rusefi/rusefi-hardware/GDI-6ch/readme.md

⚠️ 🚨While firmware folder exists for this GDI6 board, it's unclear if anyone has ever tested it in in any way, shape, or form⚠️ 🚨

https://rusefi.com/forum/viewtopic.php?f=4&t=1337
