rusefi/rusefi-hardware/digital-inputs/readme.md

Report results are posted into USB Serial, also green/red LED once test cycle is complete.

[⏩ Interactive Pinout ⏪](https://rusefi.com/docs/pinouts/stim/)

See https://github.com/rusefi/stim for hardware

Uses STM32 Nucleo-F429ZI https://os.mbed.com/platforms/ST-Nucleo-F429ZI/

Note to apply JP3 into Vin position see https://github.com/rusefi/stim/issues/12



[CD4067BM96 16:1 single-ended, 1-channel analog multiplexer](http://www.ti.com/lit/ds/symlink/cd4097b.pdf)
