rusefi/rusefi-hardware/BMW-N54-146/readme.md

# N54

E9x 2006 to 2010 with "35" engine would be N54

For some years they had both N54 and N55 depending on trim. 335is would be N54, N55 would be newer engine with 204 pin ECU

https://rusefi.com/docs/pinouts/BMW-N54-146/

https://github.com/rusefi/rusefi_documentation/blob/master/OEM-Docs/Bmw/2010%20BMW%20335i%20Coupe%20(E92)%20N54.pdf



# offtopic

https://github.com/rusefi/rusefi_documentation/blob/master/OEM-Docs/Bmw/2009%20BMW%20328i%20Sedan%20(E90)%203.0%20N51.pdf

https://github.com/rusefi/rusefi_documentation/blob/master/OEM-Docs/Bmw/2009%20BMW%20335i%20Sedan%20(E90)%203.0%20N53.pdf
