rusefi/rusefi-hardware/GDI-STM/readme.md

GDI based on stm32g4

🔴 zero firmware exists for this hardware 🔴

https://github.com/rusefi/rusefi-hardware/issues/306

https://github.com/rusefi/rusefi-hardware/issues/307

https://rusefi.com/forum/viewtopic.php?f=4&t=1337
