rusefi/rusefi-hardware/ZF8HP Transmission/README.MD

# ZF 8HP Installation Board

This repository contains KiCad design files, schematics, and Gerbers for a **ZF8HP installation board**, a drop-in replacement that **solders into the transmission in place of the stock TCU (Transmission Control Unit)**.

### ✅ Supported ZF 8HP Models:
- **8HP45**
- **8HP50**
- **8HP51**
- **8HP70**
- **8HP75**
- **8HP90**
- **8HP95**

These models share similar architecture and connector layouts for the internal mechatronics, making the board compatible across multiple 8HP generations.

---

### 🚗 OEM Manufacturers Using ZF 8HP Transmissions
The ZF 8-speed automatic transmission (8HP series) is widely used across the automotive industry. Below is a list of OEMs and vehicles that utilize ZF 8HP variants:

#### **BMW**
- 1 Series, 2 Series, 3 Series, 4 Series, 5 Series, 6 Series, 7 Series
- X1, X3, X4, X5, X6, X7
- M Performance models (e.g., M340i, X5 M50i)

#### **Audi / Volkswagen Group**
- Audi A4, A5, A6, A7, A8, Q5, Q7, Q8, SQ5, S6, S8
- VW Touareg
- Porsche Cayenne, Macan, Panamera (certain trims)

#### **Chrysler / Dodge / Jeep / RAM**
- Chrysler 300
- Dodge Charger, Challenger, Durango
- Jeep Grand Cherokee, Wagoneer
- RAM 1500, 2500 (with HEMI or EcoDiesel)

#### **Alfa Romeo**
- Giulia
- Stelvio

#### **Maserati**
- Ghibli
- Quattroporte
- Levante

#### **Jaguar / Land Rover**
- Jaguar XE, XF, XJ, F-Type, F-Pace
- Range Rover, Range Rover Sport, Discovery, Defender

#### **Rolls-Royce**
- Ghost, Wraith, Cullinan

#### **Aston Martin**
- DB11, Vantage (post-2018 models)

---

### 🧐 Notes
- While all 8HPs share ZF architecture, not all use identical internal TCU layouts or mounting methods. Minor variations may exist in the mechatronic design.
- This board was developed with modularity in mind and can be adapted for different generations as needed.
- Contributions are welcome to expand compatibility and improve hardware design.
