rusefi/rusefi-hardware/mini48-stm32/readme.md

Brain board stm lqfp48 pin

* TC2030
* CANbus

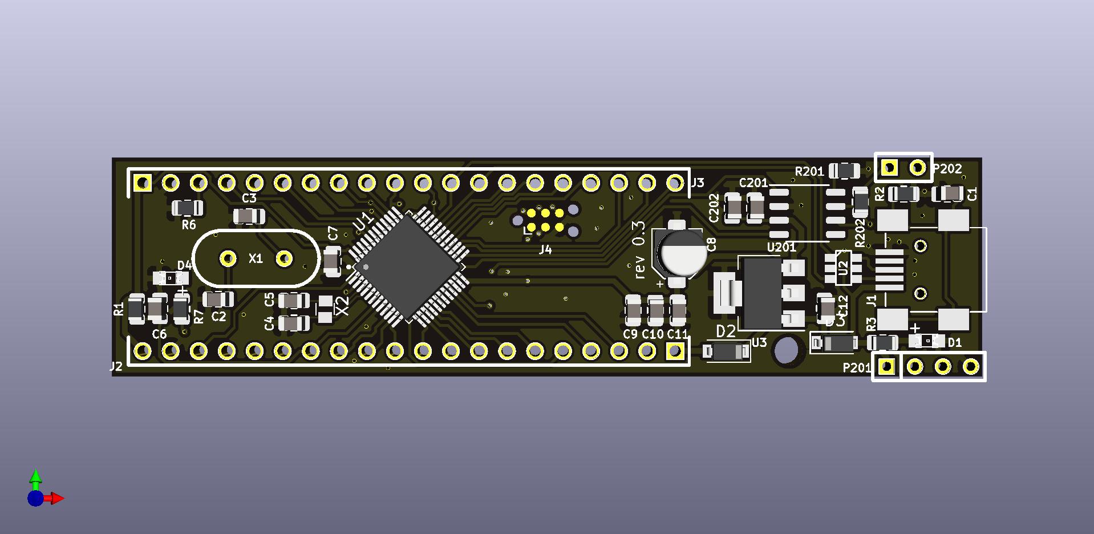
[picture p1: mini48-stm32/images/mini48-stm32-0.3-top.jpg]
Board
