rusefi/rusefi-hardware/MC33810-breakout/readme.md

https://www.nxp.com/products/power-management/smart-switches-and-drivers/low-side-switches/automotive-engine-control-ic:MC33810

https://github.com/andreika-git/hellen-one/issues/173
