rusefi/rusefi-hardware/VR-Hall/readme.md

VR/Hall mixing test board

Problem statement: do do not have x8 or x10 position sensor inputs on stm32, in order to handle any combination of x5 hall and x3/x5 VRs we would need to mix each VR with Hall

We are looking to confirm that VR signal (in this case from MAX9924) could be mixed with Hall signal into same/shared digital signal
