rusefi/rusefi-hardware/superseal-igbt/readme.md

x4 coil driver

For instance ISL9V3040S3S

See also https://github.com/rusefi/rusefi/tree/master/hardware/DDPAK_breakout

https://www.youtube.com/watch?v=TUJzp6ig_bQ
