rusefi/rusefi-hardware/classic-designs/frankenso-PWR-Supply/readme.md

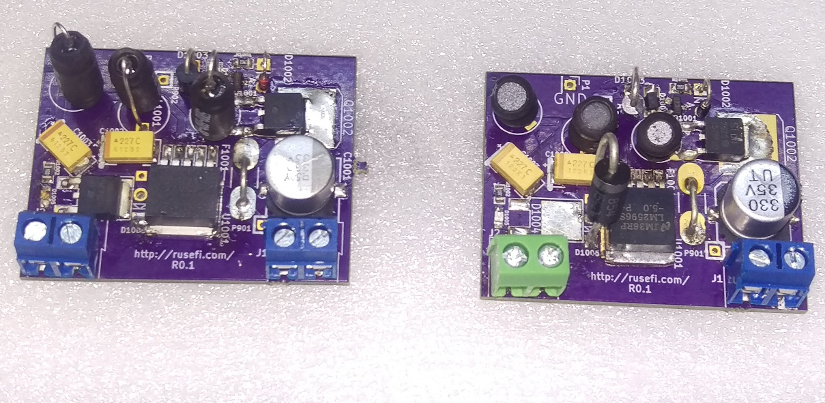
[picture p2: classic-designs/frankenso-PWR-Supply/board.jpg]
Board


https://rusefi.com/forum/viewtopic.php?f=4&t=394
