rusefi/rusefi-hardware/classic-designs/frankenso/readme.md

Our best ECU board

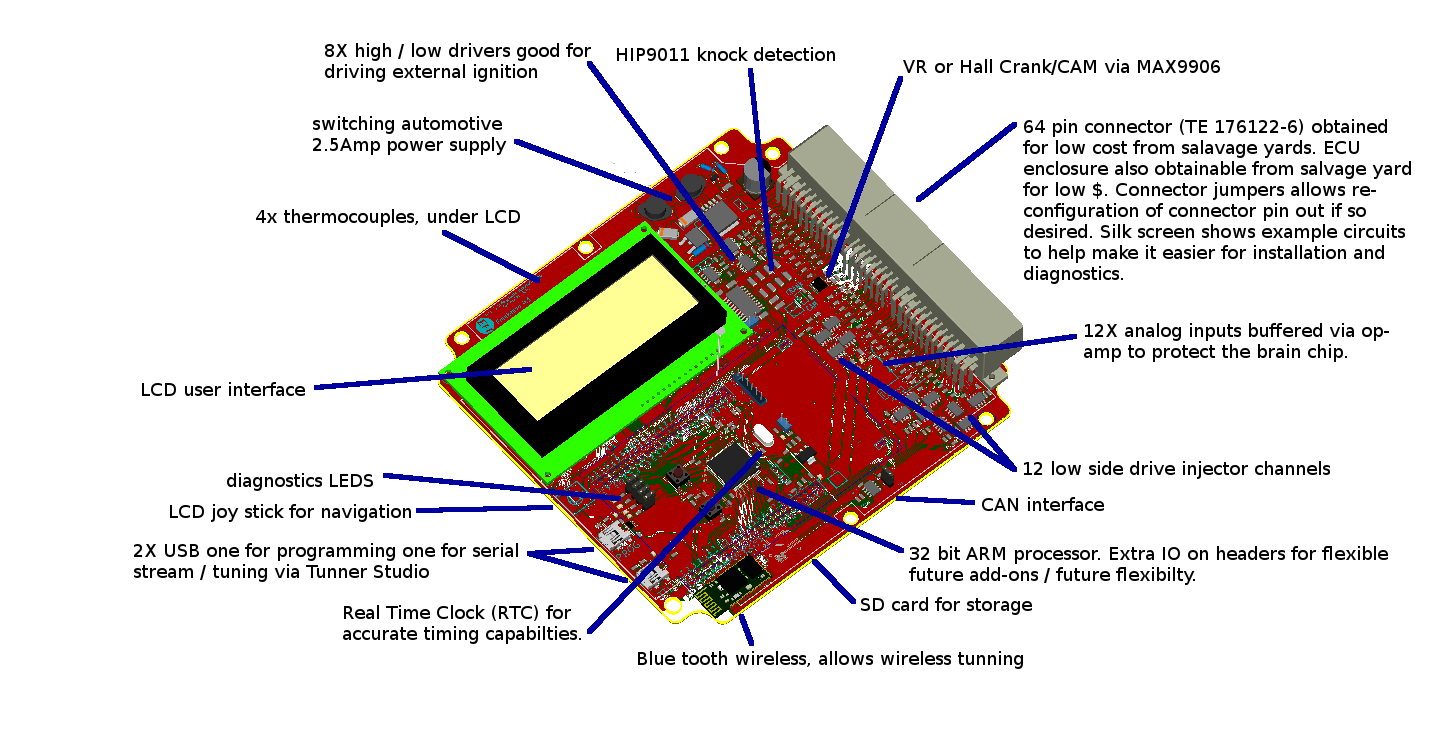
[picture p3: classic-designs/frankenso/frankenso_top-isometric_notes.png]
Isometric Notes


[Wiki manual page](https://rusefi.com/wiki/index.php?title=Manual:Hardware_Frankenso_board)

[Forum thread](https://rusefi.com/forum/viewtopic.php?f=4&t=569)

### For Release Notes see [known_issues.txt](known_issues.txt)

See also comparison [Board Comparison](https://rusefi.com/wiki/index.php?title=Hardware:For_Sale)

iBoms are very cool see https://rusefi.com/docs/ibom/frankenso_latest.html
