rusefi/rusefi-hardware/classic-designs/frankenstein/readme.md

This is the older rusEfi board which is not really being developed any more.

See [Frankenso](../frankenso) for the next generation of official rusEfi hardware

See also comparison [Board Comparison](https://rusefi.com/wiki/index.php?title=Hardware:For_Sale)

iBoms are very cool see https://rusefi.com/docs/ibom/frankenstein_latest.html
