rusefi/rusefi-hardware/classic-designs/power_supply_kb1gtt/readme.md

Older version of the power supply with SMD inductors

For current version with three inductors see [frankenso-PWR-Supply](../frankenso-PWR-Supply)

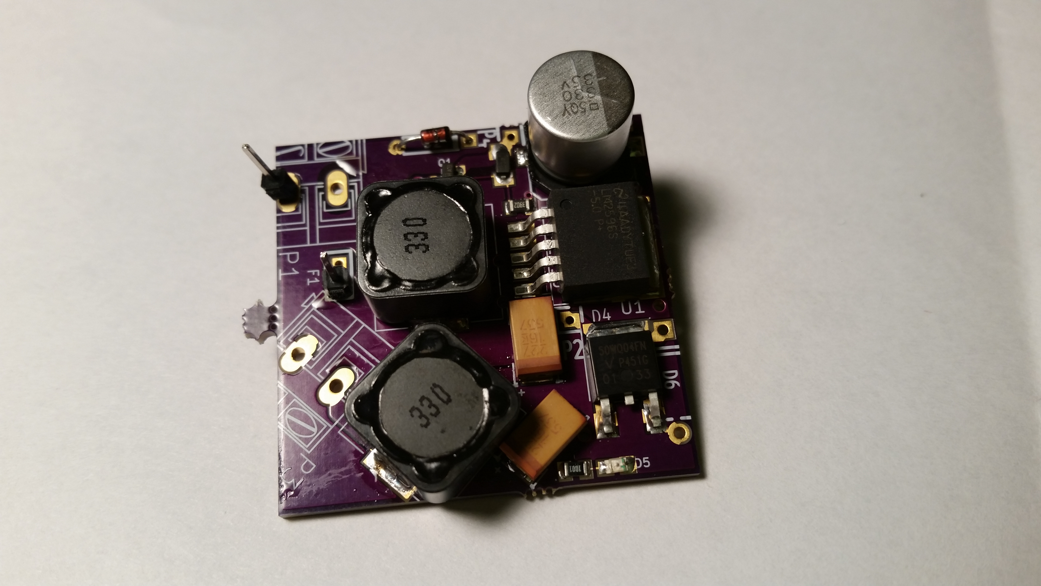
[picture p4: classic-designs/power_supply_kb1gtt/power_supply_0_4_front.jpg]
Front

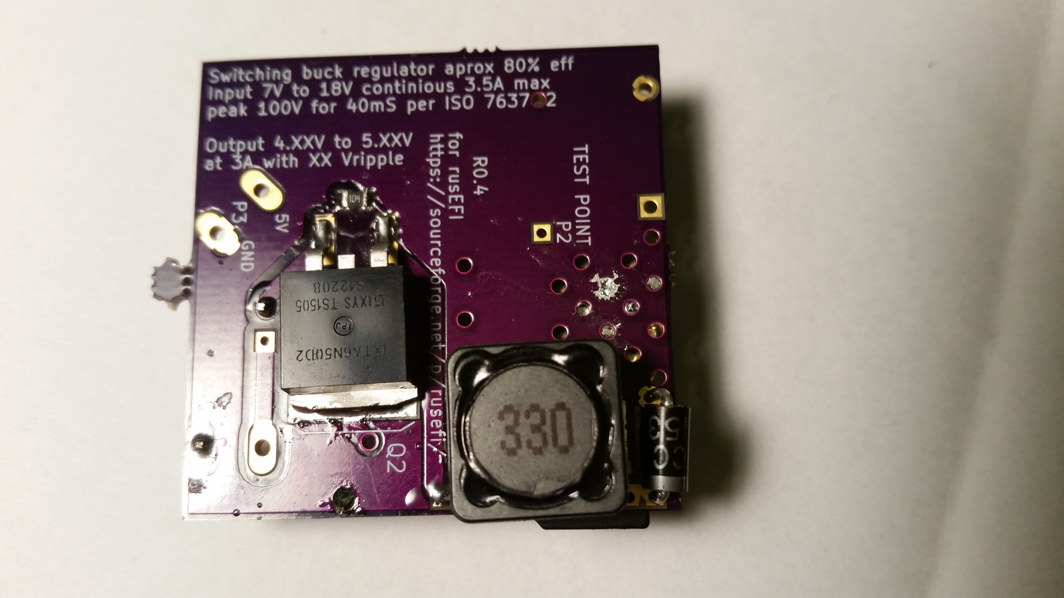
[picture p5: classic-designs/power_supply_kb1gtt/power_supply_0_4_back.jpg]
Back


https://rusefi.com/forum/viewtopic.php?f=4&t=394
