rusefi/rusefi-hardware/GDI-4ch/firmware/readme.md

baud rate 115200

# Changelog

See EFI_BOARD_E92 for alternative LED pinout

2024: GDI air bots are pretty happy!

2022-04-08: we have nothing so far. Nada.
