rusefi/rusefi-hardware/breakout-boards/Breakout_154pin_284617-1-Connector/readme.md

154 pin Audi Volkswagen ECU connector

# [Connector for sale here](https://www.tindie.com/products/russian/154-pin-ecu-connector/)

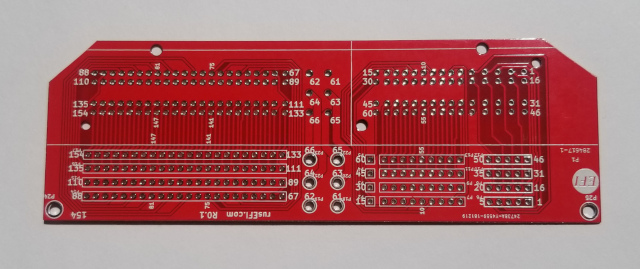
[picture p6: breakout-boards/Breakout_154pin_284617-1-Connector/154p_board.jpg]
x


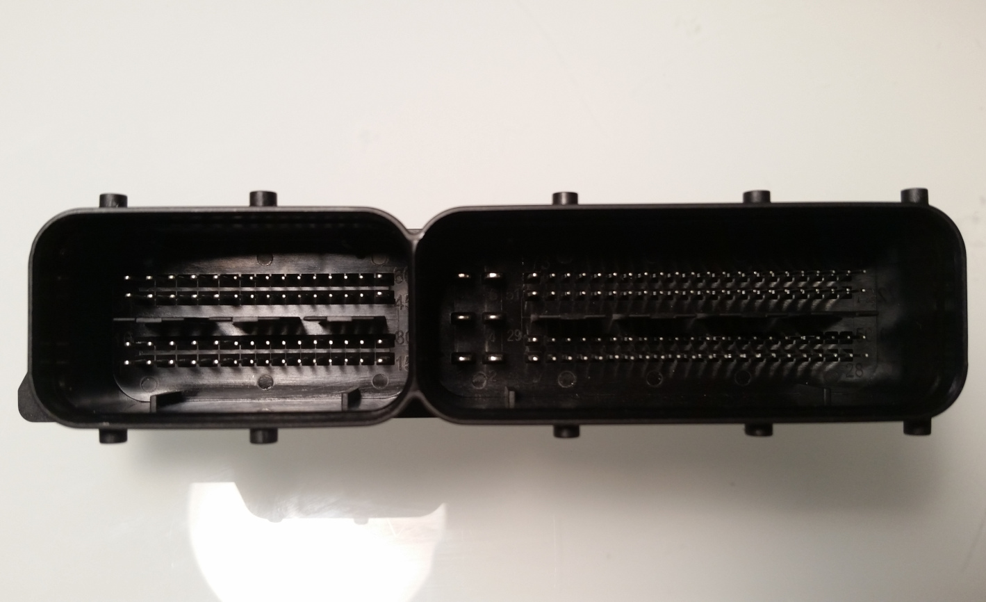
[picture p7: breakout-boards/Breakout_154pin_284617-1-Connector/154p_front.jpg]
Connector


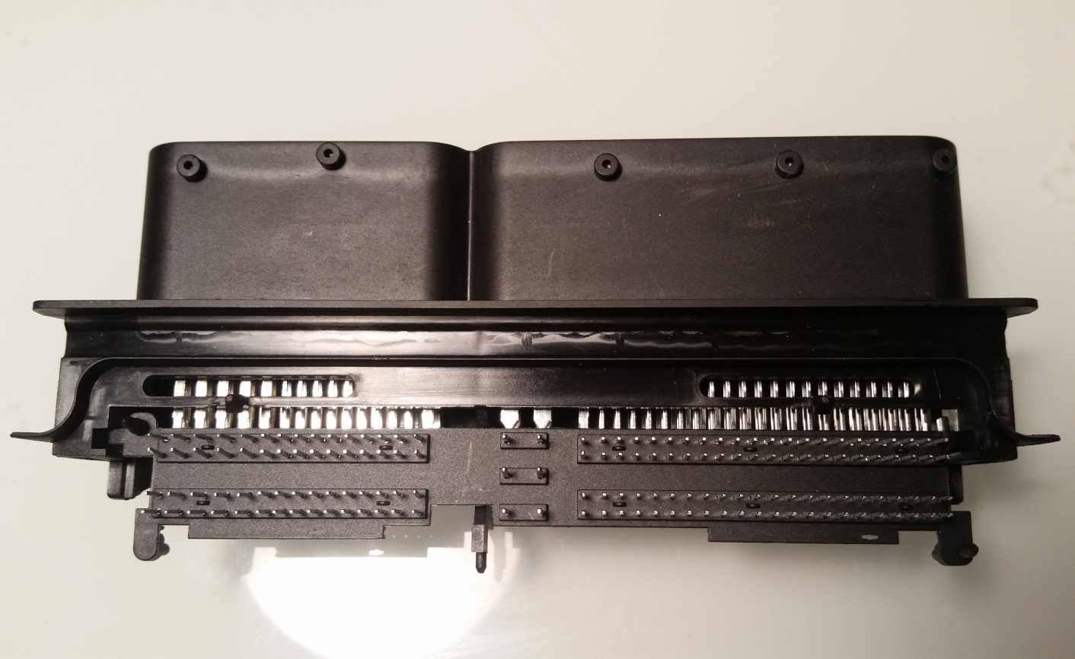
[picture p8: breakout-boards/Breakout_154pin_284617-1-Connector/154p_bottom.jpg]
Connector


https://rusefi.com/forum/viewtopic.php?f=4&t=582
