rusefi/rusefi-hardware/lambda-x2/export/rev1/readme.md

4 layers
82 x 95 mm

x
