rusefi/rusefi-hardware/BMW-N54-146/proteus-N54-notes.md

TPS 2 → analog volt 2

MAC lowside → injector 12

Start button → digital 4

Exhaust vanos → injector 8

Intake vanos → injector 7

TPS 1 → analog volt 3

PPS 1 → analog volt 9

PPS 2 → analog volt 7

MAP → analog volt 1

IAT → analog temp 2

Exhaust cam → digital 3

Intake cam → digital 2

Crank → digital 1

Fuel pressure (pin 15) → analog volt 5

O2 → analog volt 6

Coolant temperature → analog thermistor 3

Starter signal → injector 10

Fan → injector 11 / fan

Alternator → ign 7

Main relay → injector 9

VSS input over CAN (with E46 ABS or E9X ABS MK60E5)

Kawasaki Ninja ZX10R gyro MM5.10 → CAN

Antilag button → analog volt 10

Brake input GND → digital 5

Launch control button → analog volt 11

Oil pressure → analog volt 8 (5 V)

FLEX → currently analog volt 4, needs to go to digital 6

Ambient air temp → analog temp 4

Remove current knock sensor and wire both stock BMW ones to knock 1 and knock 2

Oil temp sensor → analog temp 1
