rusefi/rusefi-hardware/honda-obd1/connectors/honda-obd1-64pin-176122-6-backup.txt

info:
  title: Honda OBD1
  directory: uaefi/honda-obd1
  image:
    file: 64pin-176122-6.jpg
  pins:
    - pin: D21
      x: 3984
      y: 312
    - pin: D22
      x: 3984
      y: 512

    - pin: D19
      x: 3860
      y: 312
    - pin: D20
      x: 3860
      y: 512

    - pin: D17
      x: 3735
      y: 352
    - pin: D18
      x: 3735
      y: 544

    - pin: D15
      x: 3624
      y: 352
    - pin: D16
      x: 3624
      y: 544

    - pin: D13
      x: 3508
      y: 352
    - pin: D14
      x: 3508
      y: 544

    - pin: D11
      x: 3401
      y: 352
    - pin: D12
      x: 3401
      y: 544

    - pin: D9
      x: 3284
      y: 352
    - pin: D10
      x: 3284
      y: 544

    - pin: D7
      x: 3179
      y: 352
    - pin: D8
      x: 3179
      y: 544

    - pin: D5
      x: 3062
      y: 352
    - pin: D6
      x: 3062
      y: 544

    - pin: D3
      x: 2952
      y: 352
    - pin: D4
      x: 2952
      y: 544

    - pin: D1
      x: 2838
      y: 312
    - pin: D2
      x: 2838
      y: 512

    - pin: B15
      x: 2616
      y: 352

    - pin: B16
      x: 2616
      y: 544

    - pin: B13
      x: 2506
      y: 352

    - pin: B14
      x: 2506
      y: 544

    - pin: B11
      x: 2396
      y: 352

    - pin: B12
      x: 2396
      y: 544

    - pin: B9
      x: 2286
      y: 352

    - pin: B10
      x: 2286
      y: 544

    - pin: B7
      x: 2176
      y: 352

    - pin: B8
      x: 2176
      y: 544

    - pin: B5
      x: 2066
      y: 352

    - pin: B6
      x: 2066
      y: 544

    - pin: B3
      x: 1956
      y: 352

    - pin: B4
      x: 1956
      y: 544

    - pin: B1
      x: 1846
      y: 352

    - pin: B2
      x: 1846
      y: 544

    - pin: A25
      x: 1604
      y: 312
    - pin: A26
      x: 1604
      y: 512

    - pin: A23
      x: 1488
      y: 312
    - pin: A24
      x: 1488
      y: 512

    - pin: A21
      x: 1368
      y: 360
    - pin: A22
      x: 1368
      y: 552

    - pin: A19
      x: 1256
      y: 360
    - pin: A20
      x: 1256
      y: 552

    - pin: A17
      x: 1140
      y: 360
    - pin: A18
      x: 1140
      y: 552

    - pin: A15
      x: 1028
      y: 360
    - pin: A16
      x: 1028
      y: 552

    - pin: A13
      x: 915
      y: 360
    - pin: A14
      x: 915
      y: 552

    - pin: A11
      x: 807
      y: 360
    - pin: A12
      x: 807
      y: 552

    - pin: A9
      x: 690
      y: 360
    - pin: A10
      x: 690
      y: 552

    - pin: A7
      x: 580
      y: 360
    - pin: A8
      x: 580
      y: 552

    - pin: A5
      x: 460
      y: 312
    - pin: A6
      x: 460
      y: 512

    - pin: A3
      x: 330
      y: 312
    - pin: A4
      x: 330
      y: 512

    - pin: A1
      x: 200
      y: 312
    - pin: A2
      x: 200
      y: 512
