rusefi/rusefi-hardware/classic-designs/5V-regulator/index.html

forum thread (http://rusefi.com/forum/viewtopic.php?f=4&t=893)
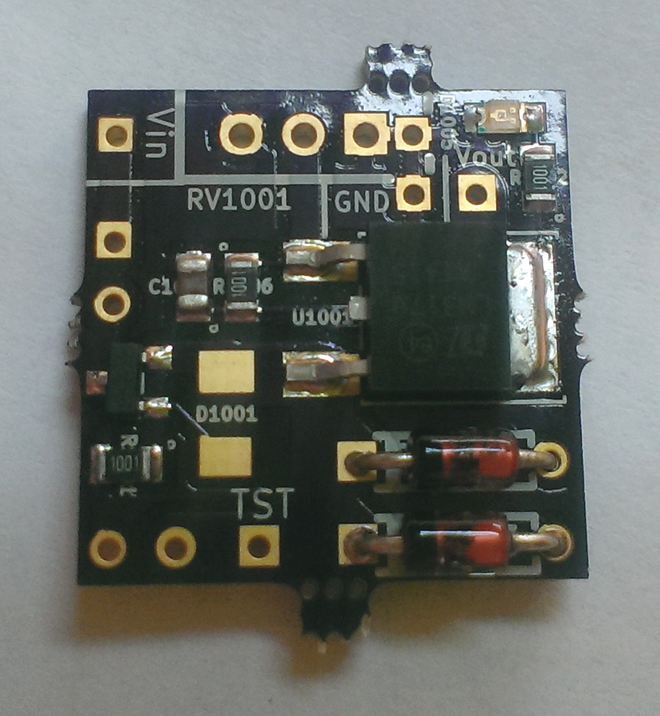
[picture p9: classic-designs/5V-regulator/5v_semi_assembled.jpg]
