rusefi/rusefi-hardware/classic-designs/5V-regulator/PWR_5V_linear_by-value.csv

0.1uF 50V | 1 | C1001 | blah | blah | blah | blah | sky-macau | 6175330450
1uF 16V | 1 | C1002 | blah | blah | blah | blah | sky-macau.com | 5761275017
7.5V | 1 | D1001 | diodesinc | BZT52C7V5-7-F | DIGI | BZT52C7V5-FDICT-ND | sky-macau.com | 5633100308
15V | 1 | D1002 | FAIRCHILD | 1N5245B | DIGI | 1N5245BFS-ND | sky-macau.com | 9197428750
24V | 2 | D1003 D1004 | fairchild | BZX79C20 | DIGI | BZX79C20-ND
LED-grn | 1 | D1005 | lite-on | LTST-C171GKT | DIGI | 160-1423-1-ND | sky-macau | 1562597916
5A | 1 | F1001 | 0R | jumperwire | 0R | jumperwire
CONN_1 | 2 | P901 P902 | dnp | dnp | dnp | dnp
CONN_1 | 2 | P1002 P1004 | DO NOT POPULATE | DNP | DO NOT POPULATE | DNP
200V | 1 | Q1002 | IXYS | IXTA6N50D2 | digikey | IXTA6N50D2-ND
30V | 1 | Q1001 | vishay | SI2323DS-T1-E3 | DIGI | SI2323DS-T1-E3CT-ND | sky-macau.com | 4824167646
240R | 1 | R1006 |  |  |  |  | sky-macau | 5622933558
1k | 2 | R1001 R1002 | Panasonic | ERA-6AEB102V | DIGI | P1.0KDACT-ND | sky-macau | 7768409796
100k | 1 | R1003 | ECG | ERA6AEB104V | DIGI | P100KDACT-ND
1k | 1 | RV1001 |  |  |  |  | sky-macau | 2633110656
LM317M | 1 | U1001 | blah | LM317M | blah | blah | sky-macau | 9372473499
