rusefi/rusefi-hardware/wideband-F103/export/rev2/readme.md

4 layers
62 x 38 mm

STM32F103C6Tx	LQFP-48
