rusefi/rusefi-hardware/A4988_stepper_motor_driver/export/Produce_DanZhi.SMT_Original_Snapshot.Top.2582135A_Y343.SMT02308111352222.png

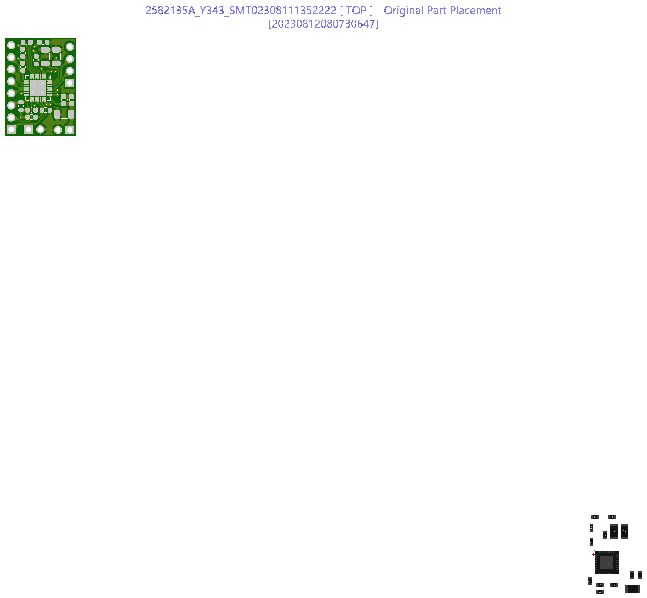
A4988_stepper_motor_driver/export/Produce_DanZhi.SMT_Original_Snapshot.Top.2582135A_Y343.SMT02308111352222.png
