rusefi/rusefi-hardware/BMW-N52-146/connectors/left.png

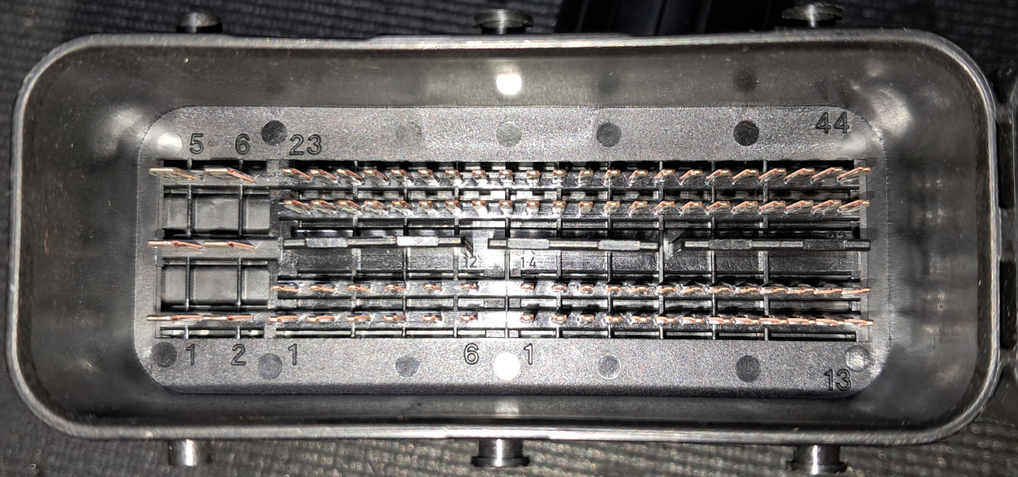
BMW-N52-146/connectors/left.png
