rusefi/rusefi-hardware/BMW-N52-146/connectors/right.png

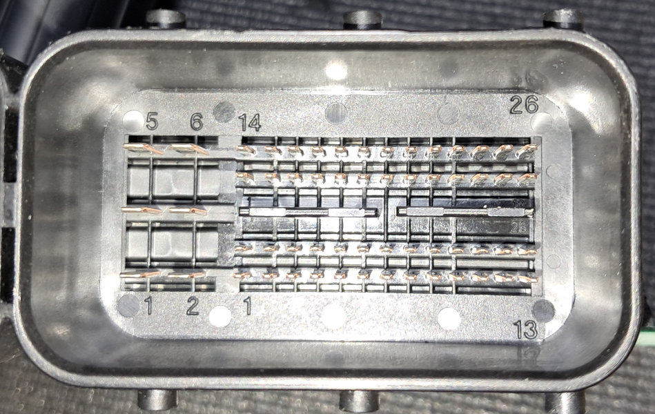
BMW-N52-146/connectors/right.png
