rusefi/rusefi-hardware/breakout-boards/Breakout-198-Mustang.jpg

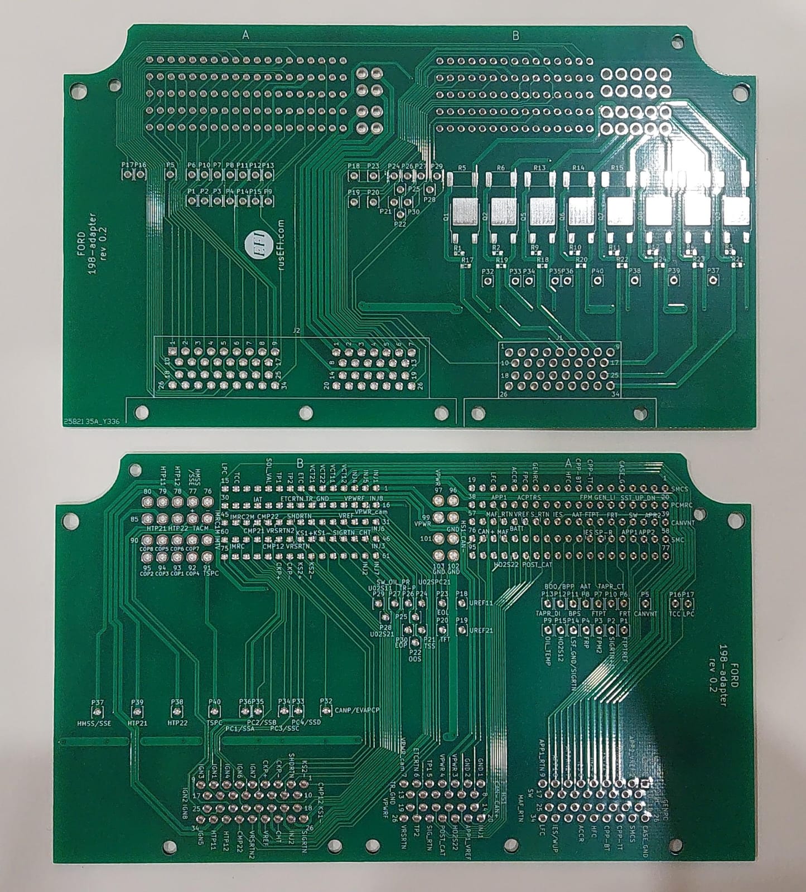
breakout-boards/Breakout-198-Mustang.jpg
