rusefi/rusefi-hardware/breakout-boards/Breakout-mazda-nc-0.1.jpg

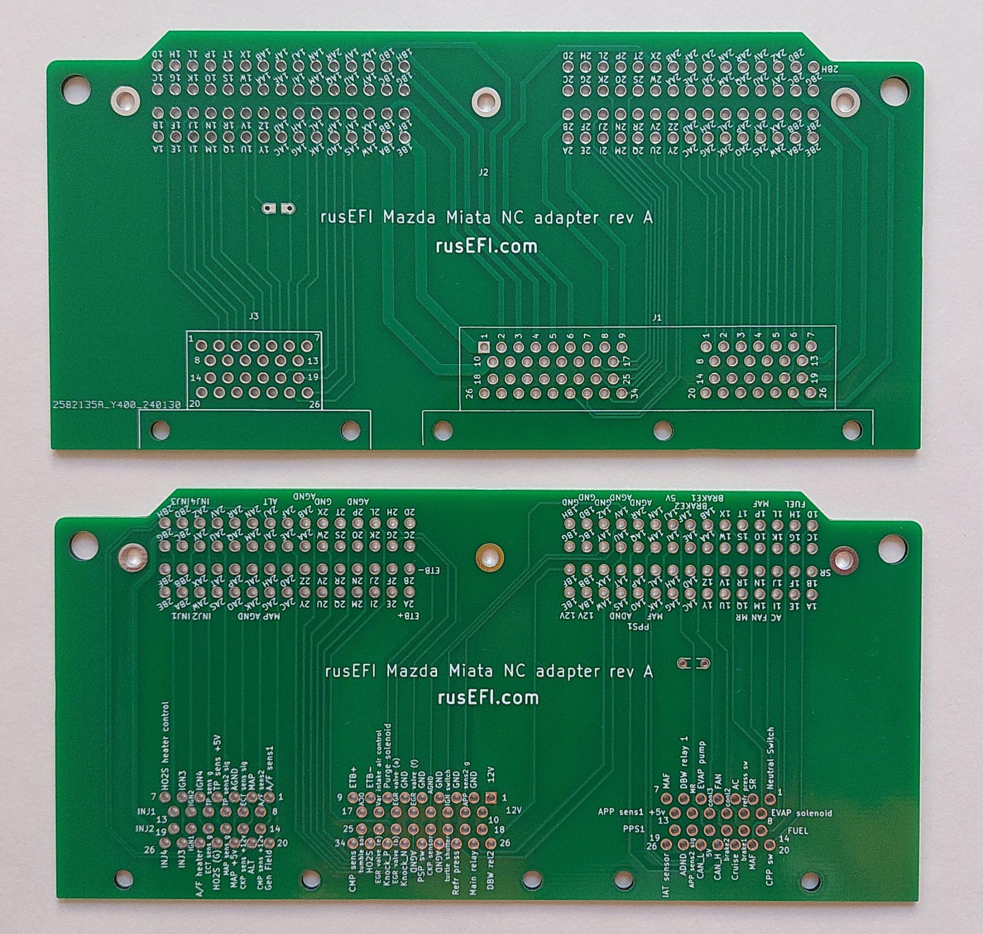
breakout-boards/Breakout-mazda-nc-0.1.jpg
