rusefi/rusefi-hardware/breakout-boards/Breakout_154_kia_pb-enclosure.jpg

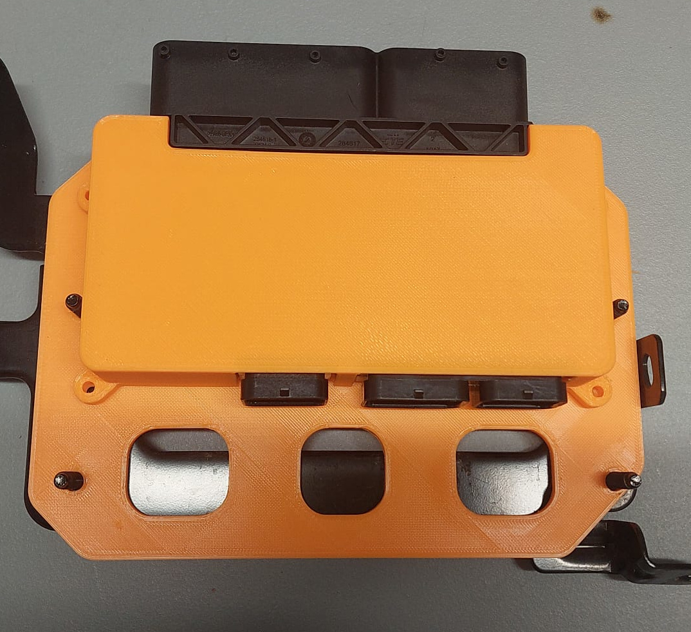
breakout-boards/Breakout_154_kia_pb-enclosure.jpg
