rusefi/rusefi-hardware/breakout-boards/Breakout_154_kia_pb/photos/bottom-2.jpg

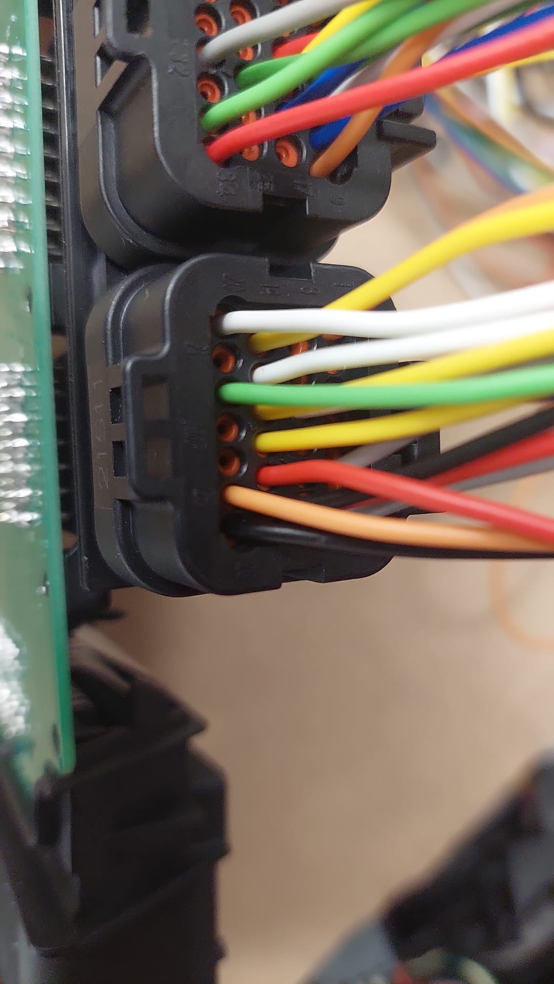
breakout-boards/Breakout_154_kia_pb/photos/bottom-2.jpg
