rusefi/rusefi-hardware/breakout-boards/Breakout_154_kia_pb/photos/bottom.jpg

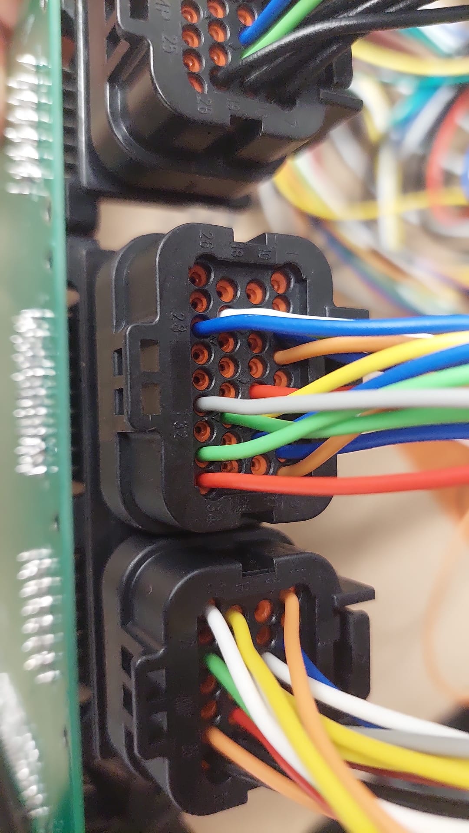
breakout-boards/Breakout_154_kia_pb/photos/bottom.jpg
