rusefi/rusefi-hardware/breakout-boards/Breakout_154_kia_pb/photos/GDI-bottom.jpg

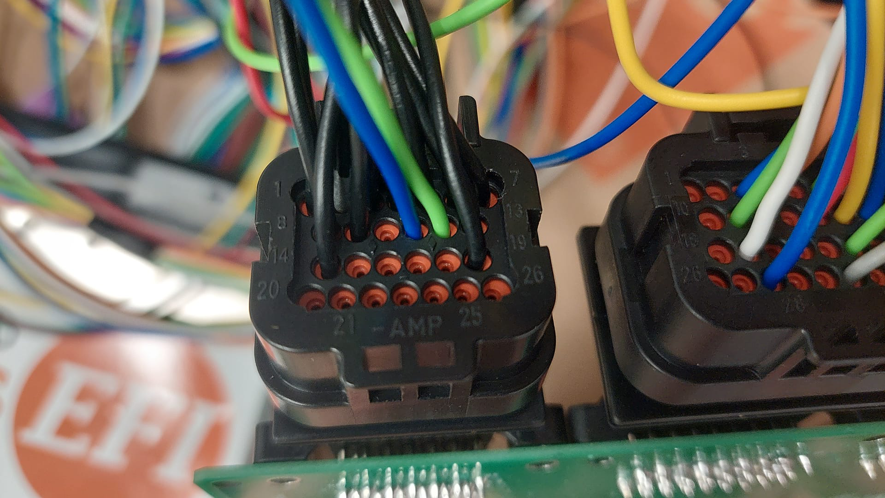
breakout-boards/Breakout_154_kia_pb/photos/GDI-bottom.jpg
