rusefi/rusefi-hardware/breakout-boards/Breakout_154_kia_pb/photos/GDI-top.jpg

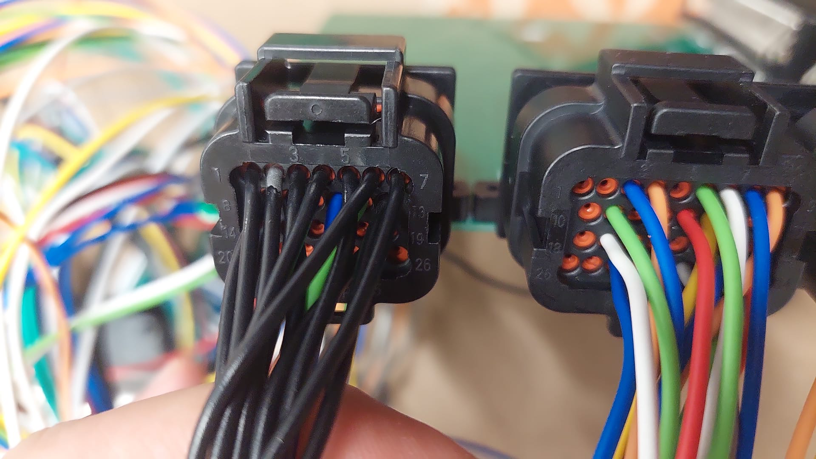
breakout-boards/Breakout_154_kia_pb/photos/GDI-top.jpg
