rusefi/rusefi-hardware/breakout-boards/Breakout_154_kia_pb/photos/top-2.jpg

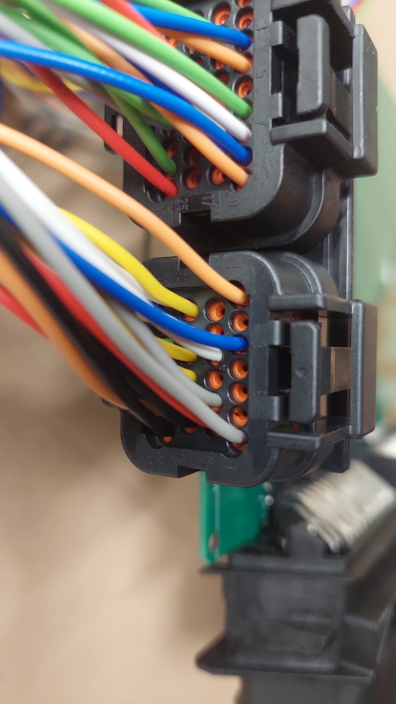
breakout-boards/Breakout_154_kia_pb/photos/top-2.jpg
