rusefi/rusefi-hardware/breakout-boards/Breakout_154_kia_pb/photos/top.jpg

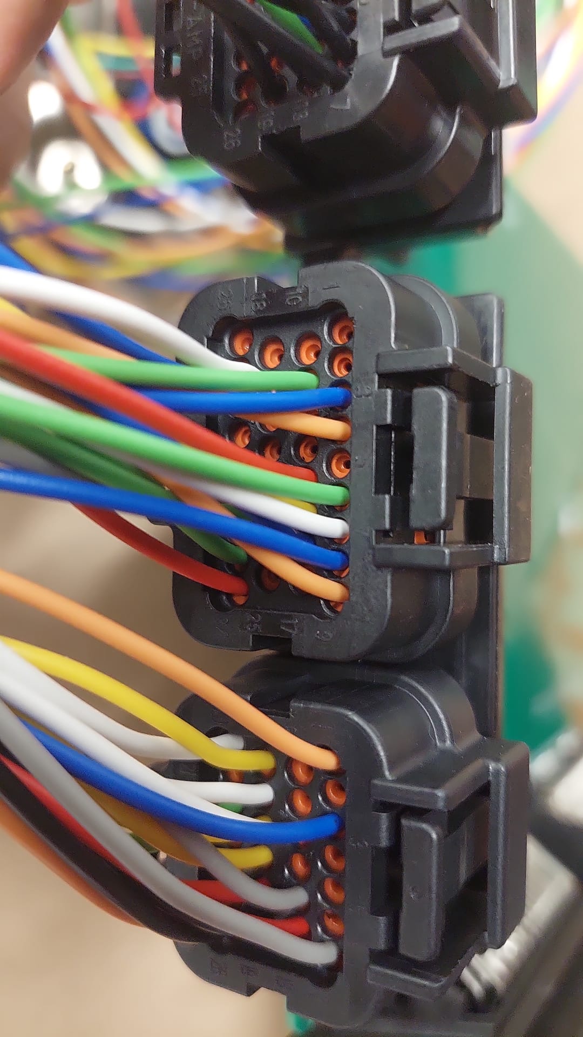
breakout-boards/Breakout_154_kia_pb/photos/top.jpg
