rusefi/rusefi-hardware/breakout-boards/Ferrari-Maserati-121-adapter-rev-a.jpg

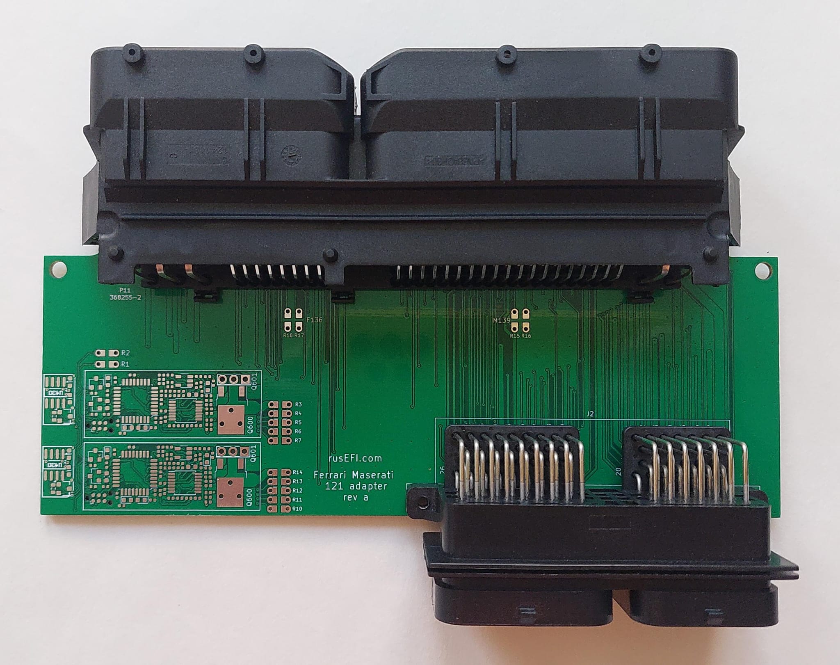
breakout-boards/Ferrari-Maserati-121-adapter-rev-a.jpg
