rusefi/rusefi-hardware/breakout-boards/mitsubishi-lancer-evo-x-rev-a.jpg

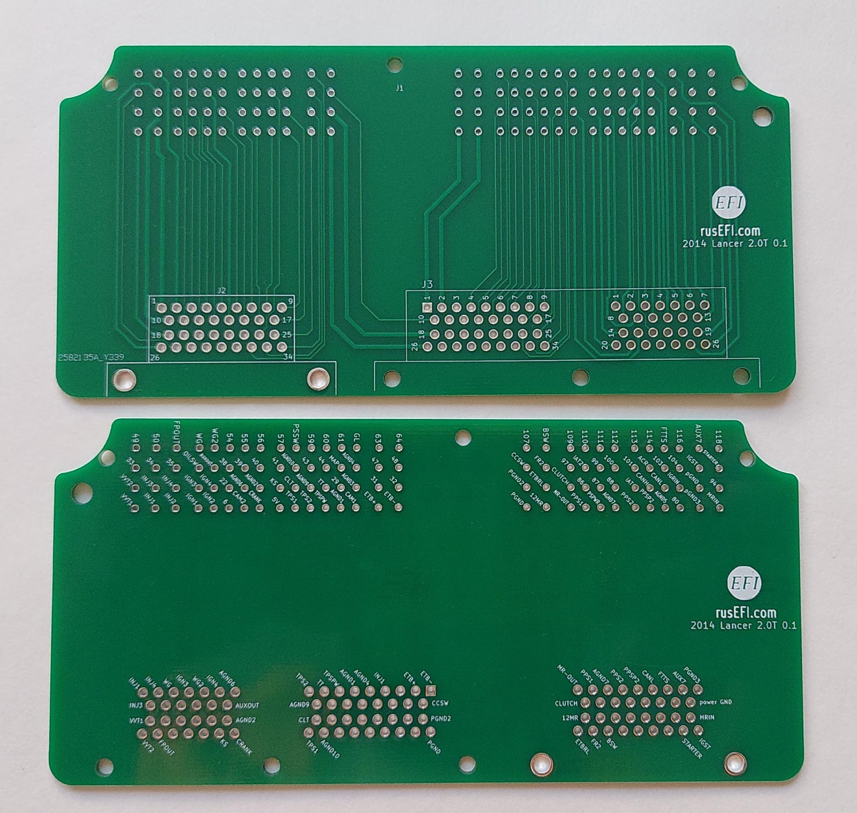
breakout-boards/mitsubishi-lancer-evo-x-rev-a.jpg
