rusefi/rusefi-hardware/breakout-boards/mitsubishi-mirage-adapter-0.3.jpg

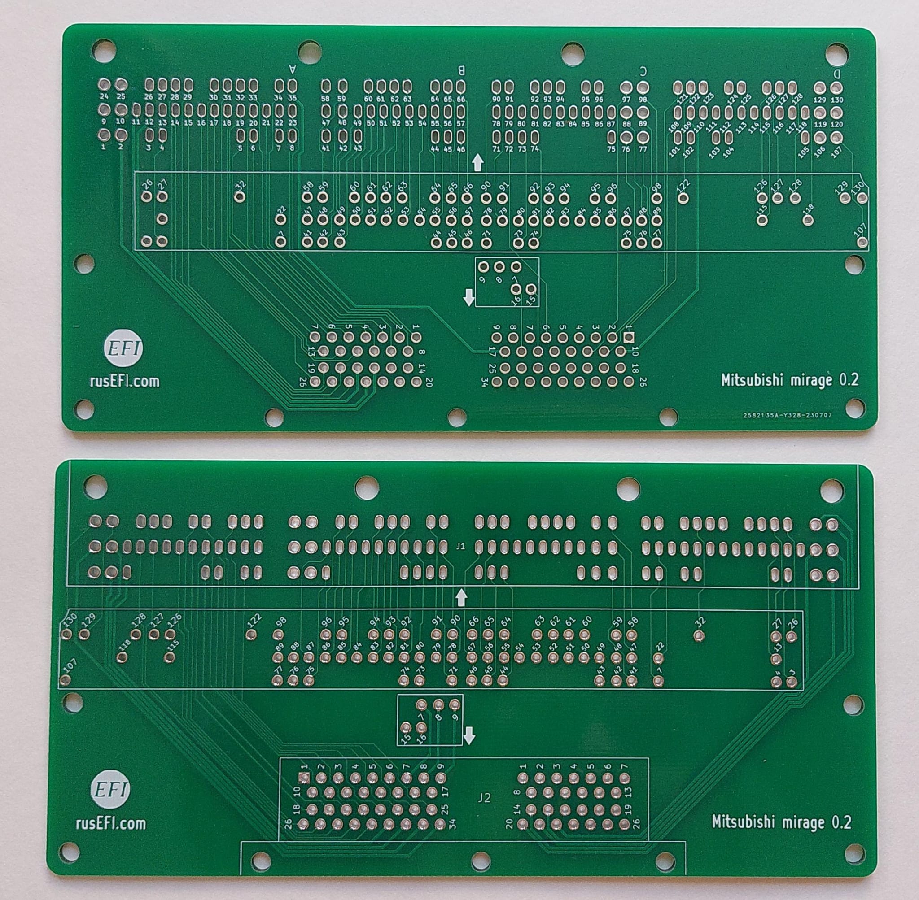
breakout-boards/mitsubishi-mirage-adapter-0.3.jpg
