rusefi/rusefi-hardware/breakout-boards/Passat-2.0-MED9.1-adapter.jpg

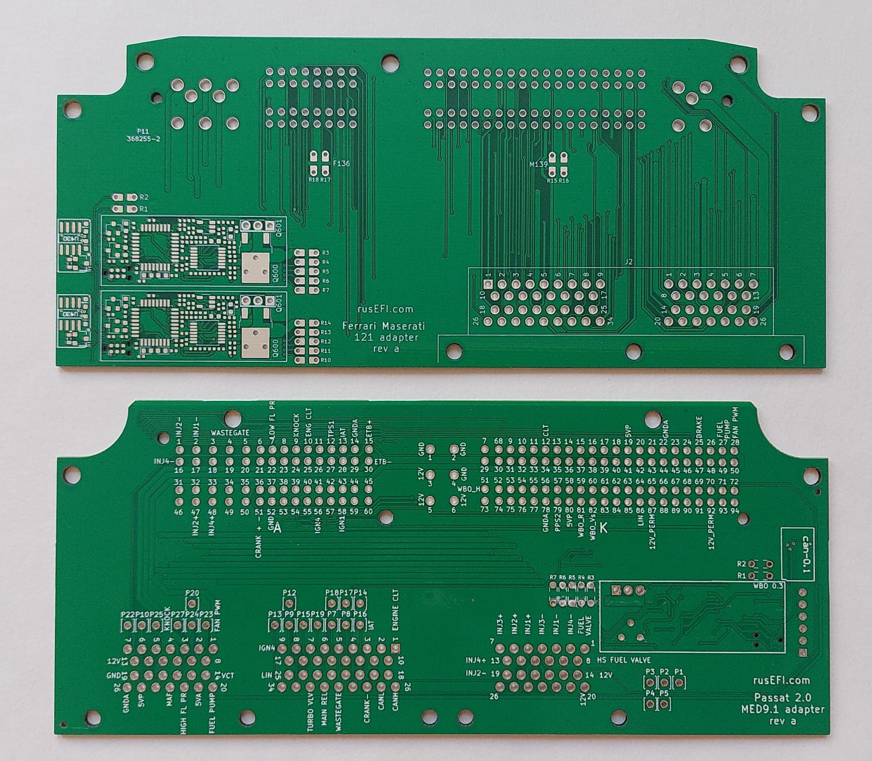
breakout-boards/Passat-2.0-MED9.1-adapter.jpg
