rusefi/rusefi-hardware/GDI-4ch/docs/enclosure-bottom.jpg

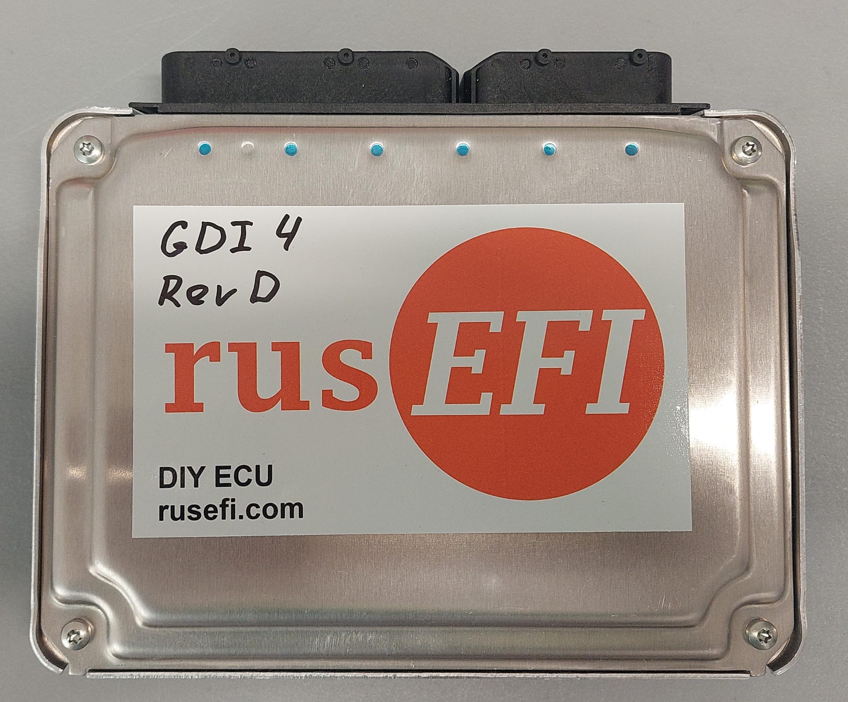
GDI-4ch/docs/enclosure-bottom.jpg
