rusefi/rusefi-hardware/GDI-4ch/docs/enclosure-top.jpg

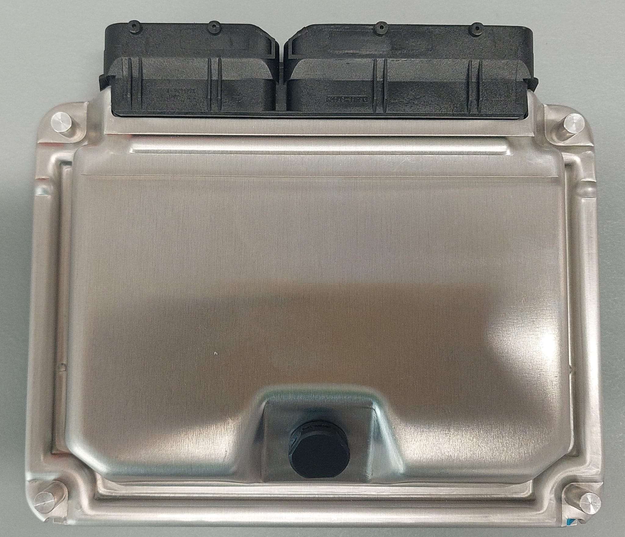
GDI-4ch/docs/enclosure-top.jpg
