rusefi/rusefi-hardware/GDI-4ch/docs/pcb-top.jpg

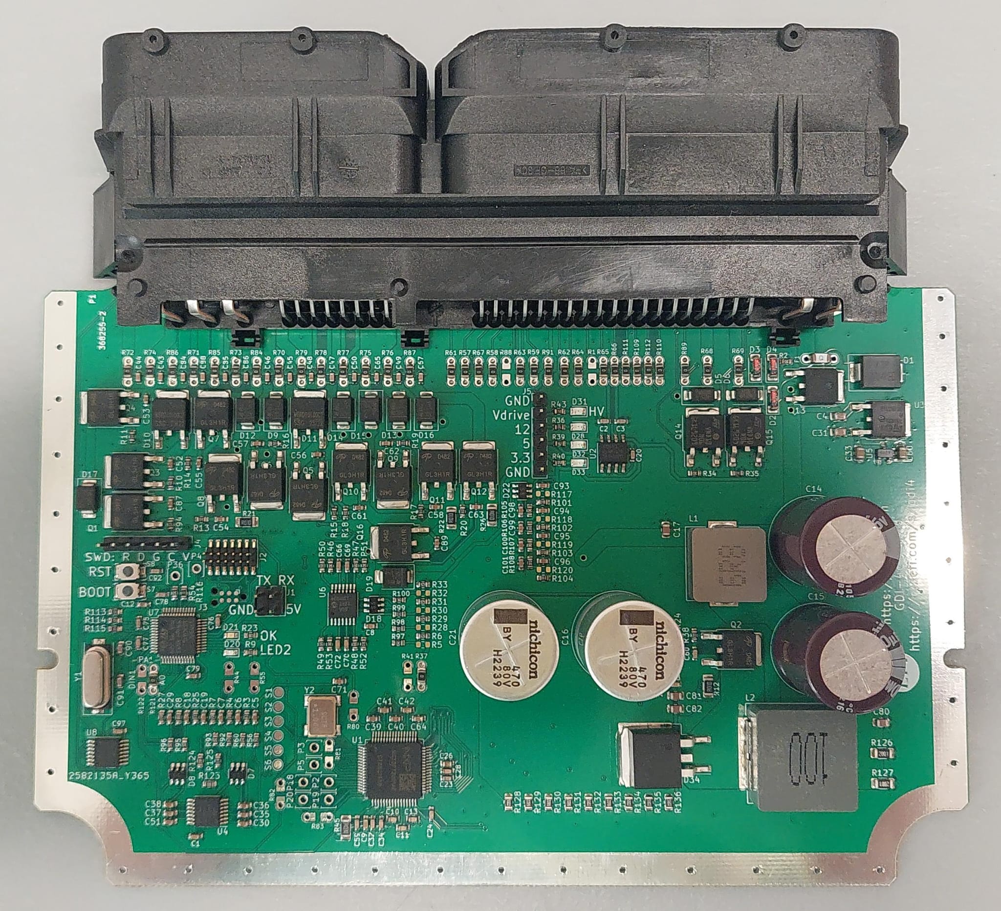
GDI-4ch/docs/pcb-top.jpg
