rusefi/rusefi-hardware/GDI-4ch/gerber/rev. a/Produce_DanZhi.SMT_Original_Snapshot.Top.2582135A_Y194.SMT0220322674845.png

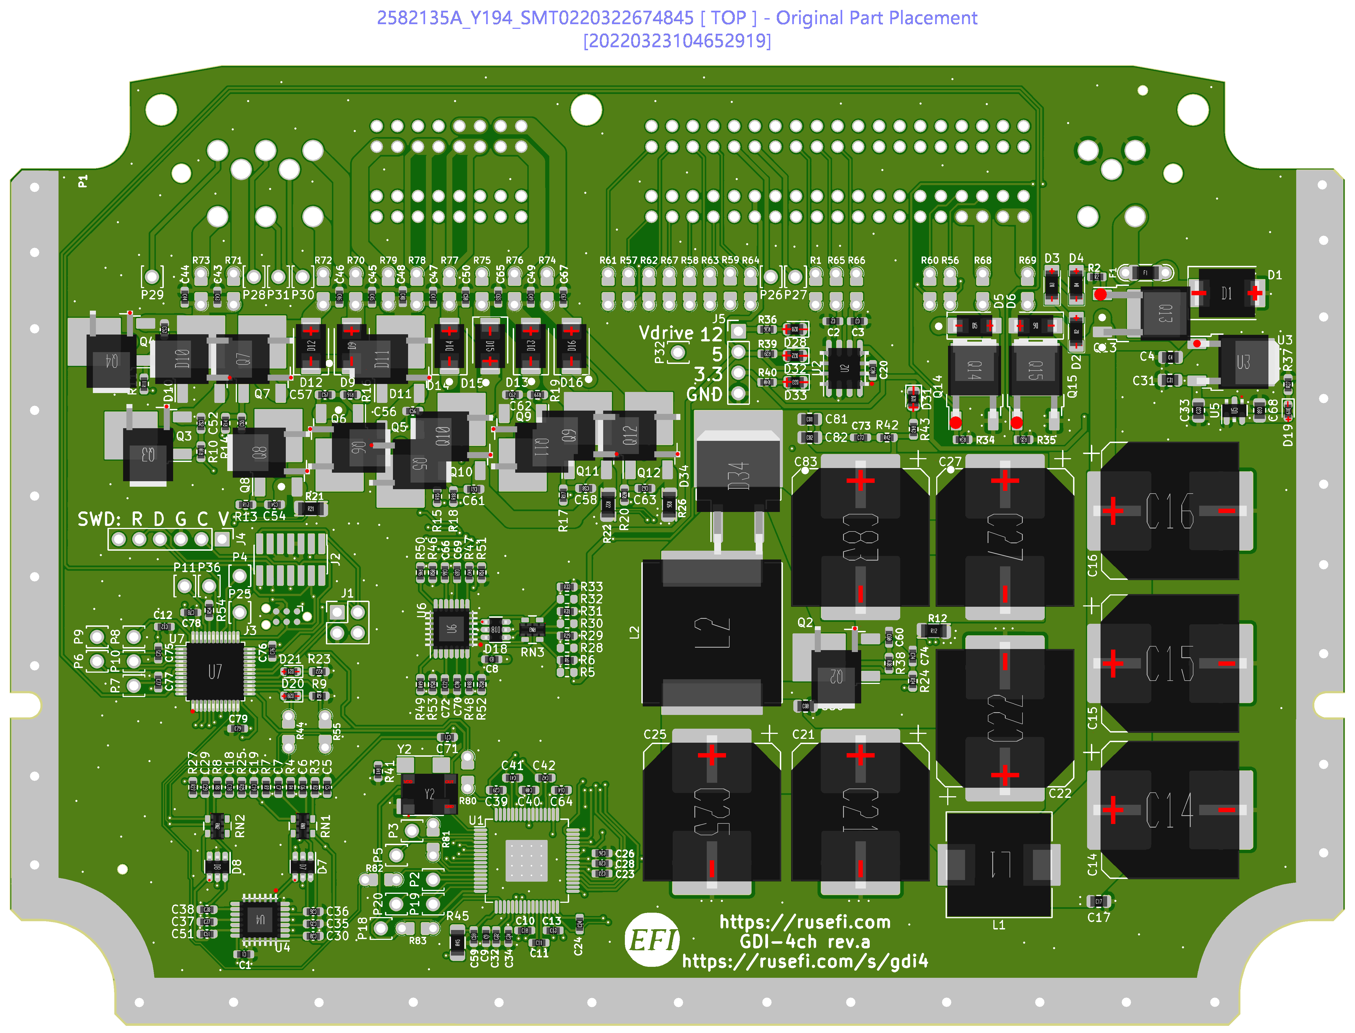
GDI-4ch/gerber/rev. a/Produce_DanZhi.SMT_Original_Snapshot.Top.2582135A_Y194.SMT0220322674845.png
