rusefi/rusefi-hardware/GDI-4ch/gerber/rev. c/Produce_DanZhi.SMT_Original_Snapshot.Top.2582135A_Y257.SMT0220722914896.png

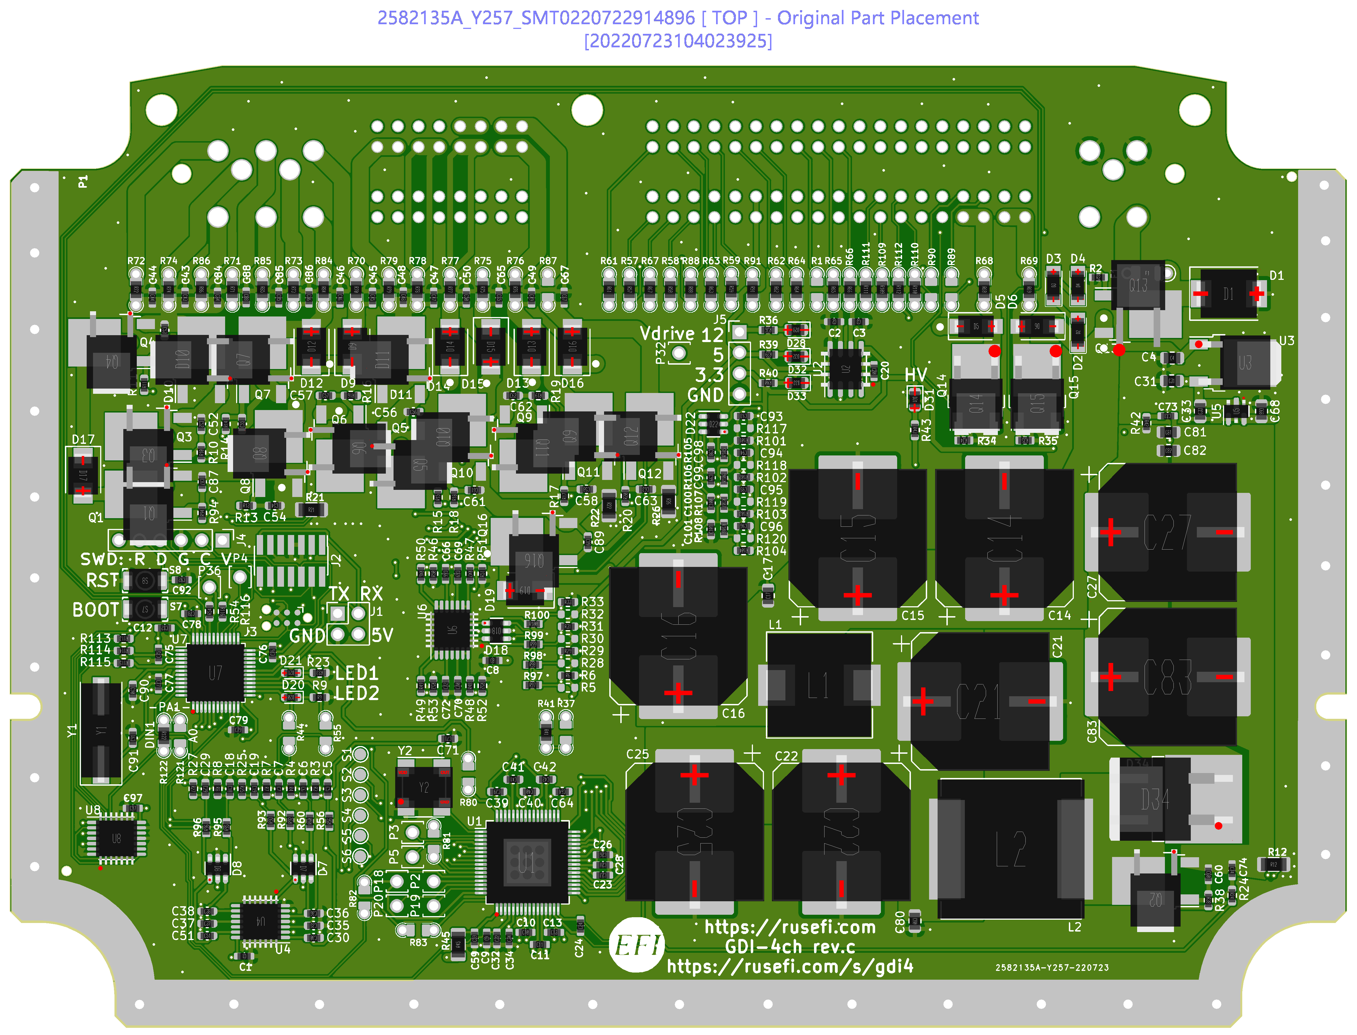
GDI-4ch/gerber/rev. c/Produce_DanZhi.SMT_Original_Snapshot.Top.2582135A_Y257.SMT0220722914896.png
