rusefi/rusefi-hardware/GDI-4ch/gerber/rev. d/Produce_DanZhi.SMT_Snapshot.Top.2582135A_Y313.SMT02305161241917.png

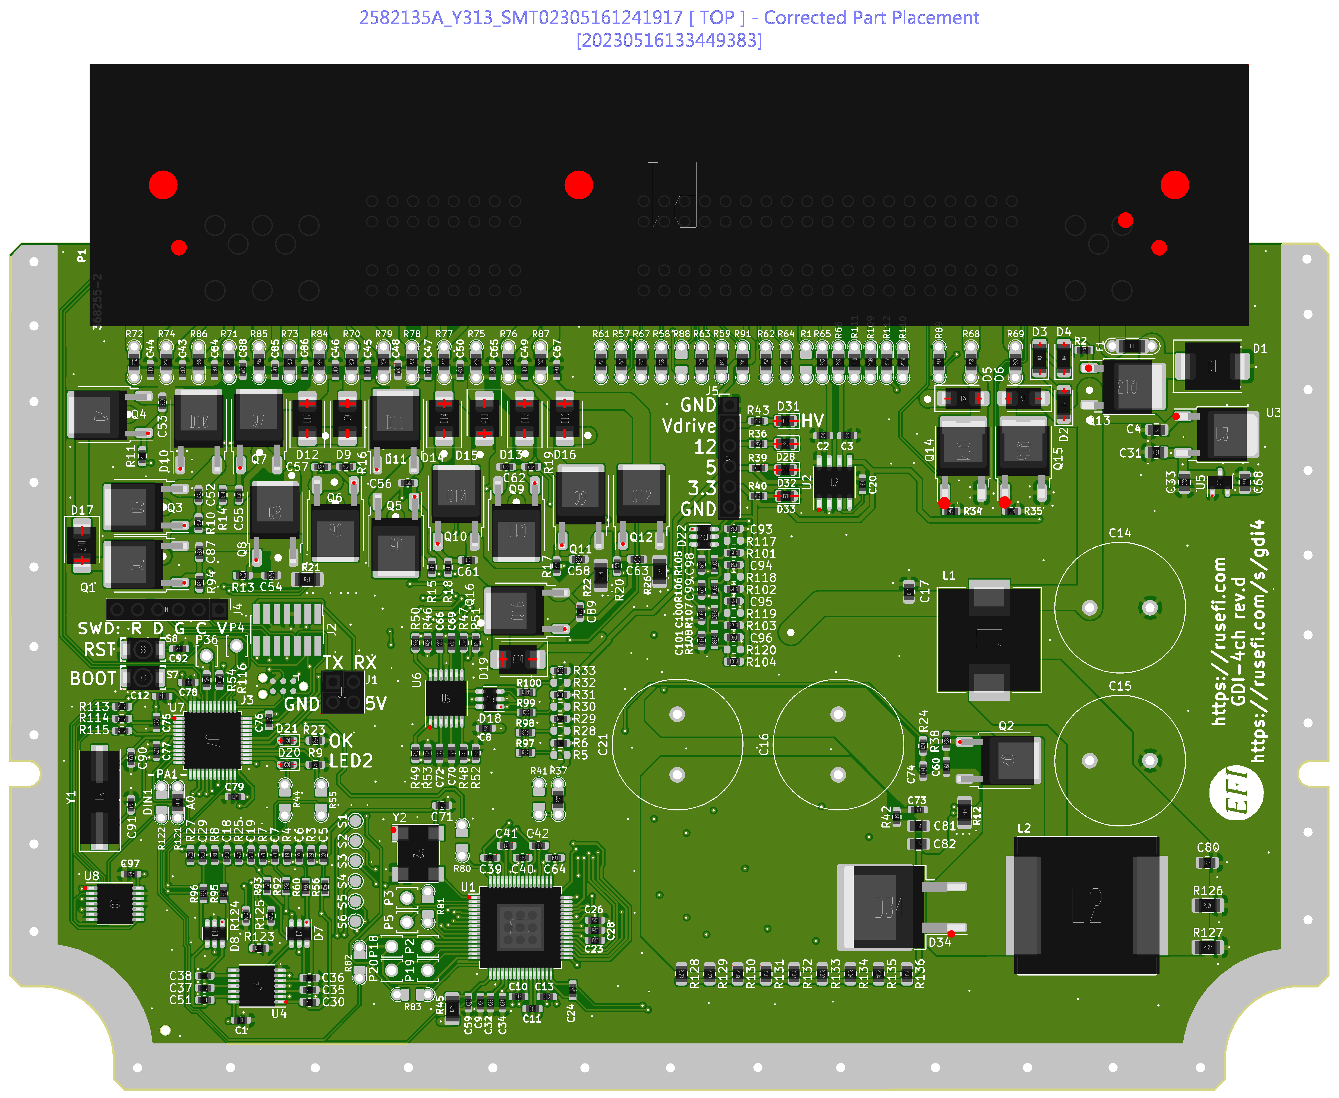
GDI-4ch/gerber/rev. d/Produce_DanZhi.SMT_Snapshot.Top.2582135A_Y313.SMT02305161241917.png
