rusefi/rusefi-hardware/GDI-4ch/gerber/rev. d/Produce_DanZhi.SMT_Snapshot.Top.2582135A_Y338.SMT02307281335026.png

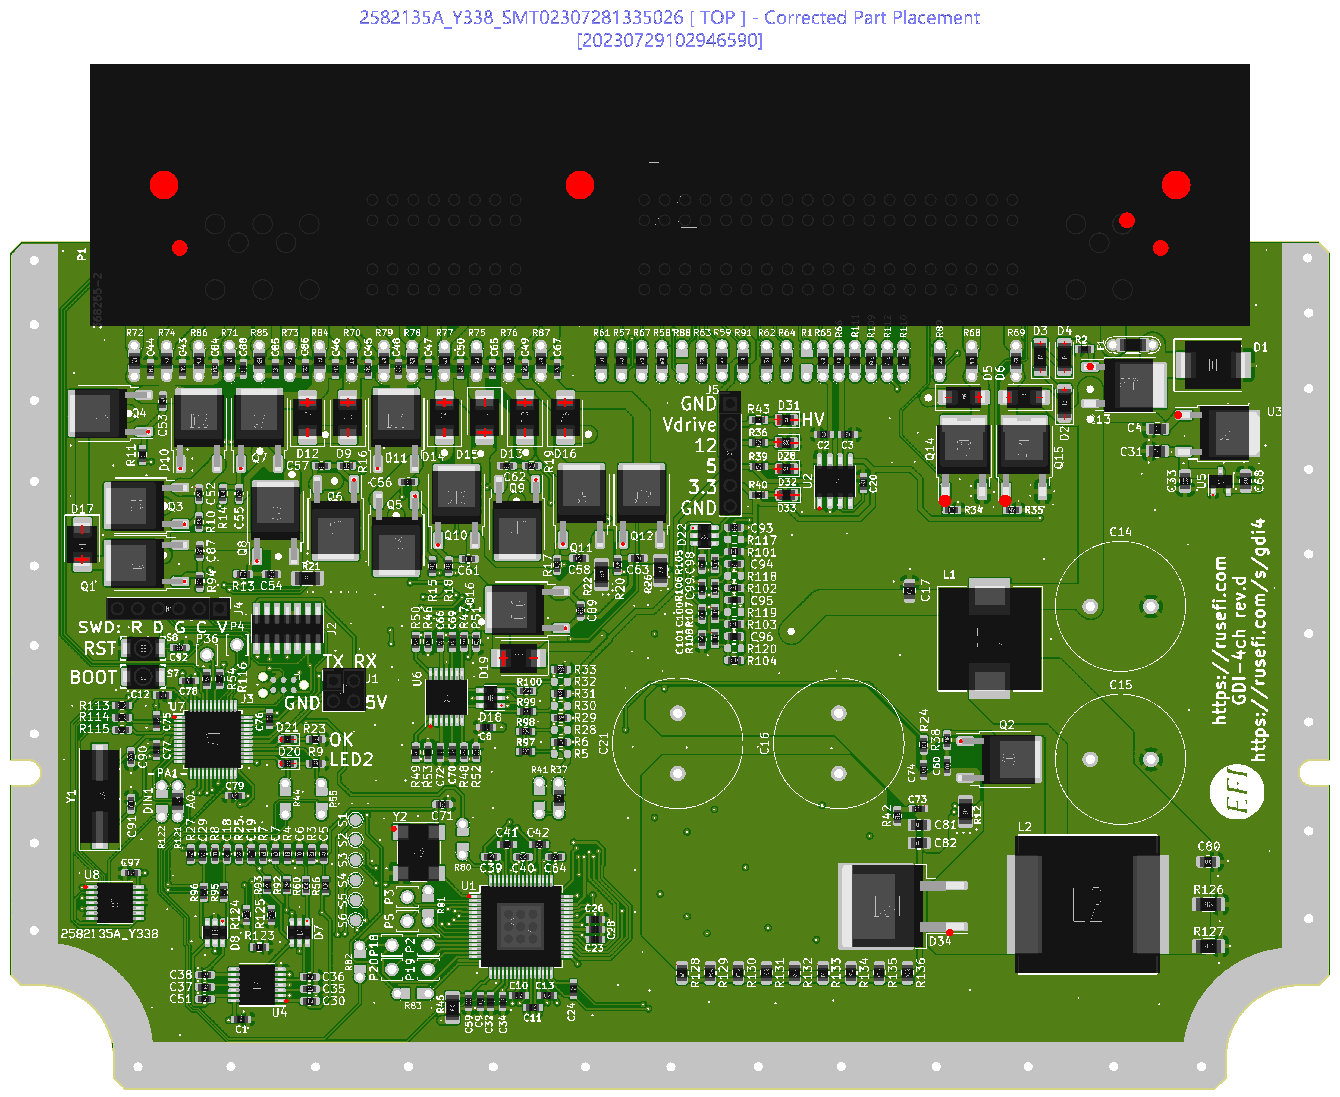
GDI-4ch/gerber/rev. d/Produce_DanZhi.SMT_Snapshot.Top.2582135A_Y338.SMT02307281335026.png
