rusefi/rusefi-hardware/GDI-6ch/production/rev. b/60-Produce_DanZhi.SMT_Original_Snapshot.Bottom.2582135A_Y481.SMT024101060140.png

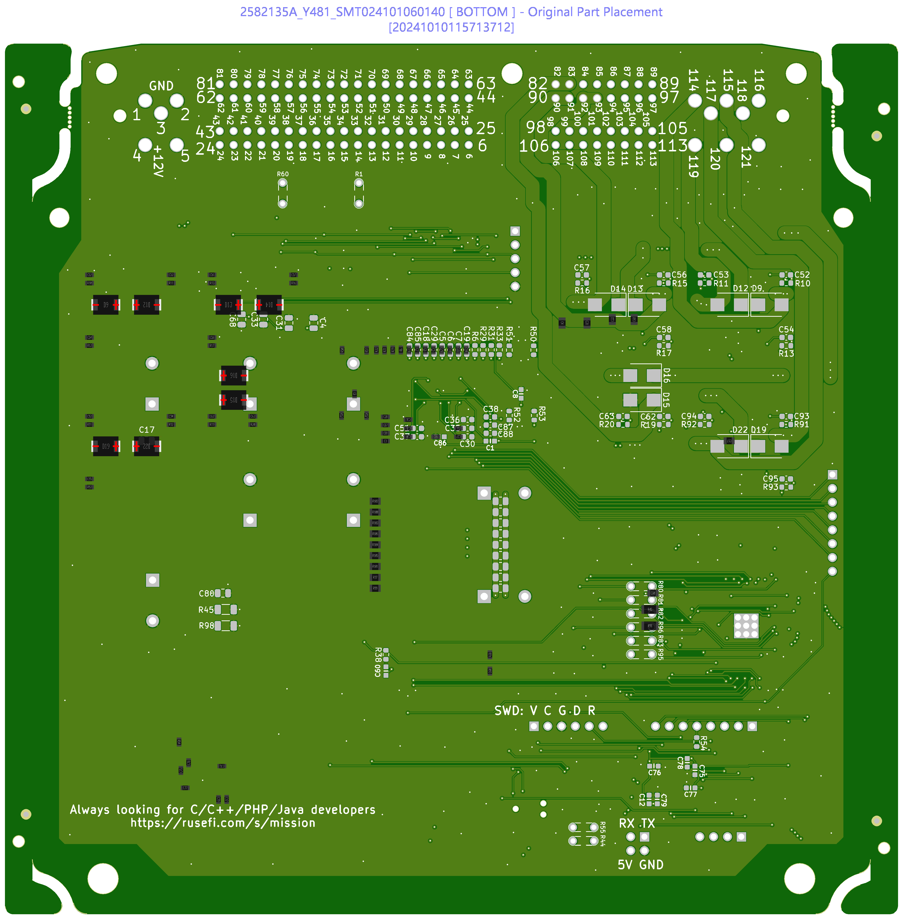
GDI-6ch/production/rev. b/60-Produce_DanZhi.SMT_Original_Snapshot.Bottom.2582135A_Y481.SMT024101060140.png
