rusefi/rusefi-hardware/GDI-6ch/production/rev. b/03165591552-Produce_DanZhi.SMT_Snapshot.Bottom.2582135A_Y481.SMT024101060140.png

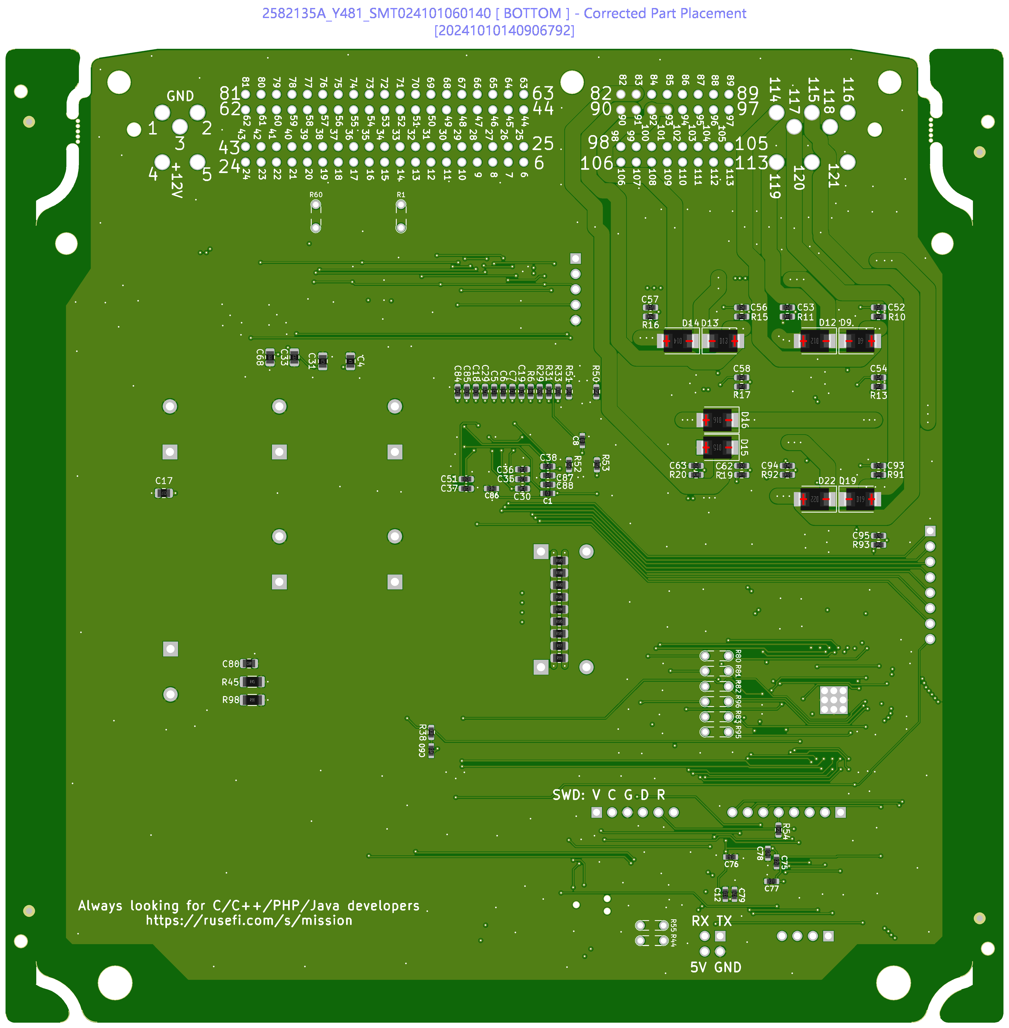
GDI-6ch/production/rev. b/03165591552-Produce_DanZhi.SMT_Snapshot.Bottom.2582135A_Y481.SMT024101060140.png
