rusefi/rusefi-hardware/jatco/connectors/female.jpg

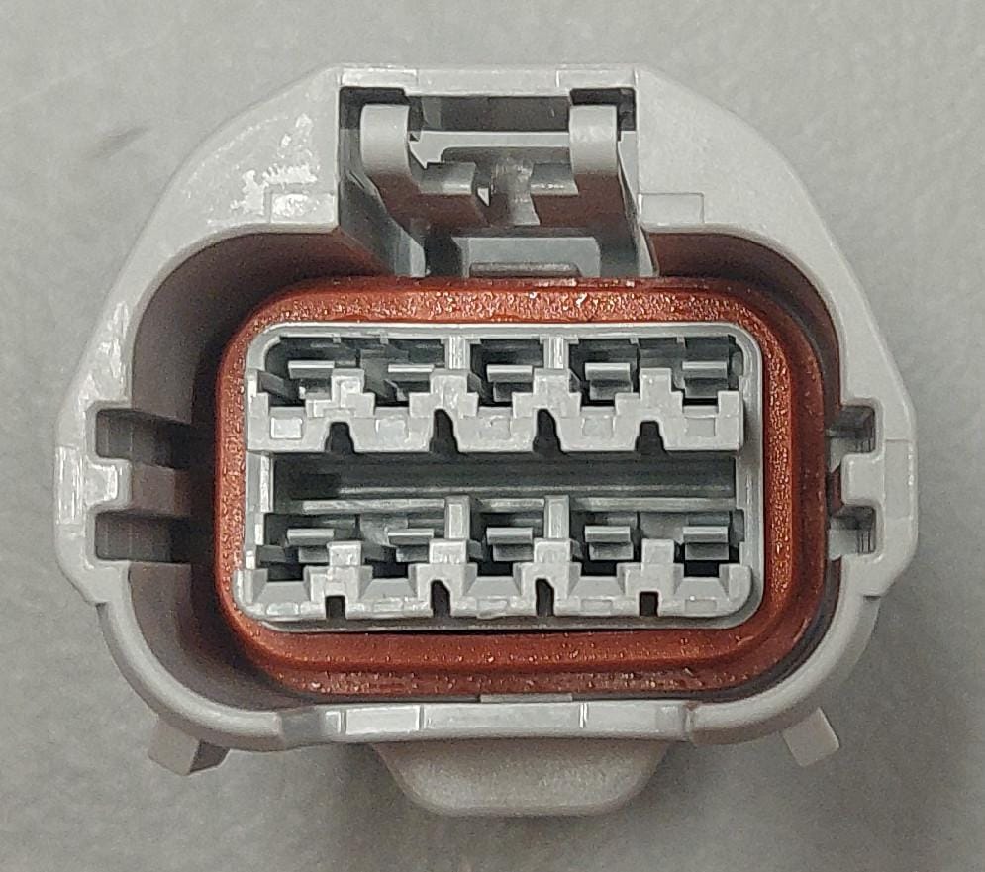
jatco/connectors/female.jpg
