rusefi/rusefi-hardware/jatco/connectors/male.jpg

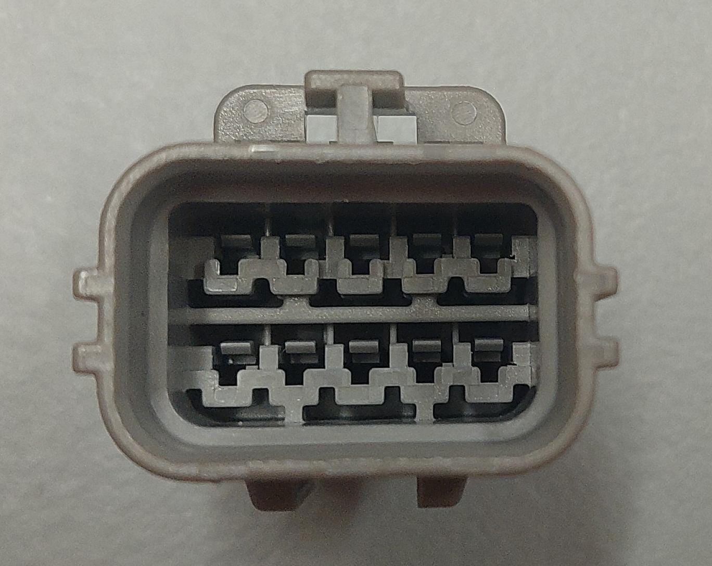
jatco/connectors/male.jpg
