rusefi/rusefi-hardware/lambda-x2/export/rev1/lambda-x2-rev1.png

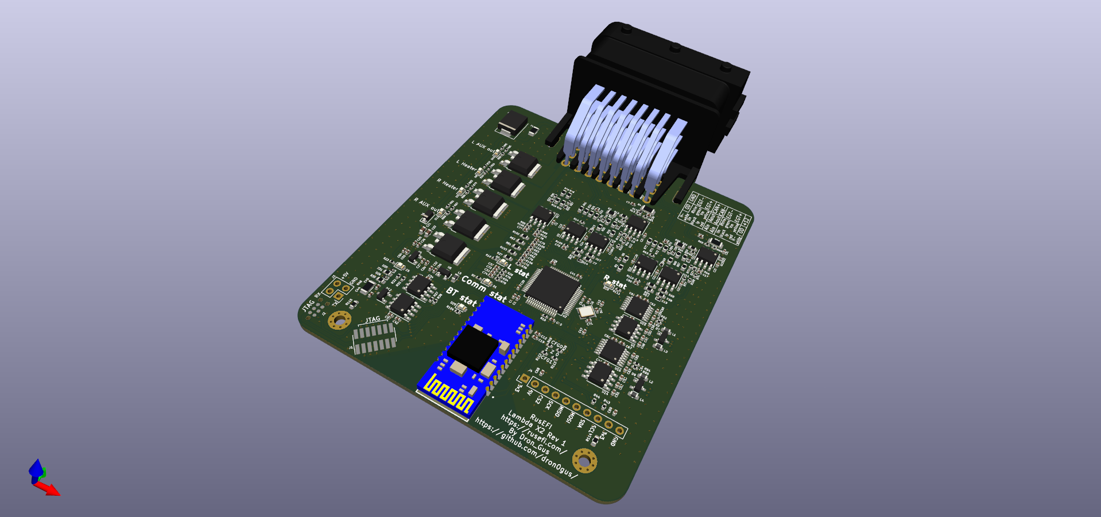
lambda-x2/export/rev1/lambda-x2-rev1.png
