rusefi/rusefi-hardware/lambda-x2/export/rev1/Produce_DanZhi.SMT_Original_Snapshot.Top.2582135A_Y290.SMT02302261146243.png

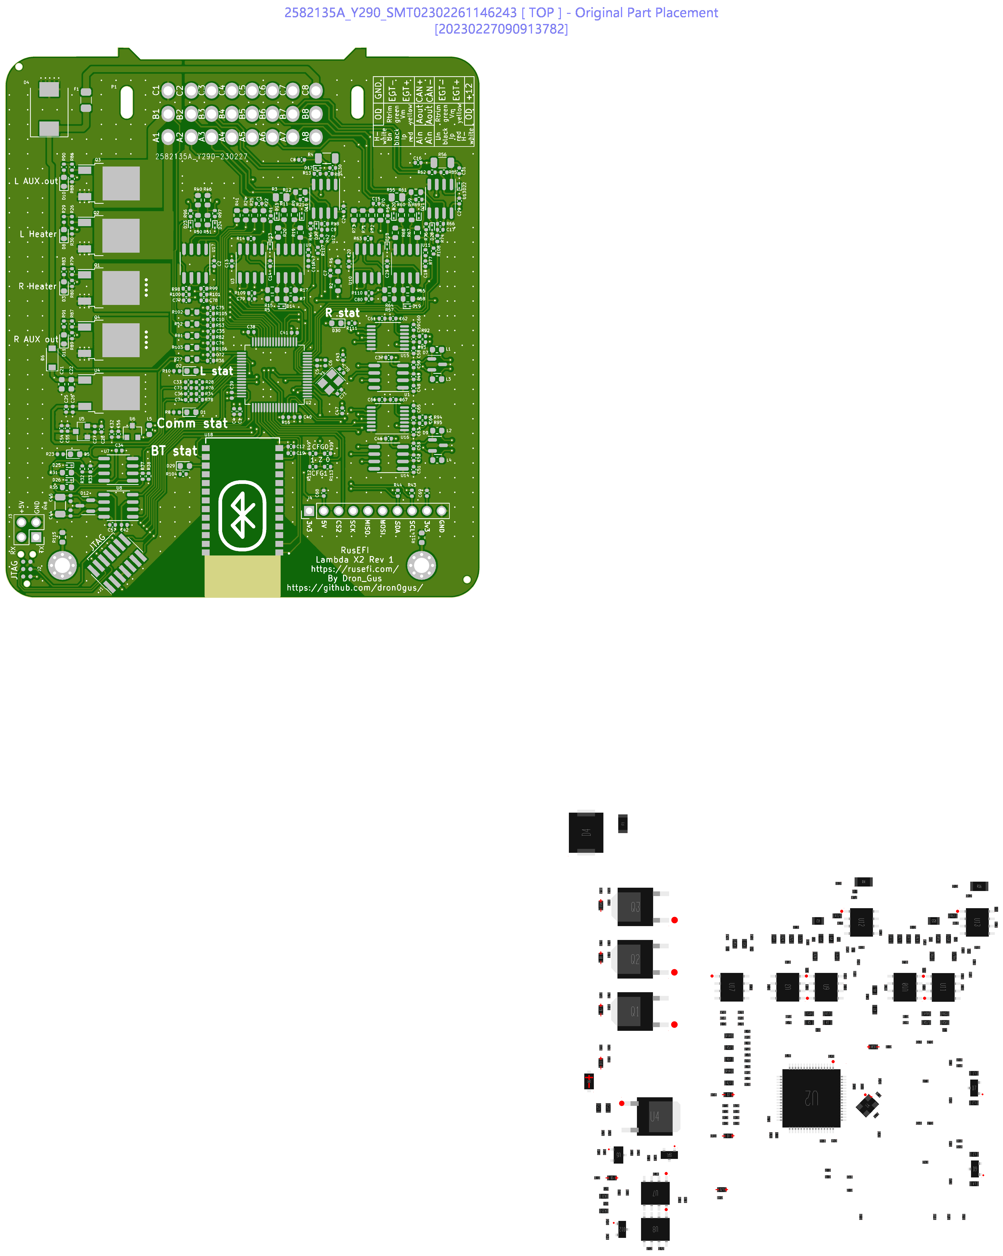
lambda-x2/export/rev1/Produce_DanZhi.SMT_Original_Snapshot.Top.2582135A_Y290.SMT02302261146243.png
