rusefi/rusefi-hardware/mini48-stm32/images/mini48-stm32-0.3-at-angle.jpg

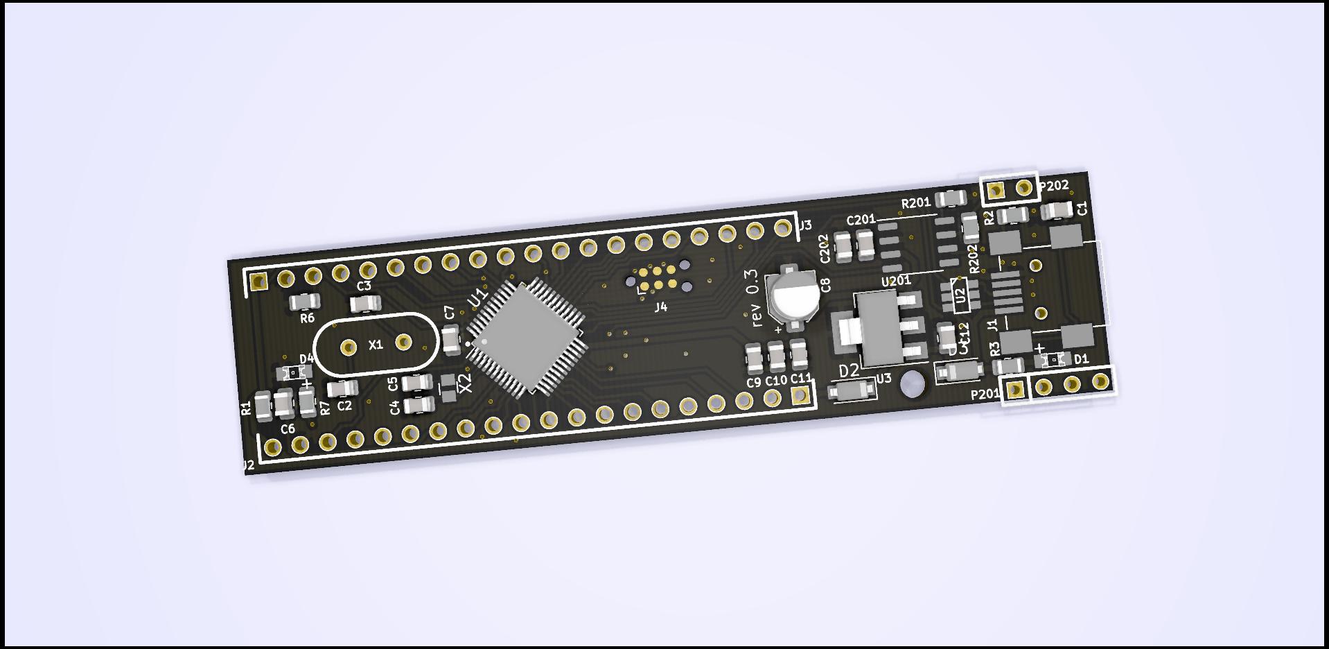
mini48-stm32/images/mini48-stm32-0.3-at-angle.jpg
