rusefi/rusefi-hardware/Toyota-JZA80/connectors/E9.png

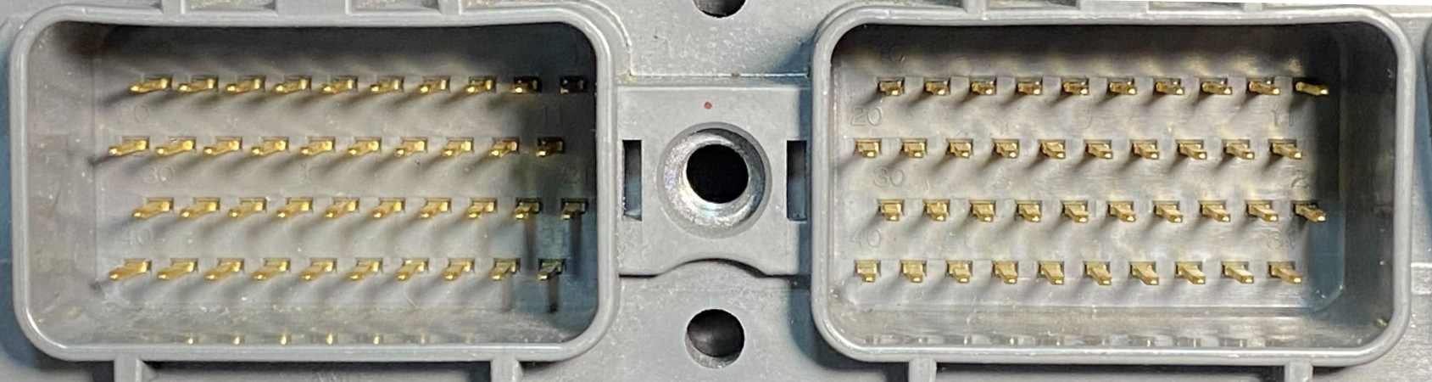
Toyota-JZA80/connectors/E9.png
