rusefi/rusefi-hardware/Toyota-JZA80/connectors/E10.png

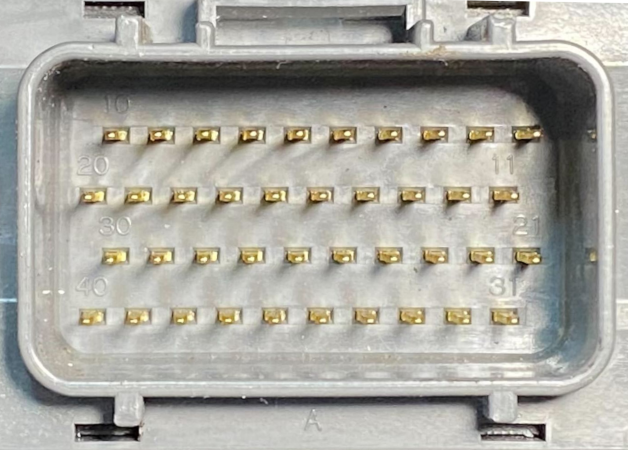
Toyota-JZA80/connectors/E10.png
