rusefi/rusefi-hardware/Toyota-JZA90/connectors/C85-C86.png

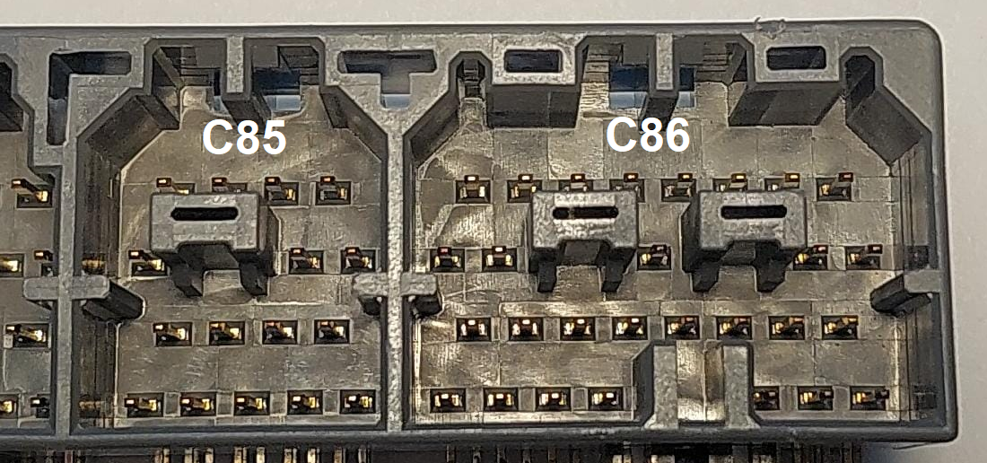
Toyota-JZA90/connectors/C85-C86.png
