rusefi/rusefi-hardware/Toyota-JZA90/connectors/C88-C84.png

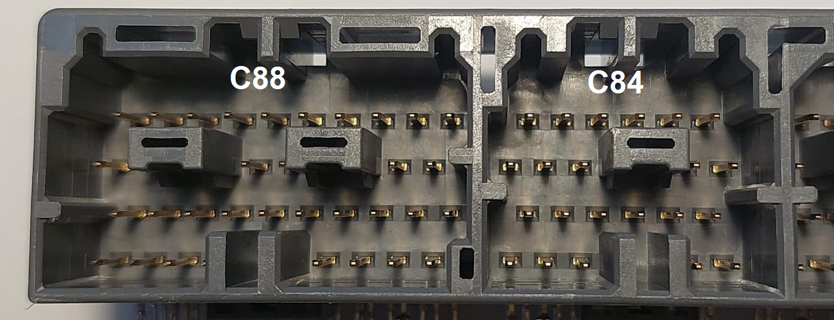
Toyota-JZA90/connectors/C88-C84.png
