rusefi/rusefi-hardware/ncv1124-micro/production/bom.csv

Designator | Footprint | Quantity | Value | LCSC Part #
C1, C2, C3 | 0603 | 3 | 0.022u | C21122
C4 | 0603 | 1 | 0.22u | C21120
D1, D3, D4 | 0603 | 3 | LED | C2290
D5 | SO-8_3.9x4.9mm_P1.27mm | 1 | NCV1124 | C152274
Q1, Q2 | SOT-23 | 2 | 2N7002 | C8545
R1, R12, R13, R14 | 0603 | 4 | 3K | C4211
R10 | 0603 | 1 | 24k | C23352
R11 | 0603 | 1 | 39 | C23154
R2, R3, R4, R5, R6, R7, R8, R9 | 1210 | 8 | 22k | C230119
