rusefi/rusefi-hardware/ZF8HP Transmission/export/BOM-8HPTCUAdapter.csv

Comment | Designator | Footprint | LCSC | Quantity
~ | 8hpTCU1 | 8hpTCU |  | 1
