rusefi/rusefi-hardware/A4988_stepper_motor_driver/export/Motor_driver_A4988_BOM.xlsx

Comment | Designator | Footprint | JLCPCB Part #（optional）
0,1uF | C1 | C0603 | C30926
0,22uF | C2 | C0603 | C21120
0,1uF | C3 | C0603 | C30926
4,7uF | C4 | C1206 | C1872
0,1uF | C5,C6,C7 | C0603 | C30926
A4988 | D1 | QFN-28 | C38437
10k | R1 | R0603 | C25804
60,2k | R2 | R0603 | C23089
20k | R3 | R0603 | C4184
100k | R5,R6 | R0603 | C14675
68m | Rcs1,Rcs2 | R1206 | C2974117
