rusefi/rusefi-hardware/Low-Z_LM1949/export/0.1/BOM.xlsx

Comment | Designator | Footprint | LCSC Part Number
0.1uF | C1,C2,C3 | Capacitor_SMD:C_0805_2012Metric_Pad1.18x1.45mm_HandSolder | C126469
220nF | C4 | Capacitor_Tantalum_SMD:CP_EIA-3216-18_Kemet-A_Pad1.58x1.35mm_HandSolder | C11364
BC817 | Q1 | Package_TO_SOT_SMD:SOT-23 | C475629
TIP122 | Q2 | Package_TO_SOT_THT:TO-220-3_Vertical | C16283
10k | R1 | Resistor_SMD:R_0805_2012Metric_Pad1.20x1.40mm_HandSolder | C416062
1k | R2,R4 | Resistor_SMD:R_0805_2012Metric_Pad1.20x1.40mm_HandSolder | C100046
0.2R | R3,R5 | Resistor_SMD:R_0805_2012Metric_Pad1.20x1.40mm_HandSolder | C176047
39k | R6 | Resistor_SMD:R_0805_2012Metric_Pad1.20x1.40mm_HandSolder | C416101
