rusefi/rusefi-hardware/mini48-stm32/export/rev 0.3/BOM.xlsx

Comment | Designator | Footprint | JLCPCB Part #
4700pF | C1 | Capacitor_SMD:C_0805_2012Metric | C123621
18pF | C2 | Capacitor_SMD:C_0805_2012Metric | C113825
18pF | C3 | Capacitor_SMD:C_0805_2012Metric | C113825
12pF | C4 | Capacitor_SMD:C_0805_2012Metric | C0805
12pF | C5 | Capacitor_SMD:C_0805_2012Metric | C0805
100nF | C6 | Capacitor_SMD:C_0805_2012Metric | C111492
1uF | C7 | Capacitor_SMD:C_0805_2012Metric | C106838
47uF | C8 | Capacitor_SMD:CP_Elec_4x5.3 | C124129
0.1uF | C9 | Capacitor_SMD:C_0805_2012Metric | C111492
1uF | C10 | Capacitor_SMD:C_0805_2012Metric | C106838
1uF | C11 | Capacitor_SMD:C_0805_2012Metric | C106838
10uF | C12 | Capacitor_SMD:C_0805_2012Metric | C117956
0.1uF | C201 | Capacitor_SMD:C_0805_2012Metric | C111492
4.7uF | C202 | Capacitor_SMD:C_0805_2012Metric | C123621
GREEN | D1 | LED-0805_A | C693904
DIODESCH | D2 | Diode_SMD:D_SOD-123 | C82288
DIODESCH | D3 | Diode_SMD:D_SOD-123 | C82288
BLUE | D4 | LED-0805_A | C99870
MINI-USB | J1 | MINI-USB-5P-3400020P1 | C2681563
Conn_01x20 | J2 | mini48-stm32:PIN_ARRAY_20X1 | DNP
Conn_01x20 | J3 | mini48-stm32:PIN_ARRAY_20X1 | DNP
Conn_02x03_Odd_Even | J4 | Connector:Tag-Connect_TC2030-IDC-NL_2x03_P1.27mm_Vertical | DNP
CONN_4 | P201 | SIL-4 | DNP
JUMPER | P202 | JUMPER-2 | DNP
1k | R1 | Resistor_SMD:R_0805_2012Metric | C218388
1M | R2 | Resistor_SMD:R_0805_2012Metric | C230655
1k | R3 | Resistor_SMD:R_0805_2012Metric | C218388
10k | R6 | Resistor_SMD:R_0805_2012Metric | C212284
1k | R7 | Resistor_SMD:R_0805_2012Metric | C218388
10k | R201 | Resistor_SMD:R_0805_2012Metric | C212284
120 | R202 | Resistor_SMD:R_0805_2012Metric | C149652
STM32F103C8 | U1 | Package_QFP:LQFP-48_7x7mm_P0.5mm | C8734
NUF2101MT1G | U2 | Package_TO_SOT_SMD:SOT-23-6 | C2827654
LM2937 | U3 | Package_TO_SOT_SMD:SOT-223 | C140265
SN65HVD230 | U201 | Package_SO:SO-8_3.9x4.9mm_P1.27mm | C12084
8MHz | X1 | Crystal:Crystal_SMD_HC49-SD | C106809
32.768KHz | X2 | mini48-stm32:SMD2012-2P | C515343
