rusefi/rusefi-hardware/classic-designs/5V-regulator/PWR_5V_linear_by-ref.csv

ref | value | Field1 | Field2 | Field3 | Field4 | Field5 | Field6 | Field7 | Field8
C1001 | 0.1uF 50V | blah | blah | blah | blah | sky-macau | 6175330450
C1002 | 1uF 16V | blah | blah | blah | blah | sky-macau.com | 5761275017
D1001 | 7.5V | diodesinc | BZT52C7V5-7-F | DIGI | BZT52C7V5-FDICT-ND | sky-macau.com | 5633100308
D1002 | 15V | FAIRCHILD | 1N5245B | DIGI | 1N5245BFS-ND | sky-macau.com | 9197428750
D1003 | 24V | fairchild | BZX79C20 | DIGI | BZX79C20-ND
D1004 | 24V | fairchild | BZX79C20 | DIGI | BZX79C20-ND
D1005 | LED-grn | lite-on | LTST-C171GKT | DIGI | 160-1423-1-ND | sky-macau | 1562597916
F1001 | 5A | 0R | jumperwire | 0R | jumperwire
P901 | CONN_1 | dnp | dnp | dnp | dnp
P902 | CONN_1 | dnp | dnp | dnp | dnp
P1002 | CONN_1 | DO NOT POPULATE | DNP | DO NOT POPULATE | DNP
P1004 | CONN_1 | DO NOT POPULATE | DNP | DO NOT POPULATE | DNP
Q1001 | 30V | vishay | SI2323DS-T1-E3 | DIGI | SI2323DS-T1-E3CT-ND | sky-macau.com | 4824167646
Q1002 | 200V | IXYS | IXTA6N50D2 | digikey | IXTA6N50D2-ND
R1001 | 1k | Panasonic | ERA-6AEB102V | DIGI | P1.0KDACT-ND | sky-macau | 7768409796
R1002 | 1k | Panasonic | ERA-6AEB102V | DIGI | P1.0KDACT-ND | sky-macau | 7768409796
R1003 | 100k | ECG | ERA6AEB104V | DIGI | P100KDACT-ND
R1006 | 240R |  |  |  |  | sky-macau | 5622933558
RV1001 | 1k |  |  |  |  | sky-macau | 2633110656
U1001 | LM317M | blah | LM317M | blah | blah | sky-macau | 9372473499
