rusefi/rusefi-hardware/breakout-boards/Breakout-24pin/export/24pins_In_3conn.csv

Comment | Designator | Footprint | LCSC Part #
MountingHole | H1 | MountingHole:MountingHole_3.2mm_M3_DIN965_Pad
MountingHole | H2 | MountingHole:MountingHole_3.2mm_M3_DIN965_Pad
MountingHole | H3 | MountingHole:MountingHole_3.2mm_M3_DIN965_Pad
MountingHole | H4 | MountingHole:MountingHole_3.2mm_M3_DIN965_Pad
DB125-2.54-8P-GN-S | J1 | Connectors:DB125-2.54-8P-GN-S
DB125-2.54-8P-GN-S | J2 | Connectors:DB125-2.54-8P-GN-S
DB125-2.54-8P-GN-S | J3 | Connectors:DB125-2.54-8P-GN-S
33311-24AW-2 | P1 | alphax-2ch:33311-24AW-2
