rusefi/rusefi-hardware/classic-designs/rusefi_hardware_history/knock_VR_Art_ELectro_rev00.10/cps_vrs_io_1.csv

ref | value | footprint | Field1 | Field2 | Field3 | Field4 | Field5 | Field6 | Field7 | Field8
C1 | 0.1uF | SM0805 | AVX | 08055C104KAT2A | DIGI | 478-1395-1-ND
C2 | 47uF | SMDSVP10 | Panasonic | EEEFK1K470P | digi | PCE3831CT-ND
C3 | 1uF | Sm0805 | KEMET | C0805C105Z3VACTU | digi | 399-1293-1-ND
C4 | 0.1uF | SM0805 | AVX | 08055C104KAT2A | DIGI | 478-1395-1-ND
C5 | 1000pF | SM0805 | AVX | 08052C102KAT2A | digi | 478-1339-1-ND
C6 | 1000pF | SM0805 | AVX | 08052C102KAT2A | digi | 478-1339-1-ND
C7 | 22uF | SMDHD/VF | PANASONIC | EEEFK1K220P | digi | PCE3828CT-ND
C8 | 22uF | SMDHD/VF | PANASONIC | EEEFK1K220P | digi | PCE3828CT-ND
C9 | 1uF | Sm0805 | KEMET | C0805C105Z3VACTU | digi | 399-1293-1-ND
C10 | 10uF | SM0805 | Taiyo | TMK316BJ106KL-T | digi | 587-1337-1-ND | 25V | 10% | multi layer ceramic | other | more | stuff
C11 | 1uF | Sm0805 | KEMET | C0805C105Z3VACTU | digi | 399-1293-1-ND
C12 | 0.1uF | SM0805 | AVX | 08055C104KAT2A | DIGI | 478-1395-1-ND
C13 | 0.1uF | SM0805 | AVX | 08055C104KAT2A | DIGI | 478-1395-1-ND
C14 | 1uF | Sm0805 | KEMET | C0805C105Z3VACTU | digi | 399-1293-1-ND
C15 | 1uF | Sm0805 | KEMET | C0805C105Z3VACTU | digi | 399-1293-1-ND
C16 | 1uF | Sm0805 | KEMET | C0805C105Z3VACTU | digi | 399-1293-1-ND
C17 | 1uF | Sm0805 | KEMET | C0805C105Z3VACTU | digi | 399-1293-1-ND
C18 | 0.1uF | SM0805 | AVX | 08055C104KAT2A | DIGI | 478-1395-1-ND
C19 | 1uF | Sm0805 | KEMET | C0805C105Z3VACTU | digi | 399-1293-1-ND
C20 | 1uF | Sm0805 | KEMET | C0805C105Z3VACTU | digi | 399-1293-1-ND
C21 | 1uF | Sm0805 | KEMET | C0805C105Z3VACTU | digi | 399-1293-1-ND
C22 | .033uF | SM0805 | yageo | CC0805KRX7R8BB333 | newark | 69C9599 | 25V | 10% | ceramic | other | more | stuff
C23 | .01uf | SM0805 | avx | 08055C103JAT2A | newark | 96M1408 |  |  | 50v | 10% | ceramic | other | more | stuff
C24 | .01uf | SM0805 | avx | 08055C103JAT2A | newark | 96M1408 |  |  | 50v | 10% | ceramic | other | more | stuff
C25 | .01uf | SM0805 | avx | 08055C103JAT2A | newark | 96M1408 |  |  | 50v | 10% | ceramic | other | more | stuff
C26 | 0.1uF | SM0805 | AVX | 08055C104KAT2A | DIGI | 478-1395-1-ND
C27 | 150pf | SM0805 | Kemet | C0805C152K5RACTU | mouser | 80-C0805C152K5R |  |  | 50V | 10% | CERAMIC | other | more | stuff
C28 | 0.1uF | SM0805 | AVX | 08055C104KAT2A | DIGI | 478-1395-1-ND
C29 | 0.1uF | SM0805 | AVX | 08055C104KAT2A | DIGI | 478-1395-1-ND
C30 | 0.1uF | SM0805 | AVX | 08055C104KAT2A | DIGI | 478-1395-1-ND
C31 | 1uF | Sm0805 | KEMET | C0805C105Z3VACTU | digi | 399-1293-1-ND
C32 | 0.1uF | SM0805 | AVX | 08055C104KAT2A | DIGI | 478-1395-1-ND
C33 | 0.1uF | SM0805 | AVX | 08055C104KAT2A | DIGI | 478-1395-1-ND
C34 | 1000pF | SM0805 | avx | 08052C102KAT2A | mouser | 581-08052C102K |  |  | 200v | 10% | x7r | other | more | stuff
C35 | 47uF | SMDSVP10 | Panasonic | EEEFK1K470P | digi | PCE3831CT-ND
C36 | 0.1uF | SM0805 | AVX | 08055C104KAT2A | DIGI | 478-1395-1-ND
C37 | 0.1uF | SM0805 | AVX | 08055C104KAT2A | DIGI | 478-1395-1-ND
C38 | 0.1uF | SM0805 | AVX | 08055C104KAT2A | DIGI | 478-1395-1-ND
C39 | .01uf | SM0805 | avx | 08055C103JAT2A | newark | 96M1408 |  |  | 50v | 10% | ceramic | other | more | stuff
C40 | 0.1uF | SM0805 | AVX | 08055C104KAT2A | DIGI | 478-1395-1-ND
D1 | ZENERSMALL | SMB | ST | SMP100LC-400 | digi | 497-4095-1-ND
D2 | ZENERSMALL | SMB | ST | SMP100LC-400 | digi | 497-4095-1-ND
D3 | ZENERSMALL | SMB | ST | SMP100LC-400 | digi | 497-4095-1-ND
D4 | ZENERSMALL | SMB | ST | SMP100LC-400 | digi | 497-4095-1-ND
D5 | ZENERSMALL | SMB | ST | SMP100LC-400 | digi | 497-4095-1-ND
D6 | ZENERSMALL | SMB | ST | SMP100LC-400 | digi | 497-4095-1-ND
D7 | TVS | SOT23 | vishay | GSOT24C-GS08 | digi | GSOT24C-GS08CT-ND
D8 | TVS | SOT23 | vishay | GSOT24C-GS08 | digi | GSOT24C-GS08CT-ND
D9 | STTH4R02S | SMB | st | STTH4R02U | digi | 497-5260-1-ND | - | - | - | -
D10 | 1N4148 | SOD-123 | Micro Commercial Co | 1N4148W-TP | digikey | 1N4148WTPMSCT-ND | .15a | -% | standard | other | more | stuff
D11 | 1N4148 | SOD-123 | Micro Commercial Co | 1N4148W-TP | digikey | 1N4148WTPMSCT-ND | .15a | -% | standard | other | more | stuff
D12 | 1N4148 | SOD-123 | Micro Commercial Co | 1N4148W-TP | digikey | 1N4148WTPMSCT-ND | .15a | -% | standard | other | more | stuff
D13 | H-AN-D | SOD-123 | ON-SEMI | BAT54T1G | digi | BAT54T1GOSCT-ND
D14 | L-AN-D | SOD-123 | ON-SEMI | BAT54T1G | digi | BAT54T1GOSCT-ND
D15 | H-AN-D | SOD-123 | ON-SEMI | BAT54T1G | digi | BAT54T1GOSCT-ND
D16 | L-AN-D | SOD-123 | ON-SEMI | BAT54T1G | digi | BAT54T1GOSCT-ND
D17 | H-AN-D | SOD-123 | ON-SEMI | BAT54T1G | digi | BAT54T1GOSCT-ND
D18 | L-AN-D | SOD-123 | ON-SEMI | BAT54T1G | digi | BAT54T1GOSCT-ND
D19 | LED | LED-0805
D20 | LED | LED-0805
JP1 | JUMPER3 | SIL-3
JP2 | JUMPER3 | SIL-3
JP3 | JUMPER3 | SIL-3
JP4 | JUMPER3 | SIL-3
JP5 | JUMPER3 | SIL-3
K1 | CONN_3 | SIL-3
L1 | 4.7uH | SM4.7uH | Coilcraft | DO3316P-472ML | coilcraftdirect | - | - | - | - | - | 3 | a | 20 | % | construct | other | more | stuff
L2 | 4.7uH | SM4.7uH | Coilcraft | DO3316P-472ML | coilcraftdirect | - | - | - | - | - | 3 | a | 20 | % | construct | other | more | stuff
P1 | 5634-P3 | pin_array_8x2
P2 | 5634-P4 | pin_array_8x2
P3 | CONN_7 | Phoenix_edge_3.5mm_7pos | Phoenix | 1893737 | MOUSER | 651-1893737
P4 | CONN_7 | Phoenix_edge_3.5mm_7pos | Phoenix | 1893737 | MOUSER | 651-1893737
P5 | CONN_7_IGN | Phoenix_edge_7.5mm_7pos | Phoenix | 1883174 | MOUSER | 651-1883174
P6 | CONN_7 | Phoenix_edge_3.5mm_7pos | Phoenix | 1893737 | MOUSER | 651-1893737
P7 | CONN_1 | sil-1
P8 | CONN_1 | sil-1
P9 | CONN_1 | sil-1
P10 | CONN_1 | sil-1
P11 | CONN_1 | sil-1
P12 | CONN_1 | sil-1
P13 | CONN_1 | sil-1
P14 | CONN_2 | Phoenix_edge_3.5mm_2pos | Phoenix | 1893685 | MOUSER | 651-1893685
P15 | CONN_2 | Phoenix_edge_3.5mm_2pos | Phoenix | 1893685 | MOUSER | 651-1893685
P16 | CONN_3 | Phoenix_edge_3.5mm_3pos | Phoenix | 1893698 | MOUSER | 651-1893698
P17 | CONN_2 | Phoenix_edge_3.5mm_2pos | Phoenix | 1893685 | MOUSER | 651-1893685
P18 | CONN_3 | Phoenix_edge_3.5mm_3pos | Phoenix | 1893698 | MOUSER | 651-1893698
P19 | CONN_2 | Phoenix_edge_3.5mm_2pos | Phoenix | 1893685 | MOUSER | 651-1893685
P20 | CONN_1 | sil-1
P21 | CONN_8X2 | pin_array_8x2
P22 | CONN_1 | sil-1
P23 | CONN_1 | sil-1
P24 | CONN_8X2 | pin_array_8x2
P25 | CONN_1 | sil-1
P26 | CONN_7 | Phoenix_edge_3.5mm_7pos | Phoenix | 1893737 | MOUSER | 651-1893737
P27 | CONN_1 | SIL-1
P28 | CONN_1 | SIL-1
P29 | CONN_1 | SIL-1
P30 | CONN_1 | SIL-1
P31 | CONN_1 | SIL-1
P32 | CONN_1 | SIL-1
P33 | CONN_1 | SIL-1
P34 | CONN_1 | SIL-1
P35 | CONN_1 | SIL-1
P36 | CONN_1 | sil-1
P37 | CONN_1 | SIL-1
Q1 | OVP_DRIVER | SO8E_ST | ST | VNS14NV04 | digi | 497-11123-1-ND
Q2 | OVP_DRIVER | SO8E_ST | ST | VNS14NV04 | digi | 497-11123-1-ND
Q3 | OVP_DRIVER | SO8E_ST | ST | VNS14NV04 | digi | 497-11123-1-ND
Q4 | OVP_DRIVER | SO8E_ST | ST | VNS14NV04 | digi | 497-11123-1-ND
Q5 | OVP_DRIVER | SO8E_ST | ST | VNS14NV04 | digi | 497-11123-1-ND
Q6 | OVP_DRIVER | SO8E_ST | ST | VNS14NV04 | digi | 497-11123-1-ND
Q7 | OVP_DRIVER | SO8E_ST | ST | VNS14NV04 | digi | 497-11123-1-ND
Q8 | OVP_DRIVER | SO8E_ST | ST | VNS14NV04 | digi | 497-11123-1-ND
Q9 | OVP_DRIVER | SO8E_ST | ST | VNS14NV04 | digi | 497-11123-1-ND
Q10 | OVP_DRIVER | SO8E_ST | ST | VNS14NV04 | digi | 497-11123-1-ND
Q11 | OVP_DRIVER | SO8E_ST | ST | VNS14NV04 | digi | 497-11123-1-ND
Q12 | OVP_DRIVER | SO8E_ST | ST | VNS14NV04 | digi | 497-11123-1-ND
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
U21 | LM3480 | SOT23-3 | LINEAR | LM3480IM3-5.0/NOPB | digi | LM3480IM3-5.0CT-ND |  |  | 5V | .05% | LINEAR | other | more | stuff
U22 | LM3480 | SOT23-3 | LINEAR | LM3480IM3-5.0/NOPB | digi | LM3480IM3-5.0CT-ND |  |  | 5V | .05% | LINEAR | other | more | stuff
U23 | 5V-bulk | TO220_VERT | - | - | - | - | 5V | .05% | LINEAR | other | more | stuff
U24 | MAX9939 | uMAX-uSOP_10 | maxim-ic | MAX9939AUB+ | mouser | 700-MAX9939AUB | - | - | - | - | - | - | - | -
U25 | MPX4250A | MPX-4_MAP | freescale | MPX4250AP | digikey | MPX4250AP-ND | x | x | x | x | x | other | more | stuff
U26 | LM358 | SO8E | st | LM358DT | digi | 497-1591-1-ND
U27 | SP723 | SO8E | littlefuse | SP723ABTG | digi | F3164CT-ND
U28 | POLOLU_A4988 | SWDIP8_.6W
U29 | SP723 | SO8E | littlefuse | SP723ABTG | digi | F3164CT-ND
U201 | MPC5634M | MODULE
W1 | JMP | SIL-2
W2 | JMP | sil-2
W3 | JMP | sil-2
W4 | JMP | SIL-2
