rusefi/rusefi-hardware/breakout-boards/Breakout-135-subaru-single/rusefi_1-1376430-0_135pin.step

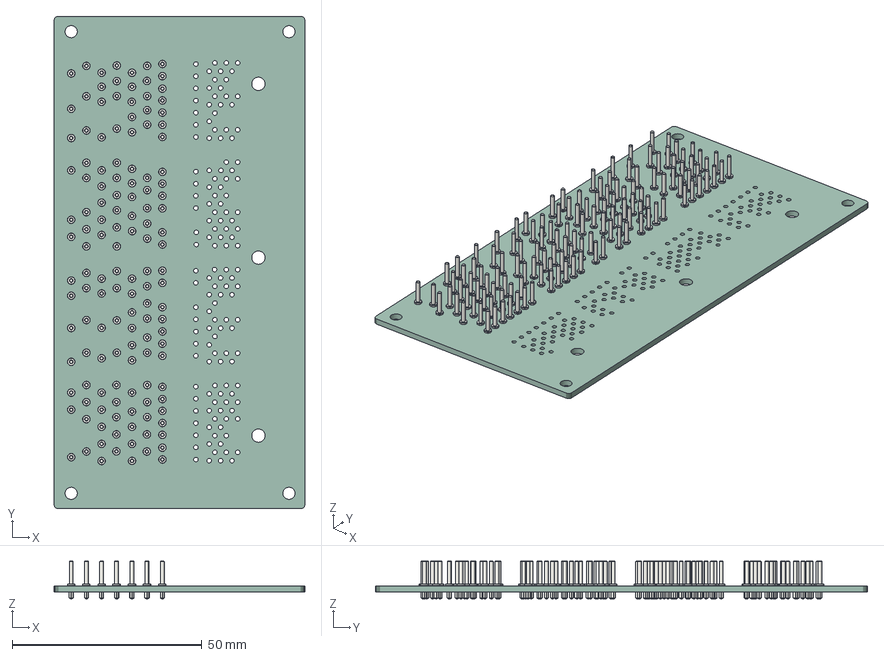
[picture p81: CAD file, 2023-07-13]
breakout-boards/Breakout-135-subaru-single/rusefi_1-1376430-0_135pin.step
66.0 x 129.5 x 10.0 mm
PCB
