rusefi/rusefi-hardware/classic-designs/frankenso/3D_case/frankenso_mazda_64_pin_case_wire_door_v03.stl

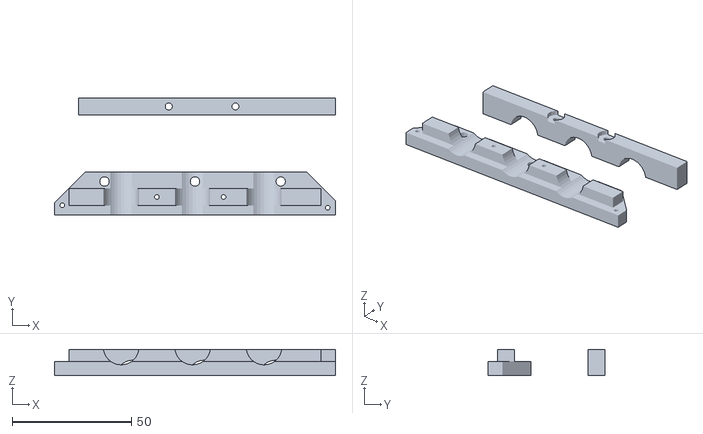
[picture p82: CAD file, 2021-11-01]
classic-designs/frankenso/3D_case/frankenso_mazda_64_pin_case_wire_door_v03.stl
118.0 x 49.0 x 11.0
