rusefi/rusefi-hardware/GDI-4ch/gerber/cover-3d/volkwagen b covers_top.stp

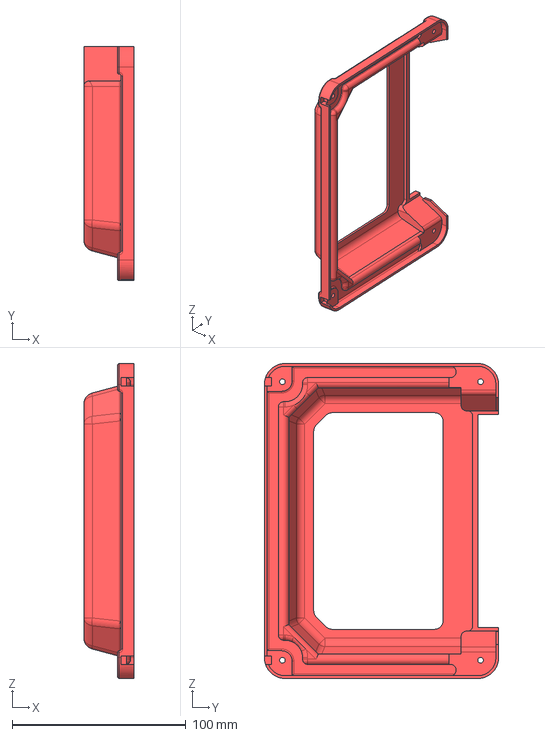
[picture p83: CAD file, 2022-10-25]
GDI-4ch/gerber/cover-3d/volkwagen b covers_top.stp
29.0 x 135.0 x 181.5 mm
