rusefi/rusefi-hardware/GDI-4ch/gerber/cover-3d/volkwagen b covers_bottom.stp

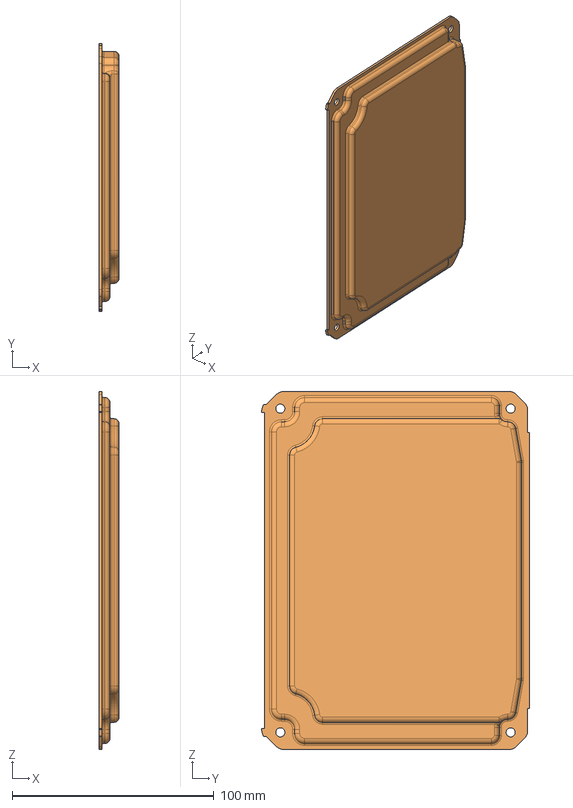
[picture p84: CAD file, 2022-10-25]
GDI-4ch/gerber/cover-3d/volkwagen b covers_bottom.stp
10.0 x 133.0 x 177.5 mm
