rusefi/rusefi-hardware/lambda-x2/JDY-33.STEP

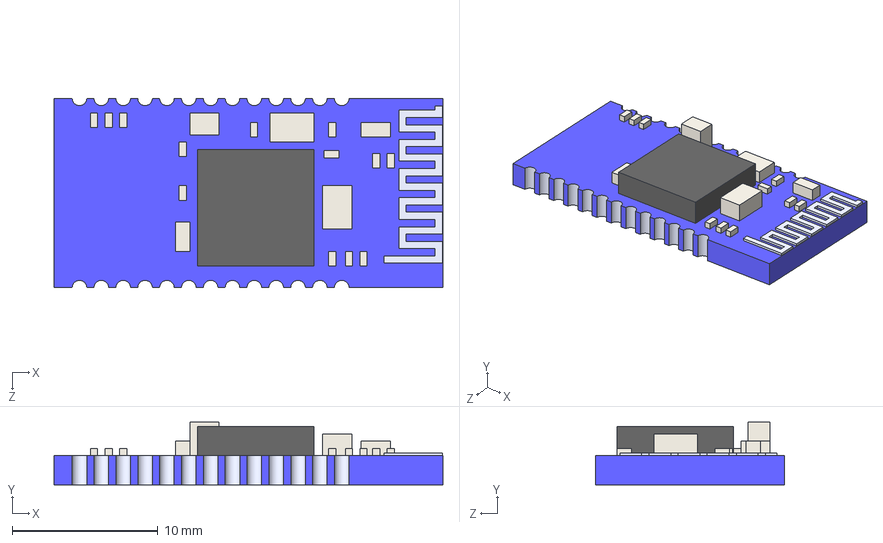
[picture p85: CAD file, 2022-04-24]
lambda-x2/JDY-33.STEP
26.7 x 4.30 x 13.0 mm
