rusefi/rusefi-hardware/lambda-x2/33311-24AW-2.STEP

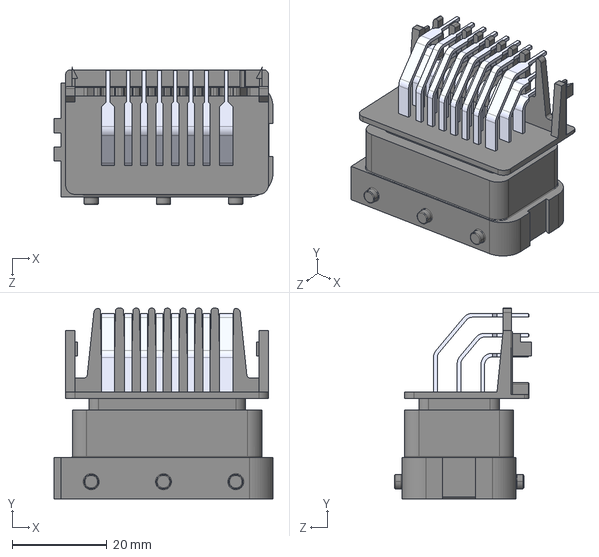
[picture p86: CAD file, 2022-04-24]
lambda-x2/33311-24AW-2.STEP
46.2 x 40.2 x 29.0 mm
