rusefi/rusefi-hardware/(list of files, cad)

Other CAD files:
GDI-4ch/gerber/cover-3d/volkwagen b covers_bottom.SLDPRT
GDI-4ch/gerber/cover-3d/volkwagen b covers_bottom.STL
GDI-4ch/gerber/cover-3d/volkwagen b covers_top.SLDPRT
GDI-4ch/gerber/cover-3d/volkwagen b covers_top.STL
