rusefi/rusefi-hardware/classic-designs/frankenstein/gerber/assembly_instruction_compact.csv

1 | 3300060P1 | Micro SD Card Socket
1 | 3400020P1 | mini USB socket
3 | 1100030P1 | quad op-amp
1 | 1720010P1 | USB TTL chip
