rusefi/rusefi-hardware/breakout-boards/Breakout_154_kia_pb-assembled.jpg

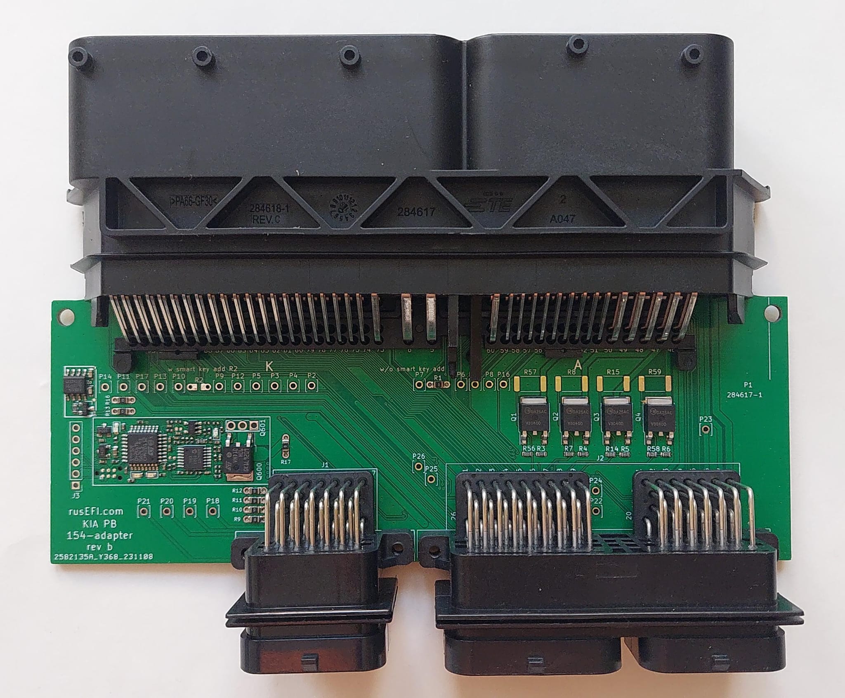
breakout-boards/Breakout_154_kia_pb-assembled.jpg
