rusefi/rusefi-hardware/breakout-boards/Passat-2.0-MED9.1-adapter-assembled.jpg

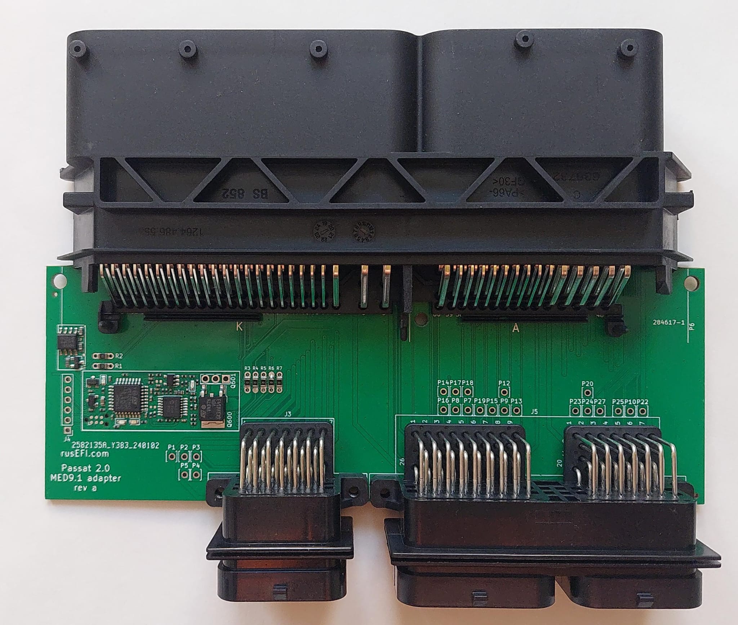
breakout-boards/Passat-2.0-MED9.1-adapter-assembled.jpg
