rusefi/rusefi-hardware/ZF8HP Transmission/images/8HP-Installation-Board.jpg

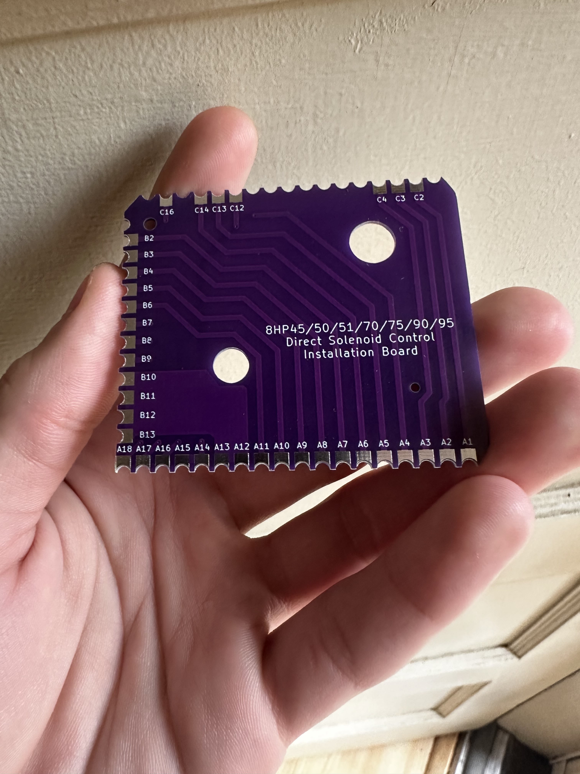
ZF8HP Transmission/images/8HP-Installation-Board.jpg
