rusefi/rusefi-hardware/CDI-test/readme.md

https://www.youtube.com/watch?v=ZHLb0ZEvTBY

WhatsApp Image 2024-09-27 at 22 01 55_d9ae9e5c
