rusefi/rusefi-hardware/VR_ncv1124_test_module/readme.md

Not suitable for crank sensor. Use this for your wheel speed or transmission shaft.

On stm32 consider using together with https://github.com/rusefi/rusefi-hardware/tree/main/frequency-divider

x
