rusefi/rusefi-hardware/classic-designs/rusefi_hardware_history/Stimulator_rev00.20/README.md

Stimulator
==========

Rusefi Stimulator
