rusefi/rusefi-hardware/(threads)

Thread 1 (2021-11-07):

mini48-stm32: add TC2030

rusefillc, 2021-11-07:
We have a working https://github.com/rusefi/rusefi-hardware/tree/main/mini48-stm32 design which needs some improvements:

1) add TC2030 SWD footprint

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

2) prepare JLCPCB full assembly files (gerbers + BOM + placement). any reasonable part substitution like button connector is totally fine

3) Do not remember if this board is 2 layer or 4 layer. If tracing TC2030 with just two layers would be challenging I am totally fine to convert into 4 layers.

https://github.com/rusefi/hw_microRusEfi could be an example of TC2030 usage and https://github.com/rusefi/hw_microRusEfi/tree/master/gerbers would be example of JLCPCB full assembly build files

rusefillc, 2021-11-11:
We have new design!

rusefillc, 2021-11-11:
Some unplanned kicad 4 to kicad 5 drama has been endured along the way

Closed 2021-11-11.

Thread 2 (2021-11-11):

current mini48-stm32 BOM costs a LOT

rusefillc, 2021-11-11:
Current price is WOW huge.

Part of problem is usage of extended parts where basic parts should hopefully do

TODO: what are other reasons of such a high price?

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

rusefillc, 2021-11-11:
https://github.com/rusefi/rusefi-hardware/blob/main/mini48-stm32/export/BOM.xlsx is the BOM in question

Thread 3 (2021-11-17):

review&fab WBO F103

rusefillc, 2021-11-17:
F042 are way less accessible than F103

so we have to convert WBO from F042 to F103

We have a test module design

https://github.com/rusefi/rusefi-hardware/tree/main/wideband-F103

need to review. reference files https://github.com/mck1117/wideband/

rusefillc, 2021-11-18:
turns out @blundar has already fabricated current module and he plans to ship me some samples

rusefillc, 2022-06-14:
fabbed

Closed 2022-06-14.

Thread 4 (2021-11-17):

Analog output for WBO F103

rusefillc, 2021-11-17:
HW part of https://github.com/mck1117/wideband/issues/12

rusefillc, 2021-11-17:
See also https://github.com/mck1117/wideband/blob/master/firmware/pump_dac.cpp

Thread 5 (2021-11-17):

BMS for 4 channel LiFePo device

rusefillc, 2021-11-17:
Martin wants to race with a lightweight battery (half the acid weight)

safest lithium battery type

mmatousek89, 2021-11-17:
https://www.ti.com/product/BQ76PL536A

mmatousek89, 2021-11-17:
device should monitor each cell voltage

trigger alarm/disconect battery when undervoltage or alternator overvoltage

provide cell balancing (discharge) by conecting rezistor to individual cell for proper amount of time

OrchardPerformance, 2021-11-18:
I don't understand why this is a rusEFI task?

LiPO racing batteries already exist that have their BMS inside the casing and just bolt into existing systems.
Designed to work with a normal car charging circuit.

https://jackwebbmotorsport.co.uk/LiFePO4-Lithium-Batteries-c42278020

mmatousek89, 2021-11-18:
@OrchardPerformance yep there is allso plenty of ecus which already exists like Motec, speeduiono, megasquirt or ecumaster, so why rusefi makes their own ECU?

mck1117, 2021-11-18:
We have neither the time nor care to do this. If you want to pay me $1000 to do it, I will instead use that to buy you a few off-the-shelf racing lithium batteries. Just not worth bothering.

For example: https://antigravitybatteries.com/

Closed 2021-11-18.

Thread 6 (2021-11-17):

Battery kill switch

rusefillc, 2021-11-17:
4 MOSFETs for battery switch
this is to reduce weight
also current measurement

mmatousek89, 2021-11-17:
https://racespeconline.com/products/msel-solid-state-battery-isolator?variant=13962734862379

mmatousek89, 2021-11-17:
https://www.ecumaster.com/products/battery-isolator/

mmatousek89, 2021-11-17:
https://www.infineon.com/dgdl/auirf7749l2.pdf?fileId=5546d462533600a4015355b0aec5140a

4of theese are what ecumaster use

mmatousek89, 2021-11-17:
https://www.infineon.com/cms/en/product/evaluation-boards/demo_batt_sw_v3/

rusefillc, 2022-06-14:
Too far D

Closed 2022-06-14.

Thread 7 (2021-11-17):

PDM

rusefillc, 2021-11-17:
fans/starter
to replace relay box, this both weight reduction and monitoring
current per device

mmatousek89, 2021-11-17:
https://www.ecumaster.com/products/pmu/

mmatousek89, 2021-11-17:
http://www.tremondi.cz/motorsport/power-units/

mmatousek89, 2021-11-17:
https://www.infineon.com/cms/en/product/power/smart-low-side-high-side-switches/high-side-switches/

mmatousek89, 2021-11-17:
https://www.infineon.com/cms/en/product/power/smart-low-side-high-side-switches/high-side-switches/profet-plus-2-12v-automotive-smart-high-side-switch/bts70015-1esp/

mmatousek89, 2021-11-17:
https://www.st.com/resource/en/datasheet/cd00002198.pdf

mmatousek89, 2021-11-17:
https://github.com/UVicFormulaMotorsport/PDU

rusefillc, 2021-11-18:
With availability drama do we like https://www.rohm.com/products/power-management/ipds/ ?

rusefillc, 2021-11-18:
Let me ask the guy if this runs stm32 or not

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

rusefillc, 2021-11-18:
Dave B.  6:08 PM
the mosfet vs. protected driver issue is an interesting one
6:08
if you're going to do digital current monitoring, you could probably get away with regular mosfets as long as you have a fast control loop for monitoring current and shutting down on a overcurrent event, and some kind of TVS clamp for inductive loads.  Wouldn't cut it for PWM/frequency control due to thermals but for solenoids that were infrequently toggled it would be fine. (edited)

6:09
PWM outputs get a recirculating flyback diode
6:09
or half bridge / FET as recirc diode
6:10
you could totally do a discretes PDM with a bunch of sense resistors and current sense amps
6:11
hell, you could probably use the RDSon of the FETs as the current sense resistor.  if you added a thermistor for each FET and did temperature compensation, you could probably get close enough (tm) with temperature compensated current sensing

rusefillc, 2021-11-19:
https://vk.com/tdgelectronics used AUIR3313S with stm32f405rgt

Thread 8 (2021-12-27):

GDI chip shortage

rusefillc, 2021-12-27:
At the moment legacy mc33816 is available

https://octopart.com/search?q=mc33816&currency=USD&specs=0
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

newer edition
https://octopart.com/search?q=MC33pt2001&currency=USD&specs=0

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

the bigger brother MC33PT2000 also available
https://octopart.com/search?q=MC33PT2000&currency=USD&specs=0
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

rusefillc, 2022-06-03:
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

no PT2000 :(

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

Thread 9 (2021-12-29):

GDI board in 121 case

rusefillc, 2021-12-29:
let's make a clone of https://rusefi.com/forum/viewtopic.php?f=4&t=1564

We have proven GDI board which requires SPI initialization and takes TTL control signals https://github.com/rusefi/rusefi/tree/master/hardware/Common_Rail_MC33816

We need an integrated unit with CAN some ARM processor (looks like GD32F130) and low side control signal option, pin compatible with BMW HDEV unit

it would be nice to increase percentage of JLC assembly

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

pinout https://github.com/rusefi/rusefi/wiki/BMW-N73#hdev

See also #11
See also #12

rusefillc, 2022-01-04:
See https://github.com/rusefi/rusefi/wiki/Passat-GDI-wiring

note 3v jumper which is only visible on the last image!!!

rusefillc, 2022-01-04:
HDEV pinout
https://raw.githubusercontent.com/wiki/rusefi/rusefi/OEM-Docs/Bmw/2003_7_Series_e65/2003_N73_engine_2.png
https://raw.githubusercontent.com/wiki/rusefi/rusefi/OEM-Docs/Bmw/2003_7_Series_e65/2003_N73_engine_3.png

rusefillc, 2022-01-04:
Let keep in mind expending this board to https://github.com/rusefi/rusefi/tree/master/hardware/Common_Rail_MC33816 later with two additional injector channels

rusefillc, 2022-01-04:
@Qwerty-OFF I forgot to mention - we have https://github.com/rusefi/rusefi-hardware/tree/main/mini48-stm32 and https://github.com/rusefi/rusefi-hardware/tree/main/wideband-F103 here with 48 pin stm32 footprint and even 12v power supply/CAN

rusefillc, 2022-01-04:
once we have the schematics and see what pins are available we will probably throw a few aux analog inputs and maybe even some outputs on the board

rusefillc, 2022-01-08:
pin 51: "ignition" - that's +12v power supply for MCU regulator / MCU power
pin 52 yellow/black is CAN-H
pin 53yellow/brown is CAN_L

on 4 channel board let's NOT use BMW pins for injectors 5 and 6
pins 47 and 47 are just vias
let's use pin 40 for pump control
let's use 82+83 for pump output LOW and 84+85 for pump output HIGH

ECU X60203.51 yellow/brown: CAN_L
ECU X60203.38 yellow/black: CAN_H

rusefillc, 2022-02-22:
pin 51 clarification:

we are trying to be as compatible with https://github.com/rusefi/rusefi/wiki/OEM-Docs/Bmw/2003_7_Series_e65/2003_N73_engine_1.png https://github.com/rusefi/rusefi/wiki/OEM-Docs/Bmw/2003_7_Series_e65/2003_N73_engine_2.png as possible

it looks like OEM pin 51 "pin 15" goes from ECU?
while pin 4 goes from main relay?

Qwerty-OFF, 2022-02-22:
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
IRQB, DRVEN, RESETB, FLAG0-3 - any free pin of stm32?
OA1-2 - ADC input of stm32?
START1-START6 directly from main connector? How to drive pump by only one pin 40?

mck1117, 2022-02-22:
For STARTx inputs:

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

This will allow us to drive STARTx from a normal lowside output on an ECU.

Closed 2022-03-20.

Thread 10 (2022-01-03):

L9779WD-SPI dev board

rusefillc, 2022-01-03:
dev board for https://www.st.com/resource/en/datasheet/l9779wd-spi.pdf with stm32f407 discovery for brain as pin compatible with MRE as reasonably possible

any shape
2 or 4 layers no difference
kicad 6.0 into https://github.com/rusefi/rusefi-hardware/tree/main/L9779WD-breakout/ folder
eval-L9779WD-SPI development could be source for inspiration for reference schematics https://www.st.com/en/evaluation-tools/eval-l9779wd-spi.html#documentation
JLCPCB part numbers where possible
0R jumpers on all L9779WD lines and vias on L9779WD side of the 0R resistor for complete unconditional flexibility just in case

Probably start  https://github.com/rusefi/hw_microRusEfi
keep 48 pin connector, TC442x and analog inputs from https://github.com/rusefi/hw_microRusEfi  remove stm32f407 replace with discovery remove TLE8888 replace with l9779wd-spi

407 discovery 2x25 headers from frankenso https://github.com/rusefi/rusefi-hardware/tree/main/classic-designs/frankenso

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

Closed 2022-07-18.

Thread 11 (2022-01-04):

GDI board in 121 case: SWD

rusefillc, 2022-01-04:
please have
1) TC2030 SWD
2) FTSH-105-01-F-DV-007-K SWD
3) 0.1" header for the most hard code users

FTSH-105-01-F-DV-007-K the way https://github.com/rusefi/rusefi-hardware/tree/main/wideband-F103 has it on the back is pretty cool but would limit casing, your call depending on tracing considerations

rusefillc, 2022-01-08:
third SWD option added just to cover all cases

Qwerty-OFF, 2022-02-22:
Done
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

Closed 2022-02-22.

Thread 14 (2022-01-08):

GDI4: four channels of analog input

rusefillc, 2022-01-08:
let's have for channels of auxiliary analog outputs routed to 121 connector

please use rusEFI typical analog input schematics like on https://github.com/rusefi/hw_microRusEfi with 500K - ish pull-downs and DNP 5v pull-ups

rusefillc, 2022-01-08:
PA0
PA2
PA3
PA4

Qwerty-OFF, 2022-02-22:
Which 121 connector pins to use?

abelom, 2022-02-22:
pins 6 7 8 9

Qwerty-OFF, 2022-02-22:
Done

Closed 2022-02-22.

Thread 15 (2022-01-08):

GDI4: two high-current aux low side drivers

rusefillc, 2022-01-08:
let's have PA1 and PB6 control VND14NV04 low side drivers

Qwerty-OFF, 2022-02-22:
Which 121 connector pins to use?

abelom, 2022-02-22:
dual pins 21+22 and 23+24 please

Qwerty-OFF, 2022-02-22:
Done

Closed 2022-02-22.

Thread 18 (2022-01-10):

208 SDRAM dev board

rusefillc, 2022-01-10:
stm32 208 meets x16 SDRAM

[0900766b815247be.pdf](https://github.com/rusefi/rusefi-hardware/files/7836950/0900766b815247be.pdf)

[STM32F429BIT6-College-shop-Store-Circuit.pdf](https://github.com/rusefi/rusefi-hardware/files/7836951/STM32F429BIT6-College-shop-Store-Circuit.pdf)

rusefillc, 2022-01-10:
@dron0gus I've just realized that same exact SDRAM chip like on 429-discovery is still pretty available https://octopart.com/search?q=IS42S16400J-7TL

rusefillc, 2022-01-11:
See also https://github.com/andreika-git/hellen-one/issues/29

Thread 19 (2022-01-10):

WBO-F103: silkscreen

rusefillc, 2022-01-10:
We need silkscreen for all pins. Looks like back side would be perfect?

while we are on that subject we can use some board name on the back maybe even with some URL maybe even https://github.com/s/wb

rusefillc, 2022-01-13:
@blundar I am not sure if I am doing anything wrong but I do no see silk on back of PCB :(

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

can you plz paste a screenshot of how it looks on your end?

dron0gus, 2022-04-10:
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
How it looks like after https://github.com/rusefi/rusefi-hardware/pull/60 .

Closed 2022-04-10.

Thread 20 (2022-01-10):

WBO-F103: ID selection pins

rusefillc, 2022-01-10:
firmware reads state of two pins in order to figure out CAN index of this specific unit since we support multiple units on the same CAN bus

pull-up, pull-down and floating pins are all supported!

let's have some pads for 0R resistors on PB0 and PB1 for pull-up or pull-down?

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

dron0gus, 2022-04-10:
Implemented on PC13, PC14 pins in https://github.com/rusefi/rusefi-hardware/pull/60

Closed 2022-04-10.

Thread 22 (2022-01-11):

GDI6 board

rusefillc, 2022-01-11:
Same as GDI4 just with PT2000 not PT2001

See https://github.com/rusefi/rusefi-hardware/issues?q=is%3Aissue+label%3AGDI

Closed 2022-06-03.

Thread 23 (2022-01-11):

GDI4 firmware

rusefillc, 2022-01-11:
We need F103 firmware to send PT2001 SPI commands and report success via UART and CAN

Current skeleton at https://github.com/rusefi/rusefi-hardware/tree/main/GDI-4ch/firmware

PT2001 code we would need to copy-paste from rusEFI

rusefillc, 2022-01-11:
The only new code would be "let's UART TX human-readable and CAN TX a confirmation that we have successful communication with PT2001"

rusefillc, 2022-06-14:
could be a duplicate, could be already done for most basic scope

rusefillc, 2022-08-14:
See also https://github.com/rusefi/rusefi/pull/4363

rusefillc, 2023-12-09:
GDI4 is on a dyno!

Closed 2023-12-09.

Thread 26 (2022-01-15):

MRE V2

OrchardPerformance, 2022-01-15:
With the availability of TLE8888 chips becoming bad it looks like the old version of the MRE is showing it's age and has issues that we could address with a V2.

Problems:
Heat of the power stage
Availability and cost of TLE8888
Useless flash chip
Lack of IO for some uses
Issues with main plug pinout resulting in signal noise
Components stuffed between pins on main plug
More 6 cylinders that we expected asking about MRE, also less bikes and sub-3 cylinder engines
Hall and VR needs soldering to change
No Knock sensor circuit
No room for external waterproof USB
No WBO2 option
MRE has potential to short 12v to 5v rail with incorrect JP2 soldering

Solution:
Boshun BS603 case has 64 pin plug and is only 35mm longer than existing case.
64 pin plug means we can resolve the pinout problems
Use extra 16 pins to have dedicated Hall/VR input with new discrete VR circuit.
Use extra pins to add 2x push pull and 2x lowside outputs
Extra PCB space prevents components between main plug pins
Upgrade the MRE to a switching power stage like the Proteus
Replace TLE8888 with discrete components
Replace flash with SD card (thanks to JLD)
Add knock sensor circuit from Proteus.
Introduce a "keep out" zone on the board for extra room to fit waterproof external USB
Add WBO2 circuit
Use extra room to make JP2 a DPST switch

Obvious issues:
Dev time - If we have to solve watchdog or source TLE8888 that is also dev time.
Existing cases - We can use the 48 pin case for the body module that has been discussed, we can still use them
"I want a small engine ECU" - Just use an MRE anyway or the AlphaX really small engine ECU, I can think of only one bike install and nothing less that 3 cylinders anyway.
Cross over with Proteus - Not really an issue, MRE is in my experience the first choice of most people and Protues only when they run out of IO, Proteus going to Atlas changes things anyway and means we could probably retire Proteus.

Obvious benefits:
Makes MRE V2 and Atlas only range viable.
Covers all basic engines with the MRE (up to 6 cylinders, Wasted+Batch V8)
Aligns MRE with the full 2022+ rusEFI software capabilities
64 pin plug means improved IO, better routing and no chance of accidental plug in with an MRE V1
Cost of unit will be roughly the same as existing MRE or less, 64pin case is the same price, TLE8888 cost gone.
Slightly expanded features make the slightly higher prices we have had to set much more reasonable

OrchardPerformance, 2022-01-15:
@mck1117 @rusefillc
Tagging you guys for discussion

rusefillc, 2022-01-15:
I am super tired of hardware design and I have a queue of plug-in boards to design. Somewhere in the next couple of months I will attempt to order a new batch of MRE since that's the path of least resistance. For cool ECU we have proteus. Boards based on Hellen ECU have a bit of extra size let's call it "Hellen tax". Let's see how Hellen Harley goes.

https://github.com/rusefi/alphax-4chan would be a universal smaller ECU but with only 48 pins it would be somewhat limited and not an improvement over MRE.

OrchardPerformance, 2022-01-15:
This would certainly not be near future.
Longer term strategy thing to align features.

rusefillc, 2022-01-15:
History says we are not great at long term planning

rusefillc, 2022-07-25:
this seems to describe https://github.com/rusefi/alphax-4chan/ and/or https://github.com/rusefi/alphax-8chan/ which are work in progress

Closed 2022-07-25.

Thread 32 (2022-02-23):

E65 HDEV power supply

rusefillc, 2022-02-23:
Since we are trying to create a replacement box at #9 would be nice to understand OEM HDEV power supply logic

https://github.com/rusefi/rusefi/wiki/OEM-Docs/Bmw/2003_7_Series_e65/2003_N73_engine_1.png and https://github.com/rusefi/rusefi/wiki/OEM-Docs/Bmw/2003_7_Series_e65/2003_N73_engine_2.png

it looks like OEM pin 51 "pin 15" goes from ECU?
while pin 4 goes from main relay?

what's that? ECU turns HDEV via pin 15 and HDEV draws current from pin 4? or else?

rusefillc, 2022-02-23:
@HeinrichG-V12 how do you understand HDEV power supply sequence?

rusefillc, 2023-05-14:
Zero priority

Closed 2023-05-14.

Thread 33 (2022-02-23):

pump channel control

rusefillc, 2022-02-23:
We are confused about fuel pump solenoid control

Which of start5 and/or start6 is controlling pump?
Does microcode match existing board?

Is pump controlled by both start5 and start6? if it's not, what is the other one controlling?

what pin do we expose on GDI4 connector with what kind of electrical considerations?

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

NOx-z, 2022-02-23:
per line 48 on the source on file,
https://github.com/rusefi/rusefi/blob/master/firmware/hw_layer/mc33816/rusefi/MicrocodeCh2/ch2.psc#L48
We use START6, and we turn on High-Side5 (VBat), and Low-Side6 drivers with it.

At a glance the board appears accurate. There is no populated LowSide5.

We made the decision to only map one (excluding START5), and left the other unmapped + unpopulated because the only way we could use the other was to then switch off whatever START6 was targeting, they both can not be on at the same time. We examined general use cases and found we did not have another solenoid to power intermittently.

I am unaware at the moment where the pins for GDI4 are defined. All of the START signal should be similar, that is, they are enabled at a high level (VccIO) of the MC33816/PT2001. They are not driving anything themselves beyond a signal.

rusefillc, 2022-02-26:
@Qwerty-OFF let's do both "same as injectors" via external pin and a jumpers allowing to switch to internal pump channel control from stm32f103

rusefillc, 2022-03-21:
What jumper controls internal/external pump control?

please add explicit comment right on schematics

Qwerty-OFF, 2022-03-21:
No you can use wire frome any stm32 pad:
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
to connector jumpers:
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
Do we need special jumper for this?

rusefillc, 2022-03-21:
Yes lets add a 0R

Qwerty-OFF, 2022-03-21:
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

Closed 2022-03-21.

Thread 34 (2022-02-26):

digital input board firmware

rusefillc, 2022-02-26:
we have some hardware to test at least analog muxing

need firmware

andreika-git, 2022-02-26:
> with nucleo detached from green board PF3 jumped to 3v directly reports around 3100 while I would expect much closer to 4095
> with nucleo detached from green board PF3 jumped to 3v directly reports around 420 while I would expect much closer to 0?

Looks like an "ADC echo" effect when measuring on un-connected (or anassigned) ADC input somewhere near the correct one...

abelom, 2022-03-24:
@dron0gus has fixed ADC - I have proper working ADC without green board now see https://github.com/rusefi/rusefi-hardware/commit/9add16109be7810699296a0d0019e1342f563564

see potentiometer soldered between TST1 and +12v

@Qwerty-OFF need help with test scenario: please give me some specific ADR and OUT set of values with some specific test TST test condition to read any specific voltage on IN0.

Qwerty-OFF, 2022-03-24:
Set:
A0 = A1 = A2 = A3 = 0
OUT1 = 1
TST17 = open
Rezult:
IN1 = 3.3V

Set:
A0 = A1 = A2 = A3 = 0
OUT1 = 0
TST17 = open
Rezult:
IN1 = 0V

Set:
A0 = A1 = A2 = A3 = 0
OUT1 = any
TST17 = short to GND
Rezult:
IN1 = 0V

Set:
A0 = A1 = A2 = A3 = 0
OUT1 = any
TST17 = short to +12
Rezult:
IN1 = 3.3V

rusefillc, 2022-03-25:
blocked by #50

rusefillc, 2022-06-25:
@Qwerty-OFF

https://youtu.be/UVUBTyf_aaM

не-делённое напряжение соответсвенно тихонько падает с 10ти вольт - это подтверждено мультиметром

rusefillc, 2022-06-27:
@Qwerty-OFF says

Не могу понять полную картину управления, но это пока кажется не главное. ADR0-ADR3 и MUX_OFF инверсные, чего я почему-то не написал раньше, т.е. чтобы поставить желанный второй контакт нужно выставить ADR0 в 0, остальные в 1, и MUX_OFF в 1

rusefillc, 2022-06-27:
progress!!!

```

Hello

output 1: bit=0 0
output 1: bit=1 1
output 1: bit=2 1
output 1: bit=3 1
0: 2.868 mV

Hello

output 1: bit=0 0
output 1: bit=1 1
output 1: bit=2 1
output 1: bit=3 1
1: 0.108 mV

Hello

output 1: bit=0 0
output 1: bit=1 1
output 1: bit=2 1
output 1: bit=3 1
0: 2.870 mV

Hello

output 1: bit=0 0
output 1: bit=1 1
output 1: bit=2 1
output 1: bit=3 1
1: 0.004 mV

Hello

output 1: bit=0 0
output 1: bit=1 1
output 1: bit=2 1
output 1: bit=3 1
0: 2.783 mV

Hello

output 1: bit=0 0
output 1: bit=1 1
output 1: bit=2 1
output 1: bit=3 1
1: 0.004 mV

Hello

output 1: bit=0 0
output 1: bit=1 1
output 1: bit=2 1
output 1: bit=3 1
0: 2.869 mV

```

rusefillc, 2022-06-27:
цикл от 0 до 15

```
Hello

output 1: bit=0 0
output 1: bit=1 1
output 1: bit=2 1
output 1: bit=3 1
0: 2.902 mV

output 1: bit=0 0
output 1: bit=1 1
output 1: bit=2 1
output 1: bit=3 1
1: 0.005 mV

output 1: bit=0 0
output 1: bit=1 1
output 1: bit=2 1
output 1: bit=3 1
2: 2.872 mV

output 1: bit=0 0
output 1: bit=1 1
output 1: bit=2 1
output 1: bit=3 1
3: 0.004 mV

output 1: bit=0 0
output 1: bit=1 1
output 1: bit=2 1
output 1: bit=3 1
4: 2.872 mV

output 1: bit=0 0
output 1: bit=1 1
output 1: bit=2 1
output 1: bit=3 1
5: 0.037 mV

output 1: bit=0 0
output 1: bit=1 1
output 1: bit=2 1
output 1: bit=3 1
6: 2.903 mV

output 1: bit=0 0
output 1: bit=1 1
output 1: bit=2 1
output 1: bit=3 1
7: 0.041 mV

output 1: bit=0 0
output 1: bit=1 1
output 1: bit=2 1
output 1: bit=3 1
8: 2.904 mV

output 1: bit=0 0
output 1: bit=1 1
output 1: bit=2 1
output 1: bit=3 1
9: 0.002 mV

output 1: bit=0 0
output 1: bit=1 1
output 1: bit=2 1
output 1: bit=3 1
10: 2.872 mV

output 1: bit=0 0
output 1: bit=1 1
output 1: bit=2 1
output 1: bit=3 1
11: 0.004 mV

output 1: bit=0 0
output 1: bit=1 1
output 1: bit=2 1
output 1: bit=3 1
12: 2.872 mV

output 1: bit=0 0
output 1: bit=1 1
output 1: bit=2 1
output 1: bit=3 1
13: 0.208 mV

output 1: bit=0 0
output 1: bit=1 1
output 1: bit=2 1
output 1: bit=3 1
14: 2.905 mV

output 1: bit=0 0
output 1: bit=1 1
output 1: bit=2 1
output 1: bit=3 1
15: 0.095 mV

Hello

output 1: bit=0 0
output 1: bit=1 1
output 1: bit=2 1
output 1: bit=3 1
0: 2.902 mV

output 1: bit=0 0
output 1: bit=1 1
output 1: bit=2 1
output 1: bit=3 1
1: 0.002 mV

output 1: bit=0 0
output 1: bit=1 1
output 1: bit=2 1
output 1: bit=3 1
2: 2.871 mV

output 1: bit=0 0
output 1: bit=1 1
output 1: bit=2 1
output 1: bit=3 1
3: 0.004 mV

output 1: bit=0 0
output 1: bit=1 1
output 1: bit=2 1
output 1: bit=3 1
4: 2.871 mV

output 1: bit=0 0
output 1: bit=1 1
output 1: bit=2 1
output 1: bit=3 1
5: 0.037 mV

output 1: bit=0 0
output 1: bit=1 1
output 1: bit=2 1
output 1: bit=3 1
6: 2.904 mV

output 1: bit=0 0
output 1: bit=1 1
output 1: bit=2 1
output 1: bit=3 1
7: 0.038 mV

output 1: bit=0 0
output 1: bit=1 1
output 1: bit=2 1
output 1: bit=3 1
8: 2.902 mV

output 1: bit=0 0
output 1: bit=1 1
output 1: bit=2 1
output 1: bit=3 1
9: 0.004 mV

output 1: bit=0 0
output 1: bit=1 1
output 1: bit=2 1
output 1: bit=3 1
10: 2.871 mV

output 1: bit=0 0
output 1: bit=1 1
output 1: bit=2 1
output 1: bit=3 1
11: 0.004 mV

output 1: bit=0 0
output 1: bit=1 1
output 1: bit=2 1
output 1: bit=3 1
12: 2.843 mV

output 1: bit=0 0
output 1: bit=1 1
output 1: bit=2 1
output 1: bit=3 1
13: 0.038 mV

output 1: bit=0 0
output 1: bit=1 1
output 1: bit=2 1
output 1: bit=3 1
14: 2.904 mV

output 1: bit=0 0
output 1: bit=1 1
output 1: bit=2 1
output 1: bit=3 1
15: 0.037 mV
```

rusefillc, 2022-06-27:
@andreika-git we have test data! Does it match https://github.com/rusefi/stim/issues/6#issuecomment-877653918 expectation?

Thread 35 (2022-03-13):

ADC on naked 429 nucleo

rusefillc, 2022-03-13:
https://github.com/rusefi/rusefi-hardware/tree/main/digital-inputs/firmware firmware has working serial-over-USB which should print ADC reading

problem: it does not print anything close to 0v or close to 4096 if I GND or +3v on corresponding pins

See https://github.com/rusefi/rusefi-hardware/blob/main/digital-inputs/firmware/adc.cpp

rusefillc, 2022-03-13:
actual result: I do have _some_ adc values and those do change if I GND or +3v, just not good enough

dron0gus, 2022-05-13:
@rusefillc is it fixed now?

rusefillc, 2022-07-18:
yes! one of dramas was about inversion of something

Closed 2022-07-18.

Thread 37 (2022-03-18):

WBO F103 HW status

rusefillc, 2022-03-18:
problem 1: op-ams are miss-wired https://rusefi.com/forum/viewtopic.php?p=44220#p44220

problem 2: suggested to use PB6 for heater in order to use HW timer https://github.com/rusefi/wideband/commit/4d736b0d446f9ed16ea0d5c82de8882585170e7b

dron0gus, 2022-04-10:
Fixed in https://github.com/rusefi/rusefi-hardware/pull/60

Closed 2022-04-10.

Thread 38 (2022-03-19):

WBO: Self-contained VBAT

rusefillc, 2022-03-19:
Some maybe many variants of WBO could deal with VBATT on their own

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

mck1117, 2022-03-20:
but why? they get vbatt from the ECU for free

rusefillc, 2022-03-20:
part of evil plan https://github.com/mck1117/wideband/issues/12 and overall detach from ECU

dron0gus, 2022-04-10:
HW fixed in https://github.com/rusefi/rusefi-hardware/pull/60 (but different ADC channel and divider values)

Closed 2022-04-10.

Thread 45 (2022-03-21):

Connect flag1/2, dbg, irq to mcu

rusefillc, 2022-03-21:
@mck1117 @NOx-z when do we need "flag1/2, dbg, irq to mcu" connected to MCU?

NOx-z, 2022-03-21:
Future proofing, for the if/when the microcode may evolve. It is not currently in use, but you may as well have the ability if there are extra pins on the uC available as it is only some extra traces, no additional components needed.

rusefillc, 2022-03-21:
@Qwerty-OFF please add with 0R jumpers

Qwerty-OFF, 2022-03-21:
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

Closed 2022-03-21.

Thread 46 (2022-03-21):

START5/PUMP1

rusefillc, 2022-03-21:
we don't actively use START5/PUMP1 .. what if we make space on the PCB for the required components to be manually populated later? just in case

rusefillc, 2022-03-21:
@nox-z please elaborate a bit? what components? any reference?

NOx-z, 2022-03-21:
replicating as to how the injector banks allow 2 different lowsides. the Q12, C63, R20, D16, C67 would be replicated/duplicated, and this fet output would tie into the sense resistor, R26.
Also, the current label for the single pump circuit out is `L5`, this should be `L6` if the D/G_LS6 are used. Recommendation to change the label of the output on the connector to be N/P (Negative/Positive) like the injectors instead of L/H (Low/High), for consistency.

rusefillc, 2022-03-21:
Low priority, only if not a major pain in terms of space.

Qwerty-OFF, 2022-03-21:
L5\L6 fixed
At now we have place only for HS5 or LS5. I can change HS5 to LS5. Placement of HS5 and LS5 together will require significant changes.

rusefillc, 2022-03-21:
Please stay as compatible with existing board as possible to use same pt2001 microcode

Qwerty-OFF, 2022-03-21:
OK, I keep Common_Rail_MC33816 structure with HS5

Closed 2022-04-07.

Thread 49 (2022-03-21):

Non jlc bom

rusefillc, 2022-03-21:
Need all the non JLC parts in a separate file please

rusefillc, 2022-04-07:
https://github.com/rusefi/rusefi-hardware/blob/main/GDI-4ch/gerber/rev.%20a/GDI-4ch%20non-JLC.csv

Closed 2022-04-07.

Thread 50 (2022-03-25):

digital input board firmware: ADDR gpio bug

rusefillc, 2022-03-25:

rusefillc, 2022-03-25:
PC5 I see a HW conflict

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

rusefillc, 2022-03-25:
@dron0gus need help :(

dron0gus, 2022-03-26:
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
Removing SB177 should put ethernet Phy into reset. This should keep all phy's outputs in hi-z state.

mck1117, 2022-03-26:
You could also hold that pin low with the stm32 if it's connected to a gpio.

rusefillc, 2022-03-26:
Does this explain pc8 drama?

rusefillc, 2022-03-26:
As for ETH i was thinking to simply remove stuff from nucleo

rusefillc, 2022-03-31:
https://www.st.com/resource/en/user_manual/dm00244518-stm32-nucleo-144-boards-stmicroelectronics.pdf says that PC5 has SB181

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

rusefillc, 2022-03-31:
With SB181 removed I am at

ADR0=PC8: 3.3v
ADR1=PC6: 3.3v
ADR2=PC5: 3.3v

dron0gus, 2022-03-31:
https://github.com/rusefi/rusefi-hardware/pull/52

Thread 51 (2022-03-26):

WBO F103 wrong color notes

dron0gus, 2022-03-26:
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

Pin 3 - LSU_Vm - virtual ground should have "Yellow" label.
Pin 9 - LSU_Un - Reference cell/Nernst voltage should have "Black label"

dron0gus, 2022-04-10:
Fixed in https://github.com/rusefi/rusefi-hardware/pull/60

Closed 2022-04-10.

Thread 53 (2022-03-31):

WBO: match F042 unit pinout

rusefillc, 2022-03-31:
Since we use same physical connector can we match pinout please?

dron0gus, 2022-04-10:
Sorry, Rev2 is not compatible.

rusefillc, 2022-04-10:
zero worries those are all just prototypes for now

rusefillc, 2023-02-07:
Do not remember what this is about, closing

Closed 2023-02-07.

Thread 55 (2022-03-31):

9779 review

rusefillc, 2022-03-31:
We have https://github.com/rusefi/rusefi-hardware/tree/main/L9779WD-breakout in kicad5 MRE name

open question: what shall we do with

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

dron0gus, 2022-04-06:
OUT_21..OUT24 to OUTA..OUTD of 9779.
FLCP -> SCK of 9779.
Looks like INJ_IN_* and INJ_* are swapped on 9779. INJ_IN_* are logic level signals from STM32 should go to 9779's IN1..IN4.
IN_9..IN_12 nets to IN5..PWM/IN8 inputs of 9779.
OUT_5, OUT_6, OUT_7 to OUT5, OUT6, OUT7 of 9779.

dron0gus, 2022-04-06:
@rusefillc do we want to replace two discrete ignition drivers (U32, U33 MIC4427) with L9779's integrated ignition pre-drivers?

dron0gus, 2022-04-06:
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
Delete.

dron0gus, 2022-04-06:
Add 0R jumpers (not populate by default) between following nets:
OUT_14 - AV9
OUT_15 - AV8
OUT_16 - AV10
OUT_17 - AV6
Mapping can be adjusted for easy routing.

dron0gus, 2022-04-06:
9779.OUT_VRS -> CRNK_IN

rusefillc, 2022-04-06:
@dron0gus yes let's use 9779 features to the most

dron0gus, 2022-04-06:
@rusefillc ok!
R21, R33, R80, R81 - replace with 100R. Mark populated.
J51, J52, J53, J54 - remove
U32, U33, R122, R123, r124, R125, C78, RN5 - remove.
Ign1_MCU..Ign4_MCU nets - remove.

hasl58, 2022-04-13:
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

?

hasl58, 2022-04-13:
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
?

dron0gus, 2022-04-14:
OUT_19 OUT_20 are not used outside this sheet, so can be remover.
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

dron0gus, 2022-04-14:
As LowSides_1-2 and LowSides_3-4 are now deleted, DFB10 .. DFB 14 and OUT10 .. OUT14 are now no longer used - delete.
OUT8..OUT9 and DFB8..DFB9 are also not used - delete.
WDA_INT to some MCU gpio (if any free left).

Closed 2022-07-18.

Thread 57 (2022-04-07):

R70 and other 0R

rusefillc, 2022-04-07:
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

We probably want those populated from the factory? Some or many of those?

Qwerty-OFF, 2022-06-02:
Seems like KiCad BOM problem :( Fixed

Closed 2022-06-02.

Thread 58 (2022-04-08):

F103 board: JDY-33

rusefillc, 2022-04-08:
https://github.com/rusefi/alphax-2chan would be a know to work example of JDY-33 usage

JDY-33 is about $1.50 can we place it on the back of the board to keep space small?

dron0gus, 2022-05-13:
Done for WBOx2 board.

rusefillc, 2022-07-28:
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

rusefillc, 2022-07-28:
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

Ringenium, 2022-07-31:
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

Placed the JDY-33 on top of the board

Closed 2022-07-31.

Thread 59 (2022-04-09):

D: wheel speed input board

rusefillc, 2022-04-09:
Would one F103 be able to handle four wheel VR inputs handled by ncv1124?

Can we tap into OEM wheel speed sensor wires without disturbing OEM electronics?

kjngineering, 2022-04-09:
**Other considerations:**

4x Hall Type (square edge, 0-5V logic) -- this is VERY common for Motorsport applications.
Or a combination with VR - e.g. my front WSS are hall, my rear are VR.

OEM (with abs) typically use what's referred to a as a "Magneto Resistive" type.
The standard is the Bosch type, which is the DF11s spec; these use a 0-20mA output. Vin can be either 5v or 12v.

Using a 5V source:
With no magnet present they pass around 6mA
With a magnet present they pass around 12mA

When the sensor is failed or disconnected they pass 0mA (obviously) which allows a CEL to trigger.

They can often be confused with VR sensors, because they look similar and only have two wires.

Thread 65 (2022-04-15):

SENT reader

rusefillc, 2022-04-15:
STM32F103Cx target platform
gcc compiler + Makefile
J2716 SENT protocol input from Si7215 sensor
UART text protocol output

rusefillc, 2022-04-15:
Random links:
https://rutronik-tec.com/wp-content/uploads/2015/06/Decoding-SENT1.pdf

rusefillc, 2022-04-16:
KMZ80 datasheet has sample code for CRC see https://www.mouser.kr/datasheet/2/302/KMZ80-1387619.pdf

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

Thread 71 (2022-05-06):

how many ADC pins on stm32f4xxZ

rusefillc, 2022-05-06:
STM32F407ZGT6?
STM32F427ZGT6?

rusefillc, 2022-05-06:
407 144 pin

PA0 ADC123_IN0
PA1 ADC123_IN1
PA2 ADC123_IN2
PA3 ADC123_IN3
PA4 ADC12_IN4

PA5
PA6
PA7 ADC12_IN7
PB0 ADC12_IN8
PB1 ADC12_IN9

PC0 ADC123_IN10
PC1
PC2
PC3 ADC123_IN13
PD11  ADC34_IN8 *427*

PF3 ADC3_IN9
PF4 ADC3_IN14
PF5 ADC3_IN15
PF6 ADC3_IN4
PF7 ADC3_IN5

PF8 ADC3_IN6
PF9 ADC3_IN7
PF10 ADC3_IN8

mck1117, 2022-05-07:
Adc3 is off limits for the way we do things. 16 channels on ADC1/2.

Closed 2022-07-18.

Thread 72 (2022-05-13):

WBO, WBOx2: aux output DAC better that PWM

dron0gus, 2022-05-13:
If analog outputs are supposed to be used to interface to some ECU (not RE) we need some better solution. 10 to 12 bits.
For gauge it is good enough. May be we just need to change RC filter to some active filter (based on the same buffer opamp).

dron0gus, 2022-07-03:
[kjn260](https://rusefi.com/forum/memberlist.php?mode=viewprofile&u=1696) suggests MCP4728.

Ringenium, 2022-07-31:
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

We have activated the microcontroller DAC

Closed 2022-07-31.

Thread 73 (2022-05-13):

WBO, WBOx2: Ip protection during reset, FW update

dron0gus, 2022-05-13:
We should not feed any current to Ip cell until sensor is fully warmed. This is handled by FW.
But we need HW protection while MCU is in reset or FW update mode.
Pull PWM/DAC signal to some safe state with weak pull?

rusefillc, 2023-02-07:
@dron0gus please spell out resistor value. 10k? 100k? 500k?

I would like to make that change to single channel board rev4

dron0gus, 2023-02-25:
10K is added in Rev1 of Dual WBO https://github.com/rusefi/rusefi-hardware/pull/180

Thread 75 (2022-05-16):

WBO, WBOx2: i2c pins on extension connector - add pullups on board

dron0gus, 2022-05-16:
In case we are going to use this interface for some extension - better to have pull-ups on board.

Thread 76 (2022-05-16):

WBO, WBOx2: Vs diff amp - find more comfortable offset

dron0gus, 2022-05-16:
Current Vs diff amp math:
Vout = (Vs - Vvirt_gnd) * 3 + 0V.
When Nernst is cold Vs voltage is almost equal to 0 (Vvirt_gnd). Voltage produced by diff amp is close to 0. When Vs is driven by ESR measurement circuit this cause voltage go below 0 on opamp output and clipped. This affects measurement accuracy and sensor is actually is colder than measured.
Change negative input from Vvirt_gnd to (Vvirt_gnd + 0.45) and output offset to 3.3/2.
This will move middle point of Nernst to center of ADC input range.

dron0gus, 2023-02-25:
Fixed in Rev1 https://github.com/rusefi/rusefi-hardware/pull/180
Now Un_3x_sense = 0.247 + 3.15 * (Un - Vm)

dron0gus, 2023-02-25:
Not fixed in single channel.

Thread 77 (2022-05-18):

WBOx2: adjust PCB dimensions, connector position

dron0gus, 2022-05-18:
Fix board outline so it will fit both "plastic-top" and "grey aluminum" enclosures.

Thread 79 (2022-05-26):

let's develop GDI6

rusefillc, 2022-05-26:
we have GDI4 which seems to work

We have completely untested https://github.com/rusefi/rusefi/tree/master/hardware/Common_Rail_PT2000

Let's develop GDI6 based on PT2000

rusefillc, 2022-05-26:
@Qwerty-OFF feel free to use 121nissan PCB shape if any space constraints on current PCB shape

rusefillc, 2022-06-06:
depends on https://github.com/rusefi/rusefi-hardware/issues/87

Closed 2024-10-04.

Thread 82 (2022-06-05):

standby for F103

rusefillc, 2022-06-05:
F4 we have
```
/*
 * Standby for both F4 & F7 works perfectly, with very little current consumption.
 * Downside is that there is a limited amount of pins that can wakeup F7, and only PA0 for F4XX.
*/
void stm32_standby() {
	// Don't get bothered by interrupts
	__disable_irq();

	SysTick->CTRL = 0;
	SCB->SCR |= SCB_SCR_SLEEPDEEP_Msk;
	PWR->CR |= PWR_CR_PDDS;	// PDDS = use standby mode (not stop mode)
	PWR->CR |= PWR_CR_CSBF;	// Clear standby flag

	// Do anything the board wants to prepare for standby mode - enabling wakeup sources!
	boardPrepareForStandby();

	__WFI();
}

```

need same in SENT firmware in https://github.com/rusefi/rusefi-hardware/blob/main/SENT-box/firmware/F1-standby/standby.cpp

Closed 2022-07-18.

Thread 84 (2022-06-06):

GDI4 humming noise

rusefillc, 2022-06-06:
GDI4 board is _noisy_

I believe that original PT2001 board made no noise at all?

rusefillc, 2022-06-25:
same #101

mck1117, 2022-06-26:
as a fun aside, that means the humming was L2 saturating as the current increased in an uncontrolled manner, which can cause a mechanical thump: https://en.wikipedia.org/wiki/Saturation_(magnetic)

Closed 2022-06-25.

Thread 85 (2022-06-06):

GDI4 only injectors 1 and 2 are clicking

rusefillc, 2022-06-06:
i have proteus and harness

GDI4 "M1 soldered by Matt" board: injectors 1 and 2 are clicking, injectors 3 and 4 are NOT clicking

rusefillc, 2022-06-06:
funny thing:

we are compatible with BOSCH 7506 280 right?

Well, i have two units. Both click on injectors 1 and 3 and both do NOT click on injectors 2 and 4

meaning that injector 1 is the only injector which clicks on both GDI4 and BOSCH. Bosch somehow click No3 while GDI2 clicks No2, HUH? major pinput mess?

YES, pinout mess: Bosch clicks No4 "gdi-pin 92 / gdi-pin 96" if poked into control wire 49

See https://github.com/rusefi/rusefi/wiki/BMW-N73
See https://rusefi.com/docs/pinouts/GDI4/

rusefillc, 2022-06-06:
@NOx-z it's a false alarm it's a soldering issue - i have all four injectors clicking on GDI4

https://github.com/rusefi/rusefi-hardware/issues/86 created for pinout issue

Closed 2022-06-06.

Thread 89 (2022-06-06):

GDI4 4 cylinder firing order/pairing

rusefillc, 2022-06-06:
TBD

mck1117, 2022-06-06:
cylinder N goes to channel N, any relevant 4cyl we could run is 1-3-4-2

rusefillc, 2022-06-06:
1-3-4-2 says that we want injectors 1 and 4 on the same bank right?

So question is if can simplify the schematics notations to have 1 and 4 on same bank across all layers or if we simply add a human readable comment for cross-referencing board channels and injectors?

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

Thread 91 (2022-06-07):

GDI4 did I blow F1?

rusefillc, 2022-06-07:
my F1 no longer beeps continuity
MCU and PT2001 are alive if I power board with 5v

car starts on BMW injector box!
GDI4 was happy with same harness on bench

first attempt to start real - now I have no LEDs on GDI board "assembled by Matt"

F1 fuse https://jlcpcb.com/parts/componentSearch?isSearch=true&searchTxt=C310989 does not beep in DMM continuity test

Q1: what did I do wrong? :)
Q2: need replacement part of F1 ideally from mouser, digikey would also work

mck1117, 2022-06-07:
Under what circumstances did the fuse pop?

rusefillc, 2022-06-07:
I know that stitty 1.5A powe supply cannot even start gdi4 in one go

Takes two attempts to start the board!

That points to maybe inrush filling the capacitors
Car battery has no such problem

rusefillc, 2022-06-08:
big external 10A does not blow but #92

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

mck1117, 2022-06-13:
This may actually be fixed by #101 - without current sense the boost converter could be doing stupid things to the power supply.

rusefillc, 2022-06-15:
Yes

rusefillc, 2022-06-19:
solved by fixing shunt soldering

i run with 5A SMD fuses borrowed from Harley hellen

Closed 2022-06-19.

Thread 92 (2022-06-08):

huh? green blinking turns into blue blinking on cranking

rusefillc, 2022-06-08:
GDI4 board brinks green before cranking
i crank Passat
GDI4 is now blinking blue and vehicle is not starting :(

rusefillc, 2022-06-08:
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

mck1117, 2022-06-08:
It goes back to green if you power cycle?

rusefillc, 2022-06-19:
solved by proper soldering of the shunts

Closed 2022-06-19.

Thread 94 (2022-06-08):

GDI4 reset via CAN

rusefillc, 2022-06-08:
since GDI4 board does not have HW reset button shall I implement CAN-based reset command? that's all about over-engineering #92 drama

Closed 2022-07-18.

Thread 95 (2022-06-10):

GDI4, GDI6 huge holes/vias for PT2001 and PT2000 main pads

rusefillc, 2022-06-10:
can we do similar to microRusEFI maybe with 1mm diameter holes?

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

rusefillc, 2022-06-10:
Why did Q2 fry? What was I doing? well, while the board was powered, I believe I was moving the test injector from one injector output to another.. also my 'bench' isn't exactly stable - I just have wired for the injector->outputs just twisted together, so it can easily happen that it disconnects mid-run.. either during idle, or peak, or hold... is it reasonable to say this will happen inside of a car with many vibrations? or just bad user unplugging one mid-run? And better yet: how do we protect against Q2 blowing, since it also happened to me on R0.3 boards

[1:20](https://rusefi.slack.com/archives/CFP3QAJCW/p1654881630526919)
also, comparing the eval kit schematic to ours, the only real difference I can see is a small RC before the 10uH inductor (that could help with our noise?) .. so I dont particularly see much difference.. but they may not have seen this issue on the bench neither

Qwerty-OFF, 2022-06-11:
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

Closed 2022-06-11.

Thread 96 (2022-06-10):

QDI4 Q2 protection

rusefillc, 2022-06-10:
if you can tack a wire onto C32/C9 to look at, it may tell us something as well
[8:40](https://rusefi.slack.com/archives/CFP3QAJCW/p1654821635398899)
(should be 1.58v)
[8:40](https://rusefi.slack.com/archives/CFP3QAJCW/p1654821640976629)
or there abouts

[Noxz](https://app.slack.com/team/UBFRN2SH0)
  [9:00 PM](https://rusefi.slack.com/archives/CFP3QAJCW/p1654822854760399)
put a 15A fuse with alligator clips.. from the frankenso, in.. and it blew within 1 second.. I also had DRIVEN hard wired to ground
[9:01](https://rusefi.slack.com/archives/CFP3QAJCW/p1654822916191529)
so something is pinned to ground
[9:02](https://rusefi.slack.com/archives/CFP3QAJCW/p1654822943329589)
oh, the 12v line.. from somewhere
[9:06](https://rusefi.slack.com/archives/CFP3QAJCW/p1654823180340399)
iirc the only way to figure out what fried is to start taking stuff out individually.. right?
[9:06](https://rusefi.slack.com/archives/CFP3QAJCW/p1654823189334389)
if nothing visible

[andrey](https://app.slack.com/team/U4PVDN5L7)
  [9:10 PM](https://rusefi.slack.com/archives/CFP3QAJCW/p1654823442222799)
https://github.com/rusefi/rusefi-hardware/issues/95

[#95 GDI4, GDI6 huge holes/vias for PT2001 and PT2000 main pads](https://github.com/rusefi/rusefi-hardware/issues/95)
can we do similar to microRusEFI maybe with 1mm diameter holes?
[image](https://user-images.githubusercontent.com/48498823/172970257-c7032b68-617b-4e20-b3c0-2bd0feecb973.png)
Assignees
[@Qwerty-OFF](https://github.com/Qwerty-OFF)
Labels
GDI
<https://github.com/[rusefi/rusefi-hardware](https://github.com/rusefi/rusefi-hardware)|rusefi/rusefi-hardware>rusefi/rusefi-hardware | Yesterday at 9:09 PM | Added by [GitHub](https://rusefi.slack.com/services/B01UYCG442H)
https://github.com/rusefi/rusefi-hardware/issues/95

[Noxz](https://app.slack.com/team/UBFRN2SH0)
  [10:02 PM](https://rusefi.slack.com/archives/CFP3QAJCW/p1654826533116239)
dinner eaten.. time to remove a component at a time until I find the broken one?
[10:02](https://rusefi.slack.com/archives/CFP3QAJCW/p1654826545917139)
grantid I was just on INJ1/2, that narrows some of it down
[10:02](https://rusefi.slack.com/archives/CFP3QAJCW/p1654826568871629)
but if the boost fet (Q2) is blown, that is much harder to get to
[10:03](https://rusefi.slack.com/archives/CFP3QAJCW/p1654826584447659)
due to placement of capacitors
[10:05](https://rusefi.slack.com/archives/CFP3QAJCW/p1654826724185729)
so it's either channel 1, or the boost section... or the PT chip itself, etc etc.. could be a few things

[andrey](https://app.slack.com/team/U4PVDN5L7)
  [10:11 PM](https://rusefi.slack.com/archives/CFP3QAJCW/p1654827082812049)
my current state: injector clicks only once on bench, and green blinking turns into blue blinking
[10:11](https://rusefi.slack.com/archives/CFP3QAJCW/p1654827093876849)
bench test is supposed to click three times

[Noxz](https://app.slack.com/team/UBFRN2SH0)
  [11:16 PM](https://rusefi.slack.com/archives/CFP3QAJCW/p1654831002469689)
of course it was Q2 that was blown........
[11:16](https://rusefi.slack.com/archives/CFP3QAJCW/p1654831018796259)
this has happened before.. we need to figure out some better protection for it

[Noxz](https://app.slack.com/team/UBFRN2SH0)
  [2:11 AM](https://rusefi.slack.com/archives/CFP3QAJCW/p1654841471981629)
done soldering.. letting the board cool down before a re-attempt.. replaced Q2 with a BUK9230 from R0.3 board
[2:11](https://rusefi.slack.com/archives/CFP3QAJCW/p1654841516028589)
but I didnt just take Q2 off.. Q2 was basically the last thing I removed.. lessons learned should have been applied, but it's such a pain of a location to get the hot air gun into

[Noxz](https://app.slack.com/team/UBFRN2SH0)
  [2:41 AM](https://rusefi.slack.com/archives/CFP3QAJCW/p1654843265194659)
board does not seem to power on (when the fuse points are shorted with alligator leads) - but there is still plenty of resistance/non shorted on the 12v line (Q2 did not blow instantly)
[2:41](https://rusefi.slack.com/archives/CFP3QAJCW/p1654843272387709)
will look at it more tomorrow

[Noxz](https://app.slack.com/team/UBFRN2SH0)
  [2:58 AM](https://rusefi.slack.com/archives/CFP3QAJCW/p1654844280811869)
was testing out voltages on the regulators.. a small spark then the board powered up
[2:58](https://rusefi.slack.com/archives/CFP3QAJCW/p1654844307196049)
so maybe some back-charge from when I was testing continuity
[2:59](https://rusefi.slack.com/archives/CFP3QAJCW/p1654844342477199)
blinky blue..
[2:59](https://rusefi.slack.com/archives/CFP3QAJCW/p1654844374779819)
I did not continuity check the pins this round.. will do that tomorrow I think

[3:00](https://rusefi.slack.com/archives/CFP3QAJCW/p1654844417207479)
but yeah.. q2 fried

Message dev_di

mck1117, 2022-06-13:
Q2 protection wasn't the problem, problem was floating sense lines for the boost converter current sense, see #101

Closed 2022-06-13.

Thread 97 (2022-06-10):

Sense resisters for injectors should be 15mOhm, or settings altered

NOx-z, 2022-06-10:
all of these sense resistors for Rev A are 10mOhm whereas all of our previous versions are 15mohm (except for 10mOhm used on the boost converter sense, sense number 4). This has implications of incorrectly setting the expected peak-hold currents with our current settings.

solutions:
A) change settings for 10mOhm
b) swap resistors to 15mOhm

rusefillc, 2022-06-10:
let's alter microcode

@Qwerty-OFF just FYI - no HW changes needed

Thread 98 (2022-06-11):

GDI4 revisit D10

rusefillc, 2022-06-11:
@NOx-z says "while comparing datasheets from current parts vs legacy, D10 - the old part SBR10200CT is a 200v diode vs the new MBRD10100CT is 100v - which is worth having a head note as we brush up against that 100v rail"

@mck1117 @NOx-z @Qwerty-OFF is this OK or not OK?

Qwerty-OFF, 2022-06-11:
I see MBRD10100CTTR in last BOM version of CommonRail board
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

mck1117, 2022-06-14:
I'm actually okay with the ratings on that part - I see no real issue. That diode only sees ~75v max with our 65v rail, and that's enough headroom for me to be happy.

Closed 2022-07-18.

Thread 99 (2022-06-11):

Let's spell out all differences between GDI boards

rusefillc, 2022-06-11:
PT200x need firmware and hardware to work together for proper results, unfortunatelly boring details seem to matter

@Qwerty-OFF please write a report on BOM and schematics differences between GDI4 rev A and https://github.com/rusefi/rusefi/tree/master/hardware/Common_Rail_MC33816

rusefillc, 2022-06-11:
See https://github.com/rusefi/rusefi-hardware/issues/98
See https://github.com/rusefi/rusefi/issues/4251

Qwerty-OFF, 2022-06-11:
| Description  | GDI4 rev. A part  |  CommonRail part |
|---|---|---|
| All n-channel MOSFETs  | NCE0140KA_C194346  | IRLR3110ZTRPBF_C67277  |
| Boost inductor  |  BCIHP1770-100M_C237980 | IHLP6767GZER100M01 (not sure, non-JLC)   |
| Filter inductor  | MS1350-6R8M_C380073  | 744710610 (not sure, non-JLC)  |
| Output diodes | MBRD10100CTTR_C135494 | STTH802G-TR_C181034 |

Large electrolytic capacitors have been replaced with several small capacitors
Also possibly changed cases of small parts from 0805 to 0603

mck1117, 2022-06-11:
What's the ESR difference on the caps?

Did sense resistor values change?

Qwerty-OFF, 2022-06-11:
Old caps: UHE2A391MHD (390 uF), SLPX102M100A3P3 (1000 uH)
New caps: VKMI1701K391MV_C487421

Sense resistors not changed

rusefillc, 2022-06-11:
@Qwerty-OFF see linked tickst on 10m vs 15m

Qwerty-OFF, 2022-06-11:
I see this in CommonRail BOM:
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
All sense resistors is 10mOhm

mck1117, 2022-06-12:
I remember now - we standardized on 10mOhm on the last rev of the old board. Let's stay with 10m on all.

mck1117, 2022-06-13:
Fixed by #101

Closed 2022-06-13.

Thread 101 (2022-06-13):

split resistor pads are very error-prone

rusefillc, 2022-06-13:
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

note how resistors flow to one side and leave second part of the pad disconnected!

what is this evil pattern of split pad?! why and how?!

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

rusefillc, 2022-06-13:
Affected parts:

R21 R22 R22 R26

Qwerty-OFF, 2022-06-15:
On the CommonRail board, the shunts were connected incorrectly. A separate conductor must go from the GND pad of the shunt to the chip. As you can see, I made a separate pin for this, but the resistor moved to a larger pad when soldering.

Now the measuring contact is in the middle and the resistor should not move.

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

mck1117, 2022-06-15:
That still has potential for mfg errors. Why not just route a trace to the inside of the resistor?

rusefillc, 2022-06-15:
For mfg we want two pads of copper, not three not 6.

@Qwerty-OFF point is that kicad would be very confused in terms of DRC if coppers are connected, effectively being connected to GND

I wonder if we need to learn how to kicad this

mck1117, 2022-06-15:
DRC actually doesn't care. You can have two touching pads no problem. It comes out as a single piece of copper.

Qwerty-OFF, 2022-06-15:
Figured out how to get KiCAD to connect two pads with different nets in the same footprint without DRC issues. We can applaud the developers of KiCAD for having a special keyword for this.
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

Now definitely no soldering problems

Closed 2022-06-15.

Thread 102 (2022-06-14):

PT2000 board to have a HW mode to drive 8 injectors

rusefillc, 2022-06-14:
technically PT2000 can drive x8 of injectors instead of driving fuel pump

let's have flexibility via HW jumpers if jumpers are needed

rusefillc, 2022-06-14:
open question of x8 injectors should be the default HW config

Qwerty-OFF, 2022-06-15:
Can not. There are only two drivers in the pump bank: High Side and Low Side. The bank of injectors contains four: two High Side and two Low Side.
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

rusefillc, 2022-06-15:
@NOx-z ?

mck1117, 2022-06-15:
IMO the 6ch is a mistake in the first place.

But. That again seems like unnecessary complexity - why do we want to make our lives more difficult doing that? Why not run two 4ch boards on a v8?

rusefillc, 2022-06-15:
Pt2001 board is PnP into 760 test mule harness

mck1117, 2022-06-15:
> Pt2000 board is PnP into 760 test mule harness

sure - seems like we should do 100/200/500 miles on VW 4cyl before spinning another very similar board that will have the same problems we detect (if any) on the 4ch.

NOx-z, 2022-06-15:
Any High-Side driver can be used as Low-Side. This is true for the PT2001/MC33816 as well.
The PT2000 mentions this in the datasheet at (page 41 in pdf):
`6.3.3 High-side pre-drivers in low-side configuration`
and all drivers are accessible by any channel/core, but there are some special situations where only the dc-dc boost is applicable.

a configuration of 2 banks would include using 2 high side drivers per, as high side drivers (typical vboost and vbat) , and then a total of 4 more drivers (mix of high side + low side).

the PT2001 can use the 'fuel pump' drivers in order to drive 6 total cylinders, and no 'pump'/fuel limiting valve'

rusefillc, 2022-06-15:
See also #106

rusefillc, 2022-06-15:
@mck1117 i can agree to one mile. I am a believer in separation of responsibilities, once it did a mile i would need others to step in

mck1117, 2022-06-15:
seeing as nobody else owns a GDI vehicle they're willing to ecu swap - that separation of responsibilities (as you call it) would require you buying me a car

rusefillc, 2022-06-15:
I like that plan!

rusefillc, 2024-10-04:
> sure - seems like we should do 100/200/500 miles on VW 4cyl before spinning another very similar board that will have the same problems we detect (if any) on the 4ch.

@ElDominio I know you've made a dyno video about GDI Hyundai but do you know if any of those have put any miles?

Thread 103 (2022-06-14):

open and shorted injector state via CAN

rusefillc, 2022-06-14:
too short or too long boost phase means open or shorted injector? please report such error conditions via CAN

rusefillc, 2022-08-14:
NXP now knows about injector issues with https://github.com/rusefi/rusefi/pull/4363

@NOx-z @mck1117 can you please relay status info from NXP into stm32F1?

Thread 105 (2022-06-15):

JLC assembly error of U4

NOx-z, 2022-06-15:
U4 is supposed to be hc14, a hex inverter, but on at least one board it is instead a TP6004, which is also [correctly] located at U6

NOx-z, 2022-06-15:
image

NOx-z, 2022-06-15:
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

Thread 106 (2022-06-15):

PT2001 board to run 6 injectors

rusefillc, 2022-06-15:
Can a pt2001 board run six equal injectors without pump control?

mck1117, 2022-06-15:
but why?

rusefillc, 2022-06-15:
E66 760

NOx-z, 2022-06-30:
my first suggestion, before really looking over it, is to rename it as `GDI-6ch`

rusefillc, 2022-06-30:
yep, naming convention is a mess. but for now we need to look at it :)

NOx-z, 2022-06-30:
Original file no longer exists.. I do see a 6ch folder now existing, but no gerbers generated yet

rusefillc, 2022-06-30:
@NOx-z just edited link

NOx-z, 2022-06-30:
I was expecting HS1/2 to drive LS1/2/3 and HS3/4 to drive LS4/5/6 (or a similar mapping -- edit, it appears HS1/2 is driving LS1/2/5, and HS3/4 is driving LS3/4/6 - and this is okay, but it reads a bit more scatter-brain/using the old mappings and adding onto)

are we making this more variable? like have it selectable as either 4+Pump _OR_ 6 via jumpers/0R, so we have a single board capable of both?

HS5 needs not be in the circuit if no pumping is desired. (I can double check the datasheet, if it wants the pins floating or tied to ground or whatever)
VSENSE3(P/N) needs not be connected/populated, if that microcore is never used for regulation since VSENSE1/2 should take care of the rest. I do not know if microcores can share highside drivers, in which case we want to only drive HS1/2 from the one specific microcore (and thus sense only on one).. but this changes if we want some configurability in there, and I was not aware of that being a goal.. if it is I need to review it as such.

rusefillc, 2022-06-30:
> like have it selectable as either 4+Pump OR 6 via jumpers/0R, so we have a single board capable of both?

yes that's the desire

NOx-z, 2022-06-30:
Okay, let me look it over more with that in mind.. as I did not immediately see where this was done.. immediately I think a big issue will be what is allowed configuration wise and the number 3 sense resistor, and how best to accommodate it.

mck1117, 2022-06-30:
do we think 2 banks is enough to run a 6cyl given the overlapping restrictions?

mck1117, 2022-06-30:
> To me it would make more sense to have INJ5/6 [low sides] tie back to VSENSE1/2 in some jumper manner

Yes - I would much rather see additional transistors with jumpers for both the gate and sense resistor that tie the extra channels in to the same sense resistors as the other injectors as their bank. The current implementation would require much more change to the microcode, as you said.

mck1117, 2022-06-30:
Ok, after some discussion with nozx on slack, here's my proposal.  The current implementation has a problem that firing injector 5 or 6 actually blocks 3 other injectors - since those injectors straddle multiple banks of current sense. Injector 5 blocks injector 6 since it shares a current sense, but it ALSO blocks injectors 1/2 since it shares high side circuitry with them. Likewise, 6 blocks 3/4/5.

These changes also greatly simplify the needed microcode changes.

Proposed changes:
- Source of Q1 connects to R21 instead of R26. This covers injector 5. Injectors 1/2/5 use LS1/2/5 respectively, and all use VSENSE1 for current feedback.
- Add an additional transistor Qx, for injector 6 low side. Selectable jumper between D_LS6 and the drains of Q12 and Qx. In case of pump, install jumper to Q12. In case of injector, install jumper to Qx. Drain goes to R22, shared with channels 3/4. Injectors 3/4/5 use LS3/4/6 respectively, and all use VSENSE2 for current feedback.

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

mck1117, 2022-06-30:
With this proposal you can actually run a 5 cylinder with pump (1/2/5 + 3/4), and it only requires moving the single jumper to connect D_LS6 properly.

Qwerty-OFF, 2022-07-03:
@mck1117 can I use single Q12 (without Qx) for PUMP_LOW/INJ6_LOW with this jumpers config?
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

mck1117, 2022-07-04:
For the cost of an extra transistor and diode (<$2?), I'd much rather optimize for the minimum possible number of jumpers that you have to flip.  My crappy drawing above only has one jumper to move, while that proposal has 3. Any incorrect combination of jumpers would have unexpected behavior, and could possibly injure the PT2001 and/or transistors.

Qwerty-OFF, 2022-07-04:
I wanted to save some space and make routing easier. And also reduce gate capacitance, if this is critical here. Okay, I'll place an additional transistor if it improves the user experience.

Thread 109 (2022-06-25):

GDI4 thermal

rusefillc, 2022-06-25:
15A peak 5A hold they say, do we need another round of thermal considerations on the PCBs or are we good?

rusefillc, 2022-07-01:
10 minutes of idle
ambient 24C
board max 36C

```
	// Convert mA to DAC values
	mcUpdateDram(MC33816Mem::Iboost, dacEquation(13000));
	mcUpdateDram(MC33816Mem::Ipeak, dacEquation(9400));
	mcUpdateDram(MC33816Mem::Ihold, dacEquation(3700));
```

I assume 13A boost, 9.4A peak 3.7A hold?

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

mck1117, 2022-07-01:
> I assume 13A boost, 9.4A peak 3.7A hold?

if you're running latest firmware, yes

mck1117, 2022-07-01:
The fact that the PCB is cold over here probably means we need better thermals on the MOSFETs themselves

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

Thread 111 (2022-06-28):

F103 single channel rev3 epic

rusefillc, 2022-06-28:
https://github.com/rusefi/rusefi-hardware/tree/main/wideband-F103

* 26 пиновый корпус #112
* external osc #113
* BT https://github.com/rusefi/rusefi-hardware/issues/58
* analog output progress #72
* схема питания как в x2 - питание на подогреватель не заходит в блок? см. https://github.com/rusefi/rusefi-hardware/tree/main/lambda-x2
* replace huge fuse with SMD fuse 1A
* буфер - триггер Шмидта с диодами в обе стороны и вывести на разъём четыре свободных пина в качестве цифровых входов (stm32 сгорит, если будет больше 5ти вольт. хочется чтоб можно было подавать +12 вольт на цифровые входы по ошибке или даже специально, а stm32 чтоб получал 5)

rusefillc, 2022-07-31:
У нас есть место для более JLC версии триггеров шмитда? защищённый с обеих сторон 74HC2G17GW в JLC отсутствует

см. https://github.com/rusefi/alphax-4chan/issues/49

и если надо у нас всё-таки есть выемка на задней стороне частичная

rusefillc, 2022-08-07:
SN74LVC1G06DBVR should be C840103

Closed 2022-10-02.

Thread 112 (2022-06-28):

move F103 wideband into 26 pin case

rusefillc, 2022-06-28:
https://github.com/rusefi/rusefi-hardware/tree/main/wideband-F103 to Boschun 26 pin case and connector

Closed 2022-07-28.

Thread 114 (2022-06-30):

We have GDI4-rev-C fab files

rusefillc, 2022-06-30:
We have GDI4 rev C fab files ready for review https://github.com/rusefi/rusefi-hardware/tree/main/GDI-4ch

See https://github.com/rusefi/rusefi/wiki/GDI4#changelog for why "rev C"

rusefillc, 2022-07-08:
@mck1117 @NOx-z we have fresh fab files at https://github.com/rusefi/rusefi-hardware/tree/main/GDI-4ch/gerber/rev.%20c including https://github.com/rusefi/rusefi-hardware/blob/main/GDI-4ch/gerber/rev.%20c/GDI-4ch.pdf

NOx-z, 2022-07-08:
The 5Inj+Pump/6Inj schematic seems to read correctly..

a few points that have been discussed but likely lost within chat.

A) I would like to see test points on all (6) the START lines between the asic and the inverter, these can be surface mount (through-hole not needed).

B) Resistor Networks have accumulated solder between leads before, and there was some mild discussion on converting all of these over to standard/non-network resistors.

C) Can we tie the Vcc2P5, pin 20, (actually, the MC33816 is 2.5v, but the PT2001 is 1.5v) to an analog input of the IC? This would be the preferred way to check that the chip has self-powered/regulated instead of a blind wait period that we currently implement in code.

for layout purposes:
D) do not put Q2 in between large capacitors, this is the most common fet to blow and replacement can be difficult

E) please align/group similar test points in straight lines/groups, for instance the SPI test through holes were not aligned in rev A

There are likely more, but these are the ones that come to mind as of right now.

Qwerty-OFF, 2022-07-10:
> Can we tie the Vcc2P5, pin 20, (actually, the MC33816 is 2.5v, but the PT2001 is 1.5v) to an analog input of the IC? This would be the preferred way to check that the chip has self-powered/regulated instead of a blind wait period that we currently implement in code.

Low-side 1 output moved to PB8 to free analog input.

Qwerty-OFF, 2022-07-18:
A) done
B) done
C) done
D) done
E) Done as well as possible without major rework
Ready for fab

rusefillc, 2022-08-05:
fabbed

Closed 2022-08-05.

Thread 115 (2022-07-08):

remove GDI-4ch/hellen-one

rusefillc, 2022-07-08:
we have two references to https://github.com/andreika-git/hellen-one

let's keep only the global shared one ``path = hellen-one`` and remove ``path = GDI-4ch/hellen-one``

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

rusefillc, 2022-07-08:
общая копия переехала в папку ext

Qwerty-OFF, 2022-07-08:
Fixed

Closed 2022-07-08.

Thread 116 (2022-07-08):

openblt for SENT

rusefillc, 2022-07-08:
к голубой плате Blue Pill припаян GD32 & CAN tranciever https://stm32-base.org/boards/STM32F103C8T6-Blue-Pill.html

у тебя есть [CANable z pro](https://rusefi.com/forum/viewtopic.php?f=13&t=2209) в котором прошивка заменена на PCAN

шаг 1: поставить драйвер https://github.com/rusefi/rusefi_external_utils/blob/master/CAN/PEAK-System_Driver-Setup.zip
шаг 2: поставить утилиту https://www.peak-system.com/PCAN-View.242.0.html?&L=1 просто чтоб было

этот репозиторий уже ссылается на openblt - https://github.com/rusefi/rusefi-hardware/blob/main/.gitmodules

официально про него читать https://github.com/feaser/openblt - там есть ссылка на release включая Windows утилиты

шаг 3: закончить папку конфигурации openblt в проект https://github.com/rusefi/rusefi-hardware/tree/main/SENT-box/firmware в стиле https://github.com/dron0gus/wideband/tree/master/firmware/boards/f1_rev2/openblt
шаг 4: сделать скрипт компиляции openblt версий бинарника https://github.com/rusefi/rusefi-hardware/blob/main/SENT-box/firmware/compile_with_openblt.sh в стиле https://github.com/dron0gus/wideband/blob/master/firmware/boards/common_make.sh

шаг 5: успешно прошить по UART в качестве теста?
шаг 6: успешно, надёжно и стабильно прошить по CAN с Windows используя openblt утилиты из релиза openblt

Closed 2022-07-18.

Thread 118 (2022-07-10):

shall we use external osc

rusefillc, 2022-07-10:
Does GDI4 board need an external oscillator on F103 for instance for happier CAN connectivity?

mck1117, 2022-07-11:
GD32 says

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

STM32F042 says

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

STM32F103 says

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

mck1117, 2022-07-11:
seems like conventional wisdom on the internet is +-0.25% accuracy for CAN

Qwerty-OFF, 2022-07-18:
Added in gdi-4ch

Closed 2022-07-18.

Thread 120 (2022-07-18):

GD32 ADC start-up timing

rusefillc, 2022-07-18:
GD32 ADC start-up has a specific timing requirment which ChibiOS does not fulfil

At the moment our work around is to set opimization level to none

we shall hack ChibOS maybe even by adding "isGd32 judging by newer ARM kernel version" runtime check

rusefillc, 2022-07-31:
See https://rusefi.com/forum/viewtopic.php?p=44933#p44933 [compatibility sumup between GD32 and STM32_V2.0.pdf](https://rusefi.com/forum/download/file.php?id=9403)

7. ADC collection

ADC Sampling settings
describe ADC start-up
resolvent There are three aspects

When ADON=0 Write on 1 after , Need to wait for a while t_WAIT, If you use ST Ku's words
It's just ADC_CMD Back plus 20us Left and right delay .

If interrupt is used to obtain sampling data , Need software to clear interrupts .

rusefillc, 2022-07-31:
Kind of relevant https://github.com/rusefi/rusefi-hardware/issues/127

rusefillc, 2022-07-31:
See https://github.com/rusefi/ChibiOS/commit/0ce1cbd649f4bb2d9db941e729d3308b247b8696 for real stm32 check

Thread 121 (2022-07-18):

WBO, WBOx1: reduce i2c pull-up

rusefillc, 2022-07-18:
подтяжики на i2c надо бы уменьшить, если мы хотим fast mode "less than 1 kΩ for High
Speed mode (3.4 MHz).". И надо точно проверить, выдержит ли stm32/gd32 5В на этих пинах. вроде должен. но это не точно.

Thread 122 (2022-07-18):

WBO, WBOx1: DAC output buffer op-amp gain

rusefillc, 2022-07-18:
we shall power DAC with 5v

we need gain of 1 now that we use a 5v DAC

Ringenium, 2022-07-31:
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

Since the DAC of the microcontroller was used, the buffer gain remains the same x1.524

Closed 2022-07-31.

Thread 123 (2022-07-18):

WBO, WBOx1: REF3033 shortcut option

rusefillc, 2022-07-18:
добавить (неустанавливаемую) 0R перемычку между VDDA и +3.3V, чтобы мы могли сэкономить на REF3033. А лучще дроссель. какой - можно посмотреть в rusefi-hardware/lambda-x2

Ringenium, 2022-07-31:
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

Inductance coil L1 is installed

Closed 2022-07-31.

Thread 125 (2022-07-18):

GDI board: dual digital input

rusefillc, 2022-07-18:
We still have three available pins

Can we please have two channels of protected digital inputs? Probably old friend 74HC2G17GW https://github.com/rusefi/proteus/issues/1

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

Qwerty-OFF, 2022-07-21:
Added 4 external channels. Also made jumpers to use the MCU I/O for other purposes.

rusefillc, 2022-07-22:
looking to have at least one DIN as a HW timer, meaning

PA6 MISO totally cannot touch this one
PA8 kind of can touch but let's not touch to keed firmware compatible between revisions
PB6 LS2 let's flip between LS2 and any of the DIN
PA1 currently VCC2P5

please do at least one of the following changes maybe both if small effort

1) PB6 LS2 let's flip between LS2 and any of the DIN
2) VCC2P5 move to any other A* pin and make PA1 a hardware jumper option between A* and DIN, that way we can leave one of current DIN pins as just a via for future use

speaking of which can we please have a via or test pad on some of DIN* and A* to have an option to repurpose those if needed. Just a couple, via would be better, please use your judgement based on level of effort

Qwerty-OFF, 2022-07-22:
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

Closed 2022-07-22.

Thread 126 (2022-07-28):

F103 single: silk

rusefillc, 2022-07-28:
please add at least on one side of the PCB
"https://rusefi.com/s/wb"
"F103 single rev3"

rusefillc, 2022-08-05:
@Ringenium please close if/when silkscreen text

"https://rusefi.com/s/wb"
"F103 single rev3"

is added on any side of the PCB

Ringenium, 2022-08-08:
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

Added silkscreening

Closed 2022-08-08.

Thread 127 (2022-07-31):

32F103 F103 availability at JLC

rusefillc, 2022-07-31:
https://jlcpcb.com/parts/componentSearch?isSearch=true&searchTxt=32F103

rusefillc, 2022-07-31:
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

rusefillc, 2022-08-07:
I have https://github.com/rusefi/libfirmware/blob/master/stm32-util/mcu-util.h

I have a board assembled by JLC with [C8304 ](https://jlcpcb.com/partdetail/Stmicroelectronics-STM32F103CBT6/C8304)

that JLC board with C8304 returns 0x2003

so far the other F103 in my collection returns 0x1000. So far I have not seen 0x1001.

kind of related to https://github.com/rusefi/ChibiOS/commit/0ce1cbd649f4bb2d9db941e729d3308b247b8696

need to find a GD32 so fab do not see any maybe will mod one more blue pill into GD32 right now

@dron0gus FYI

rusefillc, 2022-08-07:
@dron0gus i have  https://github.com/rusefi/libfirmware/commit/a5f25778d3c48dd04ea4dde6b2163c5ec160aba3
```
#define REAL_GD_F1_REV_CODE 0x1303
```

Thread 128 (2022-08-04):

Gdi4: lower caps are hitting case

rusefillc, 2022-08-04:
Stamped case has this area in the middle which interferes with the lower two caps

Minir hammer mod helps so we need to move just a bit or reduce caps height?

rusefillc, 2022-08-04:
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

Qwerty-OFF, 2022-08-05:
Sad result due to edits https://github.com/rusefi/rusefi-hardware/issues/114
So we need to move capacitors

rusefillc, 2022-08-05:
Would @Qwerty-OFF non-JLC lower caps exist to try in same location? i am fine hand-soldering those two caps

Qwerty-OFF, 2023-05-13:
2x UBY1K471MHL (JLC C5110766 out of stock) - 470uF 80V
2x UPW1V122MHD6TN (JLC C5111952 out of stock) - 1200uF 35V
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
@rusefillc please check placement

rusefillc, 2023-05-14:
UPW1V122MHD6TN is pretty available https://www.findchips.com/search/UPW1V122MHD6TN

rusefillc, 2023-05-14:
@Qwerty-OFF placement looks great!

Thread 129 (2022-08-05):

Gdi4revB: reset button does not reset

rusefillc, 2022-08-05:
looks like reset button does not reset MCU for me at least on one unit

Qwerty-OFF, 2022-08-05:
Check with a multimeter that there 0V when you press RST button
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

rusefillc, 2022-08-08:
it was a soldering defect on the first board I've touched - one of button sides was not soldered

Closed 2022-08-08.

Thread 130 (2022-08-06):

gdi4-revB: 5v confusion

rusefillc, 2022-08-06:
Q1: what is pin11? schematics says nothing, PCB maybe says 5v?

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

Q2: those 5v pins let's clarify on schematics that those are +5v _outputs_ (assuming those are outputs? while playing we can use as inputs but that's not the primary indented use?)

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

Qwerty-OFF, 2022-08-07:
Q1:
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
Q2: how? Like this?
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

rusefillc, 2022-08-07:
супер!

let's do "output". то же самое для пина 11?

Qwerty-OFF, 2023-05-13:
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

Closed 2023-05-13.

Thread 131 (2022-08-06):

DIN1 resistors clarification

rusefillc, 2022-08-06:
with both R113 and R122 populated do we have DIN1 traced to two different stm32 pins by default?

also R113 state "0" while R122 is yellow without a value not, that's a bit confusing

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

Qwerty-OFF, 2022-08-07:
In this configuration, DIN1 is connected to two different stm32 pins. To connect A0, just remove R122 and put R121, DIN1 will remain connected to PC13 (which does not have a timer).
R122 is a jumper with soldering holes, so it's yellow. In the future we can use yellow resistors like in hellen boards

rusefillc, 2023-05-14:
Can we add DNP on R122 to make schematics more readable?

Let's add "Use R122 option without R113 for SENT"

Qwerty-OFF, 2023-05-14:
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

Qwerty-OFF, 2023-05-14:
R122 now populated
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

Closed 2023-05-14.

Thread 133 (2022-08-07):

F103 WBO BOM

rusefillc, 2022-08-07:
need PN for BAT54S

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

rusefillc, 2022-08-07:
мы добавили диоды, потому что защищённый триггер не купить

нужно заменить PN триггера на SN74LVC1G06DBVR C840103

Ringenium, 2022-08-08:
Исправил

Closed 2022-08-08.

Thread 135 (2022-08-07):

Dual WBO dev comfort - SWD TC2030 and 0.1" header

rusefillc, 2022-08-07:
TC2030 is amazing. Dual should have TC2030

the tiny 2x7 connector is hard to purchase and solder, dual WBO should also have plain SWDIO and SWDCLK as boring 0.1" header

dron0gus, 2023-02-25:
TC2030 is added in Rev1 https://github.com/rusefi/rusefi-hardware/pull/180

Closed 2023-02-25.

Thread 137 (2022-08-08):

SENT: without power we see 10% success rate

rusefillc, 2022-08-08:
ETB connected with two wires: GND and signal wire

ETB +5v is NOT connected ANYWHERE

note a lot of 04 and 12 nibbles what is special about those?

```
[0] 04 04 04 04 04 04 ETB 1220 1092 pos=076 err 028320 001896 s_e=021281 c_err=001174 sync=024508 rate=0087
[0] 12 12 12 04 04 12 ETB 1220 1092 pos=076 err 028507 001904 s_e=021407 c_err=001183 sync=024652 rate=0087
[0] 12 04 04 12 04 04 ETB 1220 1092 pos=076 err 028672 001911 s_e=021518 c_err=001191 sync=024786 rate=0087
[0] 04 04 12 04 04 04 ETB 3148 1220 pos=017 err 028832 001917 s_e=021649 c_err=001200 sync=024911 rate=0087
[0] 04 12 04 04 12 04 ETB 3148 1220 pos=017 err 028988 001928 s_e=021730 c_err=001209 sync=025034 rate=0087
[0] 12 04 04 12 04 12 ETB 3148 1220 pos=017 err 029136 001938 s_e=021863 c_err=001213 sync=025170 rate=0087
[0] 04 12 04 12 04 04 ETB 3148 1220 pos=017 err 029251 001952 s_e=021973 c_err=001220 sync=025306 rate=0087
[0] 12 12 12 12 04 12 ETB 3148 1220 pos=017 err 029358 001964 s_e=022092 c_err=001225 sync=025423 rate=0087
[0] 12 12 04 12 12 04 ETB 3268 1228 pos=013 err 029461 001976 s_e=022174 c_err=001234 sync=025542 rate=0087
[0] 12 12 12 12 04 04 ETB 3268 1228 pos=013 err 029592 001986 s_e=022273 c_err=001243 sync=025652 rate=0087
[0] 04 12 04 04 04 04 ETB 3268 1228 pos=013 err 029700 001997 s_e=022375 c_err=001251 sync=025769 rate=0087
[0] 12 12 04 12 12 04 ETB 3268 1228 pos=013 err 029796 002008 s_e=022458 c_err=001259 sync=025891 rate=0087
[0] 12 12 04 04 12 12 ETB 3268 1228 pos=013 err 029904 002024 s_e=022581 c_err=001263 sync=026009 rate=0087
[0] 12 12 04 12 12 04 ETB 3268 1228 pos=013 err 029998 002039 s_e=022664 c_err=001270 sync=026119 rate=0087
[0] 04 04 04 04 04 04 ETB 3268 1228 pos=013 err 030091 002051 s_e=022755 c_err=001279 sync=026220 rate=0086
[0] 12 12 04 04 04 04 ETB 3268 1228 pos=013 err 030190 002065 s_e=022829 c_err=001285 sync=026326 rate=0086
[0] 12 12 04 12 12 04 ETB 3268 1228 pos=013 err 030292 002081 s_e=022915 c_err=001294 sync=026431 rate=0086

```

rusefillc, 2022-08-08:
@
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

rusefillc, 2022-08-08:
apply constant 1.4V from power supply to PA6

actual result: enjoy all nibbles of 04
expected result: no PAL events thus no data

```

[0] 04 01 04 12 04 04 ETB 1220 1092 pos=076 err 2831646 089553 s_e=688374 c_err=040238 sync=819172 rate=0084
[0] 04 01 04 12 04 04 ETB 1220 1092 pos=076 err 2834588 089553 s_e=688405 c_err=040238 sync=819196 rate=0084
[0] 04 01 04 12 04 04 ETB 1220 1092 pos=076 err 2837580 089553 s_e=688439 c_err=040238 sync=819236 rate=0084
[0] 04 01 04 12 04 04 ETB 1220 1092 pos=076 err 2840606 089553 s_e=688470 c_err=040238 sync=819274 rate=0084
[0] 04 01 04 12 04 04 ETB 1220 1092 pos=076 err 2843628 089553 s_e=688512 c_err=040238 sync=819320 rate=0084
[0] 04 01 04 12 04 04 ETB 1220 1092 pos=076 err 2846585 089553 s_e=688555 c_err=040238 sync=819349 rate=0084
[0] 04 01 04 12 04 04 ETB 1220 1092 pos=076 err 2849670 089553 s_e=688585 c_err=040238 sync=819376 rate=0084
[0] 04 01 04 12 04 04 ETB 1220 1092 pos=076 err 2852690 089553 s_e=688618 c_err=040238 sync=819415 rate=0084
[0] 04 01 04 12 04 04 ETB 1220 1092 pos=076 err 2855746 089553 s_e=688653 c_err=040238 sync=819457 rate=0084
[0] 04 01 04 12 04 04 ETB 1220 1092 pos=076 err 2858771 089553 s_e=688694 c_err=040238 sync=819502 rate=0084
[0] 04 01 04 12 04 04 ETB 1220 1092 pos=076 err 2861729 089553 s_e=688736 c_err=040238 sync=819531 rate=0084
[0] 04 01 04 12 04 04 ETB 1220 1092 pos=076 err 2864718 089553 s_e=688765 c_err=040238 sync=819558 rate=0084
[0] 04 01 04 12 04 04 ETB 1220 1092 pos=076 err 2867710 089553 s_e=688802 c_err=040238 sync=819600 rate=0084
[0] 04 01 04 12 04 04 ETB 1220 1092 pos=076 err 2870782 089553 s_e=688835 c_err=040238 sync=819636 rate=0084
[0] 04 01 04 12 04 04 ETB 1220 1092 pos=076 err 2873810 089553 s_e=688875 c_err=040238 sync=819684 rate=0084
[0] 04 01 04 12 04 04 ETB 1220 1092 pos=076 err 2876860 089553 s_e=688919 c_err=040238 sync=819716 rate=0084
[0] 04 01 04 12 04 04 ETB 1220 1092 pos=076 err 2879847 089553 s_e=688952 c_err=040238 sync=819743 rate=0084
[0] 04 01 04 12 04 04 ETB 1220 1092 pos=076 err 2882812 089553 s_e=688986 c_err=040238 sync=819785 rate=0084
[0] 04 01 04 12 04 04 ETB 1220 1092 pos=076 err 2885880 089553 s_e=689021 c_err=040238 sync=819822 rate=0084
[0] 04 01 04 12 04 04 ETB 1220 1092 pos=076 err 2888945 089553 s_e=689064 c_err=040238 sync=819872 rate=0084
[0] 04 01 04 12 04 04 ETB 1220 1092 pos=076 err 2891952 089553 s_e=689104 c_err=040238 sync=819900 rate=0084
[0] 04 01 04 12 04 04 ETB 1220 1092 pos=076 err 2894984 089553 s_e=689136 c_err=040238 sync=819928 rate=0084
[0] 04 01 04 12 04 04 ETB 1220 1092 pos=076 err 2897996 089553 s_e=689169 c_err=040238 sync=819967 rate=0084
[0] 04 01 04 12 04 04 ETB 1220 1092 pos=076 err 2901080 089553 s_e=689201 c_err=040238 sync=820002 rate=0084
[0] 04 01 04 12 04 04 ETB 1220 1092 pos=076 err 2904130 089553 s_e=689241 c_err=040238 sync=820049 rate=0084
[0] 04 01 04 12 04 04 ETB 1220 1092 pos=076 err 2907063 089553 s_e=689284 c_err=040238 sync=820081 rate=0084
[0] 04 01 04 12 04 04 ETB 1220 1092 pos=076 err 2910043 089553 s_e=689316 c_err=040238 sync=820108 rate=0084
[0] 04 01 04 12 04 04 ETB 1220 1092 pos=076 err 2913013 089553 s_e=689346 c_err=040238 sync=820144 rate=0084
[0] 04 01 04 12 04 04 ETB 1220 1092 pos=076 err 2916088 089553 s_e=689378 c_err=040238 sync=820183 rate=0084
[0] 04 01 04 12 04 04 ETB 1220 1092 pos=076 err 2919168 089553 s_e=689422 c_err=040238 sync=820234 rate=0084
[0] 04 01 04 12 04 04 ETB 1220 1092 pos=076 err 2922152 089553 s_e=689467 c_err=040238 sync=820262 rate=0084
[0] 04 01 04 12 04 04 ETB 1220 1092 pos=076 err 2925126 089553 s_e=689500 c_err=040238 sync=820295 rate=0084
```

rusefillc, 2022-08-08:
https://electronics.stackexchange.com/questions/394846/stm32-logic-level-high-and-low-thresholds

```
The logic levels are described in section 6.3.14. When your supply voltage is 3.3V then:

V_IL = 0.39 * Vcc - 0.06 = 1.23 V (table row "I/O input low level voltage except BOOT0". The maximum voltage that will be read as logical zero is 1.23V (+ read all footnotes).

V_IH = 0.49 * Vcc + 0.26 = 1.88 V (table row "I/O input high level voltage except BOOT0"). You need to supply at lest 1.88 V to make the pin read as logical one.

Your 1.8 V signal is below V_IH and above V_IL, which means that the result is unpredictable.
```

so on the one had 1.4 is unpredictable

problem: I get unhappy results with 0.5v as well

rusefillc, 2022-08-08:
@dron0gus very tempting to ask for a bit of help :(

https://github.com/rusefi/rusefi-hardware/tree/main/SENT-box/firmware
master
blue pil

SENT input pin first channel PA6 as defined at https://github.com/rusefi/rusefi-hardware/blob/main/SENT-box/firmware/io/io_pins.h

UART connectivity on the bottom of same https://github.com/rusefi/rusefi-hardware/blob/main/SENT-box/firmware/io/io_pins.h

default FW uses PAL input

majority of code at https://github.com/rusefi/rusefi-hardware/blob/main/SENT-box/firmware/sent.cpp with UART logging at https://github.com/rusefi/rusefi-hardware/blob/main/SENT-box/firmware/uart.cpp

dron0gus, 2022-08-10:
FIY: PA6 and PA7 are not 5V tolerant pins. Pulling it to 5V may damage device.
PB4 and PB5 have same TIM3 functions. but 5V tolerant.

Thread 138 (2022-08-08):

F103 is everything OK with drills?

rusefillc, 2022-08-08:
usually I see some holes on the preview

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

please double-check that we have drill file

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

rusefillc, 2022-08-08:
https://github.com/rusefi/rusefi-hardware/commit/cacfa945b7b2779efa24ad6a096efd5eadc0400f

Closed 2022-08-08.

Thread 140 (2022-08-11):

GDI4: bleeder resistor for capacitors

mck1117, 2022-08-11:
Needs one resistor on each HV rail and 12v rail so that capacitors discharge under 10v in 10 seconds.

mck1117, 2022-08-11:
Currently, with just the LED and capacitor leakage, it takes 93 seconds for 65v to bleed down below 10v.

mck1117, 2022-08-11:
For 12v rail (`+Batt_filtered`), recommend 1k ohm to ground, rated for at least 0.5 watt.

For `Vdrive` rail to `Vdrive_shunt`, recommend 6.8k resistor rated for at least 1 watt.

Qwerty-OFF, 2023-05-13:
Done. Thanks for the calculations

Closed 2023-05-13.

Thread 141 (2022-08-11):

GDI4: pulldown resistors on critical signals

mck1117, 2022-08-11:
RESETB, DRVEN, and flag0 need 1k pulldown resistors to assert predictable state during reset/programming/boot etc.

Qwerty-OFF, 2023-05-13:
Done

Closed 2023-05-13.

Thread 142 (2022-08-11):

GDI: replace R38 with 220 ohms

mck1117, 2022-08-11:
Current 5.1 doesn't do anything useful to damp oscillation on boost converter turn-off, but 220 works very well.

mck1117, 2022-12-20:
It's just a reduction of EMI. Fully functional with the old value, but new value is quieter.

Qwerty-OFF, 2023-05-13:
Done
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

Closed 2023-05-13.

Thread 143 (2022-08-14):

GDI4 rev C fabrication quality issues

rusefillc, 2022-08-14:
At least two boards got damaged on first injector bench test

@NOx-z reports one board not driving injectors 3 and 4 probably due to poor soldering of D11

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

i just had a board make a pop sound while testing injector 4 :( on that board injectors 1, 2 and 3 were working fine. I was using rusEFI Proteus to produce "proper" short test signals and https://github.com/rusefi/rusefi-hardware/releases/tag/20220604_release firmware

rusefillc, 2022-08-14:
@Qwerty-OFF any ideas what can we make to increase our fabrication chances? would wider pads cause more solder paste? do we have control over solder paste amount?

rusefillc, 2022-08-14:
Just found a second board with RESET button not working. Looks like JLC has messed up this batch :(

rusefillc, 2022-08-14:
@mck1117 do "reset" and "boot" buttons work on your board? two of mine needed extra solder for RESET to start working

@NOx-z  do "reset" and "boot" buttons work on your board? two of mine needed extra solder for RESET to start working

NOx-z, 2022-08-14:
I just poked at it, and my BOOT button completely fell off, then I poked the reset, and it lifted off one leg..

rusefillc, 2022-08-14:
wow :(

something about solder paste went very wrong on this order. just filed a quality complaint.

rusefillc, 2022-08-15:
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

rusefillc, 2022-08-16:
[Noxz](https://app.slack.com/team/UBFRN2SH0)
  [2:52 PM](https://rusefi.slack.com/archives/CFP3QAJCW/p1660589556211969)
I dont really have experience with production settings to answer this next bit.. it seems more an issue with quality control than board layout or components (unless, for instance, the plating/metal of the buttons did not want to adhere to the solder well)

[Matthew Kennedy](https://app.slack.com/team/U80K9BYVD)
  [2:56 PM](https://rusefi.slack.com/archives/CFP3QAJCW/p1660589771313479)
I think it's a fools errand to try and fully self-test power electronics

[Noxz](https://app.slack.com/team/UBFRN2SH0)
  [3:03 PM](https://rusefi.slack.com/archives/CFP3QAJCW/p1660590191173269)
beyond making a jig with pogo pins all over to check continuity autoamtically..

[Matthew Kennedy](https://app.slack.com/team/U80K9BYVD)
  [3:03 PM](https://rusefi.slack.com/archives/CFP3QAJCW/p1660590226097949)
Ever look at a real ECU? Yeah, that's what they do. Test pads all over the place.
[3:03](https://rusefi.slack.com/archives/CFP3QAJCW/p1660590238188559)
but that's what I mean by self test
[3:04](https://rusefi.slack.com/archives/CFP3QAJCW/p1660590249185179)
some things you can self test by adding some analog switches to feed your output back in to the input
[3:04](https://rusefi.slack.com/archives/CFP3QAJCW/p1660590260797269)
but that only works when the penalty for "bad board" is not working, instead of releasing vast magic smoke

mck1117, 2022-08-17:
Backwards diode on Andrey's rev C

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

mck1117, 2022-08-17:
Correct board from the same batch, for reference

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

rusefillc, 2022-08-17:
Wow, that's a third kind of issue on same batch :(

mck1117, 2022-08-17:
can you forward the images from this thread on to JLC to try and get our coin back on this batch?

Closed 2023-05-14.

Thread 146 (2022-08-15):

GM fuel pressure decoding

rusefillc, 2022-08-15:
ambient room

```
nibbles: ST=8 D=0:C:1:3:C:0 CRC=B Errs Short: 000983 Long: 000043 Sync: 000043 CRC: 000039 (000 %). Frames: 013706
 GM: St C, Sig0 0193, Sig1 0960. Tick = 2541 nS.
  msg 22: 0x030F (783), T = 24.46875C ?
  msg 16: 0x030D (781), T = 24.40625C ?
nibbles: ST=0 D=0:C:1:2:C:0 CRC=C Errs Short: 000990 Long: 000043 Sync: 000043 CRC: 000039 (000 %). Frames: 013903
 GM: St 8, Sig0 0193, Sig1 0704. Tick = 2541 nS.
  msg 22: 0x0310 (784), T = 24.50000C ?
  msg 16: 0x030D (781), T = 24.40625C ?
nibbles: ST=4 D=0:C:1:3:C:0 CRC=B Errs Short: 001002 Long: 000044 Sync: 000044 CRC: 000040 (000 %). Frames: 014092
 GM: St 4, Sig0 0193, Sig1 0960. Tick = 2541 nS.
  msg 22: 0x0310 (784), T = 24.50000C ?
  msg 16: 0x030D (781), T = 24.40625C ?
nibbles: ST=0 D=0:C:1:2:C:0 CRC=C Errs Short: 001014 Long: 000044 Sync: 000044 CRC: 000040 (000 %). Frames: 014286
 GM: St 8, Sig0 0193, Sig1 0704. Tick = 2541 nS.
  msg 22: 0x0310 (784), T = 24.50000C ?
  msg 16: 0x030D (781), T = 24.40625C ?
nibbles: ST=8 D=0:C:1:2:C:0 CRC=C Errs Short: 001030 Long: 000046 Sync: 000046 CRC: 000041 (000 %). Frames: 014473
 GM: St 8, Sig0 0193, Sig1 0704. Tick = 2541 nS.
  msg 22: 0x0310 (784), T = 24.50000C ?
  msg 16: 0x030D (781), T = 24.40625C ?
nibbles: ST=8 D=0:C:1:2:C:0 CRC=C Errs Short: 001042 Long: 000047 Sync: 000047 CRC: 000042 (000 %). Frames: 014663
 GM: St 4, Sig0 0193, Sig1 0704. Tick = 2541 nS.
  msg 22: 0x0310 (784), T = 24.50000C ?
  msg 16: 0x030D (781), T = 24.40625C ?
nibbles: ST=8 D=0:C:1:2:C:0 CRC=C Errs Short: 001054 Long: 000048 Sync: 000048 CRC: 000043 (000 %). Frames: 014855
 GM: St C, Sig0 0193, Sig1 0704. Tick = 2541 nS.
  msg 22: 0x0310 (784), T = 24.50000C ?
  msg 16: 0x030D (781), T = 24.40625C ?
nibbles: ST=0 D=0:C:1:2:C:0 CRC=C Errs Short: 001083 Long: 000049 Sync: 000049 CRC: 000044 (000 %). Frames: 015036
 GM: St 8, Sig0 0193, Sig1 0704. Tick = 2541 nS.
  msg 22: 0x0310 (784), T = 24.50000C ?
  msg 16: 0x030D (781), T = 24.40625C ?
```

10 bar = 1000 KPa

```
nibbles: ST=0 D=1:1:A:B:1:1 CRC=8 Errs Short: 000029 Long: 000003 Sync: 000001 CRC: 000001 (000 %). Frames: 122949
 GM: St 4, Sig0 0282, Sig1 2833. Tick = 2541 nS.
  msg 16: 0x02EA (746), T = 23.31250C ?
  msg 22: 0x02ED (749), T = 23.40625C ?
nibbles: ST=4 D=1:1:9:B:1:1 CRC=4 Errs Short: 000029 Long: 000003 Sync: 000001 CRC: 000001 (000 %). Frames: 123158
 GM: St 0, Sig0 0281, Sig1 2833. Tick = 2541 nS.
  msg 16: 0x02EB (747), T = 23.34375C ?
  msg 22: 0x02ED (749), T = 23.40625C ?
nibbles: ST=C D=1:1:A:C:1:1 CRC=0 Errs Short: 000029 Long: 000003 Sync: 000001 CRC: 000001 (000 %). Frames: 123367
 GM: St 8, Sig0 0282, Sig1 3089. Tick = 2541 nS.
  msg 16: 0x02EA (746), T = 23.31250C ?
  msg 22: 0x02ED (749), T = 23.40625C ?
nibbles: ST=C D=1:1:A:C:1:1 CRC=0 Errs Short: 000029 Long: 000003 Sync: 000001 CRC: 000001 (000 %). Frames: 123579
 GM: St C, Sig0 0282, Sig1 3089. Tick = 2541 nS.
  msg 16: 0x02EB (747), T = 23.34375C ?
  msg 22: 0x02ED (749), T = 23.40625C ?
nibbles: ST=C D=1:1:A:C:1:1 CRC=0 Errs Short: 000029 Long: 000003 Sync: 000001 CRC: 000001 (000 %). Frames: 123791
 GM: St 4, Sig0 0282, Sig1 3089. Tick = 2541 nS.
  msg 16: 0x02EA (746), T = 23.31250C ?
  msg 22: 0x02ED (749), T = 23.40625C ?
nibbles: ST=C D=1:1:A:B:1:1 CRC=8 Errs Short: 000029 Long: 000003 Sync: 000001 CRC: 000001 (000 %). Frames: 124002
 GM: St C, Sig0 0282, Sig1 2833. Tick = 2541 nS.
  msg 16: 0x02EB (747), T = 23.34375C ?
  msg 22: 0x02ED (749), T = 23.40625C ?
nibbles: ST=0 D=1:1:A:C:1:1 CRC=8 Errs Short: 000029 Long: 000003 Sync: 000001 CRC: 000001 (000 %). Frames: 124211
 GM: St 4, Sig0 0282, Sig1 2833. Tick = 2541 nS.
  msg 16: 0x02EA (746), T = 23.31250C ?
  msg 22: 0x02ED (749), T = 23.40625C ?
nibbles: ST=4 D=1:1:9:B:1:1 CRC=4 Errs Short: 000029 Long: 000003 Sync: 000001 CRC: 000001 (000 %). Frames: 124421
 GM: St 4, Sig0 0281, Sig1 2833. Tick = 2541 nS.
  msg 16: 0x02EA (746), T = 23.31250C ?
  msg 22: 0x02ED (749), T = 23.40625C ?
nibbles: ST=C D=1:1:9:B:1:1 CRC=4 Errs Short: 000029 Long: 000003 Sync: 000001 CRC: 000001 (000 %). Frames: 124630
 GM: St 8, Sig0 0281, Sig1 2833. Tick = 2541 nS.
  msg 16: 0x02EA (746), T = 23.31250C ?
  msg 22: 0x02ED (749), T = 23.40625C ?
nibbles: ST=C D=1:1:A:B:1:1 CRC=8 Errs Short: 000029 Long: 000003 Sync: 000001 CRC: 000001 (000 %). Frames: 124839
 GM: St C, Sig0 0282, Sig1 2833. Tick = 2541 nS.
  msg 16: 0x02EA (746), T = 23.31250C ?
  msg 22: 0x02ED (749), T = 23.40625C ?
nibbles: ST=4 D=1:1:B:C:1:1 CRC=0 Errs Short: 000029 Long: 000003 Sync: 000001 CRC: 000001 (000 %). Frames: 125050
 GM: St 0, Sig0 0282, Sig1 3089. Tick = 2541 nS.
  msg 16: 0x02EA (746), T = 23.31250C ?
  msg 22: 0x02ED (749), T = 23.40625C ?
nibbles: ST=C D=1:1:A:D:1:1 CRC=7 Errs Short: 000029 Long: 000003 Sync: 000001 CRC: 000001 (000 %). Frames: 125260
 GM: St C, Sig0 0282, Sig1 3345. Tick = 2541 nS.
  msg 16: 0x02EA (746), T = 23.31250C ?
  msg 22: 0x02ED (749), T = 23.40625C ?
nibbles: ST=4 D=1:1:A:C:1:1 CRC=0 Errs Short: 000029 Long: 000003 Sync: 000001 CRC: 000001 (000 %). Frames: 125471
 GM: St 4, Sig0 0282, Sig1 3089. Tick = 2541 nS.
  msg 16: 0x02EA (746), T = 23.31250C ?
  msg 22: 0x02ED (749), T = 23.40625C ?
nibbles: ST=0 D=1:1:B:C:1:1 CRC=0 Errs Short: 000029 Long: 000003 Sync: 000001 CRC: 000001 (000 %). Frames: 125679
```

rusefillc, 2022-08-15:
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

rusefillc, 2022-08-15:
10 bar looks great
```
nibbles: ST=8 D=1:1:E:F:1:1 CRC=4 Errs Short: 000008 Long: 000004 Sync: 000000 CRC: 000000 (000 %). Frames: 158447
 GM: St 8, Sig0 0286, Sig1 0287, 9.650 Atm Tick = 2541 nS.
  msg 16: 0x02F3 (755), T = 23.59375C ?
  msg 22: 0x02F6 (758), T = 23.68750C ?
nibbles: ST=C D=1:1:E:F:1:1 CRC=4 Errs Short: 000008 Long: 000004 Sync: 000000 CRC: 000000 (000 %). Frames: 158653
 GM: St 4, Sig0 0286, Sig1 0287, 9.650 Atm Tick = 2541 nS.
  msg 16: 0x02F3 (755), T = 23.59375C ?
  msg 22: 0x02F6 (758), T = 23.68750C ?
nibbles: ST=8 D=1:1:E:0:2:1 CRC=8 Errs Short: 000008 Long: 000004 Sync: 000000 CRC: 000000 (000 %). Frames: 158863
 GM: St 8, Sig0 0286, Sig1 0288, 9.700 Atm Tick = 2541 nS.
  msg 16: 0x02F3 (755), T = 23.59375C ?
  msg 22: 0x02F6 (758), T = 23.68750C ?
nibbles: ST=0 D=1:1:F:0:2:1 CRC=C Errs Short: 000008 Long: 000004 Sync: 000000 CRC: 000000 (000 %). Frames: 159071
 GM: St 0, Sig0 0287, Sig1 0288, 9.750 Atm Tick = 2541 nS.
  msg 16: 0x02F3 (755), T = 23.59375C ?
  msg 22: 0x02F6 (758), T = 23.68750C ?
nibbles: ST=0 D=1:1:E:0:2:1 CRC=4 Errs Short: 000008 Long: 000004 Sync: 000000 CRC: 000000 (000 %). Frames: 159281
 GM: St 4, Sig0 0286, Sig1 0287, 9.650 Atm Tick = 2541 nS.
  msg 16: 0x02F3 (755), T = 23.59375C ?
  msg 22: 0x02F6 (758), T = 23.68750C ?
nibbles: ST=C D=1:1:E:0:2:1 CRC=8 Errs Short: 000008 Long: 000004 Sync: 000000 CRC: 000000 (000 %). Frames: 159491
 GM: St 8, Sig0 0286, Sig1 0288, 9.700 Atm Tick = 2541 nS.
  msg 16: 0x02F3 (755), T = 23.59375C ?
  msg 22: 0x02F6 (758), T = 23.68750C ?
nibbles: ST=C D=1:1:E:0:2:1 CRC=8 Errs Short: 000008 Long: 000004 Sync: 000000 CRC: 000000 (000 %). Frames: 159702
 GM: St C, Sig0 0286, Sig1 0288, 9.700 Atm Tick = 2541 nS.
  msg 16: 0x02F3 (755), T = 23.59375C ?
  msg 22: 0x02F6 (758), T = 23.68750C ?
nibbles: ST=0 D=1:1:E:0:2:1 CRC=8 Errs Short: 000008 Long: 000005 Sync: 000000 CRC: 000000 (000 %). Frames: 159909
 GM: St 4, Sig0 0286, Sig1 0288, 9.700 Atm Tick = 2541 nS.
  msg 16: 0x02F3 (755), T = 23.59375C ?
  msg 22: 0x02F6 (758), T = 23.68750C ?
nibbles: ST=8 D=1:1:E:0:2:1 CRC=8 Errs Short: 000008 Long: 000005 Sync: 000000 CRC: 000000 (000 %). Frames: 160119
 GM: St 8, Sig0 0286, Sig1 0288, 9.700 Atm Tick = 2541 nS.
  msg 16: 0x02F3 (755), T = 23.59375C ?
  msg 22: 0x02F6 (758), T = 23.68750C ?
nibbles: ST=0 D=1:1:F:0:2:1 CRC=C Errs Short: 000008 Long: 000005 Sync: 000000 CRC: 000000 (000 %). Frames: 160329
 GM: St 0, Sig0 0287, Sig1 0288, 9.750 Atm Tick = 2541 nS.
  msg 16: 0x02F3 (755), T = 23.59375C ?
  msg 22: 0x02F6 (758), T = 23.68750C ?
nibbles: ST=0 D=1:1:E:0:2:1 CRC=8 Errs Short: 000008 Long: 000005 Sync: 000000 CRC: 000000 (000 %). Frames: 160537
 GM: St 0, Sig0 0286, Sig1 0288, 9.700 Atm Tick = 2541 nS.
  msg 16: 0x02F3 (755), T = 23.59375C ?
  msg 22: 0x02F6 (758), T = 23.68750C ?
```

no pressure - probably should it be close to 1 @dron0gus ? what does it show on your end?
```
nibbles: ST=0 D=0:C:0:2:C:0 CRC=8 Errs Short: 000008 Long: 000002 Sync: 000000 CRC: 000000 (000 %). Frames: 062893
 GM: St 0, Sig0 0192, Sig1 0194, 0.300 Atm Tick = 2541 nS.
  msg 16: 0x02F2 (754), T = 23.56250C ?
  msg 22: 0x02F4 (756), T = 23.62500C ?
nibbles: ST=0 D=0:C:1:2:C:0 CRC=C Errs Short: 000008 Long: 000002 Sync: 000000 CRC: 000000 (000 %). Frames: 063093
 GM: St 4, Sig0 0193, Sig1 0194, 0.350 Atm Tick = 2541 nS.
  msg 16: 0x02F2 (754), T = 23.56250C ?
  msg 22: 0x02F4 (756), T = 23.62500C ?
nibbles: ST=C D=0:C:1:2:C:0 CRC=C Errs Short: 000008 Long: 000002 Sync: 000000 CRC: 000000 (000 %). Frames: 063294
 GM: St C, Sig0 0193, Sig1 0194, 0.350 Atm Tick = 2541 nS.
  msg 16: 0x02F1 (753), T = 23.53125C ?
  msg 22: 0x02F4 (756), T = 23.62500C ?
nibbles: ST=0 D=0:C:1:2:C:0 CRC=C Errs Short: 000008 Long: 000002 Sync: 000000 CRC: 000000 (000 %). Frames: 063495
 GM: St 0, Sig0 0193, Sig1 0194, 0.350 Atm Tick = 2541 nS.
  msg 16: 0x02F2 (754), T = 23.56250C ?
  msg 22: 0x02F4 (756), T = 23.62500C ?
nibbles: ST=0 D=0:C:1:2:C:0 CRC=B Errs Short: 000008 Long: 000002 Sync: 000000 CRC: 000000 (000 %). Frames: 063695
 GM: St 0, Sig0 0193, Sig1 0195, 0.400 Atm Tick = 2541 nS.
  msg 16: 0x02F2 (754), T = 23.56250C ?
  msg 22: 0x02F4 (756), T = 23.62500C ?
nibbles: ST=8 D=0:C:0:3:C:0 CRC=F Errs Short: 000008 Long: 000002 Sync: 000000 CRC: 000000 (000 %). Frames: 063896
 GM: St C, Sig0 0192, Sig1 0195, 0.350 Atm Tick = 2541 nS.
  msg 16: 0x02F2 (754), T = 23.56250C ?
  msg 22: 0x02F4 (756), T = 23.62500C ?
nibbles: ST=8 D=0:C:1:2:C:0 CRC=8 Errs Short: 000008 Long: 000002 Sync: 000000 CRC: 000000 (000 %). Frames: 064096
 GM: St C, Sig0 0192, Sig1 0194, 0.300 Atm Tick = 2541 nS.
  msg 16: 0x02F2 (754), T = 23.56250C ?
  msg 22: 0x02F4 (756), T = 23.62500C ?
nibbles: ST=0 D=0:C:0:2:C:0 CRC=8 Errs Short: 000008 Long: 000002 Sync: 000000 CRC: 000000 (000 %). Frames: 064297
 GM: St 0, Sig0 0192, Sig1 0194, 0.300 Atm Tick = 2541 nS.
  msg 16: 0x02F2 (754), T = 23.56250C ?
  msg 22: 0x02F4 (756), T = 23.62500C ?
nibbles: ST=0 D=0:C:1:2:C:0 CRC=C Errs Short: 000008 Long: 000002 Sync: 000000 CRC: 000000 (000 %). Frames: 064497
 GM: St 4, Sig0 0193, Sig1 0194, 0.350 Atm Tick = 2541 nS.
  msg 16: 0x02F2 (754), T = 23.56250C ?
  msg 22: 0x02F4 (756), T = 23.62500C ?
nibbles: ST=C D=0:C:1:3:C:0 CRC=B Errs Short: 000008 Long: 000002 Sync: 000000 CRC: 000000 (000 %). Frames: 064698
 GM: St C, Sig0 0193, Sig1 0195, 0.400 Atm Tick = 2541 nS.
  msg 16: 0x02F2 (754), T = 23.56250C ?
  msg 22: 0x02F4 (756), T = 23.62500C ?
nibbles: ST=0 D=0:C:0:2:C:0 CRC=8 Errs Short: 000008 Long: 000002 Sync: 000000 CRC: 000000 (000 %). Frames: 064898
 GM: St 4, Sig0 0192, Sig1 0194, 0.300 Atm Tick = 2541 nS.
  msg 16: 0x02F2 (754), T = 23.56250C ?
  msg 22: 0x02F4 (756), T = 23.62500C ?
nibbles: ST=0 D=0:C:1:2:C:0 CRC=C Errs Short: 000008 Long: 000002 Sync: 000000 CRC: 000000 (000 %). Frames: 065099
 GM: St 0, Sig0 0193, Sig1 0194, 0.350 Atm Tick = 2541 nS.
  msg 16: 0x02F2 (754), T = 23.56250C ?
  msg 22: 0x02F4 (756), T = 23.62500C ?

```

dron0gus, 2022-08-16:
No pressure. Saint-P. Almost sea level.
Bouncing around 1 Atm.
Seems sensor is not very precise at low pressure?
```
nibbles: ST=0 D=0:C:5:B:C:0 CRC=8 Errs Short: 000026 Long: 000000 Sync: 000000 CRC: 000000 (000 %). Frames: 564959
 GM: St 4, Sig0 0198, Sig1 0203, 1.050 Atm Tick = 2597 nS.
  msg 16: 0x0303 (771), T = 24.09375C ?
  msg 22: 0x0302 (770), T = 24.06250C ?
nibbles: ST=4 D=0:C:5:B:C:0 CRC=4 Errs Short: 000026 Long: 000000 Sync: 000000 CRC: 000000 (000 %). Frames: 565150
 GM: St 4, Sig0 0197, Sig1 0203, 1.000 Atm Tick = 2597 nS.
  msg 16: 0x0303 (771), T = 24.09375C ?
  msg 22: 0x0302 (770), T = 24.06250C ?
nibbles: ST=C D=0:C:5:A:C:0 CRC=3 Errs Short: 000026 Long: 000000 Sync: 000000 CRC: 000000 (000 %). Frames: 565340
 GM: St C, Sig0 0197, Sig1 0202, 0.950 Atm Tick = 2597 nS.
  msg 16: 0x0303 (771), T = 24.09375C ?
  msg 22: 0x0302 (770), T = 24.06250C ?
nibbles: ST=0 D=0:C:5:B:C:0 CRC=4 Errs Short: 000026 Long: 000000 Sync: 000000 CRC: 000000 (000 %). Frames: 565530
 GM: St 8, Sig0 0197, Sig1 0203, 1.000 Atm Tick = 2597 nS.
  msg 16: 0x0303 (771), T = 24.09375C ?
  msg 22: 0x0302 (770), T = 24.06250C ?
nibbles: ST=C D=0:C:6:B:C:0 CRC=8 Errs Short: 000026 Long: 000000 Sync: 000000 CRC: 000000 (000 %). Frames: 565721
 GM: St C, Sig0 0198, Sig1 0203, 1.050 Atm Tick = 2597 nS.
  msg 16: 0x0303 (771), T = 24.09375C ?
  msg 22: 0x0302 (770), T = 24.06250C ?
```

mck1117, 2022-08-16:
>  Seems sensor is not very precise at low pressure?

How high does this sensor go? If it's a GDI sensor, I'd expect at least 200 bar, so 0.05 bar resolution isn't terrible. 200/0.05 is 12 bits.

dron0gus, 2022-08-16:
Actual resolution seems 1/10 Atm
See https://github.com/rusefi/rusefi-hardware/blob/fc7550c533f5a8c9343e8c53ae82b3afd78bb808/SENT-box/firmware/sent.cpp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
But we can get 0.05 by averaging two signals.

floods57, 2024-05-07:
Hi,
Can you share the code you use in the Blue Pill to test ? i looking to make a similar test on a Audi and a Renault intake pressure/temp sensor that use SENT protocol too with 12 bits data (12 bits for pressure and 12 bits for temp).
Thanks

rusefillc, 2024-05-07:
@floods57 all the code is at https://github.com/rusefi/rusefi-hardware/tree/main/SENT-box/firmware

dron0gus, 2024-05-08:
@floods57 can you share partnumber(s) of these sensors?

floods57, 2024-05-08:
Thanks a lot ;)
About the partnumbers yes, the Renault sensor is a Sensata 82MPP12-01, the Audi, i have 2, the 1st is a Sensata 04E906051J (82MPP07-03) and the second is a Valeo 04E906051H, the 2 sensor are on the 1.5 TSI, one is the MAP, and the second is before throttle body (boost sensor), i don't know why they use 2 different brand, but many chance there give the exact same data.

dron0gus, 2024-05-08:
@floods57 thanks for partnumbers.
Second one from Audi is 10 times cheaper then first. At least for used one. Bought two for price of 3 cups of coffee.
If you know other sensors with SENT - please let me know.
Also please note that most recent driver is in main RusEFI codebase: https://github.com/rusefi/rusefi/tree/master/firmware/hw_layer/drivers/sent

floods57, 2024-05-08:
Ok, but i am not sure about the code i must use, i looking for the same as in this video : [https://www.youtube.com/watch?v=S2xH2oOEYL8](https://www.youtube.com/watch?v=S2xH2oOEYL8) i looking to do a similar testing with a Blue Pill to 1st find the value of the sensor.
Ok about other sensor, i think i can find more, i know there is a other reference for the Renault 1.3 liter, must check, will let you know, at this time i have this 3 in stock for testing ;)
Thanks

dron0gus, 2024-05-13:
@floods57 for bluepill use https://github.com/rusefi/rusefi-hardware/tree/main/SENT-box/firmware code. But check main RusEFI FW for possible updates, changes.
BTW, do you have pinout for these map/iat sensor? Just received one for testing.

dron0gus, 2024-05-13:
04E906051H
Room temperature (a bit hot), sea level atm preasure.
Seems Sig0 is pressure, Sig1 is temperature.
Slow channels does not change (partnumber? serial number?) Can we use it for sensor identification?
```
2024-05-14_00_50_24_401: EngineState: ---- SENT ch 0 ---- on 23 - AN temp 2
2024-05-14_00_50_24_402: EngineState: Unit time 486 CPU ticks 2.892857088 uS
2024-05-14_00_50_24_402: EngineState: Total pulses 2982654
2024-05-14_00_50_24_403: EngineState: Last valid fast msg Status 0x4 Sig0 0x41A Sig1 0x312
2024-05-14_00_50_24_404: EngineState: Slow channels:
2024-05-14_00_50_24_404: EngineState:  ID 35: 0
2024-05-14_00_50_24_405: EngineState:  ID 41: 2093
2024-05-14_00_50_24_406: EngineState:  ID 148: 2577
2024-05-14_00_50_24_409: EngineState:  ID 151: 1262
2024-05-14_00_50_24_410: EngineState:  ID 4: 1
2024-05-14_00_50_24_410: EngineState:  ID 7: 83
2024-05-14_00_50_24_413: EngineState:  ID 8: 324
2024-05-14_00_50_24_413: EngineState:  ID 129: 0
2024-05-14_00_50_24_414: EngineState:  ID 10: 3896
2024-05-14_00_50_24_414: EngineState:  ID 1: 0
2024-05-14_00_50_24_417: EngineState:  ID 147: 1360
2024-05-14_00_50_24_417: EngineState:  ID 150: 3281
2024-05-14_00_50_24_417: EngineState:  ID 9: 193
2024-05-14_00_50_24_420: EngineState:  ID 144: 1296
2024-05-14_00_50_24_420: EngineState:  ID 146: 1424
2024-05-14_00_50_24_421: EngineState:  ID 3: 7
2024-05-14_00_50_24_423: EngineState: Restarts 0
2024-05-14_00_50_24_423: EngineState: Interval errors 136828 short, 5133 long
2024-05-14_00_50_24_425: EngineState: Total frames 277008 with CRC error 6100 (2.202102416%)
2024-05-14_00_50_24_426: EngineState: Total slow channel messages 3787 with crc6 errors 26 (0.686559232%)
2024-05-14_00_50_24_426: EngineState: Sync errors 7215
2024-05-14_00_50_24_428: EngineState: --------------------
```

dron0gus, 2024-05-13:
Pinout:
1 - SENT
2 - ground
3 - power (5V)

floods57, 2024-05-15:
Ok, Thanks i will try it ;)
For the pinout, i have it for the Sensata 82MPP12-01 (pin 1 is signal output, 2 is GND and 3 is +5V)

floods57, 2024-05-15:
> Pinout: 1 - SENT 2 - ground 3 - power (5V)

Ok, so many chance that the 04E906051J use the same pinout, will try it, look really difficult to get any information for this sensor.
As i know from the 82MPP12-01, the slow channel is not used, and 1st data (3 nibbles after the status) is the pressure and next the temp, and i just don't understand how the status work on this.

floods57, 2024-05-16:
@dron0gus By the way, did you use a RC filter ? Thanks

dron0gus, 2024-05-16:
@floods57 do you mean input RC filter? No, I'm debuging on MRE board and using analog input with filter C removed. So signal path is OpAmp with K = 1 -> 1/2 divider -> STM32 pin.
Actually maybe because of this I see about 2% of error frames.

rusefillc, 2024-10-23:
Just started to extract code towards https://github.com/rusefi/rusefi/issues/6997

Closed 2024-10-23.

Thread 147 (2022-08-15):

GDI4revC WA1 board damange

rusefillc, 2022-08-15:
@NOx-z what components were damangers on your board due to above? I wonder if we can make schematics or code smarter to survivei?

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

rusefillc, 2022-08-15:
@mck1117 @Qwerty-OFF FYI

rusefillc, 2022-08-15:
related to #143

NOx-z, 2022-08-15:
the PT2001 fried twice before I found the issue, but the first time also blew out Q2 (HV fet) and it's sense resistor R12 - this occurred after a long on-time (with DrvEn pulled low/disabled) with a busted asic. The second time only blew out the asic before I removed the power, swapped it out, and everything else was okay.

rusefillc, 2022-08-15:
TL,DR: too much drama with that board, no clear data?

NOx-z, 2022-08-15:
We've been able to click all the injectors. We have at least 2 fully working boards (well, once I slap the buttons back on). The new firmware thus far is also operating as expected. We resolved many issues from Rev B, but even that had fab issues

rusefillc, 2022-08-15:
@NOx-z my main question here: can we think of mods to make boards more resilient against fab issues?

Thread 150 (2022-08-20):

WBO rev 3 test log

rusefillc, 2022-08-20:
have status green LED
seen ERROR blue LED on first run without sensor

see heater red LED

[rev-3-with-sensor-and-lighter.txt](https://github.com/rusefi/rusefi-hardware/files/9387968/rev-3-with-sensor-and-lighter.txt)

Thread 151 (2022-08-23):

single WBO rev 3 PCB is a little too large

rusefillc, 2022-08-23:
rev 3 is
57.8 wide
66.4 mm long

width has to be belo
54.2 mm

please cut 1.8mm on both sides of the PCB thus shrink PCB width by 3.6mm

looks like length is OK but let's trim 0.5 just to be a bit more sure

rusefillc, 2022-08-30:
@Nadezhda-n also at least four capacitors were added under #153 and some stm32 pins were moved around, looking for update PCB to match current schematics :)

Nadezhda-n, 2022-08-31:
done :)

rusefillc, 2022-08-31:
@dron0gus please review in term of capacitors

@Nadezhda-n please confirm that you had a chance to try your gerbers. Please generate gerbers/bom/CPL and push into "rev 4" folder"

Nadezhda-n, 2022-08-31:
added folder export/rev4

rusefillc, 2022-08-31:
@Nadezhda-n please change

U11,U12 part number to C840103

Thread 152 (2022-08-29):

WBO F103 add SENT RC filter

rusefillc, 2022-08-29:
@dron0gus please adjust only schematics of one or two digital input channels to make those happier for SENT

PCB change would be separate ticket later

rusefillc, 2022-08-30:
@dron0gus has changed from
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

to
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

@dron0gus are we happy with current R and C values for SENT?

Closed 2022-08-31.

Thread 154 (2022-09-12):

F103 WBO rev4: UART on connector

rusefillc, 2022-09-12:
can we please expose uart on main connector in order to use this box as UART 2 CAN adapter or for wired TS connectivy?

dron0gus, 2022-09-17:
https://github.com/rusefi/rusefi-hardware/pull/155

rusefillc, 2023-02-07:
Seems to be done

Closed 2023-02-07.

Thread 156 (2022-09-26):

PCB updates 155

rusefillc, 2022-09-26:
Дрон обновил схему в https://github.com/rusefi/rusefi-hardware/pull/155 - там есть описание

хотелось бы обновить плату

Nadezhda-n, 2022-10-24:
Закроем?

rusefillc, 2022-10-24:
@dron0gus хочешь проверить?

rusefillc, 2022-10-24:
ой, это пока не rev5 - это всё ещё rev4

rev4 пока не изготавливался

Thread 157 (2022-09-30):

digital inputs board: CAN TX

rusefillc, 2022-09-30:
https://github.com/rusefi/rusefi-hardware/tree/main/digital-inputs/firmware firmware should be sending (and later transmitting) CAN stuff at 500Kb in order to control hardware under test

rusefillc, 2022-09-30:
@dron0gus I've pushed something but logic analyzer does not show happy CAN outbound traffic. Is it CAN registers, pin init or something else?

https://github.com/rusefi/rusefi-hardware/commit/160935062495c95033a3ee4b34da6a16801284e3

rusefillc, 2022-09-30:
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

rusefillc, 2022-09-30:
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

dron0gus, 2022-10-02:
CAN needs xmitter to be attached - it listens to what is transmits. I see no xmitter on photo.
CAN needs at least two nodes - other end should ack valid messages. Without ack HW will go to error state or infinity transmit loop.
CAN needs load resistor.

Thread 158 (2022-10-06):

frequency-divider: oscilloscope is happy, proteus digital input is not

rusefillc, 2022-10-06:
Proteus digital input accepts as-is undivided digital signal

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

oscilloscope shows x16 divided signal as expected with same voltage level

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

but proteus digital input 6 does not register EXTI events off that divided signal

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

rusefillc, 2022-10-06:
Works with 100R R10

rusefillc, 2022-12-13:
Action item: BOM fix?

Thread 159 (2022-11-29):

quad DDPAK igbt

rusefillc, 2022-11-29:
Same as https://github.com/rusefi/rusefi/tree/master/hardware/DDPAK_breakout just four channels and with JLC assembly option

0805 pull-down signal and inline resistors

four input pads/holes diameter = 1.2mm

four output pads/holes diameter = 1.2mm

one GND pad/hole diameter = 2mm

"quad IGBT v 0.1" silkscreen

rusefillc, 2022-11-29:
See also https://github.com/rusefi/hellen154hyundai/

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

rusefillc, 2022-11-29:
@Nadezhda-n please PR into https://github.com/rusefi/rusefi-hardware/tree/main/quad-igbt folder :)

Nadezhda-n, 2022-12-02:
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

rusefillc, 2022-12-02:
@Nadezhda-n у GND будет дырочка P9?

rusefillc, 2022-12-02:
@Nadezhda-n R2 в оригинале между R1 и IGBT

а стало 100K снаружи 1K

кажется удобнее и более гибко будет R2 между R1 и IGBT

Nadezhda-n, 2022-12-02:
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

Nadezhda-n, 2022-12-02:
> @Nadezhda-n please PR into https://github.com/rusefi/rusefi-hardware/tree/main/quad-igbt folder :)

Посмотри, верно ли тебя поняла :)

rusefillc, 2022-12-02:
@Nadezhda-n it looks great!

Please add "rusefi.com" silkscreen on the back and push JLC fab files

@Qwerty-OFF please review

rusefillc, 2022-12-05:
@mck1117 @dron0gus does this need capacitors like https://github.com/andreika-git/hellen-one/issues/207#issuecomment-1336519453 ?

dron0gus, 2022-12-05:
@rusefillc this capacitor is in feedback circuit, not base

rusefillc, 2023-11-16:
we have the boards

Closed 2023-11-16.

Thread 160 (2022-12-04):

Улучшить 154 плату

rusefillc, 2022-12-04:
https://github.com/rusefi/rusefi-hardware/tree/main/breakout-boards/Breakout_154pin_284617-1-Connector

1) нужно увеличить диаметр маленьких отверстий со нижней половины платы (там, где провода) с 1мм до 1.2мм - не уменьшая ширину дорожек. Для этого видимо ряды 51-60 и 133-154 придётся поставить в шахматном порядке?

2) на шёлкографии нужно подписать сильно больше пинов - в идеале найти способ подписать все пины проводов с обеих сторон и все пины разъёма сзади

3) версию платы на шёлкографии поменять с 0.3 на 0.4

Nadezhda-n, 2022-12-08:
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
не очень поняла откуда такие номера в п.1
Если опечатка в числах, то да, надо ставить в шахматном

Nadezhda-n, 2022-12-08:
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

rusefillc, 2022-12-13:
ordered

Closed 2022-12-13.

Thread 161 (2022-12-04):

WBO rev 3: heater PWM is oscillating in closed loop

dron0gus, 2022-12-04:
Measured Rint and sensor temperature are too noisy for default PID settings.
This cause heater PWM to oscillate from 30% to 90% with 0.5..1 Hz period.
This cause waving consumed current.
TODO: debug HW.
SW fix:
```
diff --git a/firmware/heater_control.cpp b/firmware/heater_control.cpp
index b97d923..628f066 100644
--- a/firmware/heater_control.cpp
+++ b/firmware/heater_control.cpp
@@ -48,8 +48,8 @@ static struct heater_state state[AFR_CHANNELS] =
 {
     {
         .heaterPid = Pid(
-            0.3f,      // kP
-            0.3f,      // kI
+            0.03f,      // kP
+            0.03f,      // kI
             0.01f,     // kD
             3.0f,      // Integrator clamp (volts)
             HEATER_CONTROL_PERIOD

```

rusefillc, 2022-12-04:
@mck1117 fyi

mck1117, 2022-12-04:
Can you show a log of this happening, either from rusEFI or wb controller directly?

mck1117, 2022-12-07:
@rusefillc wideband controller's own TS config now logs various controller parameters, give it a shot?

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

rusefillc, 2022-12-07:
My soldered piece is in the suit case as a talking piece at PRI, I might solder another one tomorrow. @dron0gus any chance for logs?

rusefillc, 2022-12-07:
@mck1117 realistically I need to waste time on different stuff, I do need help with this WBO :( Can I order larger stm32 chips for you or did you have a chance?

mck1117, 2022-12-07:
FWIW my dual board works fine, I don't remember if anything is substantially different on rev3

I can also attempt to flash my gd32 rev3 and see what happens

rusefillc, 2022-12-07:
@dron0gus wonder is tracing noise is the cause

mck1117, 2022-12-07:
> @dron0gus wonders is tracing noise is the cause

This seems sort of unlikely, none of the nodes are particularly low impedance.

dron0gus, 2022-12-07:
@mck1117 thanks for fixing logging.
I'll try to take logs this evening.
Happens only on f1_rev3.
Dual works fine with default PID settings.

BTW should we export PIDs settings to TS so user will be able to adjust.

mck1117, 2022-12-07:
I'd love a log with data rate maxed out to confirm whether it's really too noisy or not

dron0gus, 2022-12-07:
@mck1117
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

[2022-12-08_00.12.44.zip](https://github.com/rusefi/rusefi-hardware/files/10180082/2022-12-08_00.12.44.zip)

mck1117, 2022-12-07:
The noise is on your battery voltage measurement, not on the ESR measurement

mck1117, 2022-12-07:
@dron0gus for a test, can you replace [this line](https://github.com/mck1117/wideband/blob/1e3a227f5038e8c418843d0ed7d4c9392de0284e/firmware/heater_control.cpp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) with `float batteryVoltage = 12;`? That will disable battery voltage compensation to rule out battery measurement issues.

dron0gus, 2022-12-13:
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
This noise may be related.

mck1117, 2022-12-14:
>  This noise may be related.

what node is that?

dron0gus, 2022-12-14:
> what node is that?
Un_3x_sense
Look like 350KHz bandwidth of GS8331/2 is not good for STM32 ADC:
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
Also
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

Thread 162 (2022-12-12):

WBO rev3: U11, U12 wrong component mounted

dron0gus, 2022-12-12:
I see something with 5 pins only on my board.

dron0gus, 2022-12-12:
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

rusefillc, 2022-12-13:
```

74HC2G17GW | U11 | Package_TO_SOT_SMD:SOT-23-6 | C840103

74HC2G17GW | U12 | Package_TO_SOT_SMD:SOT-23-6 | C840103

```

replacement part SN74LVC1G06DBVR is in fact SOT-23-5 while 74HC2G17GW is TSSOP6

dron0gus, 2022-12-13:
Replacement is "Single Inverter Buffer/Driver With Open-Drain" while original part is "Dual non-inverting Schmitt trigger".
So dual vs single.
Non-inverting vs inverting - ok, SW can take care.
Push-pull output vs open-drain.

dron0gus, 2022-12-13:
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
Pinout is not compatible.

Thread 163 (2022-12-13):

Small CAN integration box

rusefillc, 2022-12-13:
Looking to have a Small CAN integration box based on stm32f4

stm32f4 to leverage rusEFI codebase up to Lua
* x3 GND just to facilitate wiring
* x1+12v power input
* x4 two CAN buses
* x3 3A-ish low side outputs
* x3 2A-ish high side outputs
* x3 analog inputs 0-5v
* x1 5v sensor feed output
* x2 slow digital inputs with software-configurable pull-up like in 4chan
* x1 fast digital CAM hall input with software-configurable pull-up like in 4chan

x21 pins total

for case we have two options
same case and connector as https://github.com/rusefi/rusefi-hardware/tree/main/wideband-F103

or slightly larger sibling if we cannot fit into

open question if F407 in lqft-100 package like https://github.com/rusefi/rusefi/tree/master/hardware/brain_board or original 144lqfp Hellen-one or megamodule? depends on physical size mostly

Thread 168 (2022-12-20):

GDI4: GD32 CAN :(

rusefillc, 2022-12-20:
Did we get CAN to work on GD32?

rev A boards have GD32, rev C and later boards would be STM32

but today it would be great to have rev A board working.

this repo uses 20.rusefi ChibiOS branch https://github.com/rusefi/rusefi-hardware/blob/3e679096ae0831d29b029171dea7ff7ca3f71be4/.gitmodules#L7 not master.wideband

I did cherry pick GD32 CAN commit https://github.com/rusefi/ChibiOS/commits/stable_20.3.x.rusefi are there any other pieces of GD32 CAN drama?

dron0gus, 2022-12-21:
Should work after this fix. Actually will work without this fix too, but with some tx message lost.

rusefillc, 2023-07-22:
we are good thank you @dron0gus !

Closed 2023-07-22.

Thread 169 (2022-12-25):

lambda-x2 easier to operate BOOT

rusefillc, 2022-12-25:
As is we have... @dron0gus what is it called what we have for BOOT on the back of the PCB?

button? 0.1" header for jumper maybe?

rusefillc, 2022-12-25:
@dron0gus did you try soldering a small button on the back of board by the way?

dron0gus, 2022-12-27:
PCB jumper. You can try to short/press it with graphite pencil.
Nope, I did not try to solder button, but is should fit.

Thread 170 (2023-01-23):

WBO x2 BT documentation

rusefillc, 2023-01-23:
@dron0gus how does one initialize BT on WBOx2?

Looking to add into into https://github.com/rusefi/rusefi-hardware/tree/main/lambda-x2 readme.md around https://github.com/rusefi/rusefi-hardware/tree/main/lambda-x2#bluetooth

Also what is default baud rate?

dron0gus, 2023-01-23:
https://github.com/dron0gus/wideband/blob/master/firmware/boards/f1_dual/wideband_board_config.h#L71 and https://github.com/dron0gus/wideband/blob/2318bd1e01328d1e752bdb59344bb1f8bbec9a0b/firmware/console/binary/tunerstudio_io_serial.cpp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 FW will attempt to setup BT module on each power up.

mck1117, 2023-01-23:
> FW will attempt to setup BT module on each power up.

@dron0gus PR?

dron0gus, 2023-01-23:
@mck1117 already in your repo https://github.com/mck1117/wideband/blob/master/firmware/console/binary/tunerstudio_io_serial.cpp .

rusefillc, 2023-01-23:
@dron0gus just improved https://github.com/rusefi/rusefi-hardware/tree/main/lambda-x2#bluetooth a bit

Closed 2023-01-23.

Thread 171 (2023-02-04):

Dual WBO: main connector silk screen

rusefillc, 2023-02-04:
https://github.com/rusefi/wideband/issues/19 tells us that it would be great to have some useful silk on the back side of the PCB especially at the main connector

dron0gus, 2023-02-25:
We have interactive pinout, we have all pins labeled with its number on PCB. Should be enough.

rusefillc, 2023-02-25:
Sometimes offline silk is so cool

Closed 2023-02-26.

Thread 172 (2023-02-04):

wbo dual: C10 & C35

rusefillc, 2023-02-04:
"C35, C10 - recalculate"

rusefillc, 2023-02-07:
@dron0gus is single channel board affected?

rusefillc, 2023-02-10:
10nf C15195 has helped somewhat

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

rusefillc, 2023-02-10:
Alex says

Туда лучше всего где-то 1-2.2нФ поставить в следующей версии. Постоянная времени цепи т=rc 100000Ом * 0.0000000022Ф = 0,00022с. Или 0.22мс. при периоде 2.5мс.

dron0gus, 2023-02-25:
Replaced with 1nF on Rev1 https://github.com/rusefi/rusefi-hardware/pull/180

Closed 2023-02-25.

Thread 173 (2023-02-07):

revive or recreate LM1949 driver

rusefillc, 2023-02-07:
* let's assume external 5v no need in 5v power supply
* logic level 5v control signal or optional low-side control signal
* JLC single side assembly
* legacy kicad never tested https://github.com/rusefi/hw_legacy/tree/master/Low-Z_LM1949
* reference schematics https://www.ti.com/lit/ds/symlink/lm1949.pdf
* too much optional stuff https://secu-3.org/wordpress/wp-content/uploads/pdf/secu3_pnh+pwm_iac.pdf

rusefillc, 2023-02-07:
empty folder https://github.com/rusefi/rusefi-hardware/tree/main/Low-Z_LM1949

rusefillc, 2023-02-27:
@Qwerty-OFF can you please review https://github.com/rusefi/rusefi-hardware/tree/main/Low-Z_LM1949?

Lib files pushed into https://github.com/rusefi/kicad-libraries/

rusefillc, 2023-02-27:
One of the questions is if we have any SMD alternatives for Tip122

Thread 175 (2023-02-10):

bean counting: no-ref option?

rusefillc, 2023-02-10:
REF BOM is 10% of overall cost

Is it worth experimenting without it? Would we need alternative schematics if assemble without REF?

Thread 178 (2023-02-11):

wbo signle: magic capacitor value?

rusefillc, 2023-02-11:
is single channel affected by capacitor value like https://github.com/rusefi/rusefi-hardware/issues/172?

Thread 179 (2023-02-15):

20A DC motor control

rusefillc, 2023-02-15:
Tommy says "fancy aftermarket wastegates need 20A H-bridges"

@blundar says "20A? That you can actually buy? Nope. Predriver and discrete mosfets"

rusefillc, 2023-04-02:
https://830533.app.netsuite.com/core/media/media.nl?id=15177070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

[Data Sheet GenV PowerGate60 eWG.pdf](https://github.com/rusefi/rusefi-hardware/files/11133639/Data.Sheet.GenV.PowerGate60.eWG.pdf)

rusefillc, 2023-04-03:
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

rusefillc, 2023-04-06:
@Qwerty-OFF suggest we go (dual) IR2302

https://www.infineon.com/dgdl/Infineon-IR2302-DataSheet-v01_00-EN.pdf?fileId=5546d462533600a4015355c988b216de

rusefillc, 2023-04-10:
@Qwerty-OFF I have Infineon Technologies IR2302STRPBF JLCPCB Part #: C148147 coming

Qwerty-OFF, 2023-04-28:
ETB:
- ШИМ на SD1
- MOT1 управляется IN1, "0" - 0В; "1" - 12В
- MOT2 аналогично с IN2.
Чтобы крутить мотором IN1 и IN2 должны иметь противоположные значения.

HS/LS:
- IN определяет HS или LS будет ("0" - LS; "1" - HS)
- "1" на SD собственно активирует ключ
- Выход это OUT

Питание подается на GND и +12, не забудь подключить провод GND от Nucleo или что там будет в качестве тестовой платы.

Thread 186 (2023-03-26):

TLE9104SH breakout board

rusefillc, 2023-03-26:
Need a test PCB for https://www.infineon.com/dgdl/Infineon-TLE9104SH-DataSheet-v01_31-EN.pdf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

Same idea as https://github.com/rusefi/hw_modular/tree/master/TLE8110ED_breakout_board - just one component in the middle, nice silk and all the needed holes for 2.54"

PS: actually
A capacitor between pins VDD to GND and VIO to GND is recommended - please use 0805

Also 0805 0R for "EN pin has to be kept high to VIO"

mck1117, 2023-03-26:
https://github.com/mck1117/tle9104-breakout

mck1117, 2023-03-26:
I fabbed one and it works. RusEFI driver is implemented.

Closed 2023-03-26.

Thread 187 (2023-03-26):

Revive A4988

rusefillc, 2023-03-26:

rusefillc, 2023-03-26:
https://www.pololu.com/product/1182

https://www.pololu.com/picture/view/0J3359

I assume we do not need potentiometer?!

rusefillc, 2023-08-06:
@Ringenium хочется уточнить, что и как у нас с символом чипа? из стандарной библиотеки или его нужно куда-то аккуратно записать?

Thread 189 (2023-04-19):

spell out flash/RAM requirment

rusefillc, 2023-04-19:
STM32F103RCT6 shortage

what about

MFR.Part #
STM32F103R8T6
JLCPCB Part #
C46034
Package
LQFP-64(10x10)
Description
64KB ARM Cortex-M3 20KB 72MHz FLASH 51 LQFP-64(10x10) Microcontroller Units (MCUs/MPUs/SOCs) ROHS

Thread 195 (2023-05-13):

Gdi4: schematics blue comment VCC input range

rusefillc, 2023-05-13:
How high can +12v input go on gdi4 boards long term? Do we support 19v long term? 24v?

No need to raise li.it just need to document

Qwerty-OFF, 2023-05-13:
22V
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

Closed 2023-05-13.

Thread 196 (2023-05-13):

JLC to solder 2x2 UART and 1x6 headers

rusefillc, 2023-05-13:
let's add J1 into BOM:
4 2.54mm
https://jlcpcb.com/partdetail/boomele_boom_Precision_elec-C66690/C66690
C66690

and similar J4 1x6

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

Qwerty-OFF, 2023-05-13:
Done

rusefillc, 2023-05-15:
припаял ещё пять пинов - за три цента пусть лучше JLC

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

Qwerty-OFF, 2023-05-15:
Сделал его шестиконтактным чтобы не платить за еще один extended.
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

Closed 2023-05-15.

Thread 197 (2023-05-14):

GDI4: schematics notes on pump5,6 vs injector5,6

rusefillc, 2023-05-14:
we need to reduce confusion around special pump considerations on GDI4 board

* we need a TL,DR on why do we need hardware configuration resistors. what is fundamentally different between pump scenario and inj5,6 scenario?
* how many pumps? one or two? is it gasoline one pump and diesel potentially two pumps?
* which H5pump and L6pump I am confused. where is H7 and L5? which input touches what outputs?
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

* inputs/control lines: open question if we even need separate control signals
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

* R37 and R41 looks like we need a note that only one should be populated?

Closed 2023-05-14.

Thread 198 (2023-05-14):

remove IN_PUMP2, rename IN_PUMP1

rusefillc, 2023-05-14:
Follow-up for https://github.com/rusefi/rusefi-hardware/issues/197

* IN_PUMP2 makes no sense please remove it
* please rename IN_PUMP1 to just "IN_PUMP"
* we need a blue comment on the board: "This board could either drive 4 injectors and one SCV/PUMP, or 6 injectors. In 6 injectors mode we are limited at 120 degrees injection angle"

Relevant jumpers
* R87
* R37 and R41
* R88/R89

R37, R87 is DNP for 6ch mode

mck1117, 2023-05-14:
That text comment should also say which jumpers to move to be used in 6ch vs 4+1 mode

Qwerty-OFF, 2023-05-14:
Done
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

Closed 2023-05-14.

Thread 199 (2023-05-14):

Flip BOM from 6+0 to 4+1

rusefillc, 2023-05-14:
GDI4 is great as 4+1 mode and less great as 6+0 unit

Let's please flip default BOM see https://github.com/rusefi/rusefi-hardware/issues/198

Qwerty-OFF, 2023-05-14:
Done https://github.com/rusefi/rusefi-hardware/issues/198#issuecomment-1546845993

Closed 2023-05-14.

Thread 200 (2023-05-14):

GDI4: board ID

rusefillc, 2023-05-14:
looking to have two (maybe three, definitely not four) GDI4 on the same CAN bus network.

* is there any same stm32 pin between rev A and rev C I can use to distinguish between one unit of rev A (with mods if needed) and one unit of rev C (with mods if needed)
* shall we make ^^^ more convenient on rev D?

Qwerty-OFF, 2023-05-14:
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

Closed 2023-05-14.

Thread 201 (2023-05-15):

CAN and control line colors

rusefillc, 2023-05-15:
let's mention at least CAN and control line wiring colors right on the schematics

  - pin: 44a
    function: Injector Control 1
    color: green

  - pin: 45a
    function: Injector Control 5
    color: grey

  - pin: 46a
    function: Injector Control 3
    color: blue

  - pin: 47a
    function: Injector Control 6
    color: yellow

  - pin: 48a
    function: Injector Control 2
    color: white

  - pin: 49a
    function: Injector Control 4
    color: orange/brown

  - pin: 52a
    function: CAN High
    color: green

  - pin: 53a
    function: CAN Low
    color: blue

Qwerty-OFF, 2023-05-15:
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

Closed 2023-05-15.

Thread 204 (2023-05-16):

GDI4: battery voltage

rusefillc, 2023-05-16:
GDI4 firmware needs battery voltage - at the moment it just assumes 12 which is not fair

Technically we have a choice either to consume vbatt via CAN similar to original F042 WBO design or measure it on board

rusefillc, 2023-05-16:
@Qwerty-OFF before changing rev D schematics do I have an option to modify rev A or at least rev C hardware to measure on board?

rusefillc, 2023-05-16:
TODO: maybe do not bother with getVbatt() at all? only used for conditional restart, this does not seem to justify any effort

Closed 2023-05-16.

Thread 206 (2023-05-21):

тестовая плата VR или Hall

rusefillc, 2023-05-21:
Пока мы мучаемся https://github.com/andreika-git/hellen-one/issues/285 нужно сделать вариант попроще, понадёжнее и побыстрее

вместо одного универсального входного пина я согласен на три пина - 2*vr+1hall, с единым выходом на процессор

можем ли мы выход VR и выход hall просто XOR микросхемой 74 серии? в реальности будут либо VR подсоединены, либо hall - никогда не оба

* главный разъём 24 пина как на https://github.com/rusefi/alphax-2chan
* max9926 - два простых канала в стиле https://github.com/rusefi/rusefi-hardware/tree/main/classic-designs/frankenso
* два hall входа

* 1.5мм via для пайки 5v GND outputs проводов

Qwerty-OFF, 2023-05-24:
Распиновка 24 пина любая?
Светодиоды для индикации состояний линий поставить?

rusefillc, 2023-05-24:
Любая

Ставить

rusefillc, 2023-06-01:
всё-таки MAX9924

Thread 208 (2023-06-10):

GD4-D does not click pump since microcode expects START6 input not START5

rusefillc, 2023-06-10:
i have three boards assembled
all three boards click inj1 when I ground inj1 control line

all boards do not click same injector connected 82/83 and 84/85 when I ground pump control pin 41

rusefillc, 2023-06-10:
@Qwerty-OFF @NOx-z @mck1117 if I hook signal generator to pin 41 (proteus with self-stimulation) what easily accessible points can I probe on the board with what expected behavior?

Qwerty-OFF, 2023-06-10:
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

rusefillc, 2023-06-10:
signal reaches point 3
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

rusefillc, 2023-06-10:
q11 and r19 silence high level

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

rusefillc, 2023-06-10:
q12 r20 silence low level
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

rusefillc, 2023-06-10:
@NOx-z says it's a software issue it wants start6... not start5
I've tested rev A and got pump to click via R60 (start6 input)

rusefillc, 2023-06-10:
workaround: rev D clicks pump via injector 6 control line
proper fix later: microcode change

no HW changes planned for now

rusefillc, 2024-10-20:
Change of plan: let's forever stay as is with pump being controlled by START6.

Closed 2024-10-20.

Thread 209 (2023-06-12):

on real car, GDI4 fails to start if HPFP is connected

rusefillc, 2023-06-12:
real car. GDI rev 4 has two LEDs to blink
expected behavior: green OK led is blinking - it's really mostly

actual behavior: I power on or reset with HPFP it fails to init. Once HPFP disconnected it I have chip.init() working just fine

```
	isOverallHappyStatus = chip.init();

    while (true) {
        if (isOverallHappyStatus) {
            // happy board - green D21 blinking
            palTogglePad(LED_GREEN_PORT, LED_GREEN_PIN);
        } else {
            palTogglePad(LED_BLUE_PORT, LED_BLUE_PIN);
        }

```

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

rusefillc, 2023-06-12:
error codes https://github.com/rusefi/libfirmware/commit/11612c66a5609fe93aa760342d214bf415c92c1c

current error is UnderVoltage7 = 7

rusefillc, 2023-06-12:
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

rusefillc, 2023-06-12:
https://github.com/rusefi/libfirmware/commit/45ccd8e83eee4ff5dac05260f8546dc02a635c7d

status2=0x4000

Noxz
  [2:31 PM](https://rusefi.slack.com/archives/CFP3QAJCW/p1686594712283319)
basically it says that the VccP voltage was "stable" for a lesser amount of time than required before further booting

rusefillc, 2023-06-12:
@mck1117 says "what was happening is that with the added load(s) you were getting a transient during the reset that was tripping undervolt, and we never reset it"

Thread 210 (2023-06-12):

on real vehicle pump does not always click with manual control wire grounding

rusefillc, 2023-06-12:
see photo for test setup:
real car
two output harnesses: the one currently on the GDI goes to real car (injectors and HPFP 0.5ohm)
the unhooked one is a test harness with aux injector (1.5ohm) playing role of HPFP

I have aux injector always clicking when I ground yellow wire (injector 6)
real HPFP sometimes clicks sometimes it does not. I am unable to figure out any correlations with sequence of power on / timing / etc

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

Thread 211 (2023-06-27):

GDI4: pump output wire colors

rusefillc, 2023-06-27:
Similar to how pin 44 is marked green can we please

```
pin 82 white
pin 83 white
pin 84 green
pin 85 green
```

Thread 212 (2023-06-27):

GDI4: configuration persistence is flaky

rusefillc, 2023-06-27:
See https://github.com/rusefi/rusefi-hardware/commit/97b1435eabf42e53c21821e15a46776312de8b3c

I have configuration update counter logged into UART console

at the moment rusEFI requests calibration modifications via CAN bus and I see counter going up

problem: on "reset" too often I see values roll back to previous configuration in 80% of the cases

``
8000 10 HAPPY
``
here ``10`` is configuration version.

rusefillc, 2023-06-27:
shit I have GD32F103CBT6 C77979 chip

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

tried with
``
#define STM32_FLASH_WAIT_TIME_MS            300
``

but that did not help

rusefillc, 2023-06-27:
GD32 and STM32 Compatibility
https://easyelectronics.ru/img/ARM_kurs/STvsGD/Migration/compatibility%20sumup%20between%20GD32%20and%20STM32_V2.0.pdf

rusefillc, 2023-06-27:
test project works same good on both stm32 and GD32

https://github.com/rusefi/rusefi/commit/47d9642e8c83c27f26bff75702036486ef3294af
https://github.com/rusefi/rusefi/commit/19e032f6a82ff8243b5b811d612ced87ffa1a64b

rusefillc, 2023-06-27:
@dron0gus actually NO, looks like different behavior between stm32 and GD32. Do you have GDf103 and stm32f103 handy?

rusefillc, 2023-06-27:
@dron0gus actually I got even stm32 to not behave as I expect - just much much less often

expected behavior: UART shows incrementing counter, counter is persisted with reset/power cycle

actual behavior: stm32 would rarely reset counter to zero, gd32 would often reset to zero. neither chip gives me reliable persistent counter

rusefillc, 2023-06-28:
stm32
```

0.000   writes=1077     reboots=317

0.000   writes=1078     reboots=317

0.000   writes=1079     reboots=317

0.000   writes=1080     reboots=317

0.000   writes=1081     reboots=317

0.000   writes=1082     reboots=317

0.000   writes=1083     reboots=317
```

rusefillc, 2023-06-28:
gd32
```

0.000   writes=2        reboots=0

0.000   writes=3        reboots=0

▒0.001  writes=0        reboots=0

▒0.001  writes=0        reboots=0

0.000   writes=1        reboots=0

▒0.001  writes=0        reboots=0

▒0.001  writes=0        reboots=0

▒0.001  writes=0        reboots=0

0.000   writes=1        reboots=0

0.000   writes=2        reboots=0

0.000   writes=3        reboots=0

0.000   writes=4        reboots=0
```

Closed 2023-06-29.

Thread 213 (2023-06-28):

GDI4: switch to stm32 part number

rusefillc, 2023-06-28:
https://github.com/rusefi/rusefi-hardware/issues/212 is asking for an stm32 part number in BOM

Thread 214 (2023-07-07):

VR Hall works with both hall and VR

ElDominio, 2023-07-07:
Tested on Coyote intake cam and crank respectively

ElDominio, 2024-02-23:
i don't really understand what I tried to say. Intake is hall and crank is VR. This sounds like old 8chan tests which are no longer really relevant, okay to close?

Closed 2024-02-23.

Thread 218 (2023-07-14):

удвоить диаметры двух отверстий на Breakout_154pin_284617-1-Connector

rusefillc, 2023-07-14:
мне доступна только 284617-1 вариация разъёма с немного другипи пластиковыми пинами

* удвоить диаметр двух отверстий на футпринте и подвинуть центы как на картинке (с перекрытием старых отверстий)
* скорректировать плату Breakout_154pin_284617-1-Connector
* поменять шёлкографию версии на 0.5

Nadezhda-n, 2023-07-17:
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

> * скорректировать плату Breakout_154pin_284617-1-Connector

чего?

rusefillc, 2023-07-17:
> скорректировать плату Breakout_154pin_284617-1-Connector

ну в смысле трассы подвинуть? как могут я русская языка.

Nadezhda-n, 2023-07-24:
готово

Closed 2023-07-24.

Thread 219 (2023-07-15):

failing to export gerbers, failing to fail after failing to export gerbers

rusefillc, 2023-07-15:
I've created https://github.com/rusefi/rusefi-hardware/blob/main/.github/workflows/create-board.yaml just to export https://github.com/rusefi/rusefi-hardware/tree/main/breakout-boards/Breakout_154pin_284617-1-Connector for now

* it fails to export see error messages at https://github.com/rusefi/rusefi-hardware/actions/runs/5559778665/jobs/10156227662
* job is green even while it has failed

rusefillc, 2023-07-15:
@chuckwagoncomputing https://github.com/andreika-git/hellen-one/commit/447c4a6fb540b37780b0acbe156d1dfdeb3d21fb and https://github.com/andreika-git/hellen-one/commit/dac43765ba542b6783931610ce00454730465f52 but I am getting closer to the limit of my abilities here :)

rusefillc, 2023-07-15:
@chuckwagoncomputing I think I've fixed the "fails but does not fail job" part. What am I doing wrong with actual export here?...

rusefillc, 2023-07-15:
@chuckwagoncomputing I've made some progress looks like VRML export is failing?

chuckwagoncomputing, 2023-07-15:
It's showing an error, but the ExportVRML_File function is reporting success, and it's outputting a VRML file. Is the file not correct?

chuckwagoncomputing, 2023-07-15:
When I view the vrml file with https://imagetostl.com/view-vrml-online I get:
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
We've got some pins hovering over the board:
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
But it was even worse before: (https://github.com/rusefi/hellen88bmw/blob/1b9764f3ea59727ad798e16315f23c75de213dfd/boards/hellen88bmw-c/board/misc/hellen88bmw-c-3D.wrl.gz)
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

chuckwagoncomputing, 2023-07-15:
I think the problem here is that you're calling ext/hellen-one/bin/gha-commit.sh which doesn't make sense here, and you're calling it from the repo root rather than the directory of the board you're trying to generate gerbers for.
The result is that the files in the gerber/ directory aren't added to the commit.

rusefillc, 2023-07-15:
@chuckwagoncomputing great point about working dir for gha-commit.sh https://github.com/rusefi/rusefi-hardware/commit/972b37d1d3b69887e014d990000338ca0ea70216

rusefillc, 2023-07-15:
@chuckwagoncomputing my focus was the assert message I was assuming that it's something bad?

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

rusefillc, 2023-07-15:
looks like we do not care about assert message?

Closed 2023-07-15.

Thread 221 (2023-07-19):

GDI4 runs out of juice

rusefillc, 2023-07-19:
user report:
boost voltage setting 40v
user has one proteus with two GDI4 boxes (8 injectors sequential) for a GDI flow bench

at 3000RPM 2.5ms injector pulses 39v volts are observed at peak voltage as EXPECTED
at 4000rpm voltage drops to 30v, that's an ISSUE

Qwerty-OFF, 2023-07-19:
Это измерение напряжения на форсунке или на тестовой точке высокого напряжения на плате? Хочу узнать что в этой точке:
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

rusefillc, 2023-07-19:
@Qwerty-OFF GDI4 case is closed that's on injector wires

rusefillc, 2023-08-18:
rev D

no activity
vboost=64.7v

low RPM bench
vboost=64.7v

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

1200 RPM
vboost=64.7v

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

rusefillc, 2023-08-18:
there is a very sharp drop of vboost around 5200 rpm

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

4900 everything pretty fine
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

5100
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

5300 rpm
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

rusefillc, 2023-08-18:
just attempted bumping max boost time from 400 to 600 us, did not help. tried bumping max current targer from 13A to 15A I think it made matters worse

reducing boostCurrent to 10A has helped - there is no more voltage drop

mck1117, 2023-08-18:
> reducing boostCurrent to 10A has helped - there is no more voltage drop

this suggests that the inductor was saturating at 13A

rusefillc, 2023-08-18:
> this suggests that the inductor was saturating at 13A

what is the right way to improve things? do I change inductor or just change default boostCurrent and live happily ever after?

mck1117, 2023-08-18:
Wait - I read that wrong, I thought you were adjusting the SMPS parameters, not the injector parameters. Changing the boost current will change the injector's opening time and potentially other things.

> max boost time from 400 to 600 us

This just _allows_ the injector to take that amount of time for the boost threshold to be reached, it doesn't change behavior at all so long as the injector hits the current limit faster than that time.

rusefillc, 2023-08-18:
@mck1117 I was changing the below I assume I was _not_ changing injector parameters?

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

mck1117, 2023-08-18:
Those are absolutely injector parameters. They control the behavior during the boost phase of the injection (high current "slam it open" part).

rusefillc, 2023-08-18:
Are "boost current target" and "peak phase current target" both injector parameters? I was assuming that only the latter is directly related to individual injector control while "boost current target" is something to do with DCDC core same as boost voltage is a DCDC setting?

rusefillc, 2023-08-18:
current plan is to try https://www.mouser.com/ProductDetail/EPCOS-TDK/B82559A5103A033?qs=amGC7iS6iy9mEhDlIgUEKA%3D%3D  Power Inductors - SMD 10uH 12% 1.2mOhm ERU33 AEC-Q200

@kb1gtt @NOx-z do you guys have opinions on what could be going on here?

NOx-z, 2023-08-18:
I would like to see the vboost (pin) on an oscilloscope as multimeters are slow and don't give the full story..

we may be able to setup `vboost_mon_en` which can set an IRQ (a certain pin, maybe) for when undervoltage of VBoost occurs, so we can detect/flag/log on this issue.

We have two additional settings, at least in the microcode, (I do not know if they are accessed elsewhere ) for the current sensing of the dc-dc converter:
#define Isense4_high 2;
#define Isense4_low 3;

We may be able to tweak those to allow more current, but we should do more research into this before just setting new values.

I am reviewing some of the microcode now.

rusefillc, 2023-08-18:
@NOx-z current L2 is https://jlcpcb.com/partdetail/bc_bao_Cheng_elec-BCIHP1770100M/C237980 see https://github.com/rusefi/rusefi-hardware/blob/main/GDI-4ch/gerber/rev.%20d/bom.csv

rusefillc, 2023-08-19:
happy 3000 rpm

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

rusefillc, 2023-08-19:
unhappy 5300

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

rusefillc, 2023-08-19:
sad 5300 video - note how thing are slowly falling down

https://youtu.be/iUY8sWQcSHo

rusefillc, 2023-08-19:
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

rusefillc, 2023-08-19:
with magic byte adjustment

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

rusefillc, 2023-08-19:
See https://github.com/rusefi/libfirmware/pull/8 for solution

NOx-z, 2023-08-19:
This magic byte was the Isense4_high in the microcode dram, which is not exposed to the GDI configuration as it is specific to the DI board and not someone's car. The value was changed from ~3.6Amps to ~6.5Amps.. we should spend a little time in the future really tweaking this setting, but this quick change resolved the issue

rusefillc, 2023-08-20:
https://github.com/rusefi/libfirmware/pull/9

Closed 2023-08-20.

Thread 222 (2023-07-23):

Toggle digital outputs

rusefillc, 2023-07-23:
Need to expand https://github.com/rusefi/rusefi-hardware/tree/main/digital-inputs with the following logic

We need an eight second digital output cycle
* for first 1000ms toggle digital output pin 1 every 100ms the rest of the pins stay inactive
* for second 1000ms toggle digital output pin 2 every 100ms the rest of the pins stay inactive
* etc

First step is actually selecting eight pins on 144 pin STM32 Nucleo-F429ZI which we can toggle without any interference from other hardware on STM32 Nucleo-F429ZI and not yet used by existing https://github.com/rusefi/rusefi-hardware/tree/main/digital-inputs

andreika-git, 2023-08-26:
https://github.com/rusefi/rusefi-hardware/commit/9102e4aaa8623208acc5154430aec9aa0e09fa7d

rusefillc, 2023-08-30:
See #243

rusefillc, 2023-08-30:
самое полезное сейчас - провалидировать счётчики событий, полученный по CAN

```
  ADC says LOW 13@1 0.001v
               sending line=13 value=1
               sending line=13 value=0
GOOD channel 13
               Setting ADDR 13
               sending line=14 value=1
  ADC says HIGH 14@0 2.833v
               sending line=14 value=0
  ADC says LOW 14@1 0.001v
               sending line=14 value=1
               sending line=14 value=0
GOOD channel 14
               Setting ADDR 14
               sending line=15 value=1
  ADC says HIGH 15@0 2.831v
               sending line=15 value=0
  ADC says LOW 15@1 0.001v
               sending line=15 value=1
               sending line=15 value=0
GOOD channel 15
               Setting ADDR 15
               sending line=16 value=1
  ADC says HIGH 16@0 2.833v
               sending line=16 value=0
  ADC says LOW 16@1 0.001v
               sending line=16 value=1
               sending line=16 value=0
GOOD channel 16
               Setting ADDR 0
               sending line=17 value=1
  ADC says LOW 17@0 1.088v
ERROR! Cycle 17@0 FAILED! (set 1, received 0 1.088v)
               sending line=17 value=0
               sending line=17 value=1
ERROR! Cycle 17@2 FAILED! (set 1, received 0 1.087v)
               sending line=17 value=0
!!!!!!!! BAD channel 17 !!!!!!!!!!!!!!!
               Setting ADDR 1
               sending line=18 value=1
  ADC says LOW 18@0 1.087v
ERROR! Cycle 18@0 FAILED! (set 1, received 0 1.087v)
               sending line=18 value=0
               sending line=18 value=1
ERROR! Cycle 18@2 FAILED! (set 1, received 0 1.086v)
               sending line=18 value=0
!!!!!!!! BAD channel 18 !!!!!!!!!!!!!!!
 ************* SOMETHING BAD SEE ABOVE ************************
 ++++++++++++++++ numOutputs 18
               Setting ADDR 0
               sending line=1 value=1
  ADC says HIGH 1@0 2.829v
               sending line=1 value=0
  ADC says LOW 1@1 0.002v
               sending line=1 value=1
  ADC says HIGH 2@0 2.841v
               sending line=2 value=0
  ADC says LOW 2@1 0.004v
               sending line=2 value=1
               sending line=2 value=0
GOOD channel 2
               Setting ADDR 2
               sending line=3 value=1
  ADC says HIGH 3@0 2.843v
               sending line=3 value=0
  ADC says LOW 3@1 0.003v
               sending line=3 value=1
               sending line=3 value=0
GOOD channel 3
               Setting ADDR 3
               sending line=4 value=1
  ADC says HIGH 4@0 2.841v
               sending line=4 value=0
  ADC says LOW 4@1 0.003v
               sending line=4 value=1
               sending line=4 value=0
GOOD channel 4
               Setting ADDR 4
               sending line=5 value=1
  ADC says HIGH 5@0 2.843v
               sending line=5 value=0
  ADC says LOW 5@1 0.003v
               sending line=5 value=1
               sending line=5 value=0
GOOD channel 5
               Setting ADDR 5
               sending line=6 value=1
  ADC says HIGH 6@0 2.843v
               sending line=6 value=0
  ADC says LOW 6@1 0.002v
               sending line=6 value=1
               sending line=6 value=0
GOOD channel 6
               Setting ADDR 6
               sending line=7 value=1
  ADC says HIGH 7@0 2.844v
               sending line=7 value=0
  ADC says LOW 7@1 0.004v
               sending line=7 value=1
               sending line=7 value=0
GOOD channel 7
               Setting ADDR 7
               sending line=8 value=1
  ADC says HIGH 8@0 2.844v
               sending line=8 value=0
  ADC says LOW 8@1 0.003v
               sending line=8 value=1
               sending line=8 value=0
GOOD channel 8
               Setting ADDR 8
               sending line=9 value=1
  ADC says HIGH 9@0 2.841v
               sending line=9 value=0
  ADC says LOW 9@1 0.003v
               sending line=9 value=1
               sending line=9 value=0
GOOD channel 9
               Setting ADDR 9
               sending line=10 value=1
  ADC says HIGH 10@0 2.839v
               sending line=10 value=0
  ADC says LOW 10@1 0.003v
               sending line=10 value=1
               sending line=10 value=0
GOOD channel 10
               Setting ADDR 10
               sending line=11 value=1
  ADC says HIGH 11@0 2.839v
               sending line=11 value=0
  ADC says LOW 11@1 0.003v
               sending line=11 value=1
               sending line=11 value=0
GOOD channel 11
               Setting ADDR 11
               sending line=12 value=1
  ADC says HIGH 12@0 2.839v
               sending line=12 value=0
  ADC says LOW 12@1 0.003v
               sending line=12 value=1
               sending line=12 value=0
GOOD channel 12
               Setting ADDR 12
               sending line=13 value=1
  ADC says HIGH 13@0 2.843v
               sending line=13 value=0
  ADC says LOW 13@1 0.002v
               sending line=13 value=1
               sending line=13 value=0
GOOD channel 13
               Setting ADDR 13
               sending line=14 value=1
  ADC says HIGH 14@0 2.843v
               sending line=14 value=0
  ADC says LOW 14@1 0.002v
               sending line=14 value=1
               sending line=14 value=0
GOOD channel 14
               Setting ADDR 14
               sending line=15 value=1
  ADC says HIGH 15@0 2.844v
               sending line=15 value=0
  ADC says LOW 15@1 0.001v
               sending line=15 value=1
               sending line=15 value=0
GOOD channel 15
               Setting ADDR 15
               sending line=16 value=1
  ADC says HIGH 16@0 2.846v
               sending line=16 value=0
  ADC says LOW 16@1 0.001v
               sending line=16 value=1
               sending line=16 value=0
GOOD channel 16
               Setting ADDR 0
               sending line=17 value=1
  ADC says HIGH 17@0 1.087v
               sending line=17 value=0
  ADC says LOW 17@1 0.003v
               sending line=17 value=1
               sending line=17 value=0
GOOD channel 17
               Setting ADDR 1
               sending line=18 value=1
  ADC says HIGH 18@0 1.087v
               sending line=18 value=0
  ADC says LOW 18@1 0.003v
               sending line=18 value=1
               sending line=18 value=0
GOOD channel 18
 ************* ALL GOOD ************************
 ++++++++++++++++ numOutputs 18
               Setting ADDR 0
               sending line=1 value=1
  ADC says HIGH 1@0 2.840v
               sending line=1 value=0
  ADC says LOW 1@1 0.002v
               sending line=1 value=1
               sending line=1 value=0
GOOD channel 1
               Setting ADDR 1
               sending line=2 value=1
  ADC says HIGH 2@0 2.839v
               sending line=2 value=0
  ADC says LOW 2@1 0.002v
               sending line=2 value=1
               sending line=2 value=0
GOOD channel 2
               Setting ADDR 2
               sending line=3 value=1
  ADC says HIGH 3@0 2.839v
               sending line=3 value=0
GOOD channel 7
               Setting ADDR 7
               sending line=8 value=1
  ADC says HIGH 8@0 2.821v
               sending line=8 value=0
  ADC says LOW 8@1 0.004v
               sending line=8 value=1
               sending line=8 value=0
GOOD channel 8
               Setting ADDR 8
               sending line=9 value=1 * BAD channel 0 (TPS1_1): voltage 0.000000000 (raw 0) not in range (0.462500000..0.537500032)
 * BAD channel 4 (MAP): voltage 0.000000000 (raw 0) not in range (0.555000000..0.645000064)
 * BAD channel 5 (CLT): voltage 0.000000000 (raw 0) not in range (1.968085184..2.287234080)
 * BAD channel 6 (IAT): voltage 0.000000000 (raw 0) not in range (1.250000000..1.452702752)
 * BAD channel 7 (BATT): voltage 0.000000000 (raw 0) not in range (9.000000000..15.000000000)
  ADC says HIGH 9@0 2.841v
               sending line=9 value=0
  ADC says LOW 9@1 0.003v
               sending line=9 value=1
               sending line=9 value=0
GOOD channel 9
               Setting ADDR 9
               sending line=10 value=1
  ADC says HIGH 10@0 2.843v
               sending line=10 value=0
  ADC says LOW 10@1 0.002v
               sending line=10 value=1
               sending line=10 value=0
GOOD channel 10
               Setting ADDR 10
               sending line=11 value=1
  ADC says HIGH 11@0 2.843v
               sending line=11 value=0
  ADC says LOW 11@1 0.002v
               sending line=11 value=1
               sending line=11 value=0
GOOD channel 11
               Setting ADDR 11
               sending line=12 value=1
  ADC says HIGH 12@0 2.843v
               sending line=12 value=0
  ADC says LOW 12@1 0.003v
               sending line=12 value=1
               sending line=12 value=0
GOOD channel 12
               Setting ADDR 12
               sending line=13 value=1
  ADC says HIGH 13@0 2.845v
               sending line=13 value=0
  ADC says LOW 13@1 0.002v
               sending line=13 value=1
               sending line=13 value=0
GOOD channel 13
               Setting ADDR 13
               sending line=14 value=1
  ADC says HIGH 14@0 2.848v
               sending line=14 value=0
  ADC says LOW 14@1 0.001v
               sending line=14 value=1
               sending line=14 value=0
GOOD channel 14
               Setting ADDR 14
               sending line=15 value=1
  ADC says HIGH 15@0 2.844v
               sending line=15 value=0
  ADC says LOW 15@1 0.002v
               sending line=15 value=1
               sending line=15 value=0
GOOD channel 15
               Setting ADDR 15
               sending line=16 value=1
  ADC says HIGH 16@0 2.844v
               sending line=16 value=0
  ADC says LOW 16@1 0.002v
               sending line=16 value=1
               sending line=16 value=0
GOOD channel 16
               Setting ADDR 0
               sending line=17 value=1
  ADC says HIGH 17@0 1.123v
               sending line=17 value=0
  ADC says LOW 17@1 0.045v
               sending line=17 value=1
               sending line=17 value=0
GOOD channel 17
               Setting ADDR 1
               sending line=18 value=1
  ADC says HIGH 18@0 1.123v
               sending line=18 value=0
  ADC says LOW 18@1 0.045v
               sending line=18 value=1
               sending line=18 value=0
GOOD channel 18
 ************* SOMETHING BAD SEE ABOVE ************************
 ++++++++++++++++ numOutputs 32
               Setting ADDR 0
               sending line=1 value=1
  ADC says HIGH 1@0 2.839v
               sending line=1 value=0
  ADC says LOW 1@1 0.003v
               sending line=1 value=1
               sending line=1 value=0
GOOD channel 1
               Setting ADDR 1
               sending line=2 value=1
  ADC says HIGH 2@0 2.842v
               sending line=2 value=0
  ADC says LOW 2@1 0.003v
               sending line=2 value=1
               sending line=2 value=0
GOOD channel 2
               Setting ADDR 2
               sending line=3 value=1
  ADC says HIGH 3@0 2.842v
               sending line=3 value=0
  ADC says LOW 3@1 0.003v
               sending line=3 value=1
               sending line=3 value=0
GOOD channel 3
               Setting ADDR 3
               sending line=4 value=1
  ADC says HIGH 4@0 2.841v
               sending line=4 value=0
  ADC says LOW 4@1 0.003v
               sending line=4 value=1
               sending line=4 value=0
GOOD channel 4
               Setting ADDR 4
               sending line=5 value=1
  ADC says HIGH 5@0 2.843v
               sending line=5 value=0
  ADC says LOW 5@1 0.003v
               sending line=5 value=1
               sending line=5 value=0
GOOD channel 5
               Setting ADDR 5
               sending line=6 value=1
  ADC says HIGH 6@0 2.845v
               sending line=6 value=0
  ADC says LOW 6@1 0.002v
               sending line=6 value=1
               sending line=6 value=0
GOOD channel 6
               Setting ADDR 6
               sending line=7 value=1
  ADC says HIGH 7@0 2.844v
               sending line=7 value=0
  ADC says LOW 7@1 0.004v
               sending line=7 value=1
               sending line=7 value=0
GOOD channel 7
               Setting ADDR 7
               sending line=8 value=1
  ADC says HIGH 8@0 2.843v
               sending line=8 value=0
  ADC says LOW 8@1 0.003v
               sending line=8 value=1
               sending line=8 value=0
GOOD channel 8
               Setting ADDR 8
               sending line=9 value=1
  ADC says HIGH 9@0 2.841v
               sending line=9 value=0
  ADC says LOW 9@1 0.003v
               sending line=9 value=1
               sending line=9 value=0
GOOD channel 9
               Setting ADDR 9
               sending line=10 value=1
  ADC says HIGH 10@0 2.841v
               sending line=10 value=0
  ADC says LOW 10@1 0.003v
               sending line=10 value=1
               sending line=10 value=0
GOOD channel 10
               Setting ADDR 10
               sending line=11 value=1
  ADC says HIGH 11@0 2.840v
               sending line=11 value=0
  ADC says LOW 11@1 0.003v
               sending line=11 value=1
               sending line=11 value=0
GOOD channel 11
               Setting ADDR 11
               sending line=12 value=1
  ADC says HIGH 12@0 2.840v
               sending line=12 value=0
  ADC says LOW 12@1 0.003v
               sending line=12 value=1
               sending line=12 value=0
GOOD channel 12
               Setting ADDR 12
               sending line=13 value=1
  ADC says HIGH 13@0 2.844v
               sending line=13 value=0
  ADC says LOW 13@1 0.002v
               sending line=13 value=1
               sending line=13 value=0
GOOD channel 13
               Setting ADDR 13
               sending line=14 value=1
  ADC says HIGH 14@0 2.843v
               sending line=14 value=0
  ADC says LOW 14@1 0.002v
               sending line=14 value=1
               sending line=14 value=0
GOOD channel 14
               Setting ADDR 14
               sending line=15 value=1
  ADC says HIGH 15@0 2.843v
               sending line=15 value=0
  ADC says LOW 15@1 0.002v
               sending line=15 value=1
               sending line=15 value=0
GOOD channel 15
               Setting ADDR 15
               sending line=16 value=1
  ADC says HIGH 16@0 2.844v
               sending line=16 value=0
  ADC says LOW 16@1 0.002v
               sending line=16 value=1
               sending line=16 value=0
GOOD channel 16
               Setting ADDR 0
               sending line=17 value=1
  ADC says HIGH 17@0 1.085v
               sending line=17 value=0
  ADC says LOW 17@1 0.002v
               sending line=17 value=1
               sending line=17 value=0
GOOD channel 17
               Setting ADDR 1
               sending line=18 value=1
  ADC says HIGH 18@0 1.084v
               sending line=18 value=0
  ADC says LOW 18@1 0.002v
               sending line=18 value=1
               sending line=18 value=0
GOOD channel 18
               Setting ADDR 2
               sending line=19 value=1
  ADC says HIGH 19@0 1.082v
               sending line=19 value=0
  ADC says LOW 19@1 0.003v
               sending line=19 value=1
               sending line=19 value=0
GOOD channel 19
               Setting ADDR 3
               sending line=20 value=1
  ADC says HIGH 20@0 1.085v
               sending line=20 value=0
  ADC says LOW 20@1 0.002v
               sending line=20 value=1
               sending line=20 value=0
GOOD channel 20
               Setting ADDR 4
               sending line=21 value=1
  ADC says HIGH 21@0 1.079v
               sending line=21 value=0
  ADC says LOW 21@1 0.003v
               sending line=21 value=1
               sending line=21 value=0
GOOD channel 21
               Setting ADDR 5
               sending line=22 value=1
  ADC says HIGH 22@0 1.081v
               sending line=22 value=0
  ADC says LOW 22@1 0.003v
               sending line=22 value=1
               sending line=22 value=0
GOOD channel 22
               Setting ADDR 6
               sending line=23 value=1
  ADC says HIGH 23@0 1.084v
               sending line=23 value=0
  ADC says LOW 23@1 0.002v
               sending line=23 value=1
               sending line=23 value=0
GOOD channel 23
               Setting ADDR 7
               sending line=24 value=1
  ADC says HIGH 24@0 1.086v
               sending line=24 value=0
  ADC says LOW 24@1 0.003v
               sending line=24 value=1
               sending line=24 value=0
GOOD channel 24
               Setting ADDR 8
               sending line=25 value=1
  ADC says HIGH 25@0 1.084v
               sending line=25 value=0
  ADC says LOW 25@1 0.003v
               sending line=25 value=1
               sending line=25 value=0
GOOD channel 25
               Setting ADDR 9
               sending line=26 value=1
  ADC says HIGH 26@0 1.087v
               sending line=26 value=0
  ADC says LOW 26@1 0.002v
               sending line=26 value=1
               sending line=26 value=0
GOOD channel 26
               Setting ADDR 10
               sending line=27 value=1
  ADC says HIGH 27@0 1.086v
               sending line=27 value=0
  ADC says LOW 27@1 0.002v
               sending line=27 value=1
               sending line=27 value=0
GOOD channel 27
               Setting ADDR 11
               sending line=28 value=1
  ADC says HIGH 28@0 1.087v
               sending line=28 value=0
  ADC says LOW 28@1 0.002v
               sending line=28 value=1
               sending line=28 value=0
GOOD channel 28
               Setting ADDR 12
               sending line=29 value=1
  ADC says HIGH 29@0 2.818v
               sending line=29 value=0
  ADC says LOW 29@1 0.002v
               sending line=29 value=1
               sending line=29 value=0
GOOD channel 29
               Setting ADDR 13
               sending line=30 value=1
  ADC says HIGH 30@0 2.818v
               sending line=30 value=0
  ADC says LOW 30@1 0.002v
               sending line=30 value=1
               sending line=30 value=0
GOOD channel 30
               Setting ADDR 14
               sending line=31 value=1
  ADC says HIGH 31@0 2.818v
               sending line=31 value=0
  ADC says LOW 31@1 0.003v
               sending line=31 value=1
               sending line=31 value=0
GOOD channel 31
               Setting ADDR 15
               sending line=32 value=1
  ADC says HIGH 32@0 2.819v
               sending line=32 value=0
  ADC says LOW 32@1 0.002v
               sending line=32 value=1
               sending line=32 value=0
GOOD channel 32
 ************* ALL GOOD ************************
 ++++++++++++++++ numOutputs 32
               Setting ADDR 0
               sending line=1 value=1
  ADC says HIGH 1@0 2.841v
               sending line=1 value=0
  ADC says LOW 1@1 0.003v
               sending line=1 value=1
               sending line=1 value=0
GOOD channel 1
               Setting ADDR 1
               sending line=2 value=1
  ADC says HIGH 2@0 2.842v
               sending line=2 value=0
  ADC says LOW 2@1 0.002v
               sending line=2 value=1
               sending line=2 value=0
GOOD channel 2
               Setting ADDR 2
               sending line=3 value=1
Processing BENCH_TEST_EVENT_COUNTERS ID=770000/l=8 14 14 14 14 0 0 A 0
Processing BENCH_TEST_RAW_ANALOG ID=770001/l=8 1B 0 0 0 20 72 44 42
  ADC says LOW 13@1 0.001v
               sending line=13 value=1
Processing BENCH_TEST_IO_META_INFO ID=770005/l=8 66 0 20 10 0 0 0 0
       CAN RX outputCount total=32 low=16
Processing BENCH_TEST_BOARD_STATUS ID=770003/l=8 F0 22 0 3 A7 0 49 0
       CAN RX BoardStatus: BoardID=61474 numSecs=935
Processing BENCH_TEST_BUTTON_COUNTERS ID=770004/l=8 15 0 0 0 0 0 0 0
Processing BENCH_TEST_EVENT_COUNTERS ID=770000/l=8 14 14 14 14 0 0 A 0
Processing BENCH_TEST_RAW_ANALOG ID=770001/l=8 1B 0 0 0 20 72 44 42
Processing BENCH_TEST_EVENT_COUNTERS ID=770000/l=8 14 14 14 14 0 0 A 0
Processing BENCH_TEST_RAW_ANALOG ID=770001/l=8 1B 0 0 0 20 72 44 42
GOOD channel 13
               Setting ADDR 13
               sending line=14 value=1
Processing BENCH_TEST_IO_META_INFO ID=770005/l=8 66 0 20 10 0 0 0 0
       CAN RX outputCount total=32 low=16
Processing BENCH_TEST_BOARD_STATUS ID=770003/l=8 F0 22 0 3 AB 0 49 0
       CAN RX BoardStatus: BoardID=61474 numSecs=939
Processing BENCH_TEST_BUTTON_COUNTERS ID=770004/l=8 15 0 0 0 0 0 0 0
Processing BENCH_TEST_EVENT_COUNTERS ID=770000/l=8 14 14 14 14 0 0 A 0
Processing BENCH_TEST_RAW_ANALOG ID=770001/l=8 1B 0 0 0 20 72 44 42
  ADC says HIGH 14@0 2.843v
               sending line=14 value=0
Processing BENCH_TEST_EVENT_COUNTERS ID=770000/l=8 14 14 14 14 0 0 A 0
Processing BENCH_TEST_RAW_ANALOG ID=770001/l=8 1B 0 0 0 20 72 44 42
  ADC says LOW 14@1 0.002v
               sending line=14 value=1
Processing BENCH_TEST_EVENT_COUNTERS ID=770000/l=8 14 14 14 14 0 0 A 0
Processing BENCH_TEST_RAW_ANALOG ID=770001/l=8 1B 0 0 0 20 72 44 42
Processing BENCH_TEST_IO_META_INFO ID=770005/l=8 66 0 20 10 0 0 0 0
       CAN RX outputCount total=32 low=16
               sending line=14 value=0
Processing BENCH_TEST_BOARD_STATUS ID=770003/l=8 F0 22 0 3 AB 0 49 0
       CAN RX BoardStatus: BoardID=61474 numSecs=939
Processing BENCH_TEST_BUTTON_COUNTERS ID=770004/l=8 15 0 0 0 0 0 0 0
Processing BENCH_TEST_EVENT_COUNTERS ID=770000/l=8 14 14 14 14 0 0 A 0
Processing BENCH_TEST_RAW_ANALOG ID=770001/l=8 1B 0 0 0 20 72 44 42
GOOD channel 14
               Setting ADDR 14
               sending line=15 value=1
Processing BENCH_TEST_EVENT_COUNTERS ID=770000/l=8 14 14 14 14 0 0 A 0
Processing BENCH_TEST_RAW_ANALOG ID=770001/l=8 1B 0 0 0 20 72 44 42
  ADC says HIGH 15@0 2.841v
               sending line=15 value=0
Processing BENCH_TEST_IO_META_INFO ID=770005/l=8 66 0 20 10 0 0 0 0
       CAN RX outputCount total=32 low=16
Processing BENCH_TEST_BOARD_STATUS ID=770003/l=8 F0 22 0 3 AB 0 49 0
       CAN RX BoardStatus: BoardID=61474 numSecs=939
Processing BENCH_TEST_BUTTON_COUNTERS ID=770004/l=8 15 0 0 0 0 0 0 0
Processing BENCH_TEST_EVENT_COUNTERS ID=770000/l=8 14 14 14 14 0 0 A 0
Processing BENCH_TEST_RAW_ANALOG ID=770001/l=8 1B 0 0 0 20 72 44 42
  ADC says LOW 15@1 0.001v
               sending line=15 value=1
Processing BENCH_TEST_EVENT_COUNTERS ID=770000/l=8 14 14 14 14 0 0 A 0
Processing BENCH_TEST_RAW_ANALOG ID=770001/l=8 1B 0 0 0 20 72 44 42
               sending line=15 value=0
Processing BENCH_TEST_EVENT_COUNTERS ID=770000/l=8 14 14 14 14 0 0 A 0
Processing BENCH_TEST_RAW_ANALOG ID=770001/l=8 1B 0 0 0 20 72 44 42
Processing BENCH_TEST_IO_META_INFO ID=770005/l=8 66 0 20 10 0 0 0 0
       CAN RX outputCount total=32 low=16
GOOD channel 15
               Setting ADDR 15
               Processing BENCH_TEST_BOARD_STATUS ID=770003/l=8 F0 22 0 3 AB 0 49 0
       CAN RX BoardStatus: BoardID=61474 numSecs=939
sending line=16 value=1
Processing BENCH_TEST_BUTTON_COUNTERS ID=770004/l=8 15 0 0 0 0 0 0 0
Processing BENCH_TEST_EVENT_COUNTERS ID=770000/l=8 14 14 14 14 0 0 A 0
Processing BENCH_TEST_RAW_ANALOG ID=770001/l=8 1B 0 0 0 20 72 44 42
  ADC says HIGH 16@0 2.842v
               sending line=16 value=0
Processing BENCH_TEST_EVENT_COUNTERS ID=770000/l=8 14 14 14 14 0 0 A 0
Processing BENCH_TEST_RAW_ANALOG ID=770001/l=8 1B 0 0 0 20 72 44 42
  ADC says LOW 16@1 0.002v
               sending line=16 value=1
Processing BENCH_TEST_IO_META_INFO ID=770005/l=8 66 0 20 10 0 0 0 0
       CAN RX outputCount total=32 low=16
Processing BENCH_TEST_BOARD_STATUS ID=770003/l=8 F0 22 0 3 AC 0 49 0
       CAN RX BoardStatus: BoardID=61474 numSecs=940
Processing BENCH_TEST_BUTTON_COUNTERS ID=770004/l=8 15 0 0 0 0 0 0 0
Processing BENCH_TEST_EVENT_COUNTERS ID=770000/l=8 14 14 14 14 0 0 A 0
Processing BENCH_TEST_RAW_ANALOG ID=770001/l=8 1B 0 0 0 20 72 44 42
               sending line=16 value=0
Processing BENCH_TEST_EVENT_COUNTERS ID=770000/l=8 14 14 14 14 0 0 A 0
Processing BENCH_TEST_RAW_ANALOG ID=770001/l=8 1B 0 0 0 20 72 44 42
GOOD channel 16
               Setting ADDR 0
               sending line=17 value=1
Processing BENCH_TEST_EVENT_COUNTERS ID=770000/l=8 14 14 14 14 0 0 A 0
Processing BENCH_TEST_RAW_ANALOG ID=770001/l=8 1B 0 0 0 20 72 44 42
Processing BENCH_TEST_IO_META_INFO ID=770005/l=8 66 0 20 10 0 0 0 0
       CAN RX outputCount total=32 low=16
Processing BENCH_TEST_BOARD_STATUS ID=770003/l=8 F0 22 0 3 AC 0 49 0
       CAN RX BoardStatus: BoardID=61474 numSecs=940
  ADC says HIGH 17@0 1.086v
               sending line=17 value=0
Processing BENCH_TEST_BUTTON_COUNTERS ID=770004/l=8 15 0 0 0 0 0 0 0
Processing BENCH_TEST_EVENT_COUNTERS ID=770000/l=8 14 14 14 14 0 0 A 0
Processing BENCH_TEST_RAW_ANALOG ID=770001/l=8 1B 0 0 0 20 72 44 42
  ADC says LOW 17@1 0.002v
               sending line=17 value=1
Processing BENCH_TEST_EVENT_COUNTERS ID=770000/l=8 14 14 14 14 0 0 A 0
Processing BENCH_TEST_RAW_ANALOG ID=770001/l=8 1B 0 0 0 20 72 44 42
               sending line=17 value=0
Processing BENCH_TEST_IO_META_INFO ID=770005/l=8 66 0 20 10 0 0 0 0
       CAN RX outputCount total=32 low=16
Processing BENCH_TEST_BOARD_STATUS ID=770003/l=8 F0 22 0 3 AC 0 49 0
       CAN RX BoardStatus: BoardID=61474 numSecs=940
Processing BENCH_TEST_BUTTON_COUNTERS ID=770004/l=8 15 0 0 0 0 0 0 0
Processing BENCH_TEST_EVENT_COUNTERS ID=770000/l=8 14 14 14 14 0 0 A 0
Processing BENCH_TEST_RAW_ANALOG ID=770001/l=8 1B 0 0 0 20 72 44 42
GOOD channel 17
               Setting ADDR 1
               sending line=18 value=1
Processing BENCH_TEST_EVENT_COUNTERS ID=770000/l=8 14 14 14 14 0 0 A 0
Processing BENCH_TEST_RAW_ANALOG ID=770001/l=8 1B 0 0 0 20 72 44 42
  ADC says HIGH 18@0 1.085v
               sending line=18 value=0
Processing BENCH_TEST_EVENT_COUNTERS ID=770000/l=8 14 14 14 14 0 0 A 0
Processing BENCH_TEST_RAW_ANALOG ID=770001/l=8 1B 0 0 0 20 72 44 42
Processing BENCH_TEST_IO_META_INFO ID=770005/l=8 66 0 20 10 0 0 0 0
       CAN RX outputCount total=32 low=16
Processing BENCH_TEST_BOARD_STATUS ID=770003/l=8 F0 22 0 3 AC 0 49 0
       CAN RX BoardStatus: BoardID=61474 numSecs=940
  ADC says LOW 18@1 0.003v
               sending line=18 value=1
Processing BENCH_TEST_BUTTON_COUNTERS ID=770004/l=8 15 0 0 0 0 0 0 0
Processing BENCH_TEST_EVENT_COUNTERS ID=770000/l=8 14 14 14 14 0 0 A 0
Processing BENCH_TEST_RAW_ANALOG ID=770001/l=8 1B 0 0 0 20 72 44 42
               sending line=18 value=0
Processing BENCH_TEST_EVENT_COUNTERS ID=770000/l=8 14 14 14 14 0 0 A 0
Processing BENCH_TEST_RAW_ANALOG ID=770001/l=8 1B 0 0 0 20 72 44 42
GOOD channel 18
               Setting ADDR 2
               sending line=19 value=1
Processing BENCH_TEST_IO_META_INFO ID=770005/l=8 66 0 20 10 0 0 0 0
       CAN RX outputCount total=32 low=16
Processing BENCH_TEST_BOARD_STATUS ID=770003/l=8 F0 22 0 3 AD 0 49 0
       CAN RX BoardStatus: BoardID=61474 numSecs=941
Processing BENCH_TEST_BUTTON_COUNTERS ID=770004/l=8 15 0 0 0 0 0 0 0
Processing BENCH_TEST_EVENT_COUNTERS ID=770000/l=8 14 14 14 14 0 0 A 0
Processing BENCH_TEST_RAW_ANALOG ID=770001/l=8 1B 0 0 0 20 72 44 42
  ADC says HIGH 19@0 1.093v
               sending line=19 value=0
Processing BENCH_TEST_EVENT_COUNTERS ID=770000/l=8 14 14 14 14 0 0 A 0
Processing BENCH_TEST_RAW_ANALOG ID=770001/l=8 1B 0 0 0 20 72 44 42
  ADC says LOW 19@1 0.003v
               sending line=19 value=1
Processing BENCH_TEST_EVENT_COUNTERS ID=770000/l=8 14 14 14 14 0 0 A 0
Processing BENCH_TEST_RAW_ANALOG ID=770001/l=8 1B 0 0 0 20 72 44 42
Processing BENCH_TEST_IO_META_INFO ID=770005/l=8 66 0 20 10 0 0 0 0
       CAN RX outputCount total=32 low=16
Processing BENCH_TEST_BOARD_STATUS ID=770003/l=8 F0 22 0 3 AD 0 49 0
       CAN RX BoardStatus: BoardID=61474 numSecs=941
               sending line=19 value=0
Processing BENCH_TEST_BUTTON_COUNTERS ID=770004/l=8 15 0 0 0 0 0 0 0
Processing BENCH_TEST_EVENT_COUNTERS ID=770000/l=8 14 14 14 14 0 0 A 0
Processing BENCH_TEST_RAW_ANALOG ID=770001/l=8 1B 0 0 0 20 72 44 42
GOOD channel 19
               Setting ADDR 3
               sending line=20 value=1
Processing BENCH_TEST_EVENT_COUNTERS ID=770000/l=8 14 14 14 14 0 0 A 0
Processing BENCH_TEST_RAW_ANALOG ID=770001/l=8 1B 0 0 0 20 72 44 42
  ADC says HIGH 20@0 1.086v
               sending line=20 value=0
Processing BENCH_TEST_IO_META_INFO ID=770005/l=8 66 0 20 10 0 0 0 0
       CAN RX outputCount total=32 low=16
Processing BENCH_TEST_BOARD_STATUS ID=770003/l=8 F0 22 0 3 AD 0 49 0
       CAN RX BoardStatus: BoardID=61474 numSecs=941
Processing BENCH_TEST_BUTTON_COUNTERS
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

Thread 223 (2023-07-23):

Do not commit gerbers/drills if only date has changed

rusefillc, 2023-07-23:
See history of https://github.com/rusefi/rusefi-hardware/tree/main/breakout-boards/Breakout_154pin_284617-1-Connector/gerber files - sometimes it's just the date that is changed

can we detect the number of changed lines and rollback if it's only the date line?

rusefillc, 2023-07-23:
@chuckwagoncomputing any chance you could help?

chuckwagoncomputing, 2023-07-23:
Should this be a feature of the reusable workflow, or just in this repo's workflow?

rusefillc, 2023-07-23:
Reusable for all usages

rusefillc, 2023-07-29:
@chuckwagoncomputing I think this does not work as intended - see https://github.com/rusefi/rusefi-hardware/commits/main including pointing to latest hellen-one repo

Thread 225 (2023-07-28):

GDI4 re-fab rev D

rusefillc, 2023-07-28:
S7,S8 | Button_SPST | SMD-2_2.9x3.9x1.7 | SKRKAEE020 C115357

J4,J5 | Conn_01x06 | PinHeader_1x06_P2.54mm_Vertical | 2.54-1*6 C5156615

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

Qwerty-OFF, 2023-07-28:
C455280
C37208

Closed 2023-07-28.

Thread 226 (2023-08-02):

DRV8834 Stepper Motor Driver Carrier

rusefillc, 2023-08-02:
альтернатива https://github.com/rusefi/rusefi-hardware/issues/187

вариант, если документация https://www.ti.com/lit/ds/symlink/drv8834.pdf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 сильно проще

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

rusefillc, 2023-08-02:
@Ringenium они там не совместимы случайно по распиновке?

https://jlcpcb.com/partdetail/TexasInstruments-DRV8834RGER/C400392

Closed 2023-08-06.

Thread 227 (2023-08-14):

увеличить верхние отверстия на Breakout_154pin_284617-1-Connector

rusefillc, 2023-08-14:
мы недавно успешно удвоили нижние отверстия на Breakout_154pin_284617-1-Connector https://github.com/rusefi/rusefi-hardware/issues/218

оказалось, что на https://github.com/rusefi/hellen154hyundai немного увеличины верхние тоже.

Нужно скопировать размер и расположение верхних с https://github.com/rusefi/hellen154hyundai на Breakout_154pin_284617-1-Connector и сделать ревизию 0.6

Nadezhda-n, 2023-08-15:
Сделала. После автоматической генерации герберов внутренние слои (лишние, которых нет на плате) удалила вручную

rusefillc, 2023-08-24:
Алилуя! только версию забыли на плате поменять :)

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

Closed 2023-08-24.

Thread 228 (2023-08-19):

hellen-honda-k stim profile/pinout

rusefillc, 2023-08-19:
How do I connect https://rusefi.com/docs/pinouts/hellen/hellen-honda-k to https://rusefi.com/docs/pinouts/stim?

IAT goes to https://rusefi.com/docs/pinouts/stim/?connector=main&pin=5B
CLT goes to https://rusefi.com/docs/pinouts/stim/?connector=main&pin=6B

Where should TPS go? Where should MAP go?

andreika-git, 2023-08-20:
TPS could go to https://rusefi.com/docs/pinouts/stim/?connector=main&pin=7B
MAP could go to https://rusefi.com/docs/pinouts/stim/?connector=main&pin=8B

rusefillc, 2023-08-21:
```
2023-08-21_01_12_38_547: EngineState: BENCH_TEST Sending CAN bus0 message: ID=770000/l=8 31 0 56 50 0 0 0 0
2023-08-21_01_12_38_547: EngineState: BENCH_TEST Sending CAN bus0 message: ID=770001/l=8 1B 0 0 0 20 4F 2B 62
```

rusefillc, 2023-08-22:
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

rusefillc, 2023-08-22:
где-то перепутаны IAT и CLT, но где?

на фото видно, что CLT синий на хонде и синий https://rusefi.com/docs/pinouts/stim/?connector=main&pin=6B

```
Processing ID=770001/l=8 1B 0 0 0 20 2B 4F 66
 * BAD channel 5 (CLT): voltage 0.843137280 (raw 43) not in range (1.380596992..1.604477632)
 * BAD channel 6 (IAT): voltage 1.549019712 (raw 79) not in range (0.811403520..0.942982464)
Processing ID=770001/l=8 1B 0 0 0 20 2B 4F 66
 * BAD channel 5 (CLT): voltage 0.843137280 (raw 43) not in range (1.380596992..1.604477632)
 * BAD channel 6 (IAT): voltage 1.549019712 (raw 79) not in range (0.811403520..0.942982464)
```

andreika-git, 2023-08-22:
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

rusefillc, 2023-08-26:
@andreika-git please add "getBoardMetaOutputsCount()" and other parts of the output pattern into honda

Closed 2023-09-17.

Thread 229 (2023-08-20):

stim: CAN affects USB

rusefillc, 2023-08-20:
we have a defect: having CAN wires connected inhibits USB

microUSB from stim+nucleo to desktop
+12v power supply feeds stim+nucleo
four wires between stim+nucleo and hellen125honda: VCC GND CANH CANL
nothing else hooked to hellen125honda

power things up: no serial in device manager
windows beeps and serial appears in device manager once I unplug hellen125honda plug C with CAN lines

insertion of CAN wires once things are running does NOT kill serial it keeps running!

rusefillc, 2023-08-20:
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

rusefillc, 2023-08-20:
https://github.com/rusefi/stim/issues/30

rusefillc, 2023-08-21:
rusEFI has received stim packet

```
2023-08-20_21_04_09_285: EngineState: CAN0 RX: ID 1234567 DLC 8: AA 55 AA 55 FF 00 FF 00
```

Closed 2023-08-21.

Thread 232 (2023-08-22):

stim board to detect weak +12v power supply

rusefillc, 2023-08-22:
With weak +12v power stim board acts funny - serial works but CAN traffic is not received

do we have hardware to detect weak VCC?

andreika-git, 2023-08-23:
For example, we can use TST49 circuitry (which is currently not available on connectors):

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

We can set OUT3 to "1" and measure the scaled "12V" voltage on analog IN3.

Thread 234 (2023-08-22):

proteus f7 stim profile/pinout

rusefillc, 2023-08-22:
```
 * BoardStatus: BoardID=61474 numSecs=20
Processing ID=770001/l=8 0 0 0 0 0 FE FE 42
Processing ID=770001/l=8 0 0 0 0 0 FE FE 42
Processing ID=770003/l=8 F0 22 0 0 14 0 3F 0
 * BoardStatus: BoardID=61474 numSecs=20
Processing ID=770001/l=8 0 0 0 0 0 FE FE 42
Processing ID=770001/l=8 0 0 0 0 0 FE FE 42
Processing ID=770001/l=8 0 0 0 0 0 FE FE 42
Processing ID=770003/l=8 F0 22 0 0 15 0 3F 0
 * BoardStatus: BoardID=61474 numSecs=21
Processing ID=770001/l=8 0 0 0 0 0 FE FE 42
Processing ID=770001/l=8 0 0 0 0 0 FE FE 42
Processing ID=770003/l=8 F0 22 0 0 15 0 3F 0
 * BoardStatus: BoardID=61474 numSecs=21
Processing ID=770001/l=8 0 0 0 0 0 FE FE 42
Processing ID=770001/l=8 0 0 0 0 0 FE FE 42
```

rusefillc, 2023-08-29:
status update: just fixed https://github.com/rusefi/rusefi/issues/5545

MAP & TPS analog works but IAT/CLT are not happy would need to be investigated

I've also wired 16 low-side and 2 high side channels hoping to compare low side vs high side processing. Unfortunately do not have 16 low sides working - have channel 9 for instance not working. open question if/what could be improved to facilitate troubleshooting - at the moment it takes too much labor to read console output. could be wiring issue could be stim issue could be anything.

```
  ADC says LOW 18@0 0.003v
ERROR! Cycle 18@0 FAILED! (set 1, received 0 0.003v)
  sending line=18 value=0
Processing BENCH_TEST_EVENT_COUNTERS ID=770000/l=8 0 0 0 0 0 0 0 0
Processing BENCH_TEST_RAW_ANALOG ID=770001/l=8 1B 0 0 0 20 9 44 42
 * BAD channel 5 (CLT): voltage 0.176470592 (raw 9) not in range (1.380596992..1                                                                                                                                                             .604477632)
 * BAD channel 6 (IAT): voltage 1.333333376 (raw 68) not in range (0.811403520..                                                                                                                                                             0.942982464)
Processing BENCH_TEST_EVENT_COUNTERS ID=770000/l=8 0 0 0 0 0 0 0 0
Processing BENCH_TEST_RAW_ANALOG ID=770001/l=8 1B 0 0 0 20 9 44 42
 * BAD channel 5 (CLT): voltage 0.176470592 (raw 9) not in range (1.380596992..1                                                                                                                                                             .604477632)
 * BAD channel 6 (IAT): voltage 1.333333376 (raw 68) not in range (0.811403520..                                                                                                                                                             0.942982464)
Processing BENCH_TEST_BUTTON_COUNTERS ID=770004/l=8 1 0 0 0 0 0 0 0
Processing BENCH_TEST_EVENT_COUNTERS ID=770000/l=8 0 0 0 0 0 0 0 0
Processing BENCH_TEST_RAW_ANALOG ID=770001/l=8 1B 0 0 0 20 9 44 42
 * BAD channel 5 (CLT): voltage 0.176470592 (raw 9) not in range (1.380596992..1                                                                                                                                                             .604477632)
 * BAD channel 6 (IAT): voltage 1.333333376 (raw 68) not in range (0.811403520..                                                                                                                                                             0.942982464)
ERROR! Cycle 18@2 FAILED! (set 1, received 0 0.003v)
  sending line=18 value=0
Processing BENCH_TEST_EVENT_COUNTERS ID=770000/l=8 0 0 0 0 0 0 0 0
Processing BENCH_TEST_RAW_ANALOG ID=770001/l=8 1B 0 0 0 20 9 44 42
 * BAD channel 5 (CLT): voltage 0.176470592 (raw 9) not in range (1.380596992..1                                                                                                                                                             .604477632)
 * BAD channel 6 (IAT): voltage 1.333333376 (raw 68) not in range (0.811403520..                                                                                                                                                             0.942982464)
!!!!!!!! BAD channel 18 !!!!!!!!!!!!!!!
 ************* SOMETHING BAD SEE ABOVE ************************
Processing BENCH_TEST_IO_META_INFO ID=770005/l=8 66 0 12 0 0 0 0 0
 ***** got outputCount 18
Processing BENCH_TEST_BOARD_STATUS ID=770003/l=8 F0 22 0 0 8D 0 49 0
 * BoardStatus: BoardID=61474 numSecs=141
Processing BENCH_TEST_BUTTON_COUNTERS ID=770004/l=8 1 0 0 0 0 0 0 0
 ++++++++++++++++ numOutputs 18
Setting ADDR 0
  sending line=1 value=1
Processing BENCH_TEST_EVENT_COUNTERS ID=770000/l=8 0 0 0 0 0 0 0 0
Processing BENCH_TEST_RAW_ANALOG ID=770001/l=8 1B 0 0 0 20 9 44 42
 * BAD channel 5 (CLT): voltage 0.176470592 (raw 9) not in range (1.380596992..1                                                                                                                                                             .604477632)
 * BAD channel 6 (IAT): voltage 1.333333376 (raw 68) not in range (0.811403520..                                                                                                                                                             0.942982464)
  ADC says HIGH 1@0 2.834v
  sending line=1 value=0
Processing BENCH_TEST_EVENT_COUNTERS ID=770000/l=8 0 0 0 0 0 0 0 0
Processing BENCH_TEST_RAW_ANALOG ID=770001/l=8 1B 0 0 0 20 9 44 42
 * BAD channel 5 (CLT): voltage 0.176470592 (raw 9) not in range (1.380596992..1                                                                                                                                                             .604477632)
 * BAD channel 6 (IAT): voltage 1.333333376 (raw 68) not in range (0.811403520..                                                                                                                                                             0.942982464)
  ADC says LOW 1@1 0.003v
  sending line=1 value=1
Processing BENCH_TEST_EVENT_COUNTERS ID=770000/l=8 0 0 0 0 0 0 0 0
Processing BENCH_TEST_RAW_ANALOG ID=770001/l=8 1B 0 0 0 20 9 44 42
 * BAD channel 5 (CLT): voltage 0.176470592 (raw 9) not in range (1.380596992..1                                                                                                                                                             .604477632)
 * BAD channel 6 (IAT): voltage 1.333333376 (raw 68) not in range (0.811403520..                                                                                                                                                             0.942982464)
Processing BENCH_TEST_IO_META_INFO ID=770005/l=8 66 0 12 0 0 0 0 0
 ***** got outputCount 18
Processing BENCH_TEST_BOARD_STATUS ID=770003/l=8 F0 22 0 0 8D 0 49 0
 * BoardStatus: BoardID=61474 numSecs=141
Processing BENCH_TEST_BUTTON_COUNTERS ID=770004/l=8 1 0 0 0 0 0 0 0
  sending line=1 value=0
Processing BENCH_TEST_EVENT_COUNTERS ID=770000/l=8 0 0 0 0 0 0 0 0
Processing BENCH_TEST_RAW_ANALOG ID=770001/l=8 1B 0 0 0 20 9 44 42
 * BAD channel 5 (CLT): voltage 0.176470592 (raw 9) not in range (1.380596992..1                                                                                                                                                             .604477632)
 * BAD channel 6 (IAT): voltage 1.333333376 (raw 68) not in range (0.811403520..                                                                                                                                                             0.942982464)
GOOD channel 1
Setting ADDR 1
  sending line=2 value=1
Processing BENCH_TEST_EVENT_COUNTERS ID=770000/l=8 0 0 0 0 0 0 0 0
Processing BENCH_TEST_RAW_ANALOG ID=770001/l=8 1B 0 0 0 20 9 44 42
 * BAD channel 5 (CLT): voltage 0.176470592 (raw 9) not in range (1.380596992..1                                                                                                                                                             .604477632)
 * BAD channel 6 (IAT): voltage 1.333333376 (raw 68) not in range (0.811403520..                                                                                                                                                             0.942982464)
Processing BENCH_TEST_IO_META_INFO ID=770005/l=8 66 0 12 0 0 0 0 0
 ***** got outputCount 18
Processing BENCH_TEST_BOARD_STATUS ID=770003/l=8 F0 22 0 0 8D 0 49 0
 * BoardStatus: BoardID=61474 numSecs=141
Processing BENCH_TEST_BUTTON_COUNTERS ID=770004/l=8 1 0 0 0 0 0 0 0
  ADC says HIGH 2@0 2.832v
  sending line=2 value=0
Processing BENCH_TEST_EVENT_COUNTERS ID=770000/l=8 0 0 0 0 0 0 0 0
Processing BENCH_TEST_RAW_ANALOG ID=770001/l=8 1B 0 0 0 20 9 44 42
 * BAD channel 5 (CLT): voltage 0.176470592 (raw 9) not in range (1.380596992..1                                                                                                                                                             .604477632)
 * BAD channel 6 (IAT): voltage 1.333333376 (raw 68) not in range (0.811403520..                                                                                                                                                             0.942982464)
  ADC says LOW 2@1 0.003v
  sending line=2 value=1
Processing BENCH_TEST_EVENT_COUNTERS ID=770000/l=8 0 0 0 0 0 0 0 0
Processing BENCH_TEST_RAW_ANALOG ID=770001/l=8 1B 0 0 0 20 9 44 42
 * BAD channel 5 (CLT): voltage 0.176470592 (raw 9) not in range (1.380596992..1                                                                                                                                                             .604477632)
 * BAD channel 6 (IAT): voltage 1.333333376 (raw 68) not in range (0.811403520..                                                                                                                                                             0.942982464)
  sending line=2 value=0
Processing BENCH_TEST_EVENT_COUNTERS ID=770000/l=8 0 0 0 0 0 0 0 0
Processing BENCH_TEST_RAW_ANALOG ID=770001/l=8 1B 0 0 0 20 9 44 42
 * BAD channel 5 (CLT): voltage 0.176470592 (raw 9) not in range (1.380596992..1                                                                                                                                                             .604477632)
 * BAD channel 6 (IAT): voltage 1.333333376 (raw 68) not in range (0.811403520..                                                                                                                                                             0.942982464)
Processing BENCH_TEST_IO_META_INFO ID=770005/l=8 66 0 12 0 0 0 0 0
 ***** got outputCount 18
Processing BENCH_TEST_BOARD_STATUS ID=770003/l=8 F0 22 0 0 8E 0 49 0
 * BoardStatus: BoardID=61474 numSecs=142
Processing BENCH_TEST_BUTTON_COUNTERS ID=770004/l=8 1 0 0 0 0 0 0 0
GOOD channel 2
Setting ADDR 2
  sending line=3 value=1
Processing BENCH_TEST_EVENT_COUNTERS ID=770000/l=8 0 0 0 0 0 0 0 0
Processing BENCH_TEST_RAW_ANALOG ID=770001/l=8 1B 0 0 0 20 9 44 42
 * BAD channel 5 (CLT): voltage 0.176470592 (raw 9) not in range (1.380596992..1                                                                                                                                                             .604477632)
 * BAD channel 6 (IAT): voltage 1.333333376 (raw 68) not in range (0.811403520..                                                                                                                                                             0.942982464)
  ADC says HIGH 3@0 2.831v
  sending line=3 value=0
Processing BENCH_TEST_EVENT_COUNTERS ID=770000/l=8 0 0 0 0 0 0 0 0
Processing BENCH_TEST_RAW_ANALOG ID=770001/l=8 1B 0 0 0 20 9 44 42
 * BAD channel 5 (CLT): voltage 0.176470592 (raw 9) not in range (1.380596992..1                                                                                                                                                             .604477632)
 * BAD channel 6 (IAT): voltage 1.333333376 (raw 68) not in range (0.811403520..                                                                                                                                                             0.942982464)
Processing BENCH_TEST_IO_META_INFO ID=770005/l=8 66 0 12 0 0 0 0 0
 ***** got outputCount 18
Processing BENCH_TEST_BOARD_STATUS ID=770003/l=8 F0 22 0 0 8E 0 49 0
 * BoardStatus: BoardID=61474 numSecs=142
Processing BENCH_TEST_BUTTON_COUNTERS ID=770004/l=8 1 0 0 0 0 0 0 0
  ADC says LOW 3@1 0.004v
  sending line=3 value=1
Processing BENCH_TEST_EVENT_COUNTERS ID=770000/l=8 0 0 0 0 0 0 0 0
Processing BENCH_TEST_RAW_ANALOG ID=770001/l=8 1B 0 0 0 20 9 44 42
 * BAD channel 5 (CLT): voltage 0.176470592 (raw 9) not in range (1.380596992..1                                                                                                                                                             .604477632)
 * BAD channel 6 (IAT): voltage 1.333333376 (raw 68) not in range (0.811403520..                                                                                                                                                             0.942982464)
  sending line=3 value=0
Processing BENCH_TEST_EVENT_COUNTERS ID=770000/l=8 0 0 0 0 0 0 0 0
Processing BENCH_TEST_RAW_ANALOG ID=770001/l=8 1B 0 0 0 20 9 44 42
 * BAD channel 5 (CLT): voltage 0.176470592 (raw 9) not in range (1.380596992..1                                                                                                                                                             .604477632)
 * BAD channel 6 (IAT): voltage 1.333333376 (raw 68) not in range (0.811403520..                                                                                                                                                             0.942982464)
GOOD channel 3
Setting ADDR 3
  sending line=4 value=1
Processing BENCH_TEST_EVENT_COUNTERS ID=770000/l=8 0 0 0 0 0 0 0 0
Processing BENCH_TEST_RAW_ANALOG ID=770001/l=8 1B 0 0 0 20 9 44 42
 * BAD channel 5 (CLT): voltage 0.176470592 (raw 9) not in range (1.380596992..1.604477632)
 * BAD channel 6 (IAT): voltage 1.333333376 (raw 68) not in range (0.811403520..0.942982464)
Processing BENCH_TEST_IO_META_INFO ID=770005/l=8 66 0 12 0 0 0 0 0
 ***** got outputCount 18
Processing BENCH_TEST_BOARD_STATUS ID=770003/l=8 F0 22 0 0 8E 0 49 0
 * BoardStatus: BoardID=61474 numSecs=142
Processing BENCH_TEST_BUTTON_COUNTERS ID=770004/l=8 1 0 0 0 0 0 0 0
  ADC says HIGH 4@0 2.836v
  sending line=4 value=0
Processing BENCH_TEST_EVENT_COUNTERS ID=770000/l=8 0 0 0 0 0 0 0 0
Processing BENCH_TEST_RAW_ANALOG ID=770001/l=8 1B 0 0 0 20 9 44 42
 * BAD channel 5 (CLT): voltage 0.176470592 (raw 9) not in range (1.380596992..1.604477632)
 * BAD channel 6 (IAT): voltage 1.333333376 (raw 68) not in range (0.811403520..0.942982464)
  ADC says LOW 4@1 0.002v
  sending line=4 value=1
Processing BENCH_TEST_EVENT_COUNTERS ID=770000/l=8 0 0 0 0 0 0 0 0
Processing BENCH_TEST_RAW_ANALOG ID=770001/l=8 1B 0 0 0 20 9 44 42
 * BAD channel 5 (CLT): voltage 0.176470592 (raw 9) not in range (1.380596992..1.604477632)
 * BAD channel 6 (IAT): voltage 1.333333376 (raw 68) not in range (0.811403520..0.942982464)
Processing BENCH_TEST_IO_META_INFO ID=770005/l=8 66 0 12 0 0 0 0 0
 ***** got outputCount 18
Processing BENCH_TEST_BOARD_STATUS ID=770003/l=8 F0 22 0 0 8E 0 49 0
 * BoardStatus: BoardID=61474 numSecs=142
Processing BENCH_TEST_BUTTON_COUNTERS ID=770004/l=8 1 0 0 0 0 0 0 0
  sending line=4 value=0
Processing BENCH_TEST_EVENT_COUNTERS ID=770000/l=8 0 0 0 0 0 0 0 0
Processing BENCH_TEST_RAW_ANALOG ID=770001/l=8 1B 0 0 0 20 9 44 42
 * BAD channel 5 (CLT): voltage 0.176470592 (raw 9) not in range (1.380596992..1.604477632)
 * BAD channel 6 (IAT): voltage 1.333333376 (raw 68) not in range (0.811403520..0.942982464)
GOOD channel 4
Setting ADDR 4
  sending line=5 value=1
Processing BENCH_TEST_EVENT_COUNTERS ID=770000/l=8 0 0 0 0 0 0 0 0
Processing BENCH_TEST_RAW_ANALOG ID=770001/l=8 1B 0 0 0 20 9 44 42
 * BAD channel 5 (CLT): voltage 0.176470592 (raw 9) not in range (1.380596992..1.604477632)
 * BAD channel 6 (IAT): voltage 1.333333376 (raw 68) not in range (0.811403520..0.942982464)
  ADC says HIGH 5@0 2.836v
  sending line=5 value=0
Processing BENCH_TEST_EVENT_COUNTERS ID=770000/l=8 0 0 0 0 0 0 0 0
Processing BENCH_TEST_RAW_ANALOG ID=770001/l=8 1B 0 0 0 20 9 44 42
 * BAD channel 5 (CLT): voltage 0.176470592 (raw 9) not in range (1.380596992..1.604477632)
 * BAD channel 6 (IAT): voltage 1.333333376 (raw 68) not in range (0.811403520..0.942982464)
Processing BENCH_TEST_IO_META_INFO ID=770005/l=8 66 0 12 0 0 0 0 0
 ***** got outputCount 18
Processing BENCH_TEST_BOARD_STATUS ID=770003/l=8 F0 22 0 0 8F 0 49 0
 * BoardStatus: BoardID=61474 numSecs=143
Processing BENCH_TEST_BUTTON_COUNTERS ID=770004/l=8 1 0 0 0 0 0 0 0
  ADC says LOW 5@1 0.003v
  sending line=5 value=1
Processing BENCH_TEST_EVENT_COUNTERS ID=770000/l=8 0 0 0 0 0 0 0 0
Processing BENCH_TEST_RAW_ANALOG ID=770001/l=8 1B 0 0 0 20 9 44 42
 * BAD channel 5 (CLT): voltage 0.176470592 (raw 9) not in range (1.380596992..1.604477632)
 * BAD channel 6 (IAT): voltage 1.333333376 (raw 68) not in range (0.811403520..0.942982464)
  sending line=5 value=0
Processing BENCH_TEST_EVENT_COUNTERS ID=770000/l=8 0 0 0 0 0 0 0 0
Processing BENCH_TEST_RAW_ANALOG ID=770001/l=8 1B 0 0 0 20 9 44 42
 * BAD channel 5 (CLT): voltage 0.176470592 (raw 9) not in range (1.380596992..1.604477632)
 * BAD channel 6 (IAT): voltage 1.333333376 (raw 68) not in range (0.811403520..0.942982464)
Processing BENCH_TEST_IO_META_INFO ID=770005/l=8 66 0 12 0 0 0 0 0
 ***** got outputCount 18
Processing BENCH_TEST_BOARD_STATUS ID=770003/l=8 F0 22 0 0 8F 0 49 0
 * BoardStatus: BoardID=61474 numSecs=143
Processing BENCH_TEST_BUTTON_COUNTERS ID=770004/l=8 1 0 0 0 0 0 0 0
GOOD channel 5
Setting ADDR 5
  sending line=6 value=1
Processing BENCH_TEST_EVENT_COUNTERS ID=770000/l=8 0 0 0 0 0 0 0 0
Processing BENCH_TEST_RAW_ANALOG ID=770001/l=8 1B 0 0 0 20 9 44 42
 * BAD channel 5 (CLT): voltage 0.176470592 (raw 9) not in range (1.380596992..1.604477632)
 * BAD channel 6 (IAT): voltage 1.333333376 (raw 68) not in range (0.811403520..0.942982464)
  ADC says HIGH 6@0 2.834v
  sending line=6 value=0
Processing BENCH_TEST_EVENT_COUNTERS ID=770000/l=8 0 0 0 0 0 0 0 0
Processing BENCH_TEST_RAW_ANALOG ID=770001/l=8 1B 0 0 0 20 9 44 42
 * BAD channel 5 (CLT): voltage 0.176470592 (raw 9) not in range (1.380596992..1.604477632)
 * BAD channel 6 (IAT): voltage 1.333333376 (raw 68) not in range (0.811403520..0.942982464)
  ADC says LOW 6@1 0.003v
  sending line=6 value=1
Processing BENCH_TEST_EVENT_COUNTERS ID=770000/l=8 0 0 0 0 0 0 0 0
Processing BENCH_TEST_RAW_ANALOG ID=770001/l=8 1B 0 0 0 20 9 44 42
 * BAD channel 5 (CLT): voltage 0.176470592 (raw 9) not in range (1.380596992..1.604477632)
 * BAD channel 6 (IAT): voltage 1.333333376 (raw 68) not in range (0.811403520..0.942982464)
Processing BENCH_TEST_IO_META_INFO ID=770005/l=8 66 0 12 0 0 0 0 0
 ***** got outputCount 18
Processing BENCH_TEST_BOARD_STATUS ID=770003/l=8 F0 22 0 0 8F 0 49 0
 * BoardStatus: BoardID=61474 numSecs=143
Processing BENCH_TEST_BUTTON_COUNTERS ID=770004/l=8 1 0 0 0 0 0 0 0
  sending line=6 value=0
Processing BENCH_TEST_EVENT_COUNTERS ID=770000/l=8 0 0 0 0 0 0 0 0
Processing BENCH_TEST_RAW_ANALOG ID=770001/l=8 1B 0 0 0 20 9 44 42
 * BAD channel 5 (CLT): voltage 0.176470592 (raw 9) not in range (1.380596992..1.604477632)
 * BAD channel 6 (IAT): voltage 1.333333376 (raw 68) not in range (0.811403520..0.942982464)
GOOD channel 6
Setting ADDR 6
  sending line=7 value=1
Processing BENCH_TEST_EVENT_COUNTERS ID=770000/l=8 0 0 0 0 0 0 0 0
Processing BENCH_TEST_RAW_ANALOG ID=770001/l=8 1B 0 0 0 20 9 44 42
 * BAD channel 5 (CLT): voltage 0.176470592 (raw 9) not in range (1.380596992..1.604477632)
 * BAD channel 6 (IAT): voltage 1.333333376 (raw 68) not in range (0.811403520..0.942982464)
Processing BENCH_TEST_IO_META_INFO ID=770005/l=8 66 0 12 0 0 0 0 0
 ***** got outputCount 18
Processing BENCH_TEST_BOARD_STATUS ID=770003/l=8 F0 22 0 0 8F 0 49 0
 * BoardStatus: BoardID=61474 numSecs=143
Processing BENCH_TEST_BUTTON_COUNTERS ID=770004/l=8 1 0 0 0 0 0 0 0
  ADC says HIGH 7@0 2.839v
  sending line=7 value=0
Processing BENCH_TEST_EVENT_COUNTERS ID=770000/l=8 0 0 0 0 0 0 0 0
Processing BENCH_TEST_RAW_ANALOG ID=770001/l=8 1B 0 0 0 20 9 44 42
 * BAD channel 5 (CLT): voltage 0.176470592 (raw 9) not in range (1.380596992..1.604477632)
 * BAD channel 6 (IAT): voltage 1.333333376 (raw 68) not in range (0.811403520..0.942982464)
  ADC says LOW 7@1 0.004v
  sending line=7 value=1
Processing BENCH_TEST_EVENT_COUNTERS ID=770000/l=8 0 0 0 0 0 0 0 0
Processing BENCH_TEST_RAW_ANALOG ID=770001/l=8 1B 0 0 0 20 9 44 42
 * BAD channel 5 (CLT): voltage 0.176470592 (raw 9) not in range (1.380596992..1.604477632)
 * BAD channel 6 (IAT): voltage 1.333333376 (raw 68) not in range (0.811403520..0.942982464)
  sending line=7 value=0
Processing BENCH_TEST_EVENT_COUNTERS ID=770000/l=8 0 0 0 0 0 0 0 0
Processing BENCH_TEST_RAW_ANALOG ID=770001/l=8 1B 0 0 0 20 9 44 42
 * BAD channel 5 (CLT): voltage 0.176470592 (raw 9) not in range (1.380596992..1.604477632)
 * BAD channel 6 (IAT): voltage 1.333333376 (raw 68) not in range (0.811403520..0.942982464)
Processing BENCH_TEST_IO_META_INFO ID=770005/l=8 66 0 12 0 0 0 0 0
 ***** got outputCount 18
Processing BENCH_TEST_BOARD_STATUS ID=770003/l=8 F0 22 0 0 90 0 49 0
 * BoardStatus: BoardID=61474 numSecs=144
Processing BENCH_TEST_BUTTON_COUNTERS ID=770004/l=8 1 0 0 0 0 0 0 0
GOOD channel 7
Setting ADDR 7
  sending line=8 value=1
Processing BENCH_TEST_EVENT_COUNTERS ID=770000/l=8 0 0 0 0 0 0 0 0
Processing BENCH_TEST_RAW_ANALOG ID=770001/l=8 1B 0 0 0 20 9 44 42
 * BAD channel 5 (CLT): voltage 0.176470592 (raw 9) not in range (1.380596992..1.604477632)
 * BAD channel 6 (IAT): voltage 1.333333376 (raw 68) not in range (0.811403520..0.942982464)
  ADC says HIGH 8@0 2.839v
  sending line=8 value=0
Processing BENCH_TEST_EVENT_COUNTERS ID=770000/l=8 0 0 0 0 0 0 0 0
Processing BENCH_TEST_RAW_ANALOG ID=770001/l=8 1B 0 0 0 20 9 44 42
 * BAD channel 5 (CLT): voltage 0.176470592 (raw 9) not in range (1.380596992..1.604477632)
 * BAD channel 6 (IAT): voltage 1.333333376 (raw 68) not in range (0.811403520..0.942982464)
Processing BENCH_TEST_IO_META_INFO ID=770005/l=8 66 0 12 0 0 0 0 0
 ***** got outputCount 18
Processing BENCH_TEST_BOARD_STATUS ID=770003/l=8 F0 22 0 0 90 0 49 0
 * BoardStatus: BoardID=61474 numSecs=144
Processing BENCH_TEST_BUTTON_COUNTERS ID=770004/l=8 1 0 0 0 0 0 0 0
  ADC says LOW 8@1 0.004v
  sending line=8 value=1
Processing BENCH_TEST_EVENT_COUNTERS ID=770000/l=8 0 0 0 0 0 0 0 0
Processing BENCH_TEST_RAW_ANALOG ID=770001/l=8 1B 0 0 0 20 9 44 42
 * BAD channel 5 (CLT): voltage 0.176470592 (raw 9) not in range (1.380596992..1.604477632)
 * BAD channel 6 (IAT): voltage 1.333333376 (raw 68) not in range (0.811403520..0.942982464)
  sending line=8 value=0
Processing BENCH_TEST_EVENT_COUNTERS ID=770000/l=8 0 0 0 0 0 0 0 0
Processing BENCH_TEST_RAW_ANALOG ID=770001/l=8 1B 0 0 0 20 9 44 42
 * BAD channel 5 (CLT): voltage 0.176470592 (raw 9) not in range (1.380596992..1.604477632)
 * BAD channel 6 (IAT): voltage 1.333333376 (raw 68) not in range (0.811403520..0.942982464)
GOOD channel 8
Setting ADDR 8
  sending line=9 value=1
Processing BENCH_TEST_EVENT_COUNTERS ID=770000/l=8 0 0 0 0 0 0 0 0
Processing BENCH_TEST_RAW_ANALOG ID=770001/l=8 1B 0 0 0 20 9 44 42
 * BAD channel 5 (CLT): voltage 0.176470592 (raw 9) not in range (1.380596992..1.604477632)
 * BAD channel 6 (IAT): voltage 1.333333376 (raw 68) not in range (0.811403520..0.942982464)
Processing BENCH_TEST_IO_META_INFO ID=770005/l=8 66 0 12 0 0 0 0 0
 ***** got outputCount 18
Processing BENCH_TEST_BOARD_STATUS ID=770003/l=8 F0 22 0 0 90 0 49 0
 * BoardStatus: BoardID=61474 numSecs=144
Processing BENCH_TEST_BUTTON_COUNTERS ID=770004/l=8 1 0 0 0 0 0 0 0
  ADC says HIGH 9@0 2.833v
  sending line=9 value=0
Processing BENCH_TEST_EVENT_COUNTERS ID=770000/l=8 0 0 0 0 0 0 0 0
Processing BENCH_TEST_RAW_ANALOG ID=770001/l=8 1B 0 0 0 20 9 44 42
 * BAD channel 5 (CLT): voltage 0.176470592 (raw 9) not in range (1.380596992..1.604477632)
 * BAD channel 6 (IAT): voltage 1.333333376 (raw 68) not in range (0.811403520..0.942982464)
ERROR! Cycle 9@1 FAILED! (set 0, received 1 2.838v)
  sending line=9 value=1
Processing BENCH_TEST_EVENT_COUNTERS ID=770000/l=8 0 0 0 0 0 0 0 0
Processing BENCH_TEST_RAW_ANALOG ID=770001/l=8 1B 0 0 0 20 9 44 42
 * BAD channel 5 (CLT): voltage 0.176470592 (raw 9) not in range (1.380596992..1.604477632)
 * BAD channel 6 (IAT): voltage 1.333333376 (raw 68) not in range (0.811403520..0.942982464)
Processing BENCH_TEST_IO_META_INFO ID=770005/l=8 66 0 12 0 0 0 0 0
 ***** got outputCount 18
Processing BENCH_TEST_BOARD_STATUS ID=770003/l=8 F0 22 0 0 90 0 49 0
 * BoardStatus: BoardID=61474 numSecs=144
Processing BENCH_TEST_BUTTON_COUNTERS ID=770004/l=8 1 0 0 0 0 0 0 0
  sending line=9 value=0
Processing BENCH_TEST_EVENT_COUNTERS ID=770000/l=8 0 0 0 0 0 0 0 0
Processing BENCH_TEST_RAW_ANALOG ID=770001/l=8 1B 0 0 0 20 9 44 42
 * BAD channel 5 (CLT): voltage 0.176470592 (raw 9) not in range (1.380596992..1.604477632)
 * BAD channel 6 (IAT): voltage 1.333333376 (raw 68) not in range (0.811403520..0.942982464)
ERROR! Cycle 9@3 FAILED! (set 0, received 1 2.836v)
!!!!!!!! BAD channel 9 !!!!!!!!!!!!!!!
Setting ADDR 9
  sending line=10 value=1
Processing BENCH_TEST_EVENT_COUNTERS ID=770000/l=8 0 0 0 0 0 0 0 0
Processing BENCH_TEST_RAW_ANALOG ID=770001/l=8 1B 0 0 0 20 9 44 42
 * BAD channel 5 (CLT): voltage 0.176470592 (raw 9) not in range (1.380596992..1.604477632)
 * BAD channel 6 (IAT): voltage 1.333333376 (raw 68) not in range (0.811403520..0.942982464)
  ADC says HIGH 10@0 2.832v
  sending line=10 value=0
Processing BENCH_TEST_EVENT_COUNTERS ID=770000/l=8 0 0 0 0 0 0 0 0
Processing BENCH_TEST_RAW_ANALOG ID=770001/l=8 1B 0 0 0 20 9 44 42
 * BAD channel 5 (CLT): voltage 0.176470592 (raw 9) not in range (1.380596992..1.604477632)
 * BAD channel 6 (IAT): voltage 1.333333376 (raw 68) not in range (0.811403520..0.942982464)
Processing BENCH_TEST_IO_META_INFO ID=770005/l=8 66 0 12 0 0 0 0 0
 ***** got outputCount 18
Processing BENCH_TEST_BOARD_STATUS ID=770003/l=8 F0 22 0 0 91 0 49 0
 * BoardStatus: BoardID=61474 numSecs=145
Processing BENCH_TEST_BUTTON_COUNTERS ID=770004/l=8 1 0 0 0 0 0 0 0
  ADC says LOW 10@1 0.004v
  sending line=10 value=1
Processing BENCH_TEST_EVENT_COUNTERS ID=770000/l=8 0 0 0 0 0 0 0 0
Processing BENCH_TEST_RAW_ANALOG ID=770001/l=8 1B 0 0 0 20 9 44 42
 * BAD channel 5 (CLT): voltage 0.176470592 (raw 9) not in range (1.380596992..1.604477632)
 * BAD channel 6 (IAT): voltage 1.333333376 (raw 68) not in range (0.811403520..0.942982464)
  sending line=10 value=0
Processing BENCH_TEST_EVENT_COUNTERS ID=770000/l=8 0 0 0 0 0 0 0 0
Processing BENCH_TEST_RAW_ANALOG ID=770001/l=8 1B 0 0 0 20 9 44 42
 * BAD channel 5 (CLT): voltage 0.176470592 (raw 9) not in range (1.380596992..1.604477632)
 * BAD channel 6 (IAT): voltage 1.333333376 (raw 68) not in range (0.811403520..0.942982464)
Processing BENCH_TEST_IO_META_INFO ID=770005/l=8 66 0 12 0 0 0 0 0
 ***** got outputCount 18
Processing BENCH_TEST_BOARD_STATUS ID=770003/l=8 F0 22 0 0 91 0 49 0
 * BoardStatus: BoardID=61474 numSecs=145
Processing BENCH_TEST_BUTTON_COUNTERS ID=770004/l=8 1 0 0 0 0 0 0 0
GOOD channel 10
Setting ADDR 10
  sending line=11 value=1
Processing BENCH_TEST_EVENT_COUNTERS ID=770000/l=8 0 0 0 0 0 0 0 0
Processing BENCH_TEST_RAW_ANALOG ID=770001/l=8 1B 0 0 0 20 9 44 42
 * BAD channel 5 (CLT): voltage 0.176470592 (raw 9) not in range (1.380596992..1.604477632)
 * BAD channel 6 (IAT): voltage 1.333333376 (raw 68) not in range (0.811403520..0.942982464)
  ADC says HIGH 11@0 2.835v
  sending line=11 value=0
Processing BENCH_TEST_EVENT_COUNTERS ID=770000/l=8 0 0 0 0 0 0 0 0
Processing BENCH_TEST_RAW_ANALOG ID=770001/l=8 1B 0 0 0 20 9 44 42
 * BAD channel 5 (CLT): voltage 0.176470592 (raw 9) not in range (1.380596992..1.604477632)
 * BAD channel 6 (IAT): voltage 1.333333376 (raw 68) not in range (0.811403520..0.942982464)
  ADC says LOW 11@1 0.003v
  sending line=11 value=1
Processing BENCH_TEST_EVENT_COUNTERS ID=770000/l=8 0 0 0 0 0 0 0 0
Processing BENCH_TEST_RAW_ANALOG ID=770001/l=8 1B 0 0 0 20 9 44 42
 * BAD channel 5 (CLT): voltage 0.176470592 (raw 9) not in range (1.380596992..1.604477632)
 * BAD channel 6 (IAT): voltage 1.333333376 (raw 68) not in range (0.811403520..0.942982464)
Processing BENCH_TEST_IO_META_INFO ID=770005/l=8 66 0 12 0 0 0 0 0
 ***** got outputCount 18
Processing BENCH_TEST_BOARD_STATUS ID=770003/l=8 F0 22 0 0 91 0 49 0
 * BoardStatus: BoardID=61474 numSecs=145
Processing BENCH_TEST_BUTTON_COUNTERS ID=770004/l=8 1 0 0 0 0 0 0 0
  sending line=11 value=0
Processing BENCH_TEST_EVENT_COUNTERS ID=770000/l=8 0 0 0 0 0 0 0 0
Processing BENCH_TEST_RAW_ANALOG ID=770001/l=8 1B 0 0 0 20 9 44 42
 * BAD channel 5 (CLT): voltage 0.176470592 (raw 9) not in range (1.380596992..1.604477632)
 * BAD channel 6 (IAT): voltage 1.333333376 (raw 68) not in range (0.811403520..0.942982464)
GOOD channel 11
Setting ADDR 11
  sending line=12 value=1
Processing BENCH_TEST_EVENT_COUNTERS ID=770000/l=8 0 0 0 0 0 0 0 0
Processing BENCH_TEST_RAW_ANALOG ID=770001/l=8 1B 0 0 0 20 9 44 42
 * BAD channel 5 (CLT): voltage 0.176470592 (raw 9) not in range (1.380596992..1.604477632)
 * BAD channel 6 (IAT): voltage 1.333333376 (raw 68) not in range (0.811403520..0.942982464)
Processing BENCH_TEST_IO_META_INFO ID=770005/l=8 66 0 12 0 0 0 0 0
 ***** got outputCount 18
Processing BENCH_TEST_BOARD_STATUS ID=770003/l=8 F0
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

Thread 237 (2023-08-26):

Test ECU outputs using CAN

andreika-git, 2023-08-26:
https://github.com/rusefi/rusefi-hardware/commit/9102e4aaa8623208acc5154430aec9aa0e09fa7d

andreika-git, 2023-08-26:
We need to test this.

rusefillc, 2023-08-27:
@andreika-git META data was not requested by stim

I've made it broadcast https://github.com/rusefi/rusefi/commit/a872d8067dcd5f453d34addaca55241465415f6b

```
Processing BENCH_TEST_BOARD_STATUS ID=770003/l=8 0 70 0 0 15 0 63 0
 * BoardStatus: BoardID=112 numSecs=21
Processing BENCH_TEST_BUTTON_COUNTERS ID=770004/l=8 0 0 0 0 0 0 0 0
Processing BENCH_TEST_EVENT_COUNTERS ID=770000/l=8 0 0 0 0 0 0 0 0
Processing BENCH_TEST_RAW_ANALOG ID=770001/l=8 19 0 0 0 1E 6B 40 67
 * BAD channel 5 (CLT): voltage 2.098039392 (raw 107) not in range (1.380596992..1.604477632)
 * BAD channel 6 (IAT): voltage 1.254902000 (raw 64) not in range (0.811403520..0.942982464)
Processing BENCH_TEST_EVENT_COUNTERS ID=770000/l=8 0 0 0 0 0 0 0 0
Processing BENCH_TEST_RAW_ANALOG ID=770001/l=8 19 0 0 0 1E 6B 40 68
 * BAD channel 5 (CLT): voltage 2.098039392 (raw 107) not in range (1.380596992..1.604477632)
 * BAD channel 6 (IAT): voltage 1.254902000 (raw 64) not in range (0.811403520..0.942982464)
Processing BENCH_TEST_EVENT_COUNTERS ID=770000/l=8 0 0 0 0 0 0 0 0
Processing BENCH_TEST_RAW_ANALOG ID=770001/l=8 19 0 0 0 1E 6B 40 68
 * BAD channel 5 (CLT): voltage 2.098039392 (raw 107) not in range (1.380596992..1.604477632)
 * BAD channel 6 (IAT): voltage 1.254902000 (raw 64) not in range (0.811403520..0.942982464)
Processing BENCH_TEST_IO_META_INFO ID=770005/l=8 66 0 2 0 0 0 0 0

```

rusefillc, 2023-08-27:
```
 ++++++++++++++++ numOutputs 2
Setting ADDR 0
Processing BENCH_TEST_EVENT_COUNTERS ID=770000/l=8 0 0 0 0 0 0 0 0
Processing BENCH_TEST_RAW_ANALOG ID=770001/l=8 1A 0 0 0 1E 6B 40 67
 * BAD channel 5 (CLT): voltage 2.098039392 (raw 107) not in range (1.380596992..1.604477632)
 * BAD channel 6 (IAT): voltage 1.254902000 (raw 64) not in range (0.811403520..0.942982464)
  HIGH 1@0 2.843v
Processing BENCH_TEST_IO_META_INFO ID=770005/l=8 66 0 2 0 0 0 0 0
 ***** got outputCount 2
Processing BENCH_TEST_BOARD_STATUS ID=770003/l=8 0 70 0 1 66 0 63 0
 * BoardStatus: BoardID=112 numSecs=358
Processing BENCH_TEST_BUTTON_COUNTERS ID=770004/l=8 0 0 0 0 0 0 0 0
Processing BENCH_TEST_EVENT_COUNTERS ID=770000/l=8 0 0 0 0 0 0 0 0
Processing BENCH_TEST_RAW_ANALOG ID=770001/l=8 19 0 0 0 1E 6B 40 67
 * BAD channel 5 (CLT): voltage 2.098039392 (raw 107) not in range (1.380596992..1.604477632)
 * BAD channel 6 (IAT): voltage 1.254902000 (raw 64) not in range (0.811403520..0.942982464)
ERROR! Cycle 1@1 FAILED! (set 0, received 1 2.843v)
!!!!!!!! BAD channel 1 !!!!!!!!!!!!!!!
Setting ADDR 1
Processing BENCH_TEST_EVENT_COUNTERS ID=770000/l=8 0 0 0 0 0 0 0 0
Processing BENCH_TEST_RAW_ANALOG ID=770001/l=8 19 0 0 0 1E 6B 40 67
 * BAD channel 5 (CLT): voltage 2.098039392 (raw 107) not in range (1.380596992..1.604477632)
 * BAD channel 6 (IAT): voltage 1.254902000 (raw 64) not in range (0.811403520..0.942982464)
  HIGH 2@0 2.843v
Processing BENCH_TEST_EVENT_COUNTERS ID=770000/l=8 0 0 0 0 0 0 0 0
Processing BENCH_TEST_RAW_ANALOG ID=770001/l=8 19 0 0 0 1E 6B 40 67
 * BAD channel 5 (CLT): voltage 2.098039392 (raw 107) not in range (1.380596992..1.604477632)
 * BAD channel 6 (IAT): voltage 1.254902000 (raw 64) not in range (0.811403520..0.942982464)
Processing BENCH_TEST_IO_META_INFO ID=770005/l=8 66 0 2 0 0 0 0 0
 ***** got outputCount 2
Processing BENCH_TEST_BOARD_STATUS ID=770003/l=8 0 70 0 1 66 0 63 0
 * BoardStatus: BoardID=112 numSecs=358
Processing BENCH_TEST_BUTTON_COUNTERS ID=770004/l=8 0 0 0 0 0 0 0 0
ERROR! Cycle 2@1 FAILED! (set 0, received 1 2.843v)
!!!!!!!! BAD channel 2 !!!!!!!!!!!!!!!
 ************* SOMETHING BAD SEE ABOVE ************************

```

rusefillc, 2023-08-27:
```
Setting ADDR 0
  sending line=1 value=1
Processing BENCH_TEST_EVENT_COUNTERS ID=770000/l=8 0 0 0 0 0 0 0 0
Processing BENCH_TEST_RAW_ANALOG ID=770001/l=8 19 0 0 0 1E 6B 40 67
  ADC says LOW 1@0 0.001v
ERROR! Cycle 1@0 FAILED! (set 1, received 0 0.001v)
!!!!!!!! BAD channel 1 !!!!!!!!!!!!!!!
Setting ADDR 1
  sending line=2 value=1
Processing BENCH_TEST_EVENT_COUNTERS ID=770000/l=8 0 0 0 0 0 0 0 0
Processing BENCH_TEST_RAW_ANALOG ID=770001/l=8 19 0 0 0 1E 6B 40 67
  ADC says LOW 2@0 0.001v
ERROR! Cycle 2@0 FAILED! (set 1, received 0 0.001v)
!!!!!!!! BAD channel 2 !!!!!!!!!!!!!!!
 ************* SOMETHING BAD SEE ABOVE ************************
Processing BENCH_TEST_IO_META_INFO ID=770005/l=8 66 0 2 0 0 0 0 0
 ***** got outputCount 2
Processing BENCH_TEST_BOARD_STATUS ID=770003/l=8 0 B 0 0 55 0 63 0
 * BoardStatus: BoardID=11 numSecs=85
Processing BENCH_TEST_BUTTON_COUNTERS ID=770004/l=8 0 0 0 0 0 0 0 0
 ++++++++++++++++ numOutputs 2
Setting ADDR 0
  sending line=1 value=1
Processing BENCH_TEST_EVENT_COUNTERS ID=770000/l=8 0 0 0 0 0 0 0 0
Processing BENCH_TEST_RAW_ANALOG ID=770001/l=8 19 0 0 0 1E 6B 40 67
  ADC says LOW 1@0 0.002v
ERROR! Cycle 1@0 FAILED! (set 1, received 0 0.002v)
!!!!!!!! BAD channel 1 !!!!!!!!!!!!!!!
Setting ADDR 1
  sending line=2 value=1
Processing BENCH_TEST_EVENT_COUNTERS ID=770000/l=8 0 0 0 0 0 0 0 0
Processing BENCH_TEST_RAW_ANALOG ID=770001/l=8 19 0 0 0 1E 6B 40 67
  ADC says LOW 2@0 0.001v
ERROR! Cycle 2@0 FAILED! (set 1, received 0 0.001v)
!!!!!!!! BAD channel 2 !!!!!!!!!!!!!!!
 ************* SOMETHING BAD SEE ABOVE ************************
Processing BENCH_TEST_EVENT_COUNTERS ID=770000/l=8 0 0 0 0 0 0 0 0
Processing BENCH_TEST_RAW_ANALOG ID=770001/l=8 19 0 0 0 1E 6B 40 67
Processing BENCH_TEST_IO_META_INFO ID=770005/l=8 66 0 2 0 0 0 0 0
 ***** got outputCount 2
Processing BENCH_TEST_BOARD_STATUS ID=770003/l=8 0 B 0 0 55 0 63 0
 * BoardStatus: BoardID=11 numSecs=85
Processing BENCH_TEST_BUTTON_COUNTERS ID=770004/l=8 0 0 0 0 0 0 0 0
 ++++++++++++++++ numOutputs 2
Setting ADDR 0
  sending line=1 value=1
Processing BENCH_TEST_EVENT_COUNTERS ID=770000/l=8 0 0 0 0 0 0 0 0
Processing BENCH_TEST_RAW_ANALOG ID=770001/l=8 19 0 0 0 1E 6B 40 67
  ADC says LOW 1@0 0.001v
ERROR! Cycle 1@0 FAILED! (set 1, received 0 0.001v)
!!!!!!!! BAD channel 1 !!!!!!!!!!!!!!!
Setting ADDR 1
  sending line=2 value=1
Processing BENCH_TEST_EVENT_COUNTERS ID=770000/l=8 0 0 0 0 0 0 0 0
Processing BENCH_TEST_RAW_ANALOG ID=770001/l=8 19 0 0 0 1E 6B 40 67
  ADC says LOW 2@0 0.001v
ERROR! Cycle 2@0 FAILED! (set 1, received 0 0.001v)
!!!!!!!! BAD channel 2 !!!!!!!!!!!!!!!
 ************* SOMETHING BAD SEE ABOVE ************************
Processing BENCH_TEST_IO_META_INFO ID=770005/l=8 66 0 2 0 0 0 0 0
 ***** got outputCount 2
Processing BENCH_TEST_BOARD_STATUS ID=770003/l=8 0 B 0 0 56 0 63 0
 * BoardStatus: BoardID=11 numSecs=86
Processing BENCH_TEST_BUTTON_COUNTERS ID=770004/l=8 0 0 0 0 0 0 0 0
 ++++++++++++++++ numOutputs 2
Setting ADDR 0
  sending line=1 value=1
Processing BENCH_TEST_EVENT_COUNTERS ID=770000/l=8 0 0 0 0 0 0 0 0
Processing BENCH_TEST_RAW_ANALOG ID=770001/l=8 1A 0 0 0 1E 6B 40 67
  ADC says LOW 1@0 0.001v
ERROR! Cycle 1@0 FAILED! (set 1, received 0 0.001v)
!!!!!!!! BAD channel 1 !!!!!!!!!!!!!!!
Setting ADDR 1
  sending line=2 value=1
Processing BENCH_TEST_EVENT_COUNTERS ID=770000/l=8 0 0 0 0 0 0 0 0
Processing BENCH_TEST_RAW_ANALOG ID=770001/l=8 19 0 0 0 1E 6B 40 67
  ADC says LOW 2@0 0.001v
ERROR! Cycle 2@0 FAILED! (set 1, received 0 0.001v)
!!!!!!!! BAD channel 2 !!!!!!!!!!!!!!!
 ************* SOMETHING BAD SEE ABOVE ************************
Processing BENCH_TEST_EVENT_COUNTERS ID=770000/l=8 0 0 0 0 0 0 0 0

```

rusefillc, 2023-08-27:
```
ERROR! Cycle 1@2 FAILED! (set 1, received 0 0.001v)
  sending line=1 value=0
Processing BENCH_TEST_EVENT_COUNTERS ID=770000/l=8 0 0 0 0 0 0 0 0
Processing BENCH_TEST_RAW_ANALOG ID=770001/l=8 19 0 0 0 1E 6B 40 67
ERROR! Cycle 1@3 FAILED! (set 0, received 1 2.851v)
!!!!!!!! BAD channel 1 !!!!!!!!!!!!!!!
Setting ADDR 1
  sending line=2 value=1
Processing BENCH_TEST_EVENT_COUNTERS ID=770000/l=8 0 0 0 0 0 0 0 0
Processing BENCH_TEST_RAW_ANALOG ID=770001/l=8 19 0 0 0 1E 6B 40 68
Processing BENCH_TEST_IO_META_INFO ID=770005/l=8 66 0 2 0 0 0 0 0
 ***** got outputCount 2
Processing BENCH_TEST_BOARD_STATUS ID=770003/l=8 0 B 0 1 16 0 63 0
 * BoardStatus: BoardID=11 numSecs=278
Processing BENCH_TEST_BUTTON_COUNTERS ID=770004/l=8 0 0 0 0 0 0 0 0
  ADC says LOW 2@0 0.001v
ERROR! Cycle 2@0 FAILED! (set 1, received 0 0.001v)
  sending line=2 value=0
Processing BENCH_TEST_EVENT_COUNTERS ID=770000/l=8 0 0 0 0 0 0 0 0
Processing BENCH_TEST_RAW_ANALOG ID=770001/l=8 19 0 0 0 1E 6B 40 67
  ADC says HIGH 2@1 2.852v
ERROR! Cycle 2@1 FAILED! (set 0, received 1 2.852v)
  sending line=2 value=1
Processing BENCH_TEST_EVENT_COUNTERS ID=770000/l=8 0 0 0 0 0 0 0 0
Processing BENCH_TEST_RAW_ANALOG ID=770001/l=8 19 0 0 0 1E 6B 40 68
ERROR! Cycle 2@2 FAILED! (set 1, received 0 0.002v)
  sending line=2 value=0
Processing BENCH_TEST_EVENT_COUNTERS ID=770000/l=8 0 0 0 0 0 0 0 0
Processing BENCH_TEST_RAW_ANALOG ID=770001/l=8 19 0 0 0 1E 6B 40 67
Processing BENCH_TEST_IO_META_INFO ID=770005/l=8 66 0 2 0 0 0 0 0
 ***** got outputCount 2
Processing BENCH_TEST_BOARD_STATUS ID=770003/l=8 0 B 0 1 16 0 63 0
 * BoardStatus: BoardID=11 numSecs=278
Processing BENCH_TEST_BUTTON_COUNTERS ID=770004/l=8 0 0 0 0 0 0 0 0
ERROR! Cycle 2@3 FAILED! (set 0, received 1 2.850v)
!!!!!!!! BAD channel 2 !!!!!!!!!!!!!!!
 ************* SOMETHING BAD SEE ABOVE ************************
Processing BENCH_TEST_EVENT_COUNTERS ID=770000/l=8 0 0 0 0 0 0 0 0
Processing BENCH_TEST_RAW_ANALOG ID=770001/l=8 19 0 0 0 1E 6B 40 67
 ++++++++++++++++ numOutputs 2
Setting ADDR 0
  sending line=1 value=1
Processing BENCH_TEST_EVENT_COUNTERS ID=770000/l=8 0 0 0 0 0 0 0 0
Processing BENCH_TEST_RAW_ANALOG ID=770001/l=8 1A 0 0 0 1E 6B 40 68
  ADC says LOW 1@0 0.002v
ERROR! Cycle 1@0 FAILED! (set 1, received 0 0.002v)
  sending line=1 value=0
Processing BENCH_TEST_IO_META_INFO ID=770005/l=8 66 0 2 0 0 0 0 0
 ***** got outputCount 2
Processing BENCH_TEST_BOARD_STATUS ID=770003/l=8 0 B 0 1 16 0 63 0
 * BoardStatus: BoardID=11 numSecs=278
Processing BENCH_TEST_BUTTON_COUNTERS ID=770004/l=8 0 0 0 0 0 0 0 0
Processing BENCH_TEST_EVENT_COUNTERS ID=770000/l=8 0 0 0 0 0 0 0 0
Processing BENCH_TEST_RAW_ANALOG ID=770001/l=8 19 0 0 0 1E 6B 40 68
  ADC says HIGH 1@1 2.854v
ERROR! Cycle 1@1 FAILED! (set 0, received 1 2.854v)
  sending line=1 value=1
Processing BENCH_TEST_EVENT_COUNTERS ID=770000/l=8 0 0 0 0 0 0 0 0
Processing BENCH_TEST_RAW_ANALOG ID=770001/l=8 19 0 0 0 1E 6B 40 67
ERROR! Cycle 1@2 FAILED! (set 1, received 0 0.002v)
  sending line=1 value=0
Processing BENCH_TEST_EVENT_COUNTERS ID=770000/l=8 0 0 0 0 0 0 0 0
Processing BENCH_TEST_RAW_ANALOG ID=770001/l=8 19 0 0 0 1E 6B 40 68
Processing BENCH_TEST_IO_META_INFO ID=770005/l=8 66 0 2 0 0 0 0 0
 ***** got outputCount 2
Processing BENCH_TEST_BOARD_STATUS ID=770003/l=8 0 B 0 1 17 0 63 0
 * BoardStatus: BoardID=11 numSecs=279
Processing BENCH_TEST_BUTTON_COUNTERS ID=770004/l=8 0 0 0 0 0 0 0 0
ERROR! Cycle 1@3 FAILED! (set 0, received 1 2.851v)
!!!!!!!! BAD channel 1 !!!!!!!!!!!!!!!
Setting ADDR 1
  sending line=2 value=1
Processing BENCH_TEST_EVENT_COUNTERS ID=770000/l=8 0 0 0 0 0 0 0 0
Processing BENCH_TEST_RAW_ANALOG ID=770001/l=8 19 0 0 0 1E 6B 40 68
  ADC says LOW 2@0 0.002v
ERROR! Cycle 2@0 FAILED! (set 1, received 0 0.002v)
  sending line=2 value=0
Processing BENCH_TEST_EVENT_COUNTERS ID=770000/l=8 0 0 0 0 0 0 0 0
Processing BENCH_TEST_RAW_ANALOG ID=770001/l=8 19 0 0 0 1E 6B 40 68
  ADC says HIGH 2@1 2.851v
ERROR! Cycle 2@1 FAILED! (set 0, received 1 2.851v)
  sending line=2 value=1
Processing BENCH_TEST_IO_META_INFO ID=770005/l=8 66 0 2 0 0 0 0 0
 ***** got outputCount 2
Processing BENCH_TEST_BOARD_STATUS ID=770003/l=8 0 B 0 1 17 0 63 0
 * BoardStatus: BoardID=11 numSecs=279
Processing BENCH_TEST_BUTTON_COUNTERS ID=770004/l=8 0 0 0 0 0 0 0 0
Processing BENCH_TEST_EVENT_COUNTERS ID=770000/l=8 0 0 0 0 0 0 0 0
Processing BENCH_TEST_RAW_ANALOG ID=770001/l=8 19 0 0 0 1E 6B 40 67
ERROR! Cycle 2@2 FAILED! (set 1, received 0 0.002v)
  sending line=2 value=0
Processing BENCH_TEST_EVENT_COUNTERS ID=770000/l=8 0 0 0 0 0 0 0 0
Processing BENCH_TEST_RAW_ANALOG ID=770001/l=8 19 0 0 0 1E 6B 40 68
ERROR! Cycle 2@3 FAILED! (set 0, received 1 2.852v)
!!!!!!!! BAD channel 2 !!!!!!!!!!!!!!!
 ************* SOMETHING BAD SEE ABOVE ************************

```

rusefillc, 2023-08-31:
looks to be working!

Closed 2023-08-31.

Thread 239 (2023-08-27):

2chan default MAP setting is internal MAP i.e. baro pressure

rusefillc, 2023-08-27:
we shall adjust expected MAP to be happy with internal MPX6400 used as MAP

```
 * BAD channel 4 (MAP): voltage 1.117647048 (raw 57) not in range (0.555000000..0.645000064)
```

andreika-git, 2023-08-30:
Adjusted.

Closed 2023-09-17.

Thread 240 (2023-08-27):

2chan IAT/CLT test fails

rusefillc, 2023-08-27:
```
 * BAD channel 5 (CLT): voltage 2.098039392 (raw 107) not in range (1.380596992..1.604477632)
 * BAD channel 6 (IAT): voltage 1.254902000 (raw 64) not in range (0.811403520..0.942982464)
```

does profile match 2chan pull-up? how can I troubleshoot?

andreika-git, 2023-08-30:
2chan uses controllable pull-up resistors, so it has 2700 instead of Hellen default 4700.

Closed 2023-09-17.

Thread 244 (2023-09-01):

proteus fails MAP test just a bit

rusefillc, 2023-09-01:
```
                          Processing BENCH_TEST_RAW_ANALOG_1 ID=770001/l=8 1B 29 35 2C 21 72 44 41
 ***********************************************
 * BAD channel 4 (MAP): voltage 0.647058816 (raw 33) not in range (0.555000000..0.645000064)
 ***********************************************
```

rusefillc, 2023-09-01:
i guess we need just a bit of extra margin for lower voltage?

Closed 2023-09-01.

Thread 245 (2023-09-23):

lambda-x2: add pull down to BT_EN

dron0gus, 2023-09-23:
BT should be disabled while MCU is in reset/bootloader.
Otherwise something bad happens and flashing over UART is not possible.

Thread 246 (2023-09-25):

lambda-x2: add pull-down to BOOT1 (PB2)

dron0gus, 2023-09-25:
BOOT1 = low and BOOT0 = high to enter ROM bootloader on start.
BOOT0 is set to high by jumper/button.
BOOT1 is floating and can cause problems

Thread 247 (2023-09-25):

GDI4 does not always start

rusefillc, 2023-09-25:
sometimes GDI4 does not start on a real vehicle as long as outputs are hooked

workaround is to unhook outputs and click reset on the board

rusefillc, 2023-09-25:
Duplicate of https://github.com/rusefi/rusefi-hardware/issues/209

Closed 2023-09-25.

Thread 249 (2023-10-15):

112-17: PPS2 fails stim check

rusefillc, 2023-10-15:
See config https://github.com/rusefi/rusefi-hardware/commit/07b7704ce36274112d6a261329127d1f6b20baa5

At the moment only PPS2 is unhappy
```
 * BAD channel 3 (PPS2): voltage 0.980392192 (raw 50) not in range (1.004551530..1.110293744)
```

Thread 250 (2023-10-23):

re-order GDI4 rev D

rusefillc, 2023-10-23:
U6 | MCP6004 | TSSOP-14_4.4x5mm_P0.65mm | TP6004-TRC2485774 1MHz TSSOP-14 Operational Amplifier ROHS | 10 | 1 JLCPCB | Extended | $0.6315 | 9 shortfall
-- | -- | -- | -- | -- | -- | -- | -- | --
Q13 | AOD4185 | TO-252-2 | AOD4185C40089440V 40A 15mΩ@10V,20A P Channel TO-252 MOSFETs ROHS | 10 | 1 JLCPCB | Extended | $0.3182 | 9 shortfall

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

Qwerty-OFF, 2023-10-23:
U6 C50282

Closed 2023-10-23.

Thread 251 (2023-10-29):

testEcuDigitalOutput seems broken around high, low and banks

rusefillc, 2023-10-29:
We have one or more problem with ECU output testing on the stim firmware side

hellen112-17 has 19 low side outputs. channels 17-19 are failing test

rusefillc, 2023-10-29:
See https://github.com/rusefi/rusefi-hardware/commit/f8e6445c91802053dcae5e18d64f7fe8df928fed which improves naming in a suspicious area

```
15/40 LS 16 GOOD channel 16
               Setting ADDR 0
               sending line=17 value=1
                          Processing BENCH_TEST_IO_META_INFO ID=770005/l=8 66 0 20 10 0 0 0 0
       CAN ECU says: total=32 outputs of which low side=16
                          Processing BENCH_TEST_BOARD_STATUS ID=770003/l=8 F0 21 0 4 ED 0 49 0
                          Processing BENCH_TEST_BUTTON_COUNTERS ID=770004/l=8 E1 0 0 0 0 0 0 0
                          Processing BENCH_TEST_EVENT_COUNTERS ID=770000/l=8 E0 E0 E0 E0 0 0 F0 0
                          Processing BENCH_TEST_RAW_ANALOG_1 ID=770001/l=8 1B 29 35 2C 20 73 44 42
                          Processing BENCH_TEST_RAW_ANALOG_2 ID=770006/l=8 0 0 45 72 0 0 0 0
                      ADC says HIGH 17@0 1.090v
               sending line=17 value=0
                          Processing BENCH_TEST_EVENT_COUNTERS ID=770000/l=8 E0 E0 E0 E0 0 0 F0 0
                          Processing BENCH_TEST_RAW_ANALOG_1 ID=770001/l=8 1B 29 35 2C 20 73 44 42
                          Processing BENCH_TEST_RAW_ANALOG_2 ID=770006/l=8 0 0 45 72 0 0 0 0
                      ADC says LOW 17@1 0.002v
               sending line=17 value=1
                          Processing BENCH_TEST_EVENT_COUNTERS ID=770000/l=8 E0 E0 E0 E0 0 0 F0 0
                          Processing BENCH_TEST_RAW_ANALOG_1 ID=770001/l=8 1B 29 35 2C 20 73 44 42
                          Processing BENCH_TEST_RAW_ANALOG_2 ID=770006/l=8 0 0 45 72 0 0 0 0
                          Processing BENCH_TEST_IO_META_INFO ID=770005/l=8 66 0 20 10 0 0 0 0
       CAN ECU says: total=32 outputs of which low side=16
                          Processing BENCH_TEST_BOARD_STATUS ID=770003/l=8 F0 21 0 4 ED 0 49 0
                          Processing BENCH_TEST_BUTTON_COUNTERS ID=770004/l=8 E1 0 0 0 0 0 0 0
               sending line=17 value=0
                          Processing BENCH_TEST_EVENT_COUNTERS ID=770000/l=8 E0 E0 E0 E0 0 0 F0 0
                          Processing BENCH_TEST_RAW_ANALOG_1 ID=770001/l=8 1B 29 35 2C 20 73 44 42
                          Processing BENCH_TEST_RAW_ANALOG_2 ID=770006/l=8 0 0 45 72 0 0 0 0
16/40 IGN 1 GOOD channel 17
               Setting ADDR 1
               sending line=18 value=1
                          Processing BENCH_TEST_EVENT_COUNTERS ID=770000/l=8 E0 E0 E0 E0 0 0 F0 0
                          Processing BENCH_TEST_RAW_ANALOG_1 ID=770001/l=8 1B 29 35 2C 20 73 44 42
                          Processing BENCH_TEST_RAW_ANALOG_2 ID=770006/l=8 0 0 45 72 0 0 0 0
                      ADC says HIGH 18@0 1.090v
               sending line=18 value=0
                          Processing BENCH_TEST_IO_META_INFO ID=770005/l=8 66 0 20 10 0 0 0 0
       CAN ECU says: total=32 outputs of which low side=16
                          Processing BENCH_TEST_BOARD_STATUS ID=770003/l=8 F0 21 0 4 ED 0 49 0
                          Processing BENCH_TEST_BUTTON_COUNTERS ID=770004/l=8 E1 0 0 0 0 0 0 0
                          Processing BENCH_TEST_EVENT_COUNTERS ID=770000/l=8 E0 E0 E0 E0 0 0 F0 0
                          Processing BENCH_TEST_RAW_ANALOG_1 ID=770001/l=8 1B 29 35 2C 20 73 44 42
                          Processing BENCH_TEST_RAW_ANALOG_2 ID=770006/l=8 0 0 45 72 0 0 0 0
                      ADC says LOW 18@1 0.002v
               sending line=18 value=1
                          Processing BENCH_TEST_EVENT_COUNTERS ID=770000/l=8 E0 E0 E0 E0 0 0 F0 0
                          Processing BENCH_TEST_RAW_ANALOG_1 ID=770001/l=8 1B 29 35 2C 20 73 44 42
                          Processing BENCH_TEST_RAW_ANALOG_2 ID=770006/l=8 0 0 45 72 0 0 0 0
               sending line=18 value=0
                          Processing BENCH_TEST_EVENT_COUNTERS ID=770000/l=8 E0 E0 E0 E0 0 0 F0 0
                          Processing BENCH_TEST_RAW_ANALOG_1 ID=770001/l=8 1B 29 35 2C 20 73 44 42
                          Processing BENCH_TEST_RAW_ANALOG_2 ID=770006/l=8 0 0 45 72 0 0 0 0
                          Processing BENCH_TEST_IO_META_INFO ID=770005/l=8 66 0 20 10 0 0 0 0
       CAN ECU says: total=32 outputs of which low side=16
                          Processing BENCH_TEST_BOARD_STATUS ID=770003/l=8 F0 21 0 4 EE 0 49 0
                          Processing BENCH_TEST_BUTTON_COUNTERS ID=770004/l=8 E1 0 0 0 0 0 0 0

```

Closed 2023-10-29.

Thread 253 (2023-10-29):

ETB HW QC

rusefillc, 2023-10-29:
we need to confirm ETB soldering on 112-17 and other boards

rusefillc, 2023-10-30:
запрограммировал прямое управление

```
		directWritePad(io->controlPin, 1);
		directWritePad(io->directionPin1, direction);
```

конфигурация
```
    engineConfiguration->etbIo[0].controlPin = Gpio::MM100_OUT_PWM6;
    // DIR pin
	engineConfiguration->etbIo[0].directionPin1 = Gpio::MM100_SPI2_MISO;
   	// Disable pin
   	engineConfiguration->etbIo[0].disablePin = Gpio::MM100_SPI2_MOSI;
```

проблема: мультиметром вижу ожидаемое мигание 0<>.3в на TLE9201 DIR пине 1, но 0в на PWM пин 12. это дефект софта или высокий уровень пина controlPin не будет виден мультиметром?

Closed 2023-10-30.

Thread 254 (2023-10-29):

VR input soldering test

rusefillc, 2023-10-29:
let's use stim board to validate max9924 soldering on 112-17

rusefillc, 2023-10-29:
I am trying [26C](https://rusefi.com/docs/pinouts/stim/?pin=24C) for https://rusefi.com/docs/pinouts/hellen/hellen-112-17/?connector=H-112&pin=201

and digital toggle https://rusefi.com/docs/pinouts/stim/?pin=22B&connector=main for https://rusefi.com/docs/pinouts/hellen/hellen-112-17/?connector=H-112&pin=213

@Qwerty-OFF do not see event counter going up?

rusefillc, 2023-10-29:
works with 4.7K pull up to 5v

Closed 2023-10-29.

Thread 255 (2023-11-16):

mcz33810 test board

rusefillc, 2023-11-16:
Looking to make a test board around mcz33810 https://www.nxp.com/products/power-management/smart-switches-and-drivers/low-side-switches/automotive-engine-control-ic:MC33810

26 superseal connector any pinout

* SPI on the connector and also vias to solder wires
* GND/power
* 8 outputs
* igbts same as https://github.com/rusefi/rusefi-hardware/issues/159

We have footprint ready https://github.com/rusefi/kicad6-libraries/commit/a723b4c5e3fc240597fa57c9205f5f1ac134d35b

rusefillc, 2023-11-16:
first part of the schematics https://github.com/andreika-git/hellen-one/issues/207#issuecomment-1336519453

rusefillc, 2023-11-17:
@Qwerty-OFF проводочек откуда куда?

Nadezhda-n, 2023-11-21:
> first part of the schematics [andreika-git/hellen-one#207 (comment)](https://github.com/andreika-git/hellen-one/issues/207#issuecomment-1336519453)

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
Эта часть заменяется на https://github.com/rusefi/rusefi-hardware/issues/159 ?
Или на другие какие-то цепи ставить (IGN1/D_IGN1)?

Closed 2023-11-21.

Thread 256 (2024-01-17):

Gdi4: amperage measurement precision

rusefillc, 2024-01-17:
Claim of 15% error on peak amperage

mck1117, 2024-01-18:
have a scope shot with a high enough bandwidth probe to ensure you aren't losing information?

Thread 259 (2024-02-22):

bad yaml interactive pinout does not fail

rusefillc, 2024-02-22:
https://github.com/rusefi/rusefi-hardware/tree/main/Toyota-JZA80/connectors contains bad yaml but https://github.com/rusefi/rusefi-hardware/actions/runs/7993182318/job/21828392715 did not fail

rusefillc, 2024-02-22:
@chuckwagoncomputing is that github action problem here or https://github.com/chuckwagoncomputing/interactive-pinout defect?

rusefillc, 2024-02-22:
@chuckwagoncomputing so https://github.com/rusefi/rusefi-hardware/commit/438a45d7ff805adb57441960c9a4e64cd7adb693 is what I need in all my GHA jobs?

chuckwagoncomputing, 2024-02-22:
Possibly. I would also recommend `warnings: notice` instead of `warnings: false`. That will make warnings more noticeable.

Thread 260 (2024-02-25):

two issues with Breakout-24pin

rusefillc, 2024-02-25:
breakout-boards/Breakout-24pin

1) крайние шесть пинов побольше, там отверстия под провод нужно 1.8мм диаметра - это пины A1 B1 C1 A8 B8 C8
https://rusefi.com/docs/pinouts/hellen/alphax-2chan/

2) нужно уменьшить плату над разъёмом - сейчас он не надевается правильно

Nadezhda-n, 2024-02-26:
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

@rusefillc насколько уменьшить? Как он надевается?

Nadezhda-n, 2024-02-28:
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

rusefillc, 2024-03-04:
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

Nadezhda-n, 2024-03-05:
> @Nadezhda-n need 24pins_In_3conn_0.2_gerbers.zip file ideally with 0.2 silk

на шелке все было ок, файлик с нужным названием добавила

Thread 261 (2024-03-05):

revive tle9104

rusefillc, 2024-03-05:
https://github.com/rusefi/rusefi-hardware/tree/main/tle9104-breakout

* convert to kicad 7
* fix paths considering current location
* export BOM and CPL files into "export" folder
* TLE9104 use jlcpcb part number C2650386

Nadezhda-n, 2024-03-13:
@rusefillc
Компоненты для сквозного монтажа тоже должны иметь номер LCSC?

rusefillc, 2024-03-13:
@Nadezhda-n давай попробуем без стресса

Nadezhda-n, 2024-03-13:
> @Nadezhda-n давай попробуем без стресса

Тогда вроде обновила https://github.com/rusefi/rusefi-hardware/blob/main/tle9104-breakout/export/tle9104-breakout-bom.csv
Посмотри, все ли я поняла верно?

rusefillc, 2024-03-28:
@Nadezhda-n не вижу placement файла?

Nadezhda-n, 2024-03-29:
> @Nadezhda-n не вижу placement файла?

потерялся...( но уже найден и в нужной папке!

rusefillc, 2024-03-29:
@Nadezhda-n у тебя есть VPN или другой способ протестировать возмозность заказа? что-то у меня не принимает файлы ругается на формат

Nadezhda-n, 2024-03-29:
> @Nadezhda-n у тебя есть VPN или другой способ протестировать возмозность заказа? что-то у меня не принимает файлы ругается на формат

vpn есть, но то ли для Румынии не делают монтаж, то ли что-то не работает...
Но я помню, что просто файлы не работали, я их по старому примеру отредактировала. Проверь еще раз, пожалуйста

Closed 2024-09-29.

Thread 262 (2024-03-07):

lambda-x2: heater wire usability

rusefillc, 2024-03-07:
At the moment lambda-x2 requires that heater wires are crimped together outside of the board

desired to make crimpling simpler
we do not usually use many pins anyway

rusefillc, 2024-03-07:
Would something like below be possible with current hardware?

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

Thread 263 (2024-03-11):

lambda-X2 REV1 A005 LSU4.9 board config

ggurov, 2024-03-11:
https://github.com/rusefi/rusefi-hardware/tree/main/lambda-x2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

 suggests that for lambda-x2  LSU 4.9 sensor i need to remove : R25 R41 R72 R73, and keep R24 R71 on board. board i received is labeled A005, REV1, 4.9 LSU.  R25 and R72 are still present (these are on the REMOVE list), both R24 and R71 from the KEEP list are present. R71 measures at 18.5k OHM.

what to do ? plug it in  ? remove R25 and R72 ?

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

rusefillc, 2024-03-11:
@ggurov this looks like mistake on my end - please remove R25 and R72

Closed 2024-03-11.

Thread 266 (2024-05-15):

GDI4: spark from R71

rusefillc, 2024-05-15:
R71 has acted as fuse in some human error (?) scenario

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

NOx-z, 2024-05-15:
The board is a "Rev A", and appears to be connected to Injector1_P. Prior to this blowing I was doing short circuit tests on INJ1 by twisting the wires together (no injector). All of the tests did a single spike for 2.1uS, likely the number of clock cycles the PT2001 is required to have from START to Erroring out. For these tests I also re-wrote (commented out) the microcode to remove  "boost0_err" which would be called in an under-time threshold.

Upon doing a number of tests I reverted the code and the TBoostMin (from 0 or 1) back to 100.. Amperage set to a rather massive 24A
This resistor blew on first test click with real injector.
Bank1 (INJ1/INJ2) failed to click.
Bank2 (INJ3/INJ4) successfully clicked the same injector.

Looking into the datasheets these appear to be rated at 1/8 Watt.. this has been plenty for every single situation except for this one.. and they seem to be doing a fine job at protecting further..

I need to verify the microcode and configuration was all set correctly, replace this resistor, and try to do a normal click again to verify nothing else blew.

.. Is it worth pursuing the short circuit test further? One goal was simply to see capabilities of the board after pushing it to a moderate degree with these race injectors, and I was curious about upper limit elsewhere..

NOx-z, 2024-05-15:
I removed the open resistor, and added a removeable jumper, and am now getting clicks again on INJ1.
I actually needed to regenerate microcode and reupload for full sequence (it was only doing Boost, not peak nor hold), so this is likely pointing to some issue in there along with my tests.

I dont feel like frying anything more important (though I have many spares) with more tests..

What was the original purpose of these 0R ?
do we like that it may fuse (under extreme circumstances) ?

Thread 267 (2024-06-11):

MX23 18 pin

rusefillc, 2024-06-11:
need MX23A18NF1 footprint *FOR ALTIUM DESIGNER*

we have 26 pin sibling used in https://github.com/rusefi/rusefi-hardware/tree/main/wideband-F103 so we shall use consistent file name and location if possible

Nadezhda-n, 2024-06-19:
> location

а куда его сохранять?

Nadezhda-n, 2024-06-19:
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

rusefillc, 2024-06-19:
@Nadezhda-n в папку https://github.com/rusefi/kicad-libraries-private/tree/master/AD ?

Nadezhda-n, 2024-06-19:
готово @rusefillc

Closed 2024-10-05.

Thread 270 (2024-07-12):

GDI ease of access

rusefillc, 2024-07-12:
@NOx-z from your experience poking into GDI4 which areas should be more accessible?

NOx-z, 2024-07-14:
a few things I was thinking of:
making the onboard fuse more accessible for easy replacement (away from the big connector, or at least just outside of it)
grouping the GDI banks in consistent footprint, almost then as a module in kicad
Silkscreen for the FETs to specify what the are, for example, HS3, maybe next tot he Q# component name, so less referencing the schematics for diagnosis

and likely more, but that's initially what comes to mind

Thread 271 (2024-09-21):

Ford TBD board is asking for shape improvement

rusefillc, 2024-09-21:
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

rusefillc, 2024-09-21:
Need a good photo of board outline maybe on graph paper? Maybe https://www.creativecenter.brother/en-us/home/home-category/learning-activities/organization-tools/graph-paper-1mm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

rusefillc, 2024-09-21:
is it https://rusefi.com/forum/viewtopic.php?f=4&t=1684? i could be very wrong

Thread 272 (2024-09-29):

mini48-stm32 remove old files

rusefillc, 2024-09-29:
Looks like https://github.com/rusefi/rusefi-hardware/tree/main/mini48-stm32 has both older kicad format and newer kicad format files?

Nadezhda-n, 2024-09-30:
@rusefillc
deleted unnecessary files

Closed 2024-09-30.

Thread 274 (2024-09-29):

mini48-stm32 smaller crystal

rusefillc, 2024-09-29:
is 8MHz x1 available in much smaller physical size or would we have to change frequency (and firmware?)

rusefillc, 2024-10-03:
See also https://github.com/rusefi/libfirmware/issues/21

Thread 277 (2024-09-30):

D1 placement

rusefillc, 2024-09-30:
D1 is pretty close to the mounting hole (the alpha had traces going right against the hole, I had to add plastic to guard against the screws I put in to hold the connector , so I was looking at what is near such holes) but it may not be an issue

Qwerty-OFF, 2024-10-09:
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

Closed 2024-10-09.

Thread 278 (2024-09-30):

F1 placement

rusefillc, 2024-09-30:
F1 the fuse that can commonly blow, is right near the plastic connector and sort of jammed in with other components, this is something that is likely to be replaced when things go awry and melting plastic isnt fun

Qwerty-OFF, 2024-10-09:
Also https://github.com/andreika-git/hellen-one/issues/393
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

Closed 2024-10-09.

Thread 279 (2024-09-30):

0R keep or remove?

rusefillc, 2024-09-30:
just noting, the 0R resistors do act as a fuse as well, from previous attempt of seeing output on a shorted line can bust these.. may be fine from a design standpoint, but possibly, depending on power, we may consider removing them? they only had an issue on the shorted-test

Closed 2024-10-09.

Thread 280 (2024-10-22):

предложение по улучшению схемы GDI4

romioRN, 2024-10-22:
Предлагаю спроектировать подсоединение проводки к разъемам ЭБУ таким образом, чтобы проводка двигателя не пересекалась с проводкой кузова для того, чтобы упростить монтаж/демонтаж и уменьшить количество соединений в деталях жгута проводки.

rusefillc, 2024-10-28:
https://github.com/romioRN/fw-custom-Cat-GDI/tree/main/%D0%91%D0%BB%D0%BE%D0%BA%20%D1%83%D0%BF%D1%80%D0%BE%D0%B2%D0%BB%D0%B5%D0%BD%D0%B8%D1%8F%20%D0%BF%D1%80%D1%8F%D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

rusefillc, 2024-10-28:
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

Thread 283 (2024-11-15):

GDI-4ch FW to read index pin

rusefillc, 2024-11-15:
We need provisions for two GDI4 units to share same CANbus

let's have a physical index pin:
* in case of floating/PD we consider index=0
* in case of a pull-up we consider index=1

dron0gus, 2024-12-17:
https://github.com/rusefi/libfirmware/pull/24

dron0gus, 2024-12-17:
https://github.com/rusefi/rusefi-hardware/pull/289

Closed 2024-12-17.

Thread 284 (2024-11-15):

GDI-4ch to broadcast GM fuel pressure sensor data over CAN

rusefillc, 2024-11-15:
We need the GM fuel sensor decoder https://github.com/rusefi/rusefi-hardware/tree/main/SENT-box/firmware into https://github.com/rusefi/rusefi-hardware/tree/main/GDI-4ch/firmware please

dron0gus, 2024-12-14:
step 1 https://github.com/rusefi/rusefi-hardware/pull/286

dron0gus, 2024-12-14:
GDI-4ch rev d.
IN_DIN4 is used for SENT.
C101 removed
R104 replaced with 4.7K.
GM fuel pressure sensor:
```
---- SENT input 0 ----
Unit time 62 timer ticks
Pause pulse detected No
Total pulses 1215989
Last valid fast msg Status 0xC Sig0 0x0C5 Sig1 0x0CB
Slow channels:
 ID 16: 756
 ID 22: 755
HW overflows 0
Pause pulses 0
Restarts 0
Interval errors 0 short, 1 long
Total frames 135141 with CRC error 0 (0%)
Total slow channel messages 7507 with crc6 errors 0 (0%)
Sync errors 0
--------------------
```

dron0gus, 2024-12-14:
Temperature is transmitted in two slow channels: 16 and 22. Convertion is still not clear:
Temperature is close to zero:
```
 ID 22: 565
 ID 16: 566
```

Below zero
```
 ID 22: 527
 ID 16: 528

 ID 22: 538
 ID 16: 538
```

Room temperature (20..22 C)
```
 ID 22: 689
 ID 16: 689
```

Just boiled water
```
 ID 22: 1220
 ID 16: 1221

 ID 22: 1202
 ID 16: 1203
```

Cooled a bit
```
 ID 22: 1151
 ID 16: 1152
```

Thread 288 (2024-12-14):

GDI8: same CANbus data with sensor powered and not powered

rusefillc, 2024-12-14:
GDI8
SENT1

```
ID=47909x,Type=D,Length=4,Data=14180C0E
ID=47910x,Type=D,Length=8,Data=00005C95EFBEADDE
```

rusefillc, 2024-12-14:
https://github.com/rusefi/rusefi-hardware/issues/284

rusefillc, 2024-12-14:
@dron0gus
```
Total slow channel messages 0 + 0 with crc6 errors 0 (0%)
Sync errors 0 alive=68
                      --------------------
FAULT fault=7 status=1 status2=1F 0x1A6=303 0x1A7=C0C 0x1A8=30
---- SENT input 0 ----
Unit time 82 timer ticks
Pause pulse detected No
Total pulses 6
Slow channels:
HW overflows 0
Pause pulses 0
Restarts 8
Interval errors 0 short, 0 long
Total frames 0 with CRC error 0 (0%)
Total slow channel messages 0 + 0 with crc6 errors 0 (0%)
Sync errors 0 alive=69
                      --------------------
FAULT fault=7 status=1 status2=1F 0x1A6=303 0x1A7=C0C 0x1A8=30
---- SENT input 0 ----
Unit time 82 timer ticks
Pause pulse detected No
Total pulses 6
Slow channels:
HW overflows 0
Pause pulses 0
Restarts 8
Interval errors 0 short, 0 long
Total frames 0 with CRC error 0 (0%)
Total slow channel messages 0 + 0 with crc6 errors 0 (0%)
Sync errors 0 alive=70
                      --------------------
FAULT fault=7 status=1 status2=1F 0x1A6=303 0x1A7=C0C 0x1A8=30
---- SENT input 0 ----
Unit time 82 timer ticks
Pause pulse detected No
Total pulses 6
Slow channels:
HW overflows 0
Pause pulses 0
Restarts 8
Interval errors 0 short, 0 long
Total frames 0 with CRC error 0 (0%)
Total slow channel messages 0 + 0 with crc6 errors 0 (0%)
Sync errors 0 alive=71
                      --------------------

```

rusefillc, 2024-12-14:
it was a HW issue - things are better once capacitor was removed

Closed 2024-12-14.

Thread 293 (2025-01-25):

one f103 to run two PT2001

rusefillc, 2025-01-25:
GDI8 hardware has J11 and J12 provisions to make one F103 control both PT2001 chips

We need the firmware side of this:
* time to make decision if same firmware to run both legacy GDI4 and GDI8 or compile time options? probably not persistent configuration?

dron0gus, 2025-01-29:
HW TODOs:
1. Vbat sencing
2. individual GPIOS for CS, DRVEN, RESETB (something else?)
3. cost reduction: clock from STM32 PA8 = MCO, remove Y3, Y4.
4. measure PT2001 high voltage output with STM32 ADC?

dron0gus, 2025-01-29:
5. PT2001 OA_1, OA_2 на ADC STM32?

rusefillc, 2025-01-29:
* MCO, remove Y3, Y4 давай очень сильно отложим пока

Closed 2025-02-04.

Thread 295 (2025-02-04):

revive lambda-x2 rev 1 BOM

rusefillc, 2025-02-04:
Need to revive BOM

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

rusefillc, 2025-02-04:
@dron0gus priority is on https://github.com/rusefi/rusefi-hardware/blob/main/lambda-x2/export/rev1/lambda-x2_JLCBOM-cheaper.csv file, not sure if even worth touching the kicad files at all

dron0gus, 2025-02-04:
https://github.com/rusefi/rusefi-hardware/pull/297

Thread 312 (2025-08-29):

WBO CANbus bootloader

rusefillc, 2025-08-29:
Do we have OpenBLT already? Are we just missing documentation? What is the dongle we recommend?

Thread 313 (2025-08-30):

Breakout-24pin to superseal

rusefillc, 2025-08-30:
@Nadezhda-n we have https://github.com/rusefi/rusefi-hardware/tree/main/breakout-boards/Breakout-24pin

please make a variation going into 26 superseal in https://github.com/rusefi/rusefi-hardware/tree/main/breakout-boards/Breakout-24pin-superseal folder

Nadezhda-n, 2025-08-30:
@rusefillc  https://github.com/rusefi/rusefi-hardware/blob/main/breakout-boards/Breakout-24pin-superseal/export/Breakout-24pin-superseal-gerber.zip

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

Closed 2025-08-30.
