rusefi/rusefi-hardware/breakout-boards/adapter-board-me17-112-B-schematic.pdf

A1 A10 A11 A12 A13 A14 A15 A16 A17 A18 A19 A2 A20 A21 A22 A23 A24 A25 A26 A27 A28 A3A4A5A6A7A8A9 J1A B1 B10 B11 B12 B13 B14 B15 B16 B17 B18 B19 B2 B20 B21 B22 B23 B24 B25 B26 B27 B28 B3B4B5B6B7B8B9 J1C

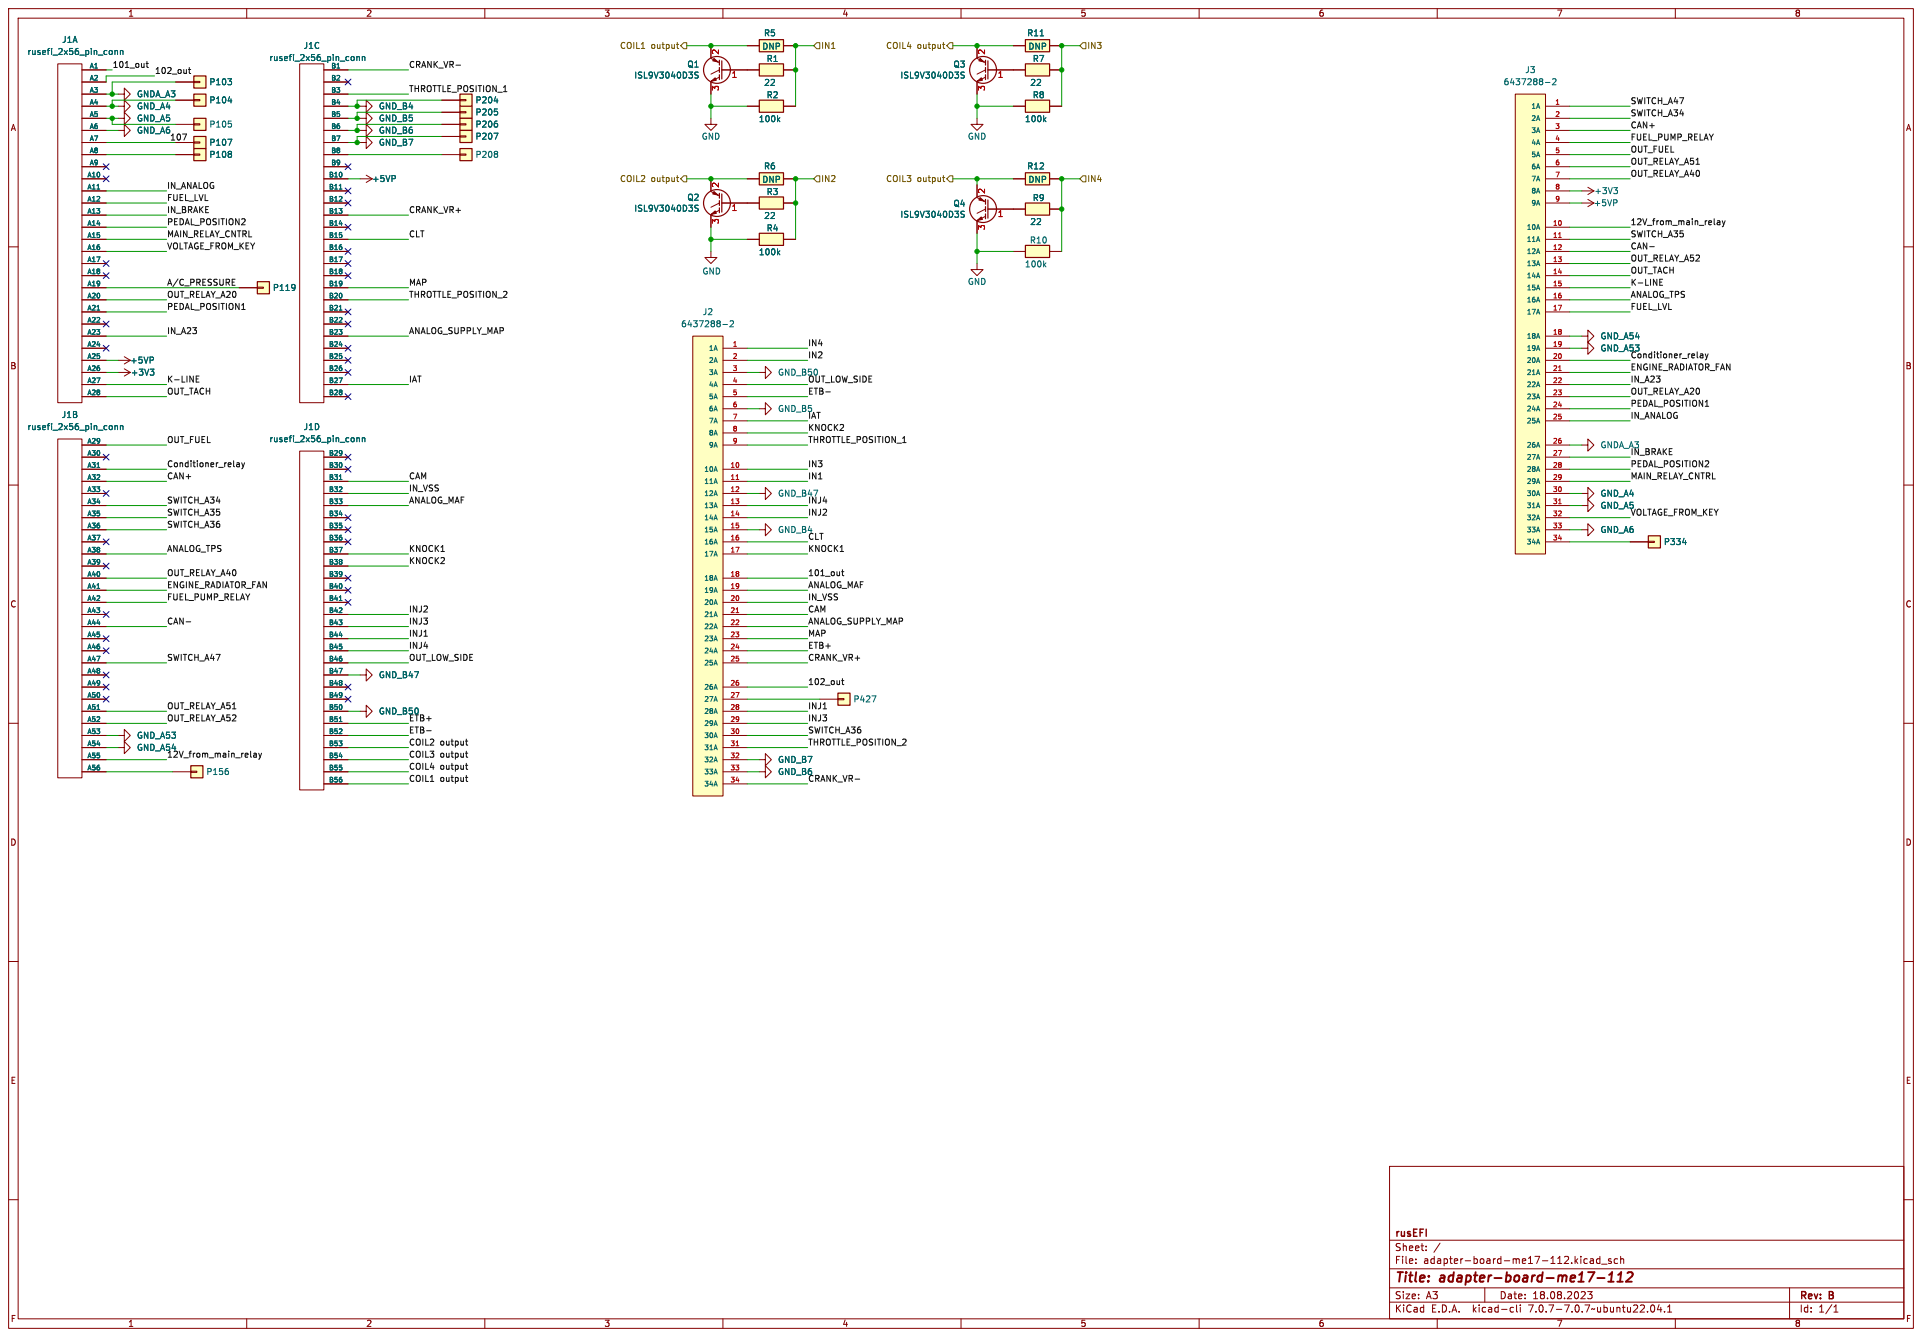
[picture p97: page 1]

File: adapter-board-me17-112.kicad_sch Sheet: / rusEFI

Id: 1/1 Title: adapter-board-me17-112
