rusefi/rusefi-hardware/classic-designs/frankenso/frankenso_schematic.pdf

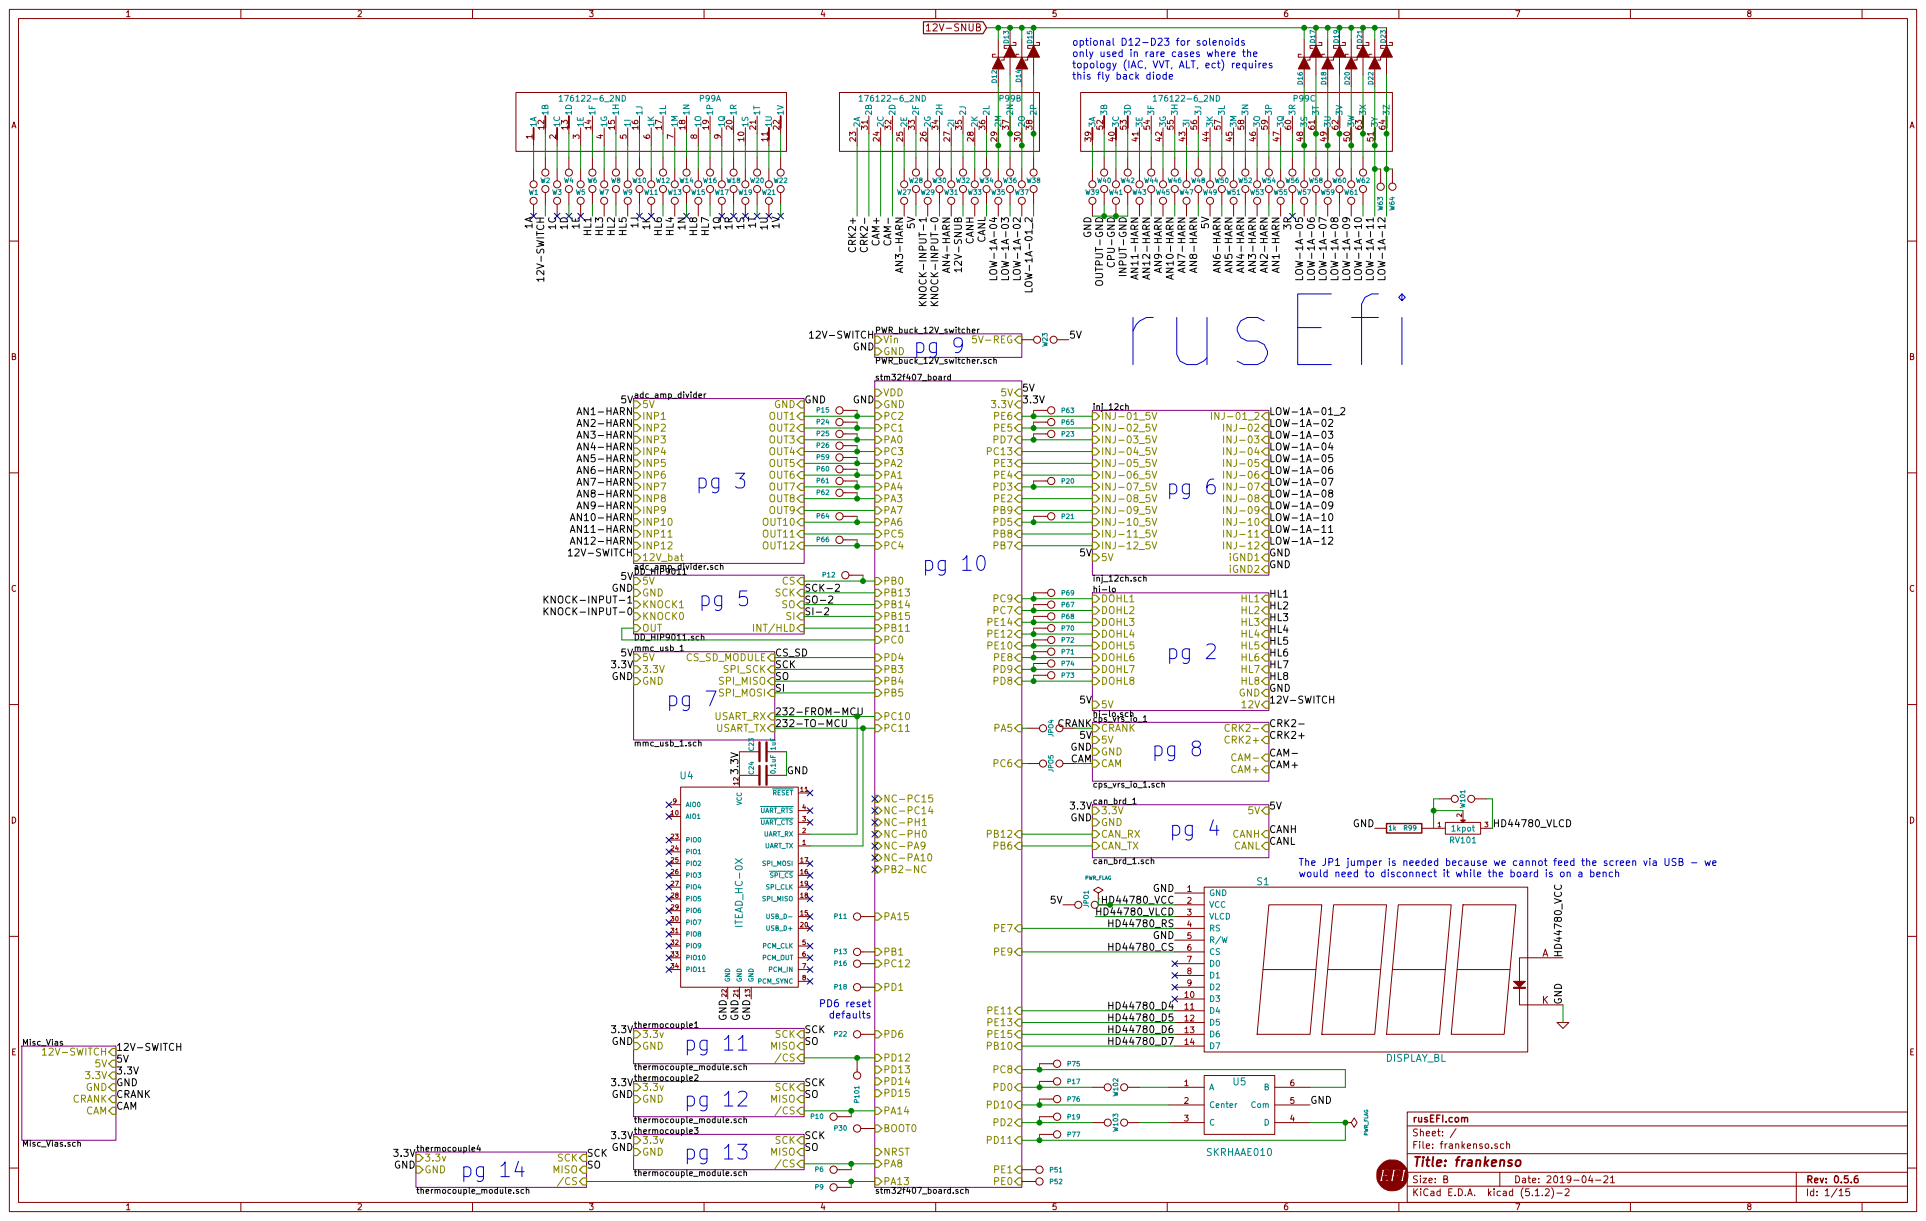
[picture p102: page 1]

optional D12-D23 for solenoids
only used in rare cases where the
topology (IAC, VVT, ALT, ect) requires
this fly back diode

W39W40W41W42W43W44W45W46W47W48W49W50W51W52W53W54W55W56W57W58W59W60 CPU-GND INPUT-GND OUTPUT-GND

5V | iGND1 iGND2

5V | CS pg 5 SCK

NC-PH1 GND 3.3V GND GND

CANH
CANL
The JP1 jumper is needed because we cannot feed the screen via USB - we would need to disconnect it while the board is on a bench

File: frankenso.sch Sheet: / rusEFI.com

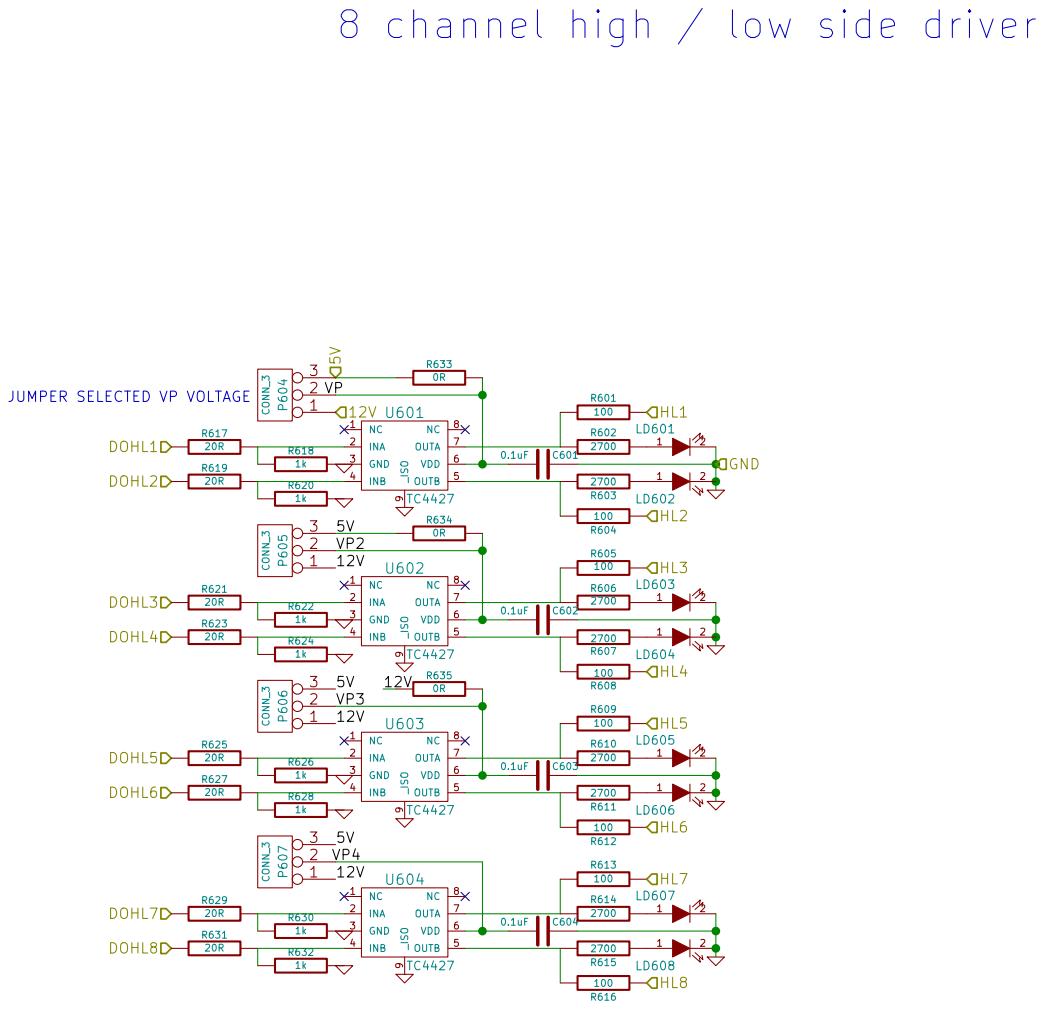
[picture p103: page 2]

TC4427 JUMPER SELECTED VP VOLTAGE

20R | R626 | INA 2 GND 3

File: hi-lo.sch Sheet: /hi-lo/ rusEFI.com

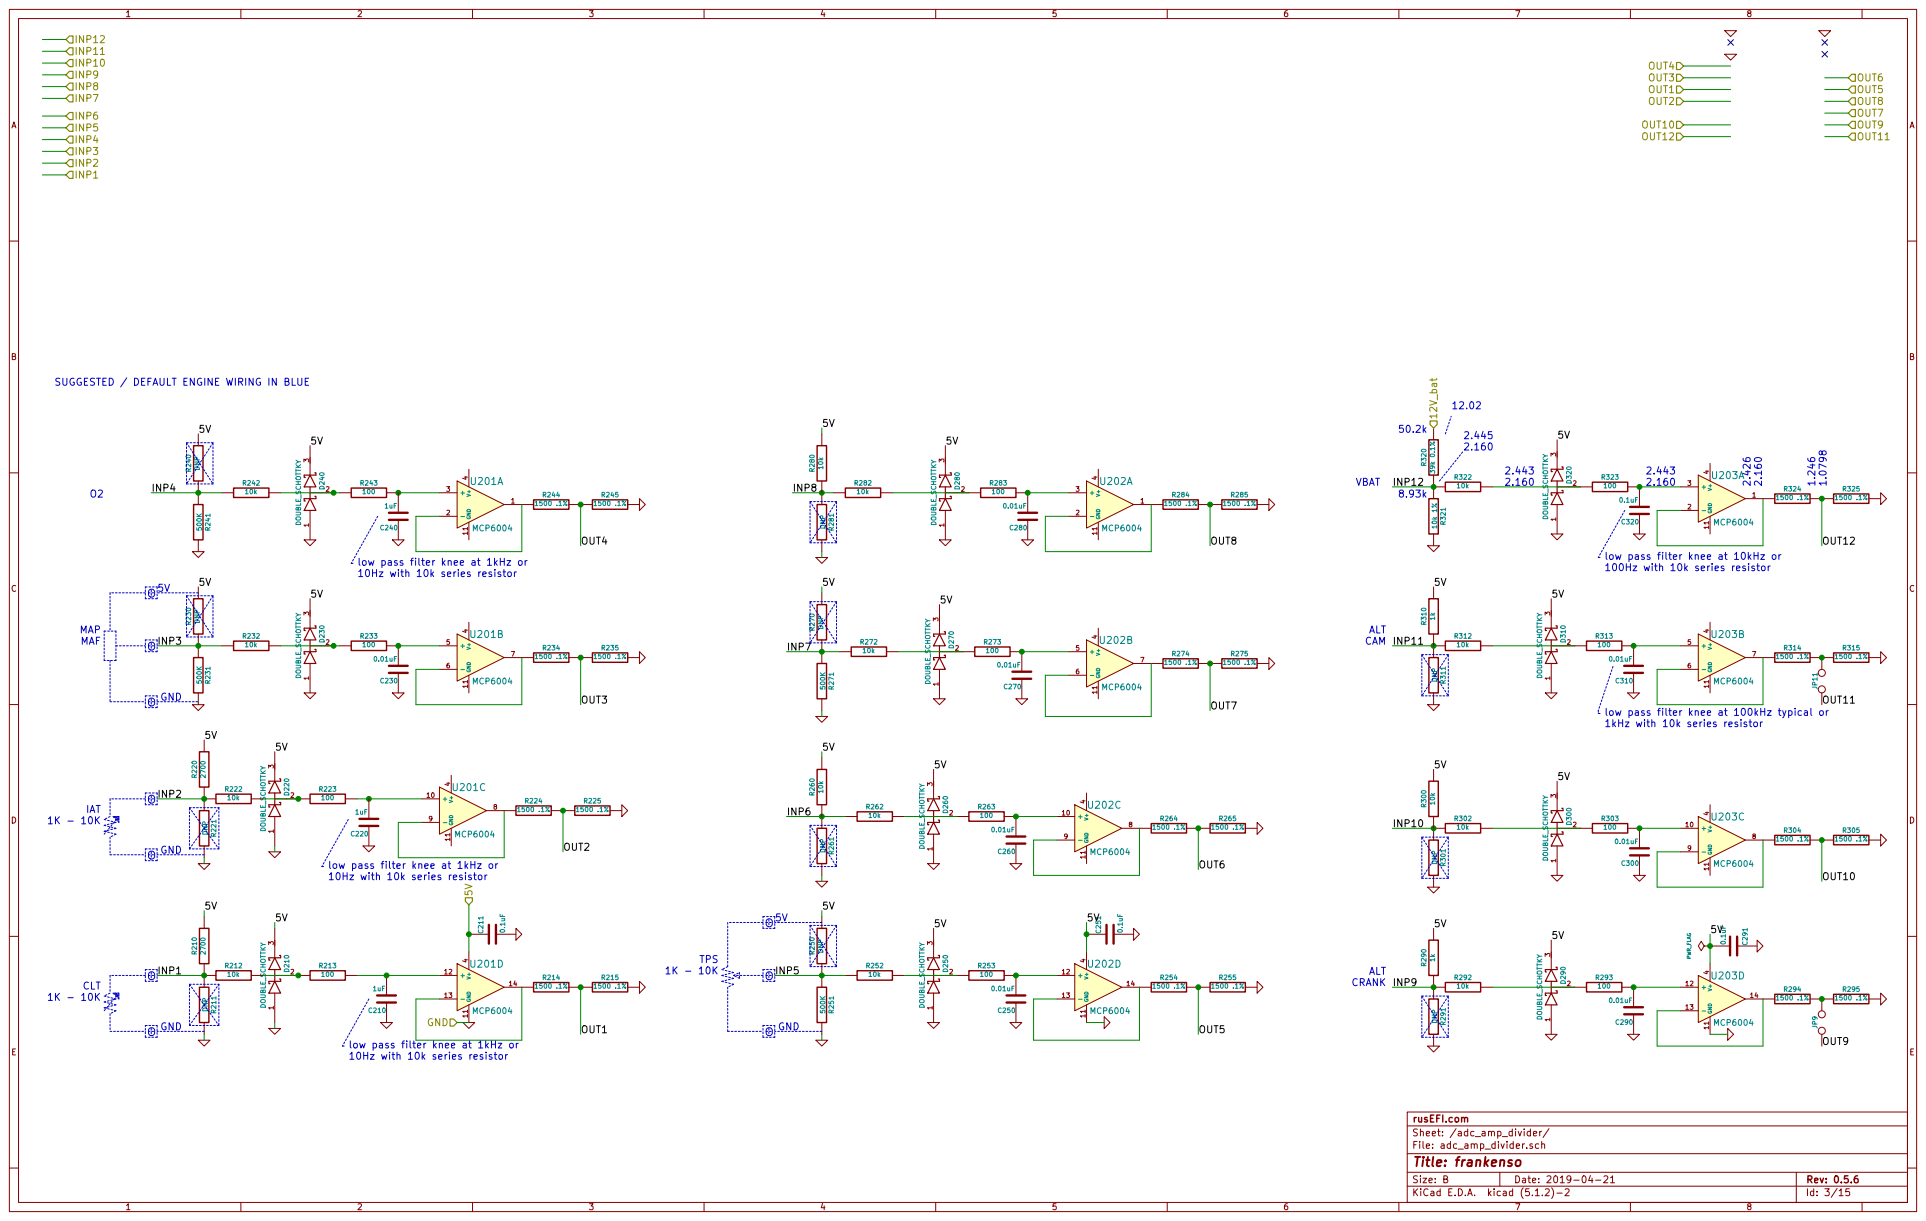
[picture p104: page 3]

SUGGESTED / DEFAULT ENGINE WIRING IN BLUE

low pass filter knee at 10kHz or 100Hz with 10k series resistor low pass filter knee at 1kHz or 10Hz with 10k series resistor C220

low pass filter knee at 100kHz typical or 1kHz with 10k series resistor

low pass filter knee at 1kHz or 10Hz with 10k series resistor

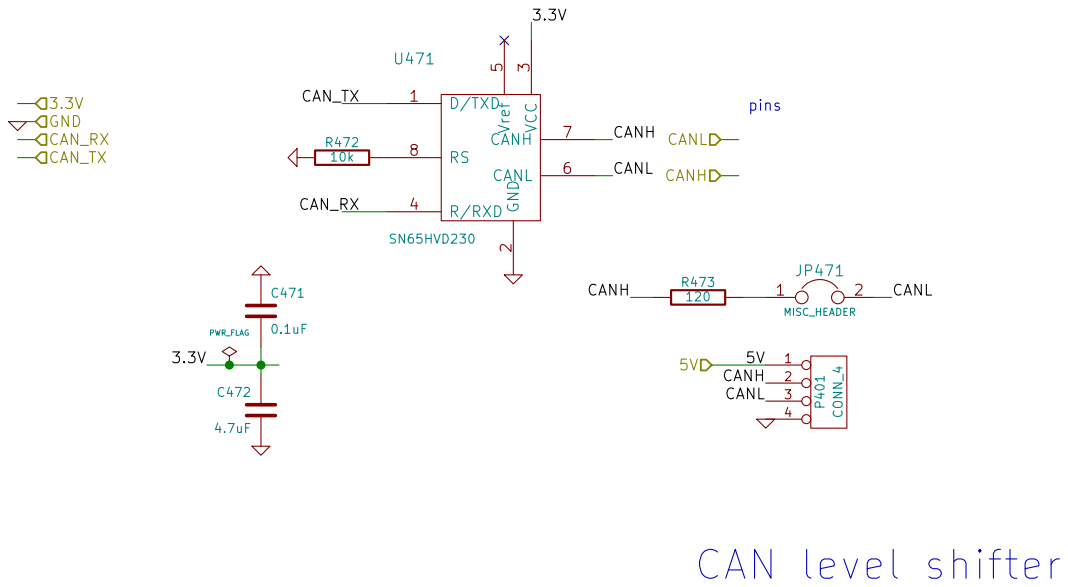
[picture p105: page 4]

3 R/RXD 4 Vref 5 CANL 6 CANH 7 RS 8 U471

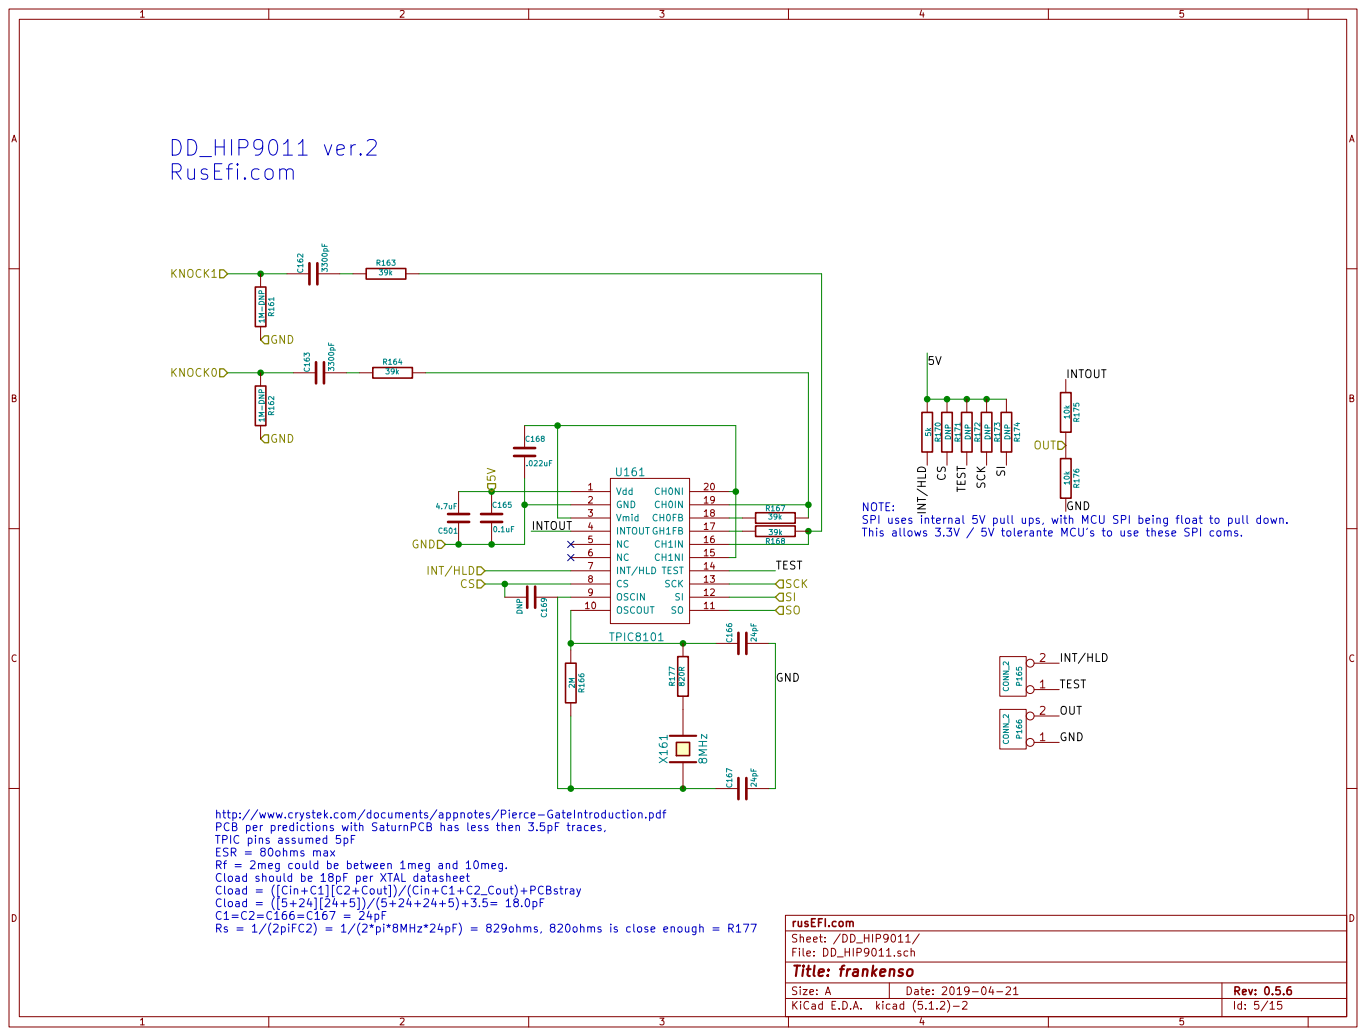
[picture p106: page 5]

SPI uses internal 5V pull ups, with MCU SPI being float to pull down.
This allows 3.3V / 5V tolerante MCU's to use these SPI coms.

http://www.crystek.com/documents/appnotes/Pierce-GateIntroduction.pdf
PCB per predictions with SaturnPCB has less then 3.5pF traces,
TPIC pins assumed 5pF
ESR = 80ohms max
Rf = 2meg could be between 1meg and 10meg.
Cload should be 18pF per XTAL datasheet
Cload = ([Cin+C1][C2+Cout])/(Cin+C1+C2_Cout)+PCBstray
Cload = ([5+24][24+5])/(5+24+24+5)+3.5= 18.0pF

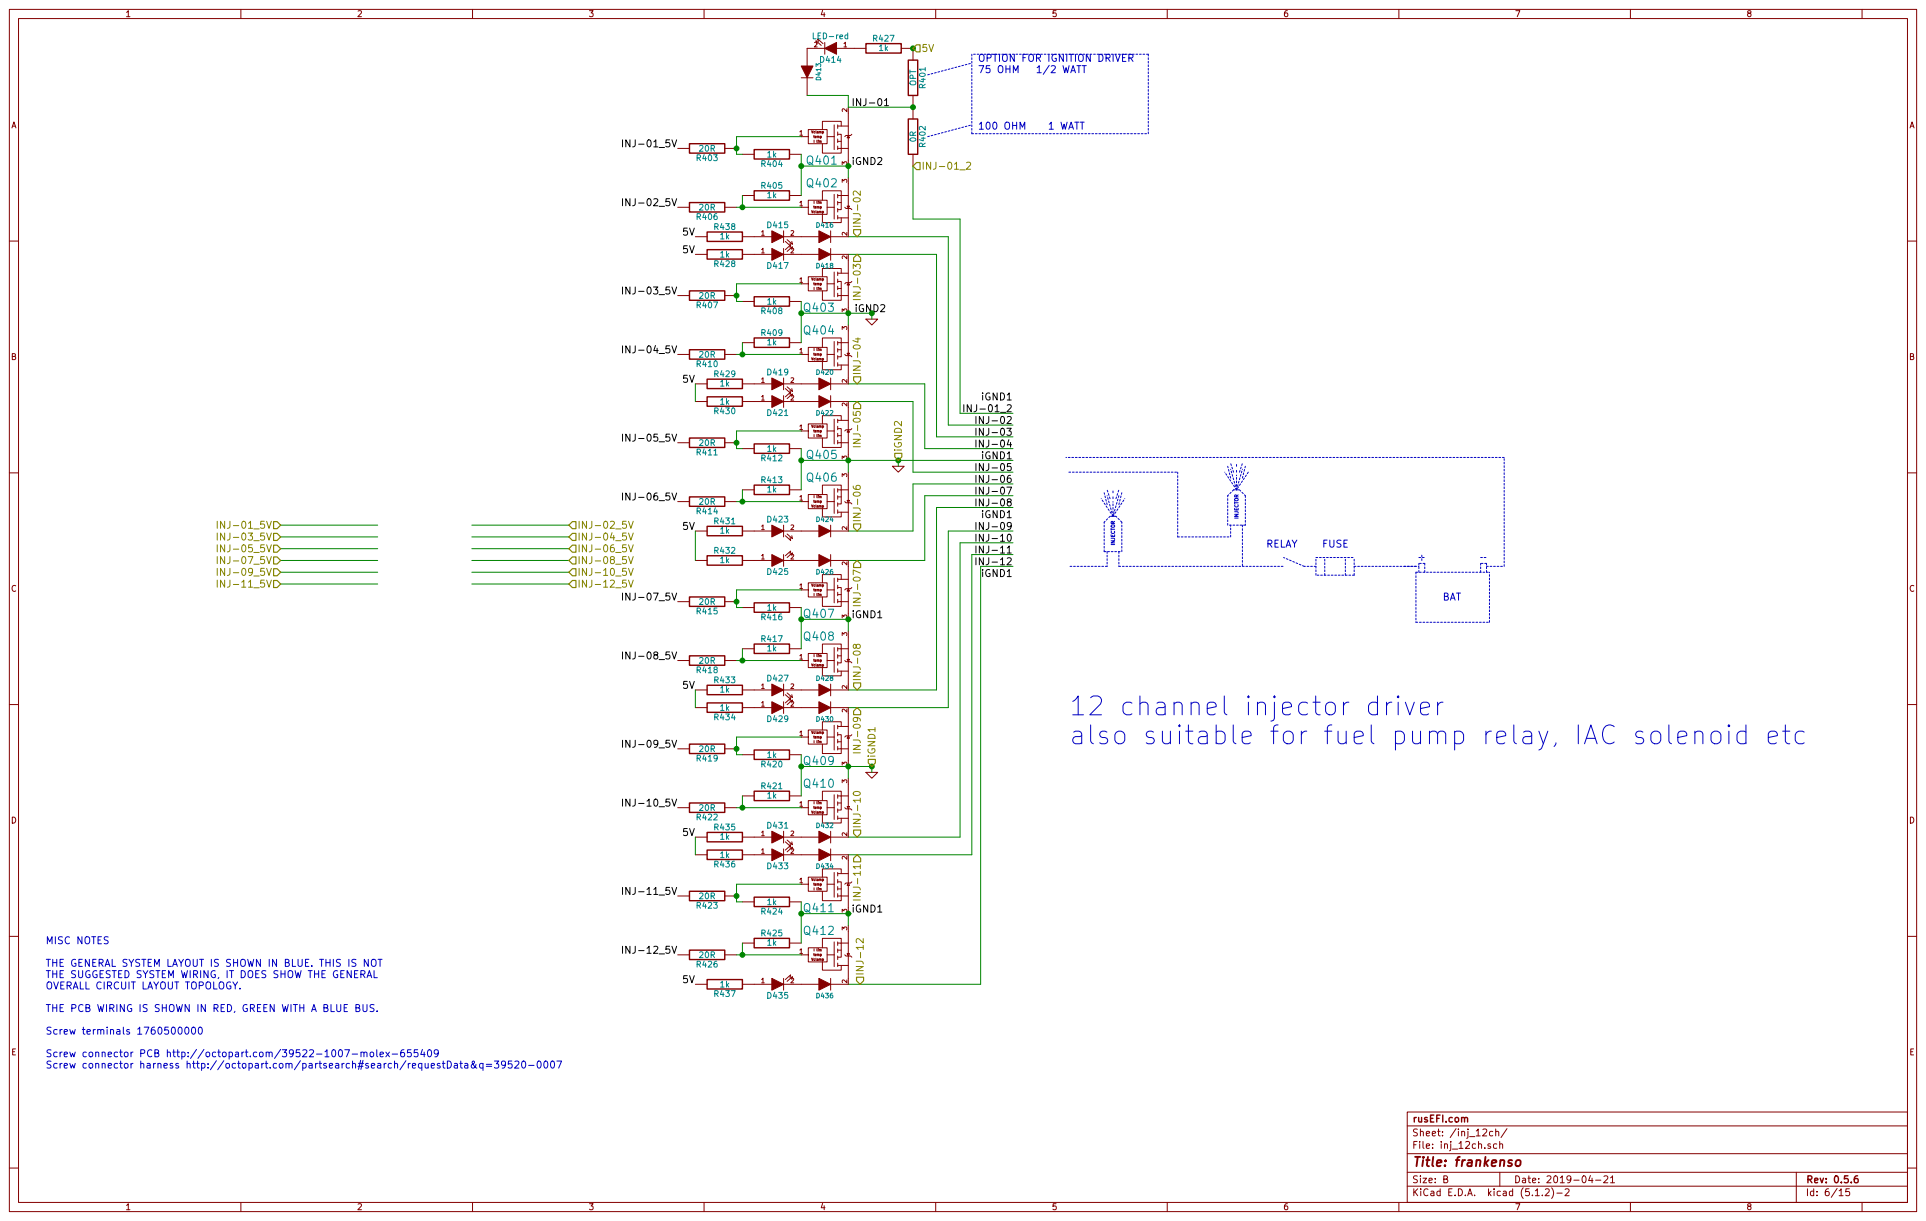
[picture p107: page 6]

OPTION FOR IGNITION DRIVER
75 OHM 1/2 WATT

THE GENERAL SYSTEM LAYOUT IS SHOWN IN BLUE. THIS IS NOT
THE SUGGESTED SYSTEM WIRING, IT DOES SHOW THE GENERAL
OVERALL CIRCUIT LAYOUT TOPOLOGY.

THE PCB WIRING IS SHOWN IN RED, GREEN WITH A BLUE BUS.

Screw connector PCB http://octopart.com/39522-1007-molex-655409
Screw connector harness http://octopart.com/partsearch#search/requestData&q=39520-0007

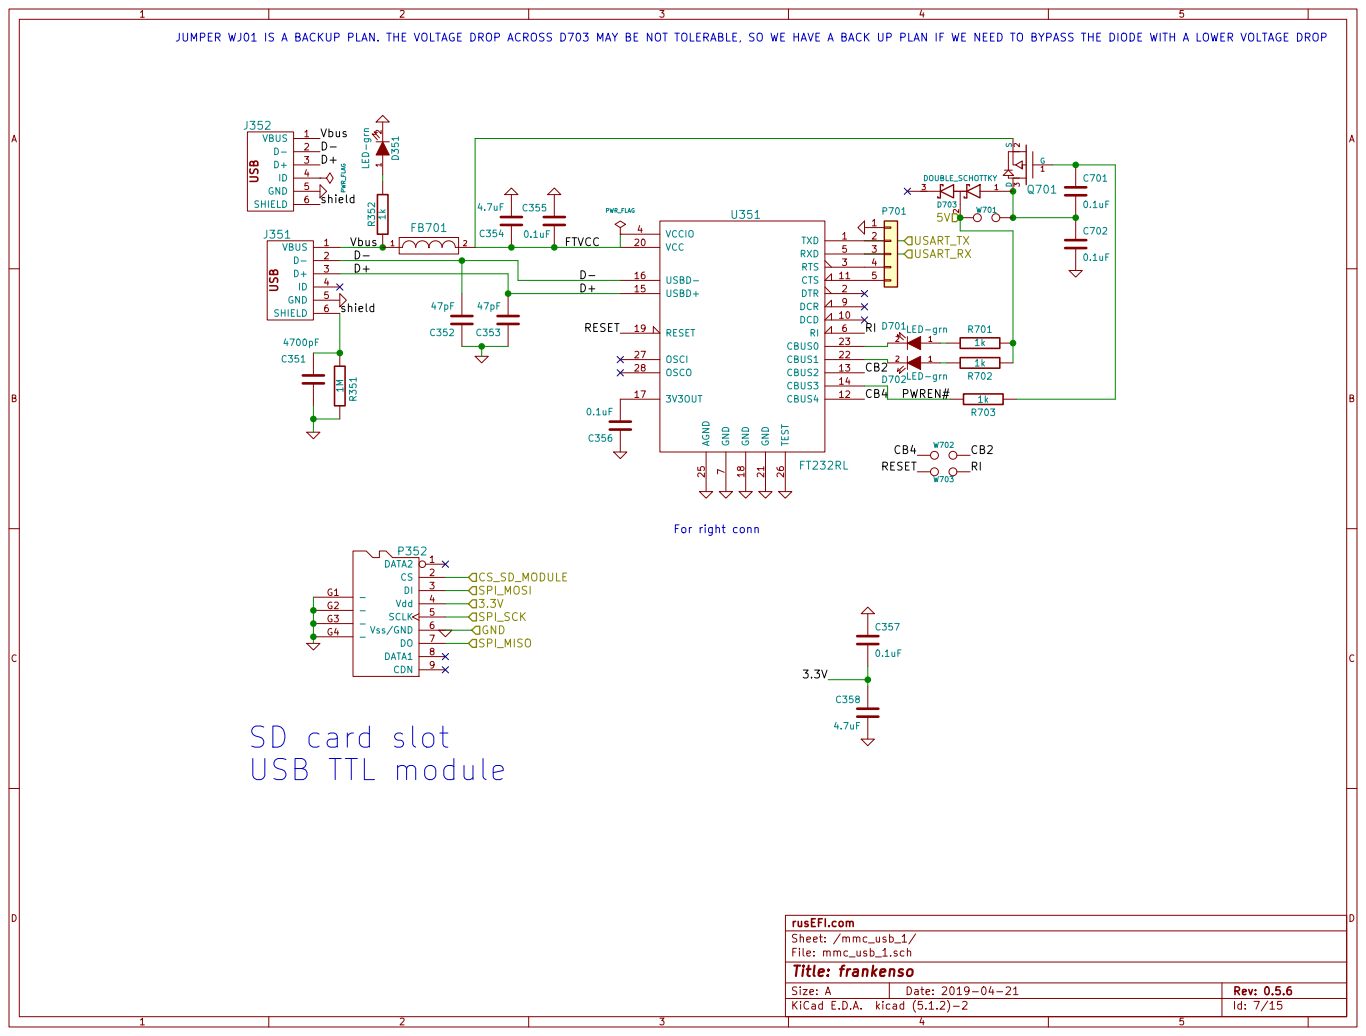
[picture p108: page 7]

7 DCR 9 DCD 10 VCC 20 CTS 11 GND 21 CBUS4 12 CBUS1 22 CBUS2 13 CBUS0 23 CBUS3 14 USBD+ 15 AGND 25 USBD- 16 TEST 26

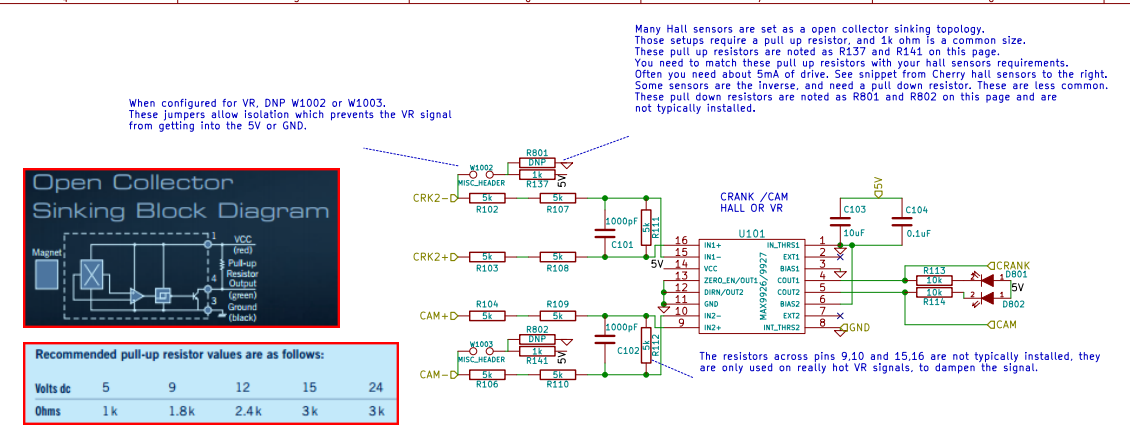
[picture p109: page 8]

Many Hall sensors are set as a open collector sinking topology.
Those setups require a pull up resistor, and 1k ohm is a common size.
These pull up resistors are noted as R137 and R141 on this page.
You need to match these pull up resistors with your hall sensors requirements.
Often you need about 5mA of drive. See snippet from Cherry hall sensors to the right.
Some sensors are the inverse, and need a pull down resistor. These are less common.
These pull down resistors are noted as R801 and R802 on this page and are
not typically installed.

These jumpers allow isolation which prevents the VR signal
from getting into the 5V or GND.

are only used on really hot VR signals, to dampen the signal. R107

The resistors across pins 9,10 and 15,16 are not typically installed, they

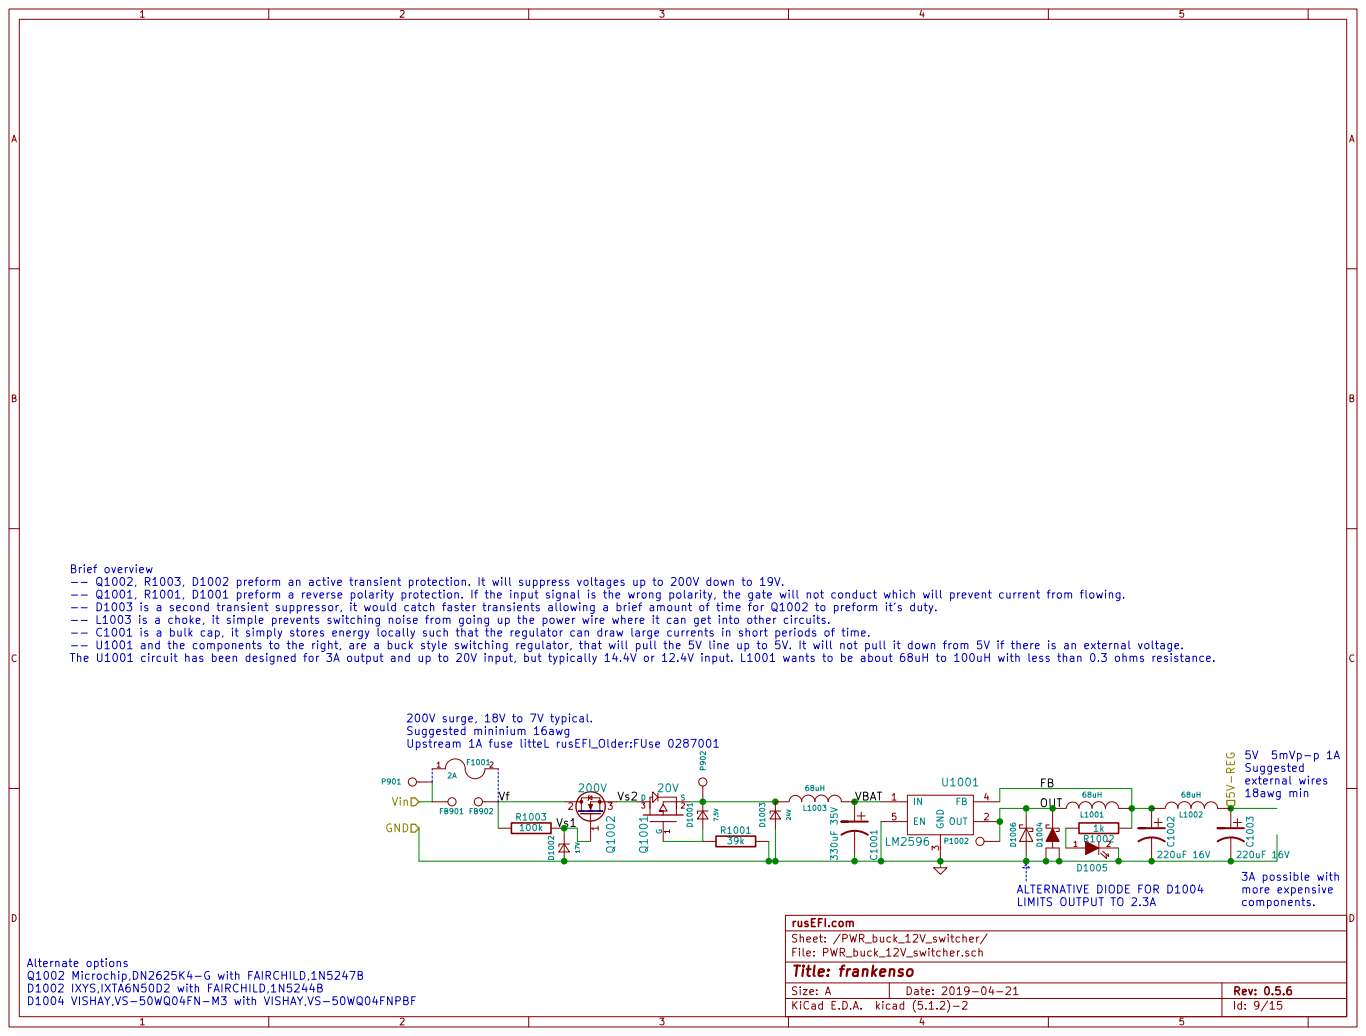
[picture p110: page 9]

-- Q1002, R1003, D1002 preform an active transient protection. It will suppress voltages up to 200V down to 19V.
-- Q1001, R1001, D1001 preform a reverse polarity protection. If the input signal is the wrong polarity, the gate will not conduct which will prevent current from flowing.
-- D1003 is a second transient suppressor, it would catch faster transients allowing a brief amount of time for Q1002 to preform it's duty.
-- L1003 is a choke, it simple prevents switching noise from going up the power wire where it can get into other circuits.
-- C1001 is a bulk cap, it simply stores energy locally such that the regulator can draw large currents in short periods of time.
-- U1001 and the components to the right, are a buck style switching regulator, that will pull the 5V line up to 5V. It will not pull it down from 5V if there is an external voltage.
The U1001 circuit has been designed for 3A output and up to 20V input, but typically 14.4V or 12.4V input. L1001 wants to be about 68uH to 100uH with less than 0.3 ohms resistance.

200V surge, 18V to 7V typical.
Suggested mininium 16awg
Upstream 1A fuse litteL rusEFI_Older:FUse 0287001

5V 5mVp-p 1A
Suggested external wires 18awg min

Alternate options
Q1002 Microchip,DN2625K4-G with FAIRCHILD,1N5247B
D1002 IXYS,IXTA6N50D2 with FAIRCHILD,1N5244B
D1004 VISHAY,VS-50WQ04FN-M3 with VISHAY,VS-50WQ04FNPBF

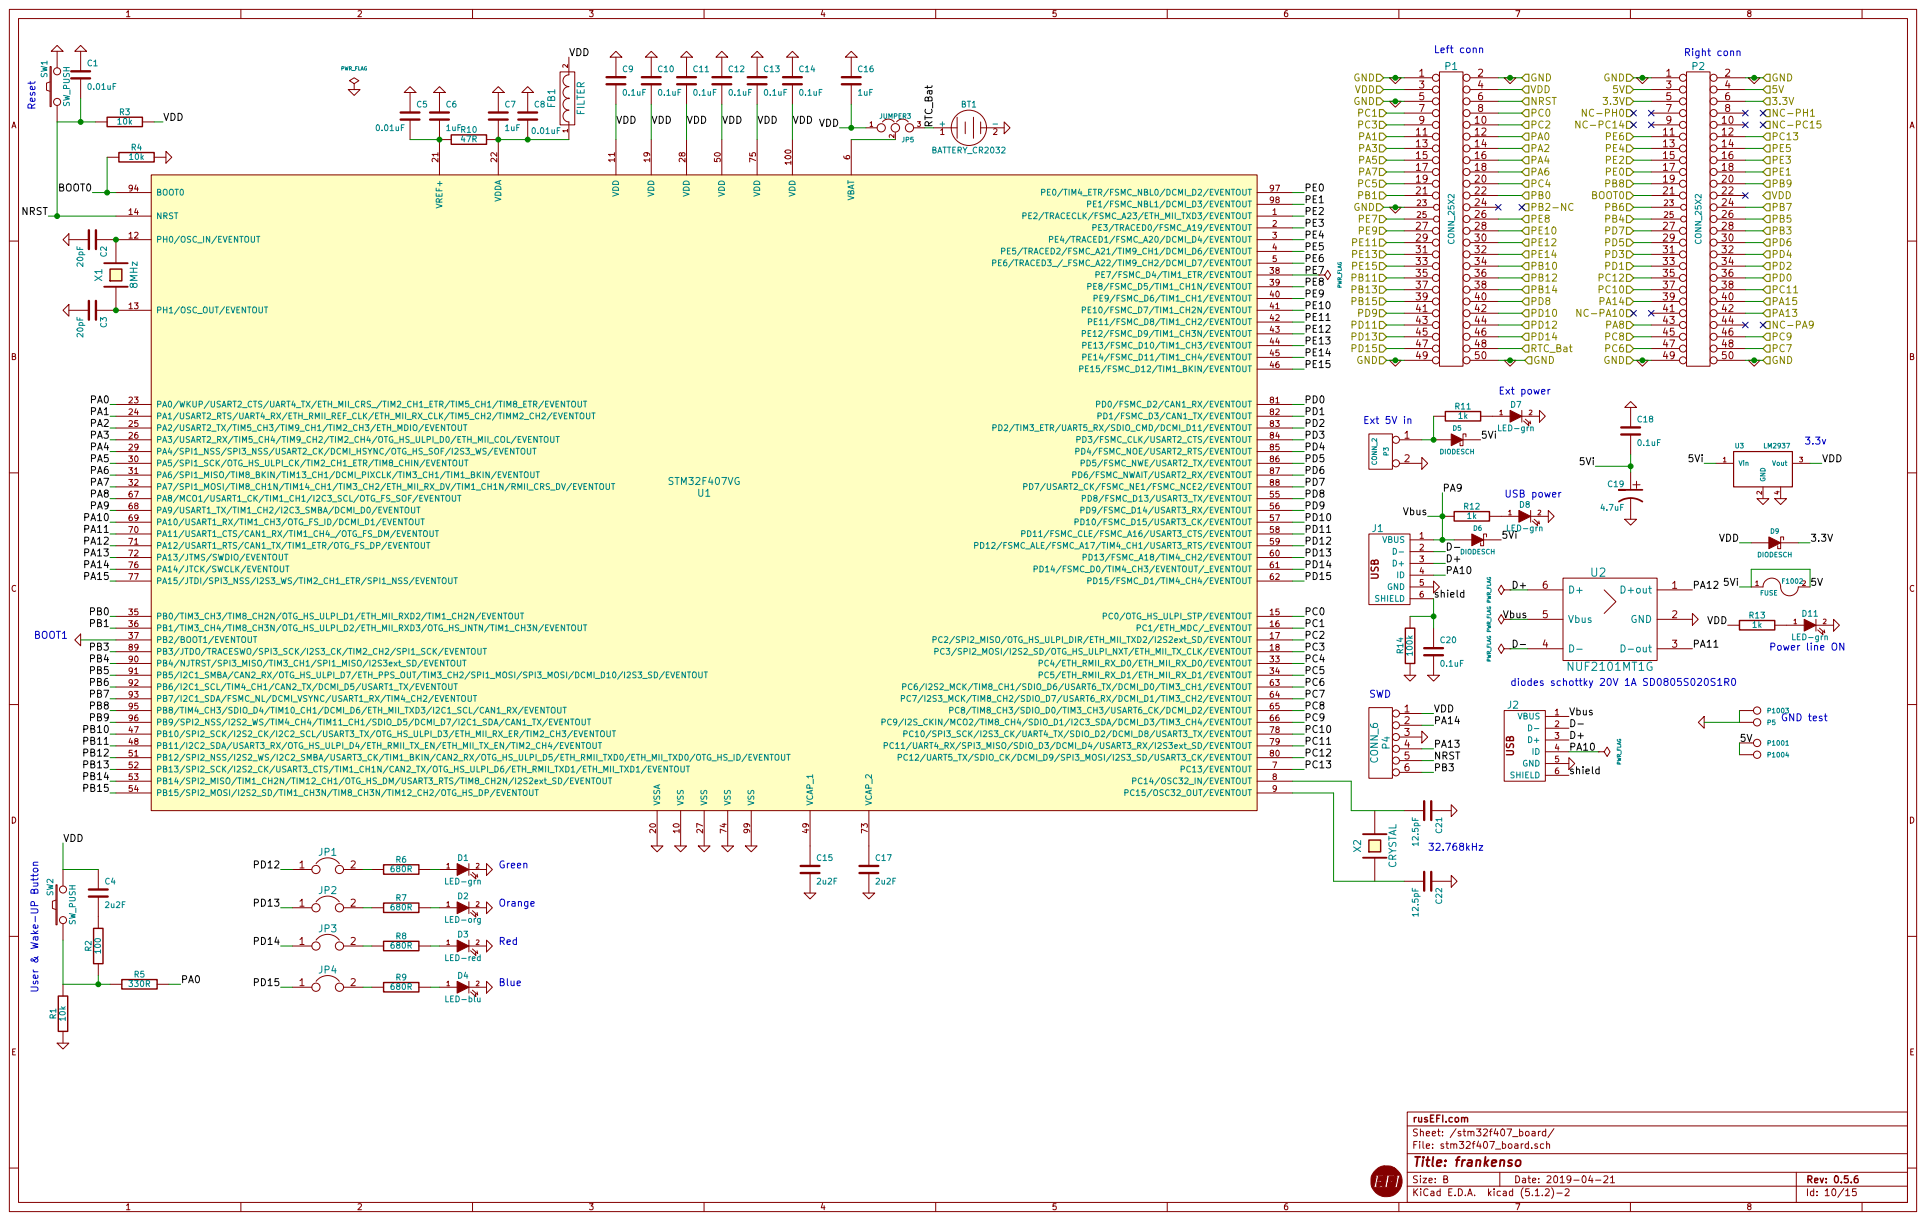
[picture p111: page 10]

6 PC13/EVENTOUT 7 PC14/OSC32_IN/EVENTOUT 8 PC15/OSC32_OUT/EVENTOUT 9 VSS 10 VSSA 20

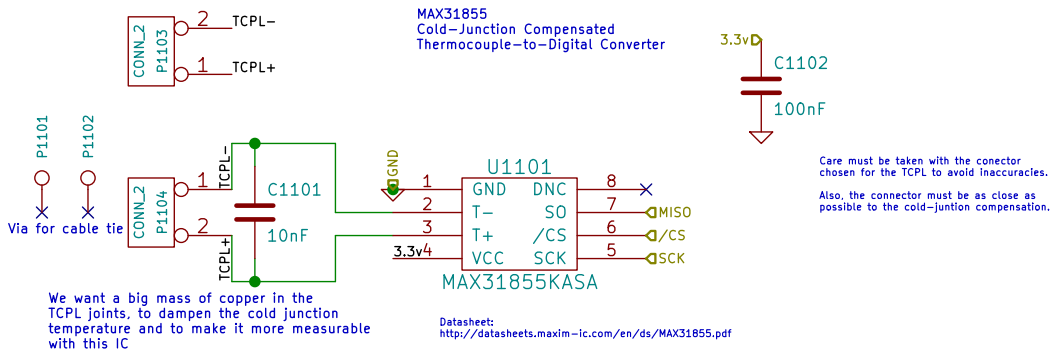
[picture p112: page 11]

We want a big mass of copper in the TCPL joints, to dampen the cold junction

temperature and to make it more measurable with this IC

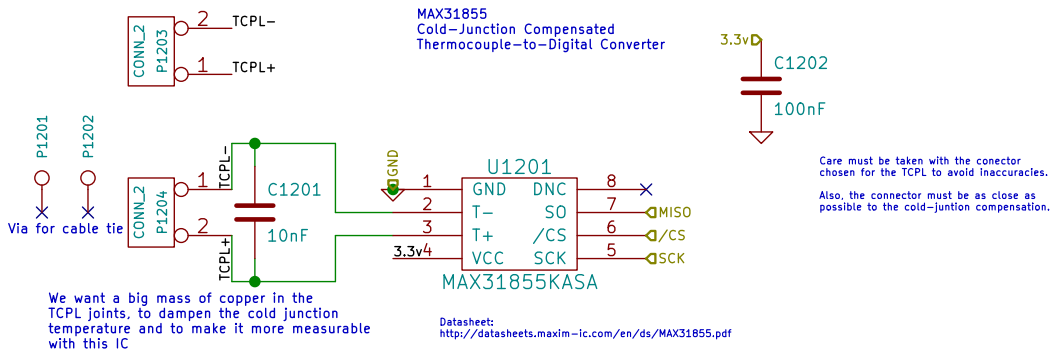
[picture p113: page 12]

We want a big mass of copper in the TCPL joints, to dampen the cold junction

temperature and to make it more measurable with this IC

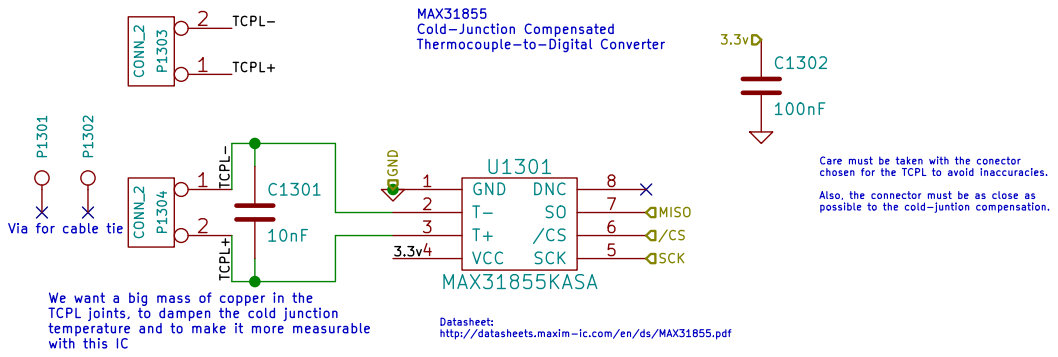
[picture p114: page 13]

We want a big mass of copper in the TCPL joints, to dampen the cold junction

temperature and to make it more measurable with this IC

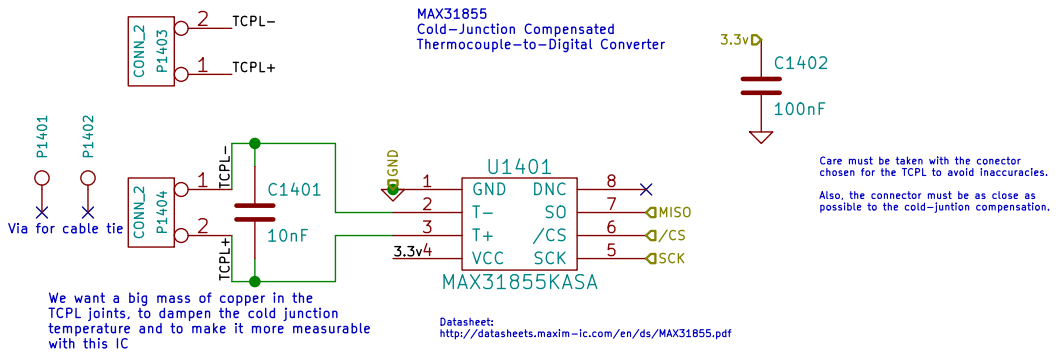
[picture p115: page 14]

We want a big mass of copper in the TCPL joints, to dampen the cold junction

temperature and to make it more measurable with this IC

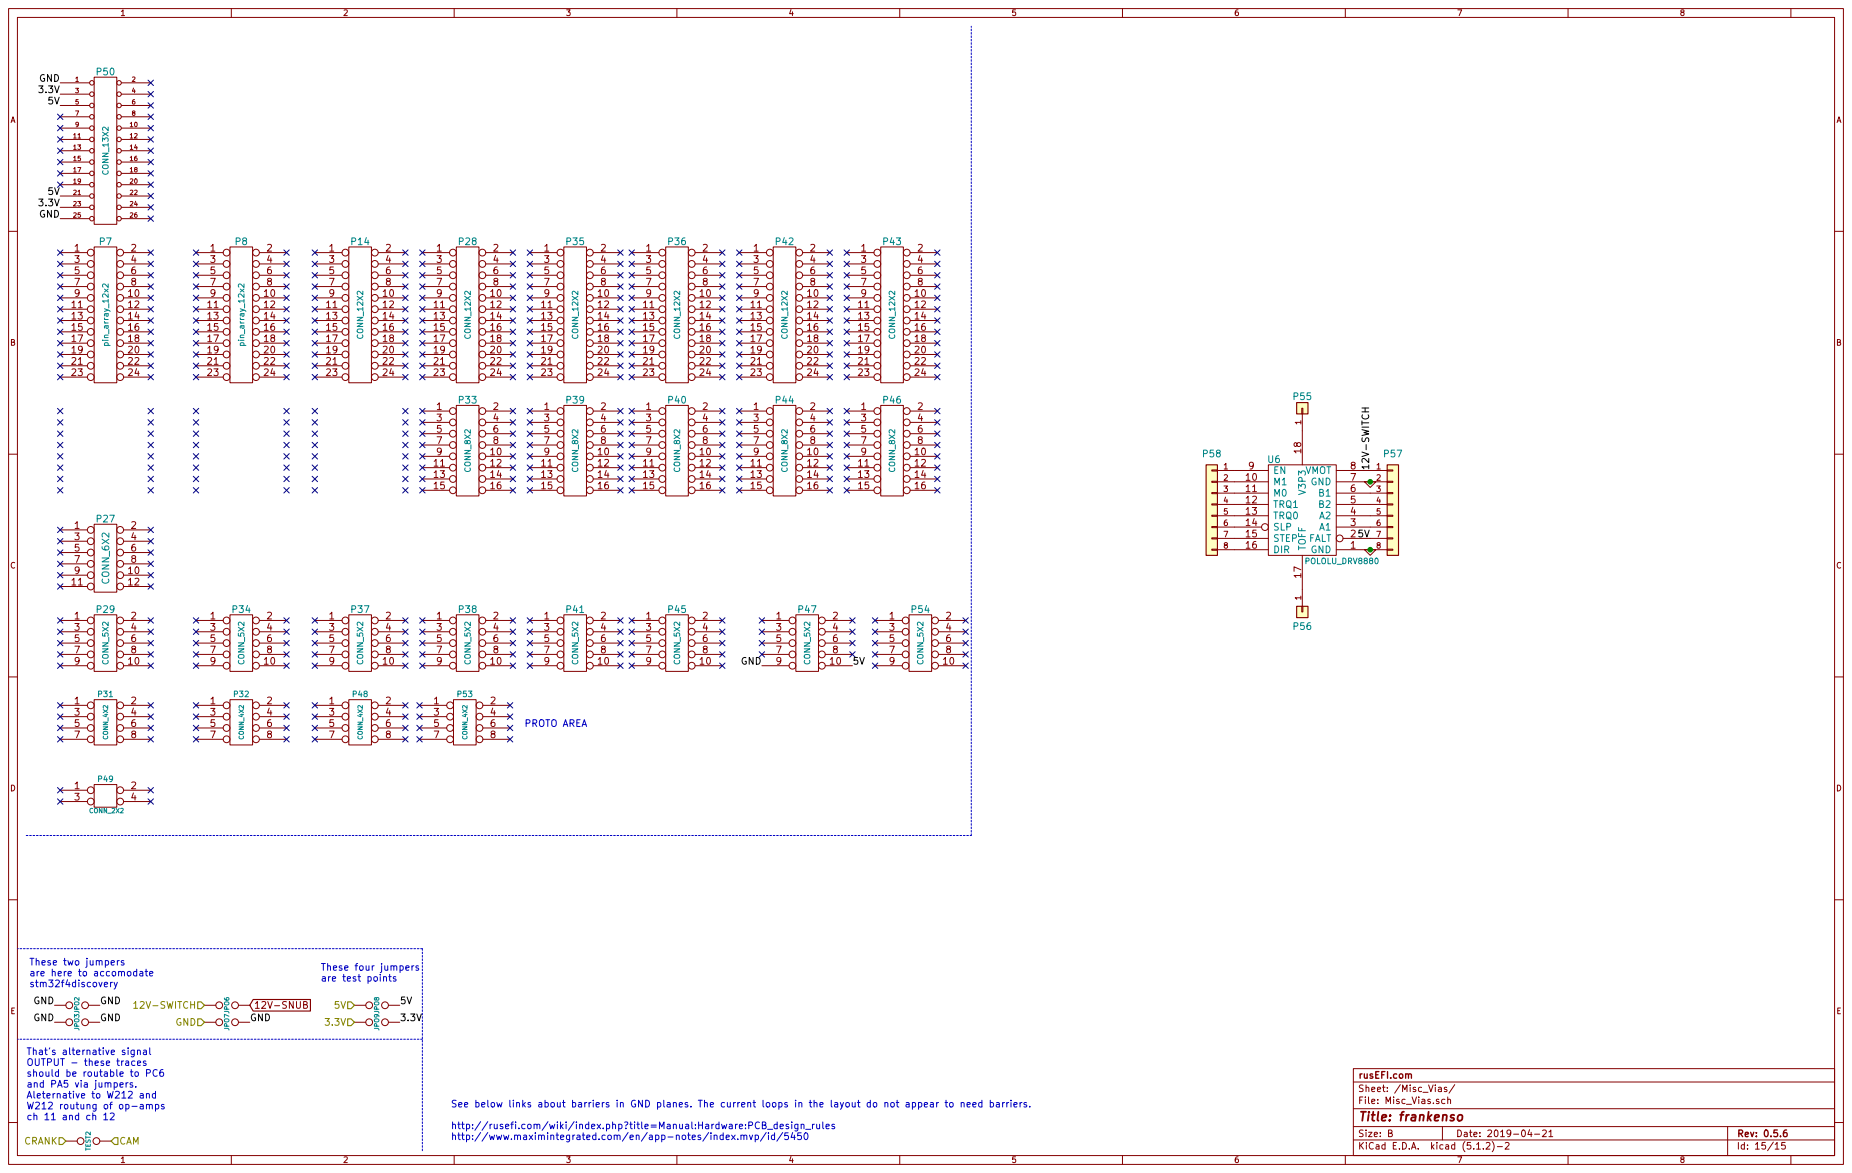
[picture p116: page 15]

6 7 | 6

That's alternative signal
OUTPUT - these traces
should be routable to PC6
and PA5 via jumpers. Aleternative to W212 and W212 routung of op-amps ch 11 and ch 12

See below links about barriers in GND planes. The current loops in the layout do not appear to need barriers.

http://rusefi.com/wiki/index.php?title=Manual:Hardware:PCB_design_rules
http://www.maximintegrated.com/en/app-notes/index.mvp/id/5450
