rusefi/rusefi-hardware/breakout-boards/Ferrari-Maserati-121-adapter-rev-a.pdf

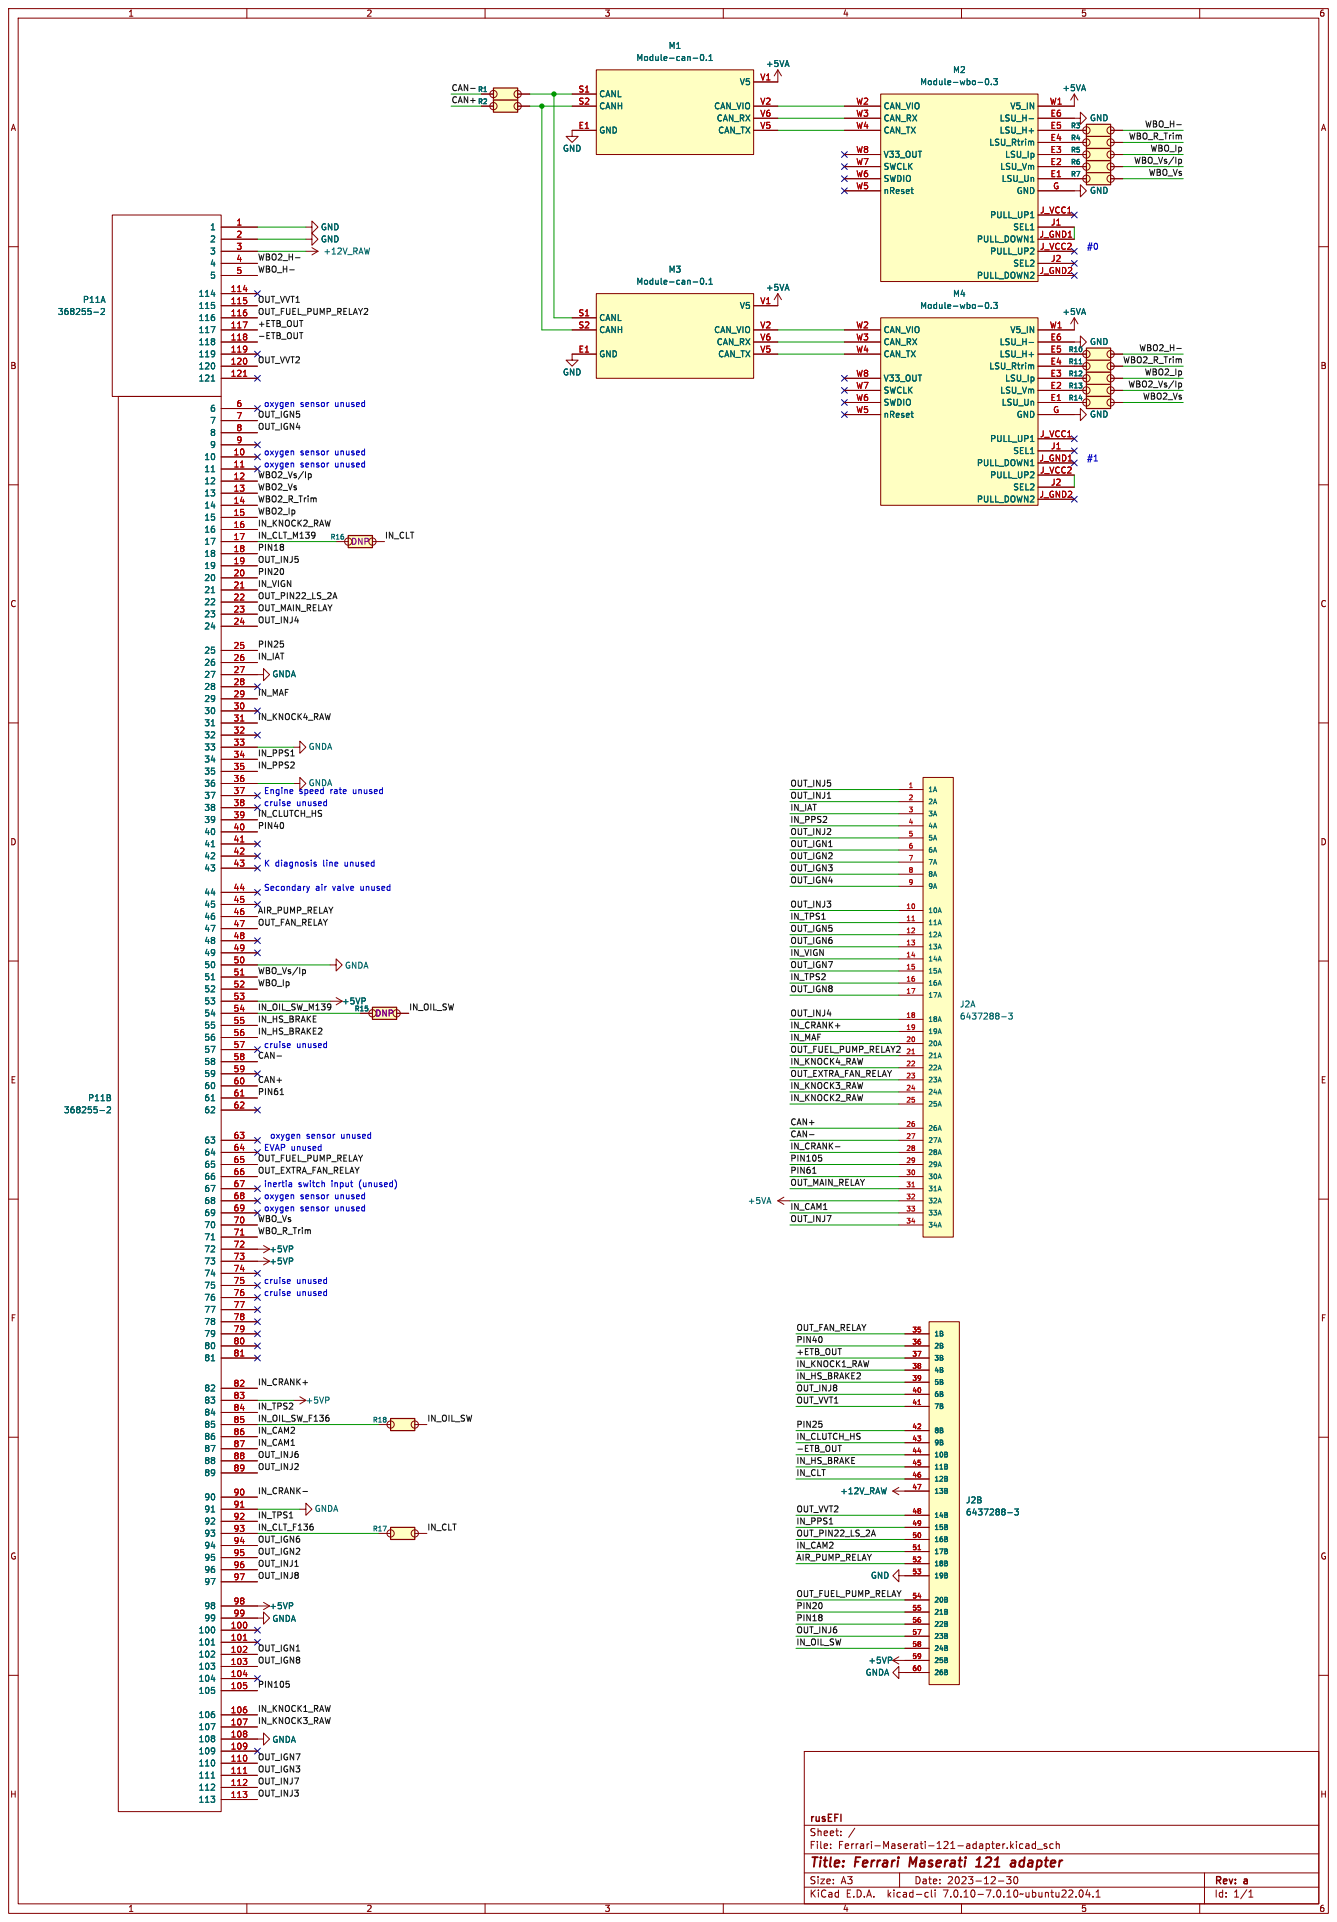
[picture p117: page 1]

oxygen sensor unused
IN_CRANK- OUT_INJ7 WBO_R_Trim WBO_Vs
inertia switch input (unused) EVAP unused
OUT_EXTRA_FAN_RELAY OUT_FUEL_PUMP_RELAY

Id: 1/1 Title: Ferrari Maserati 121 adapter File: Ferrari-Maserati-121-adapter.kicad_sch Sheet: / rusEFI
