rusefi/rusefi-hardware/breakout-boards/mitsubishi-lancer-evo-x-rev-a.pdf

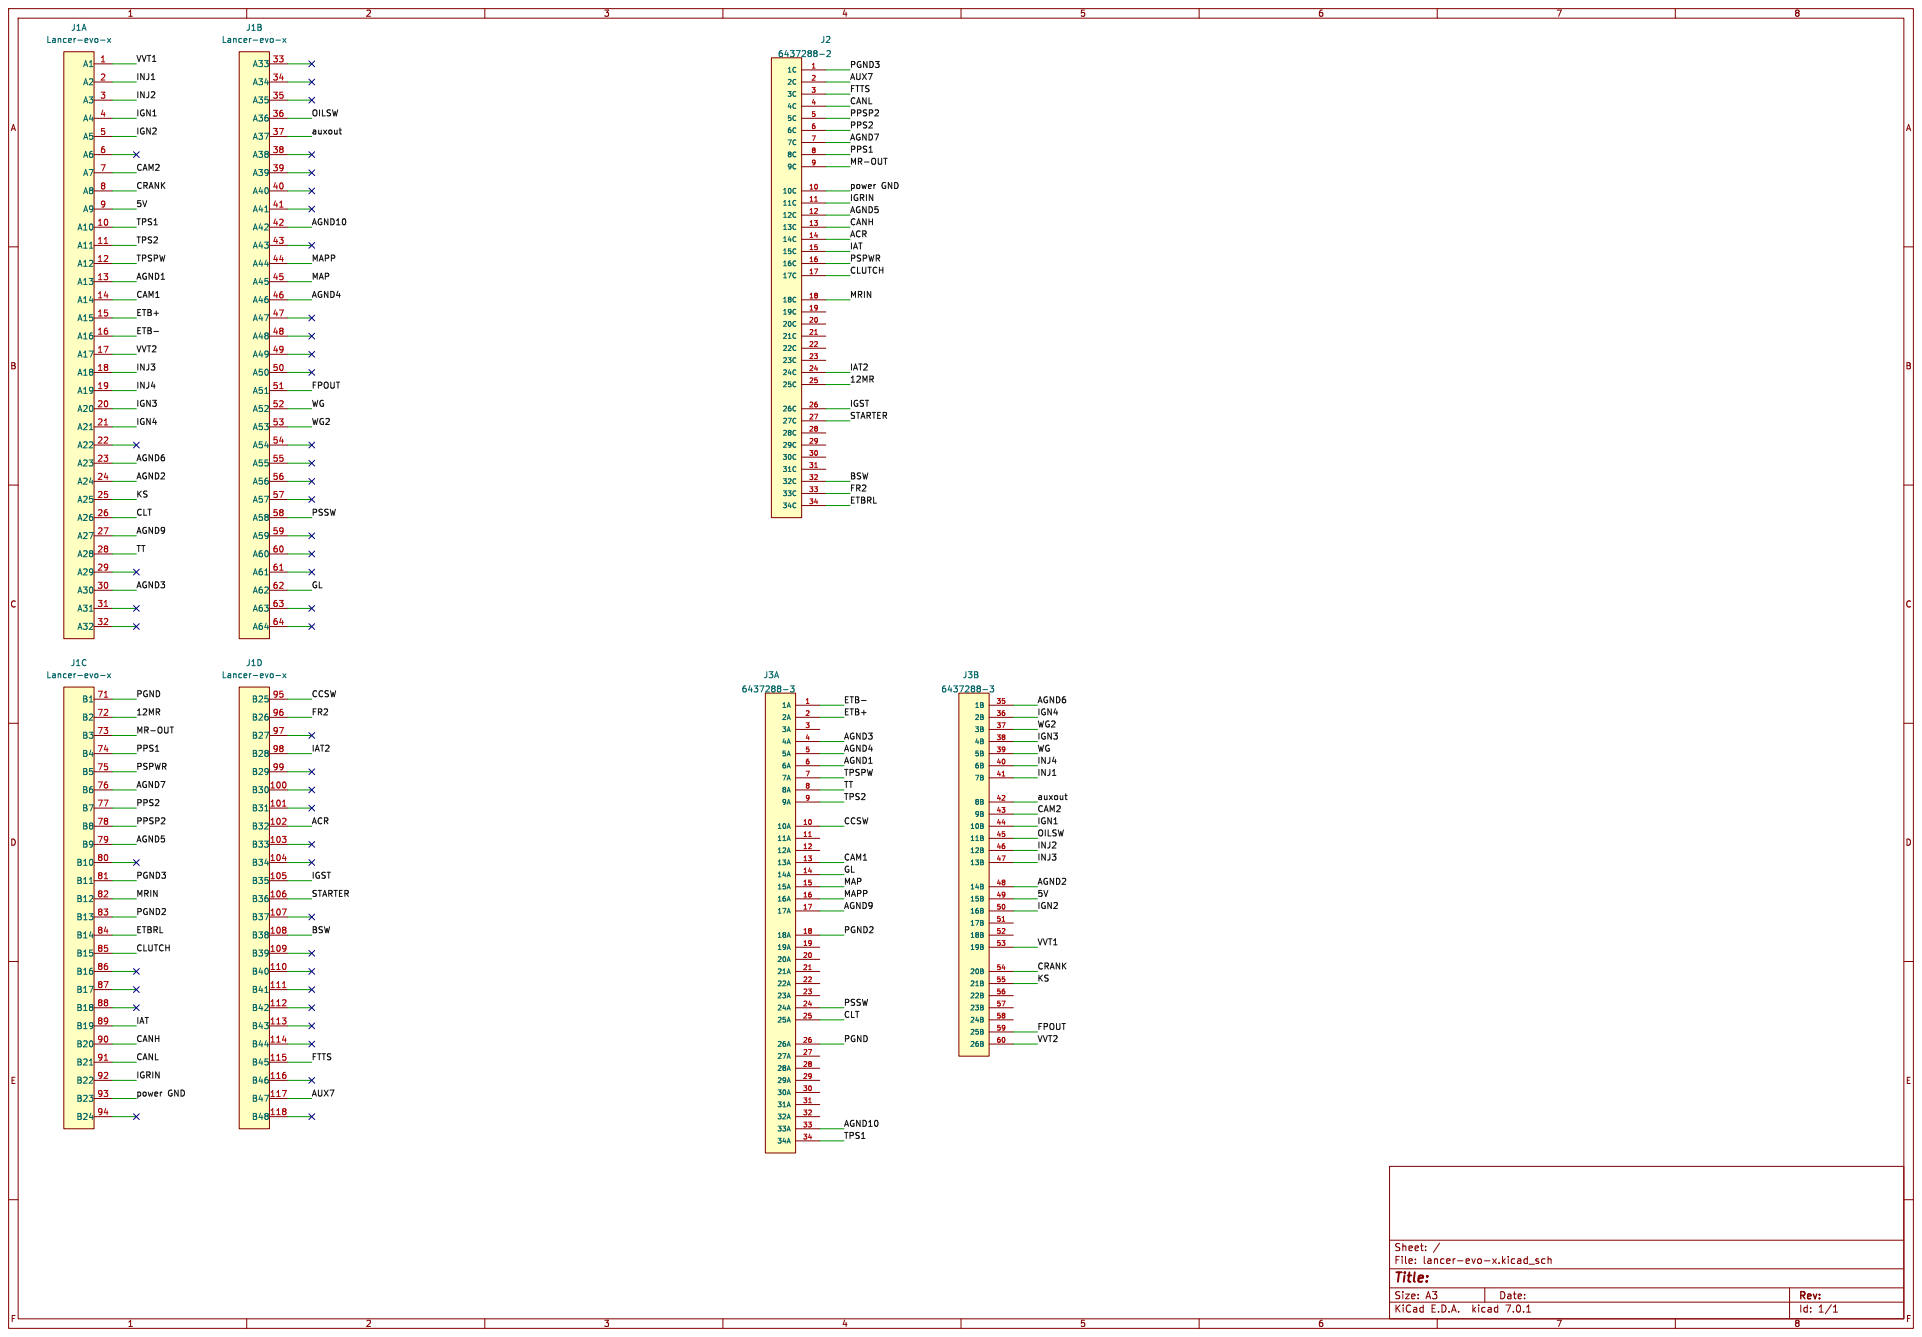
[picture p118: page 1]

power GND MR-OUT AGND5

Id: 1/1 Title: File: lancer-evo-x.kicad_sch Sheet: /
