rusefi/rusefi-hardware/breakout-boards/mitsubishi-mirage-adapter-0.3.pdf

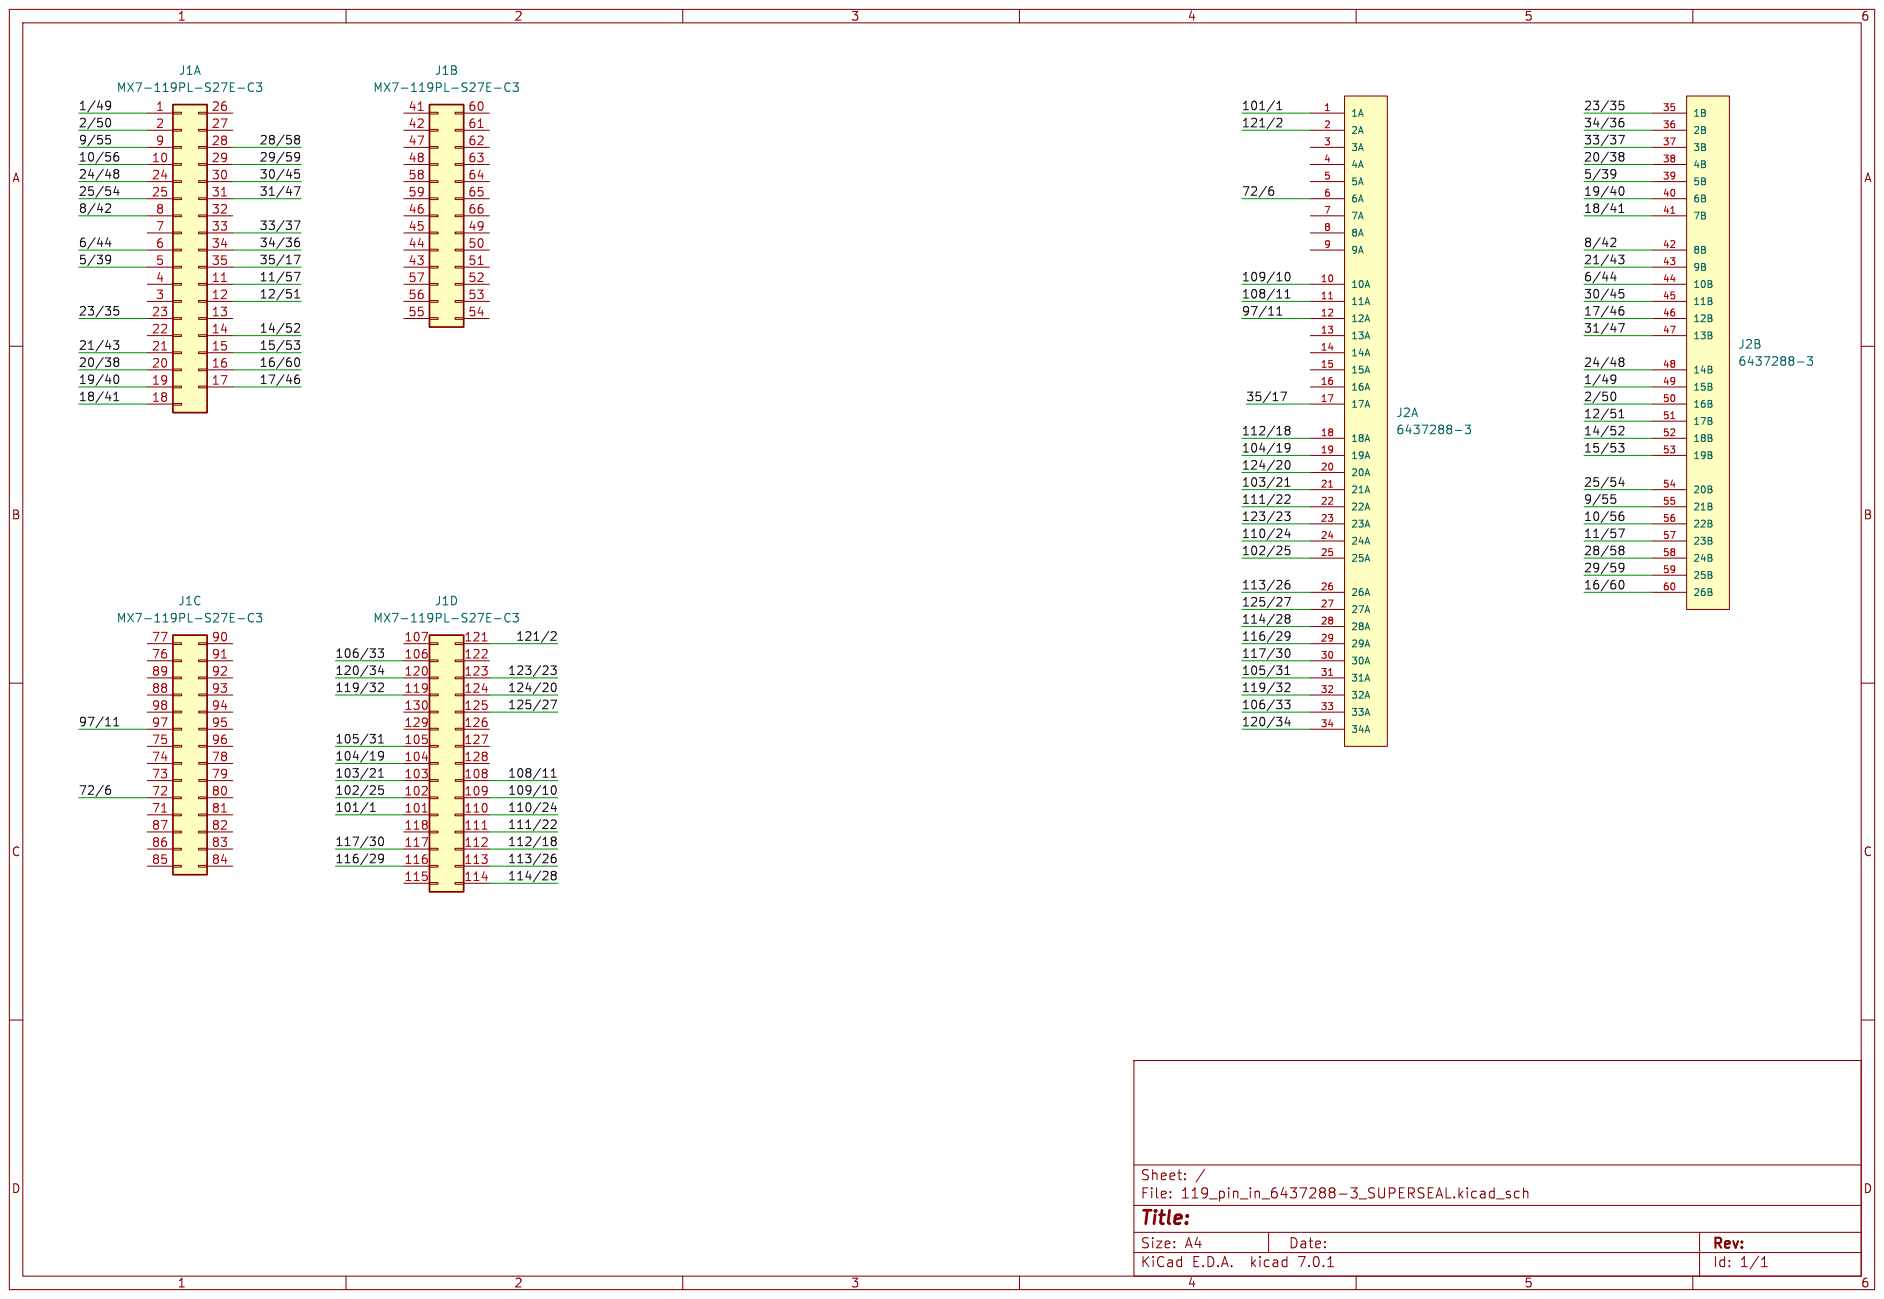
[picture p119: page 1]

Id: 1/1 Title: File: 119_pin_in_6437288-3_SUPERSEAL.kicad_sch Sheet: /
