rusefi/rusefi-hardware/breakout-boards/Breakout-mazda-nc-0.1.pdf

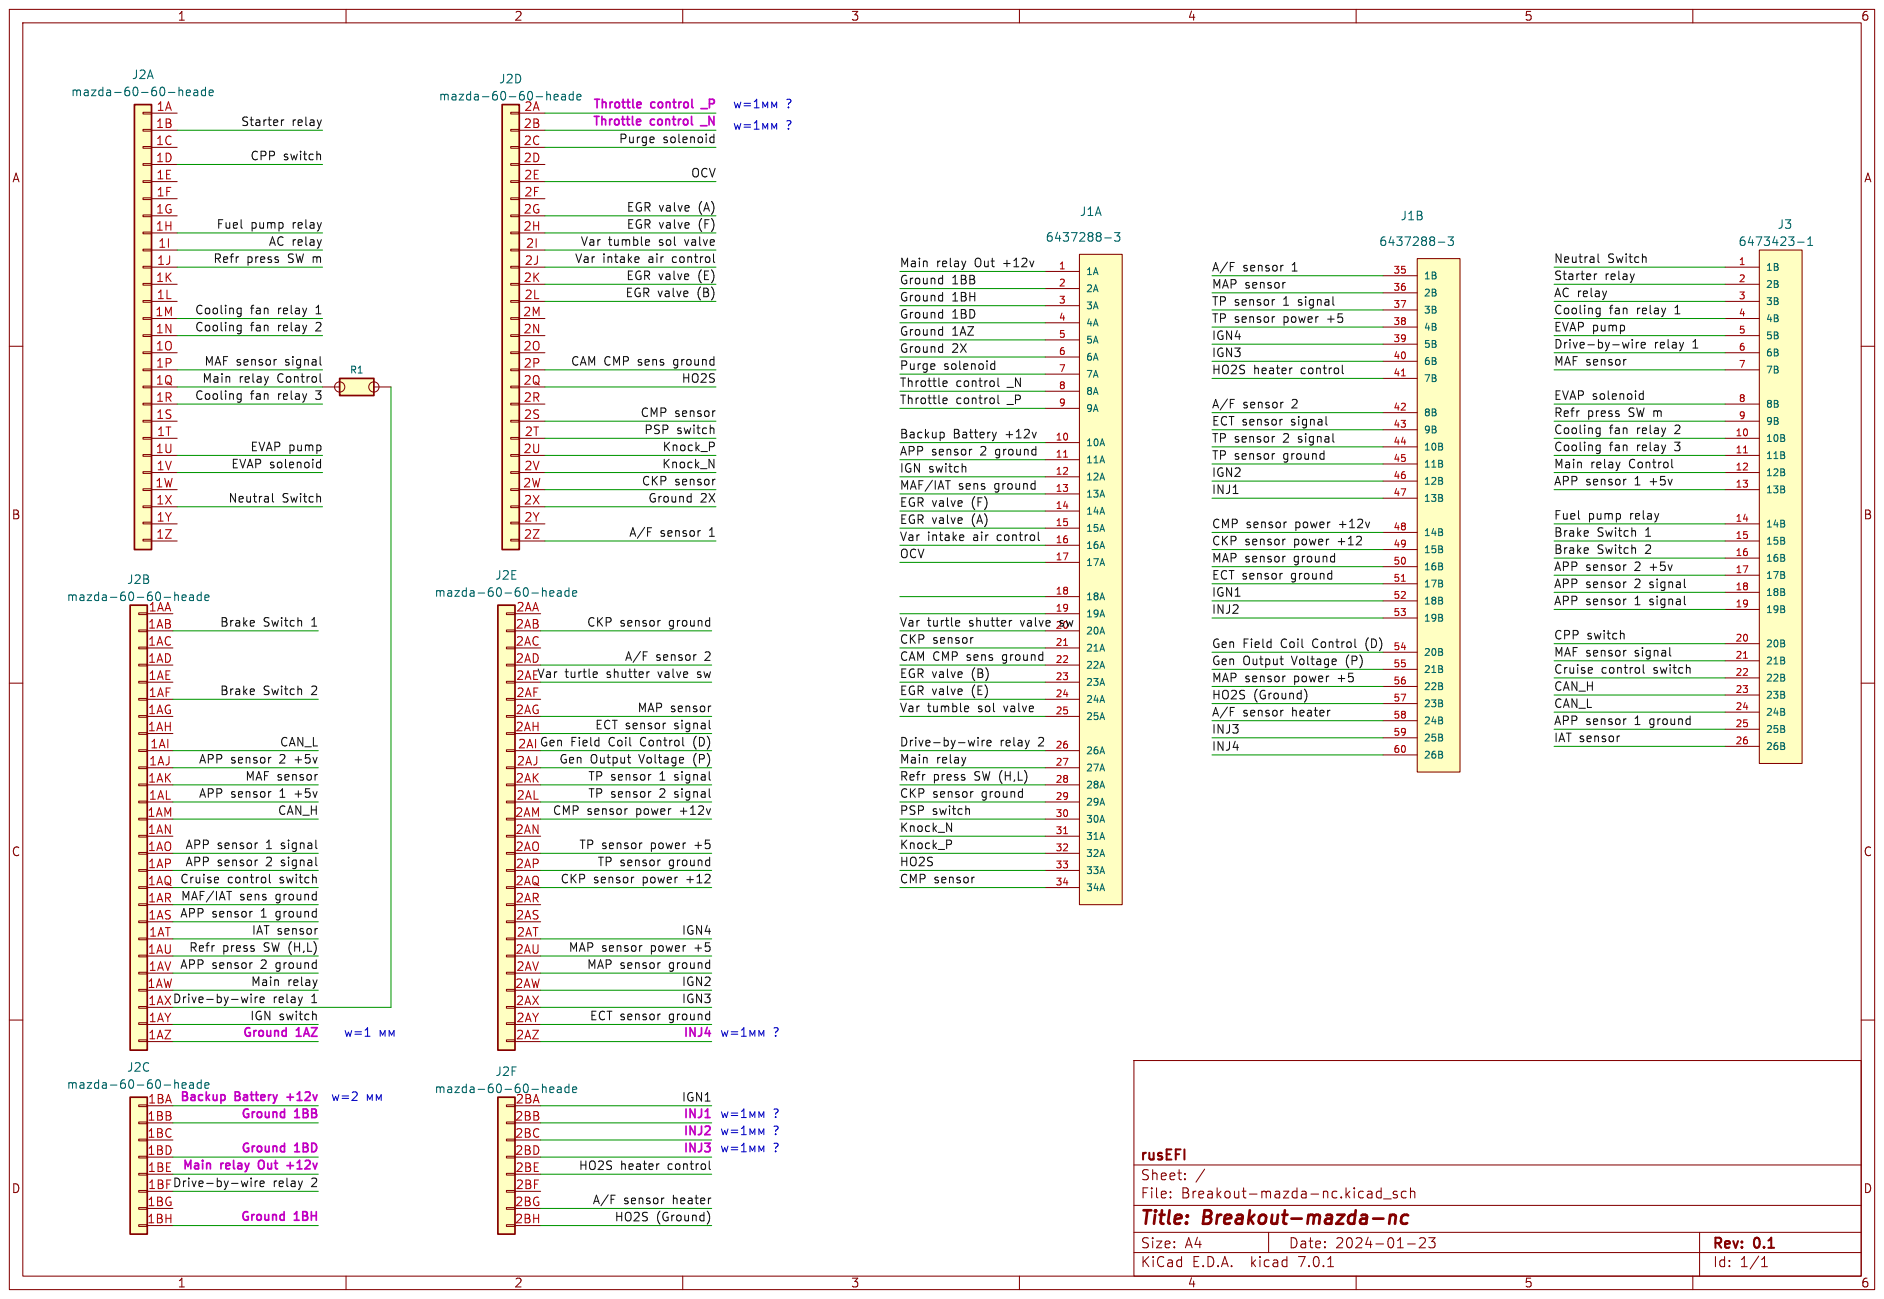
[picture p120: page 1]

CAM CMP sens ground EGR valve (F) Throttle control _N

AC relay
Neutral Switch Main relay

Cooling fan relay 1 AC relay

APP sensor 1 signal Main relay Control Cooling fan relay 3 Cooling fan relay 2 Fuel pump relay

Id: 1/1 Title: Breakout-mazda-nc
