rusefi/rusefi-hardware/hellen-208/208.PDF

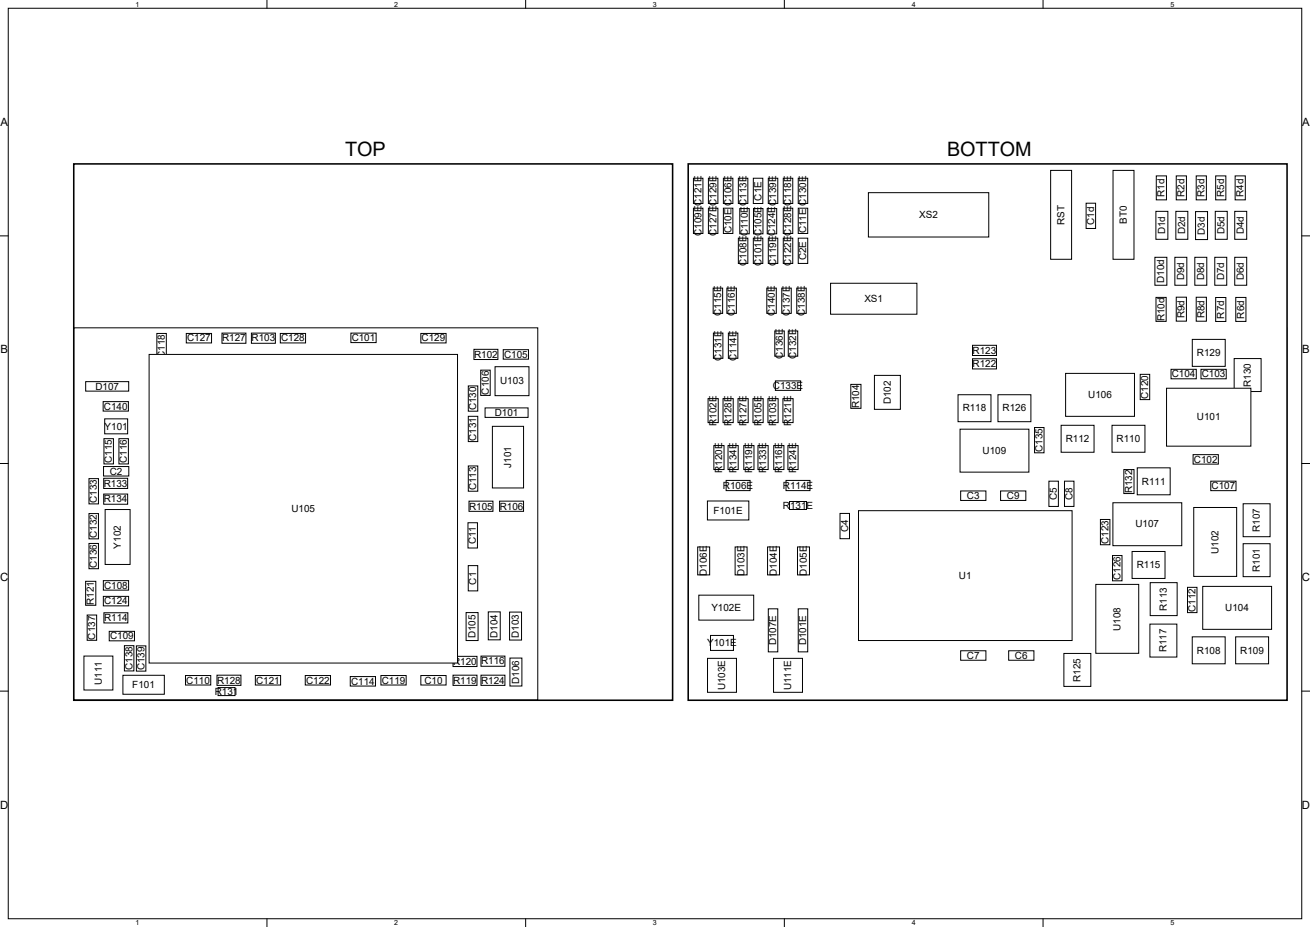
[picture p121: page 1]

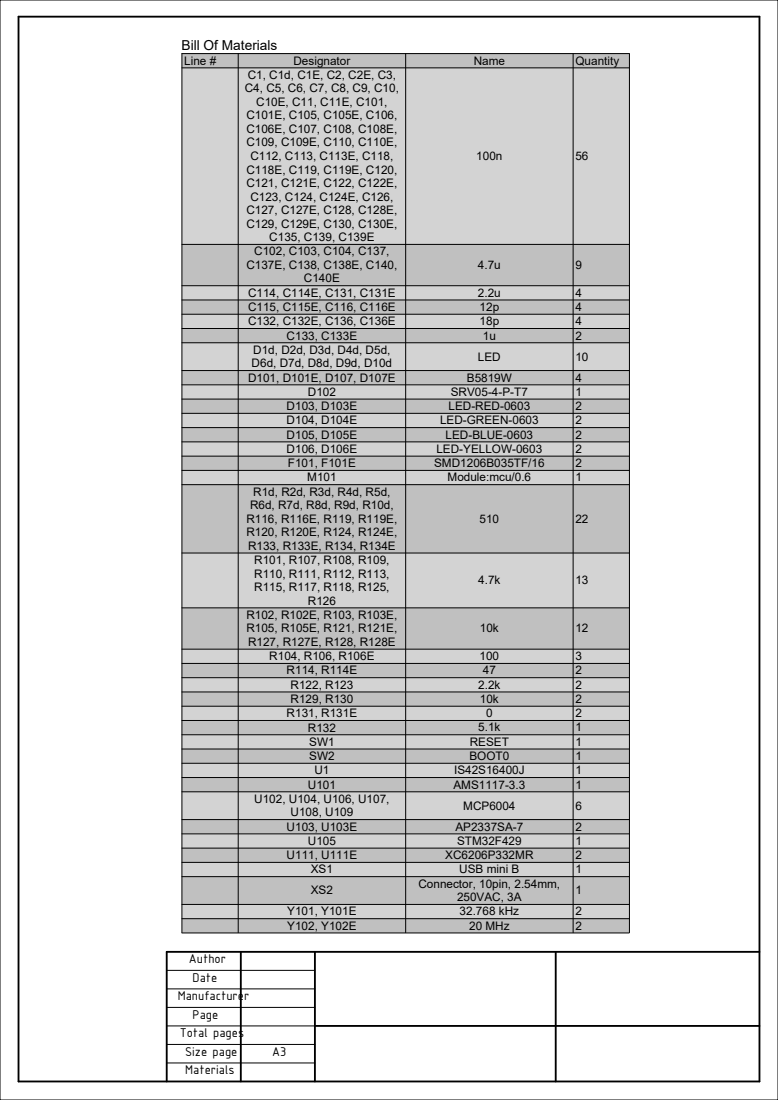
[picture p122: page 2]

Line # | Designator | Name | Quantity

C114, C114E, C131, C131E | 2.2u | 4
C115, C115E, C116, C116E | 12p | 4
C132, C132E, C136, C136E | 18p | 4
C133, C133E | 1u | 2
D1d, D2d, D3d, D4d, D5d, D6d, D7d, D8d, D9d, D10d | LED | 10

D102 | SRV05-4-P-T7 | 1
D103, D103E | LED-RED-0603 | 2
D104, D104E | LED-GREEN-0603 | 2
D105, D105E | LED-BLUE-0603 | 2
D106, D106E | LED-YELLOW-0603 | 2
F101, F101E | SMD1206B035TF/16 | 2
M101 | Module:mcu/0.6 | 1

R104, R106, R106E | 100 | 3
R114, R114E | 47 | 2
R122, R123 | 2.2k | 2
R129, R130 | 10k | 2
R131, R131E | 0 | 2
R132 | 5.1k | 1
SW1 | RESET | 1
SW2 | BOOT0 | 1
U1 | IS42S16400J | 1
U101 | AMS1117-3.3 | 1

U102, U104, U106, U107, U108, U109 | MCP6004 | 6

U103, U103E | AP2337SA-7 | 2
U105 | STM32F429 | 1
U111, U111E | XC6206P332MR | 2
XS1 | USB mini B | 1
XS2 | Connector, 10pin, 2.54mm, 250VAC, 3A | 1

Y101, Y101E | 32.768 kHz | 2
Y102, Y102E | 20 MHz | 2

Author
Date
Manufacturer
Page
Total pages
Size page | A3
Materials
