rusefi/rusefi-hardware/superseal-igbt/export/superseal-igbt.pdf

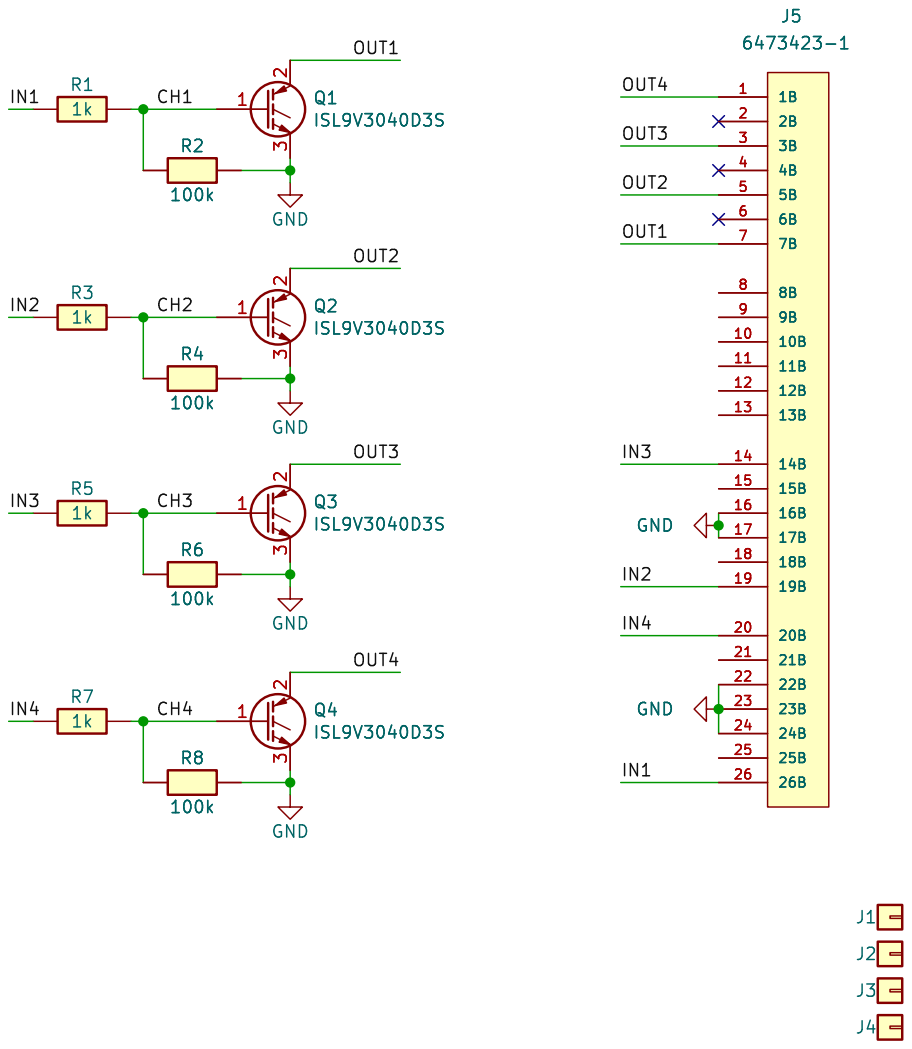
[picture p123: page 1]

Id: 1/1 Title: quad-igbt File: superseal-igbt.kicad_sch Sheet: / rusEFI R8
