rusefi/rusefi-hardware/VR-Hall/production/VR-Hall.pdf

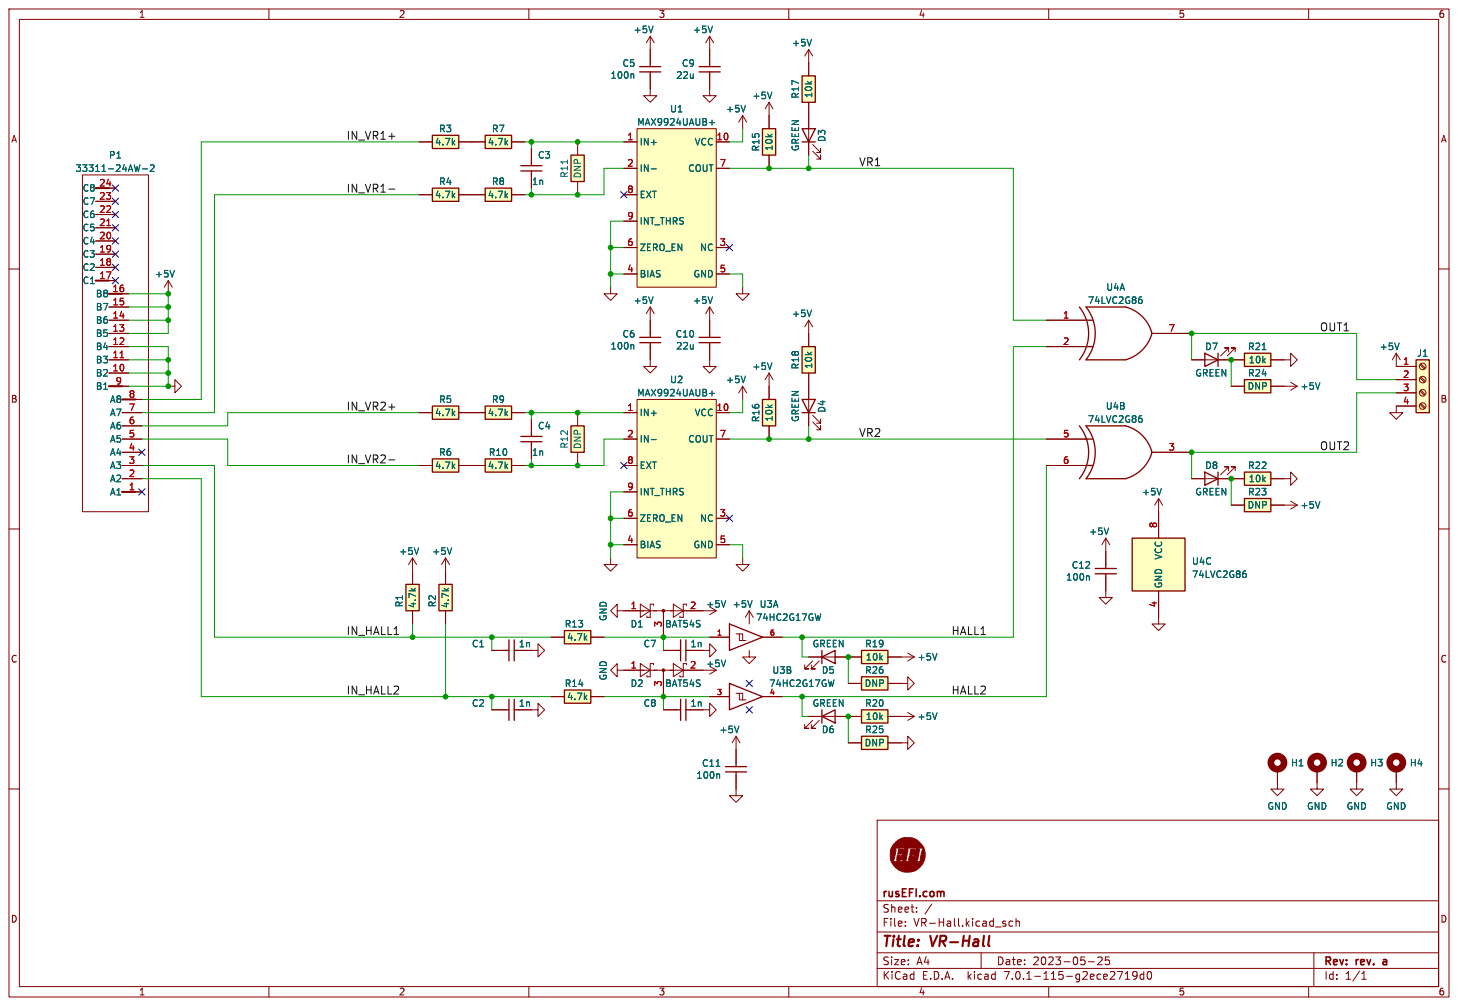
[picture p124: page 1]

Id: 1/1 Title: VR-Hall File: VR-Hall.kicad_sch Sheet: / rusEFI.com
