rusefi/rusefi-hardware/breakout-boards/Breakout-24pin-superseal/export/Breakout-24pin-superseal.pdf

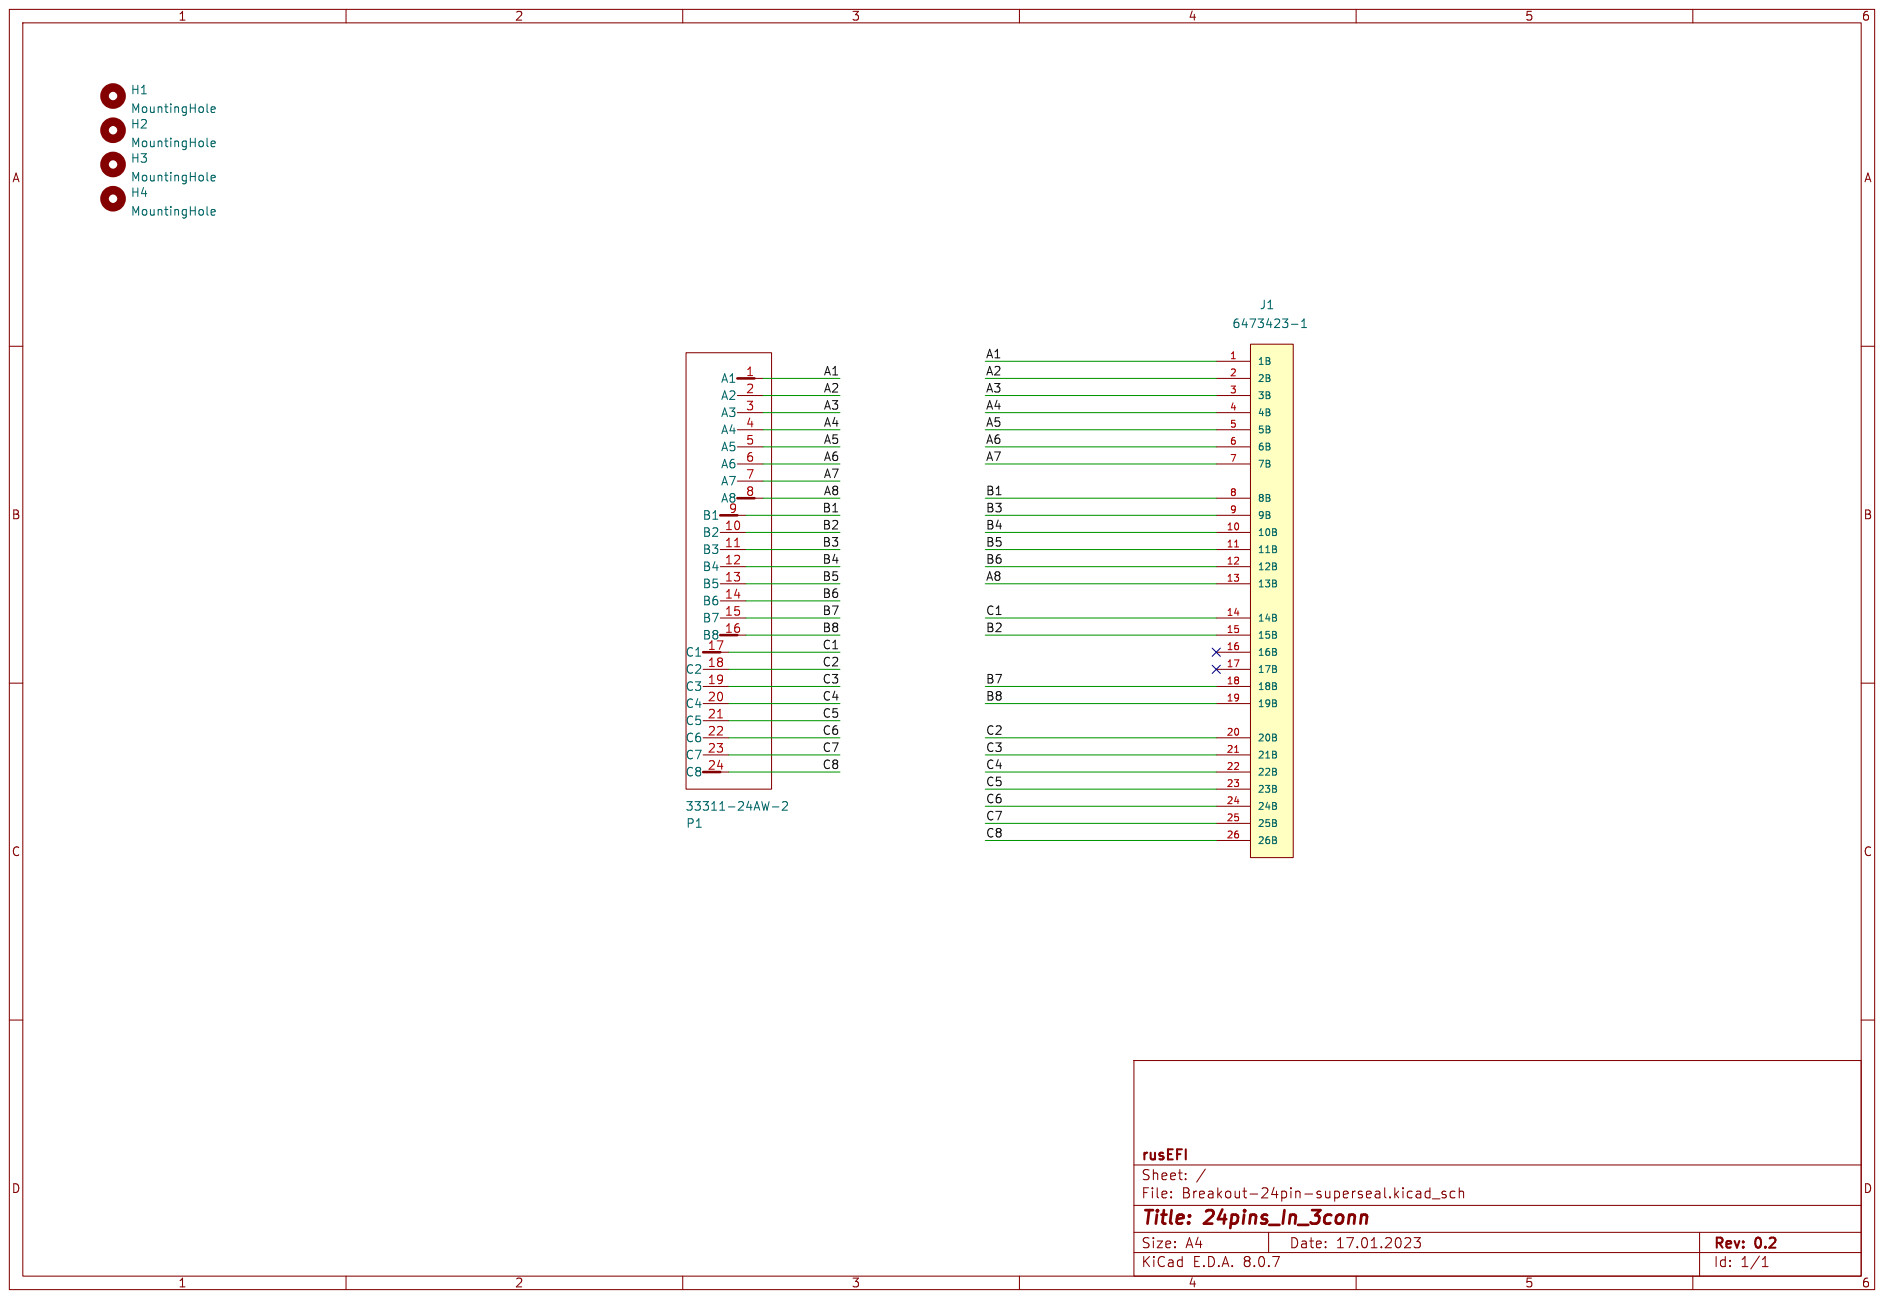
[picture p125: page 1]

File: Breakout-24pin-superseal.kicad_sch Sheet: / rusEFI
