rusefi/rusefi-hardware/breakout-boards/Breakout_154pin_284617-1-Connector/gerber/284617-1.pdf

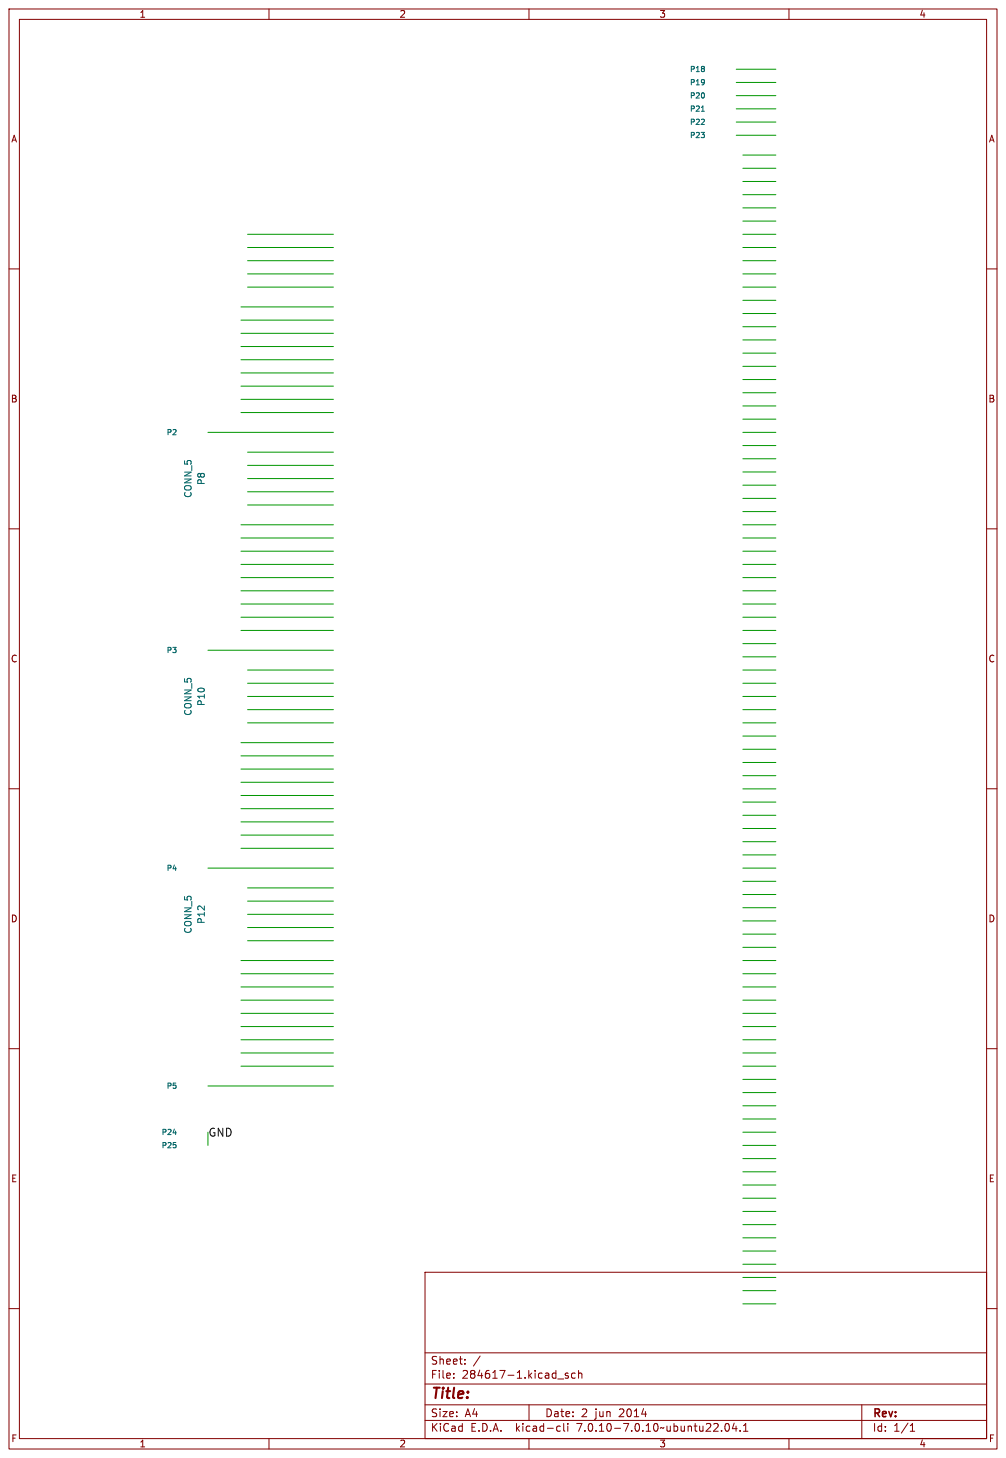
[picture p126: page 1]

Id: 1/1 Title: File: 284617-1.kicad_sch Sheet: / GND
