rusefi/rusefi-hardware/GDI-4ch/gerber/rev. d/GDI-4ch.pdf

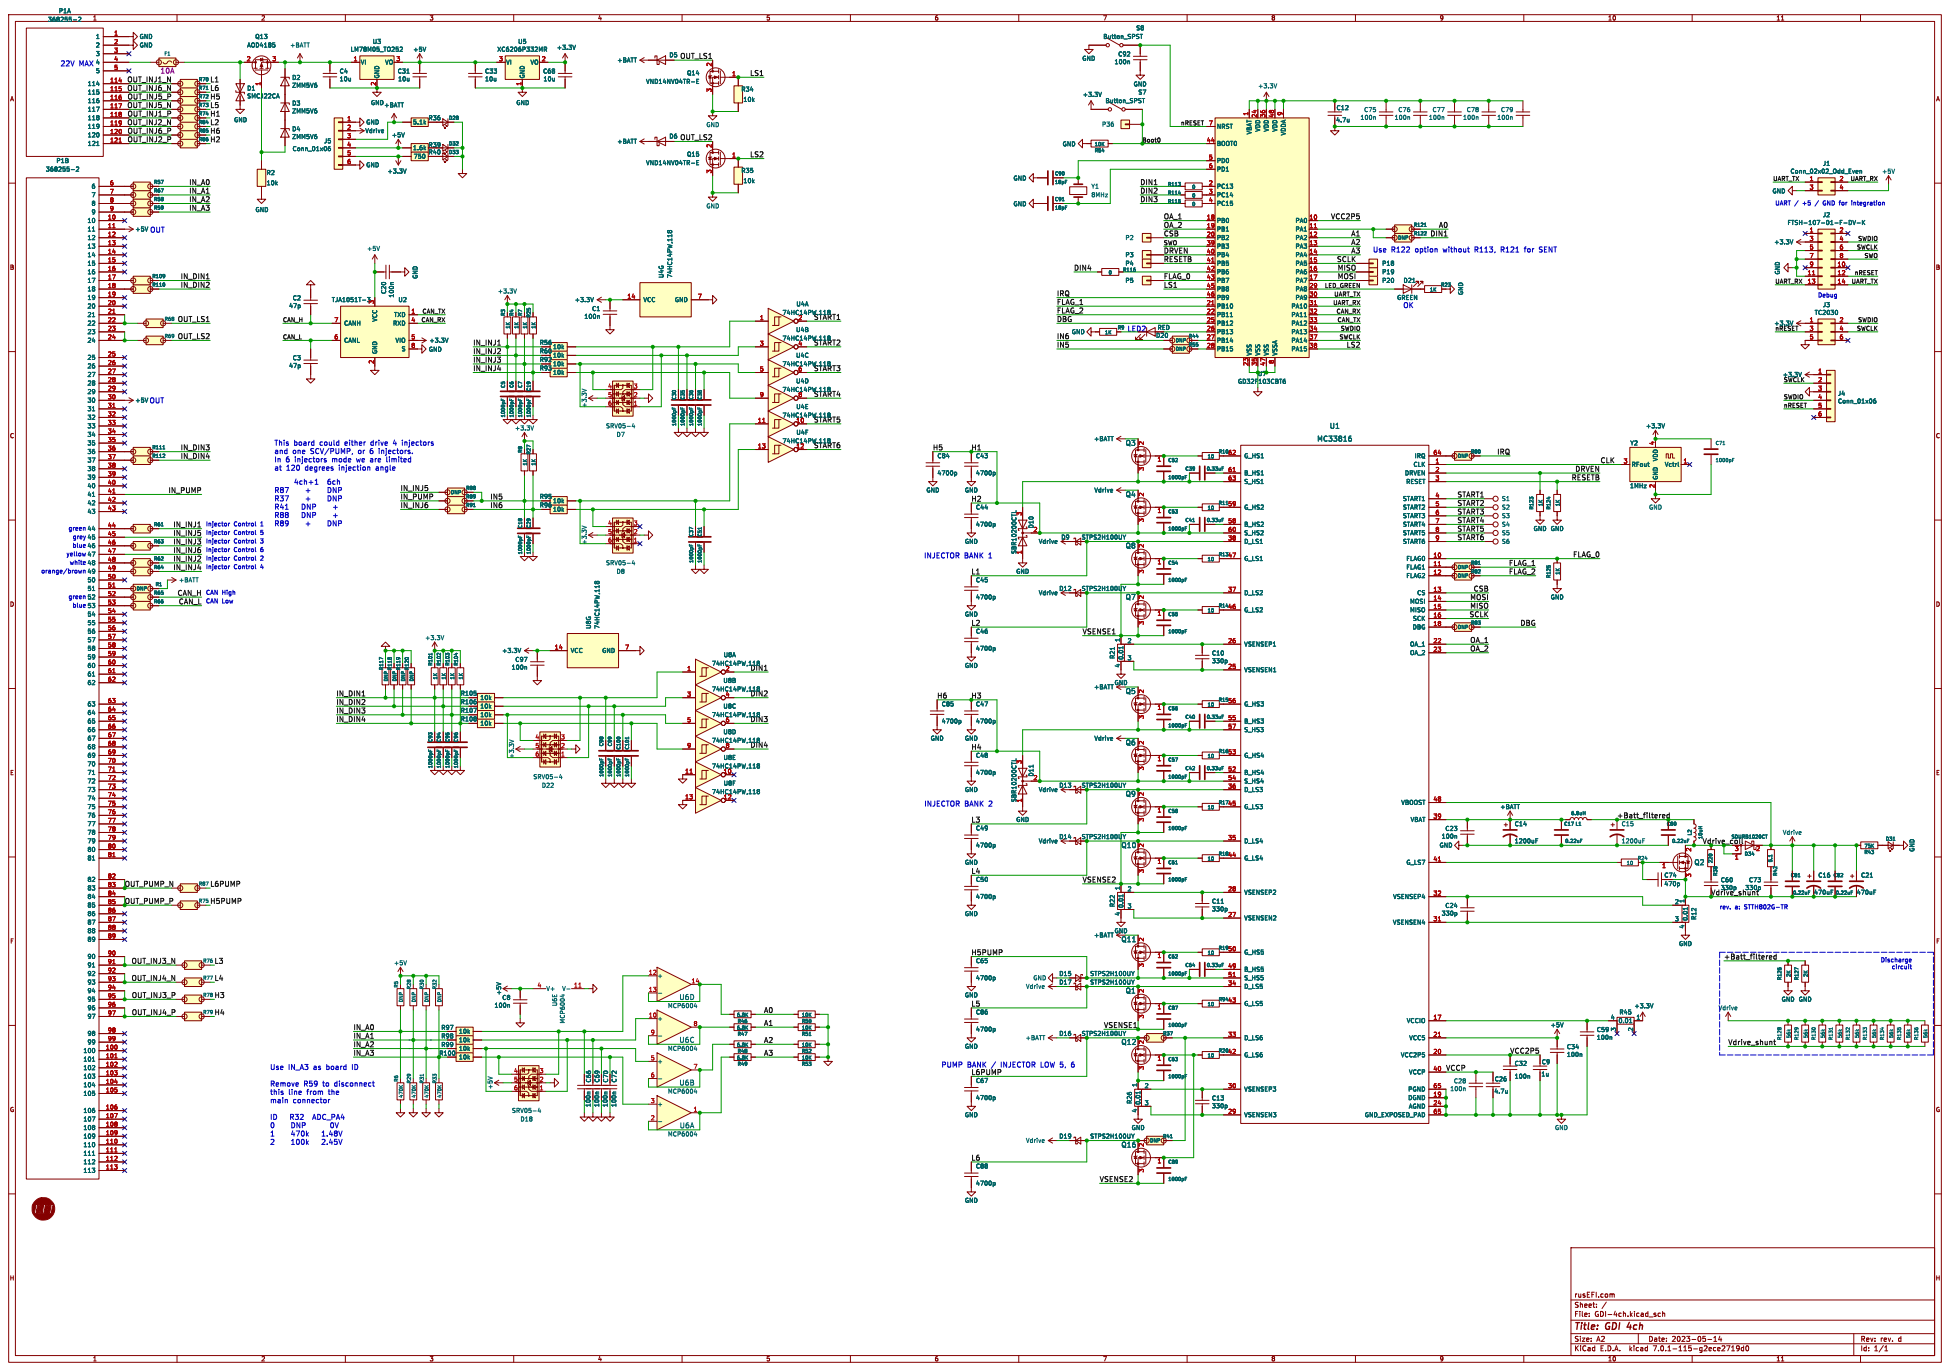
[picture p127: page 1]

UART / +5 / GND for integration 22V MAX

Use R122 option without R113, R121 for SENT

3 RXD 4 VIO 5 CANL 6 CANH 7 S

INJECTOR BANK 2 Use IN_A3 as board ID

PUMP BANK / INJECTOR LOW 5, 6

Remove R59 to disconnect
this line from the main connector

File: GDI-4ch.kicad_sch Sheet: / rusEFI.com
