rusefi/rusefi-hardware/wideband-F103/export/rev5/wideband_controller.pdf

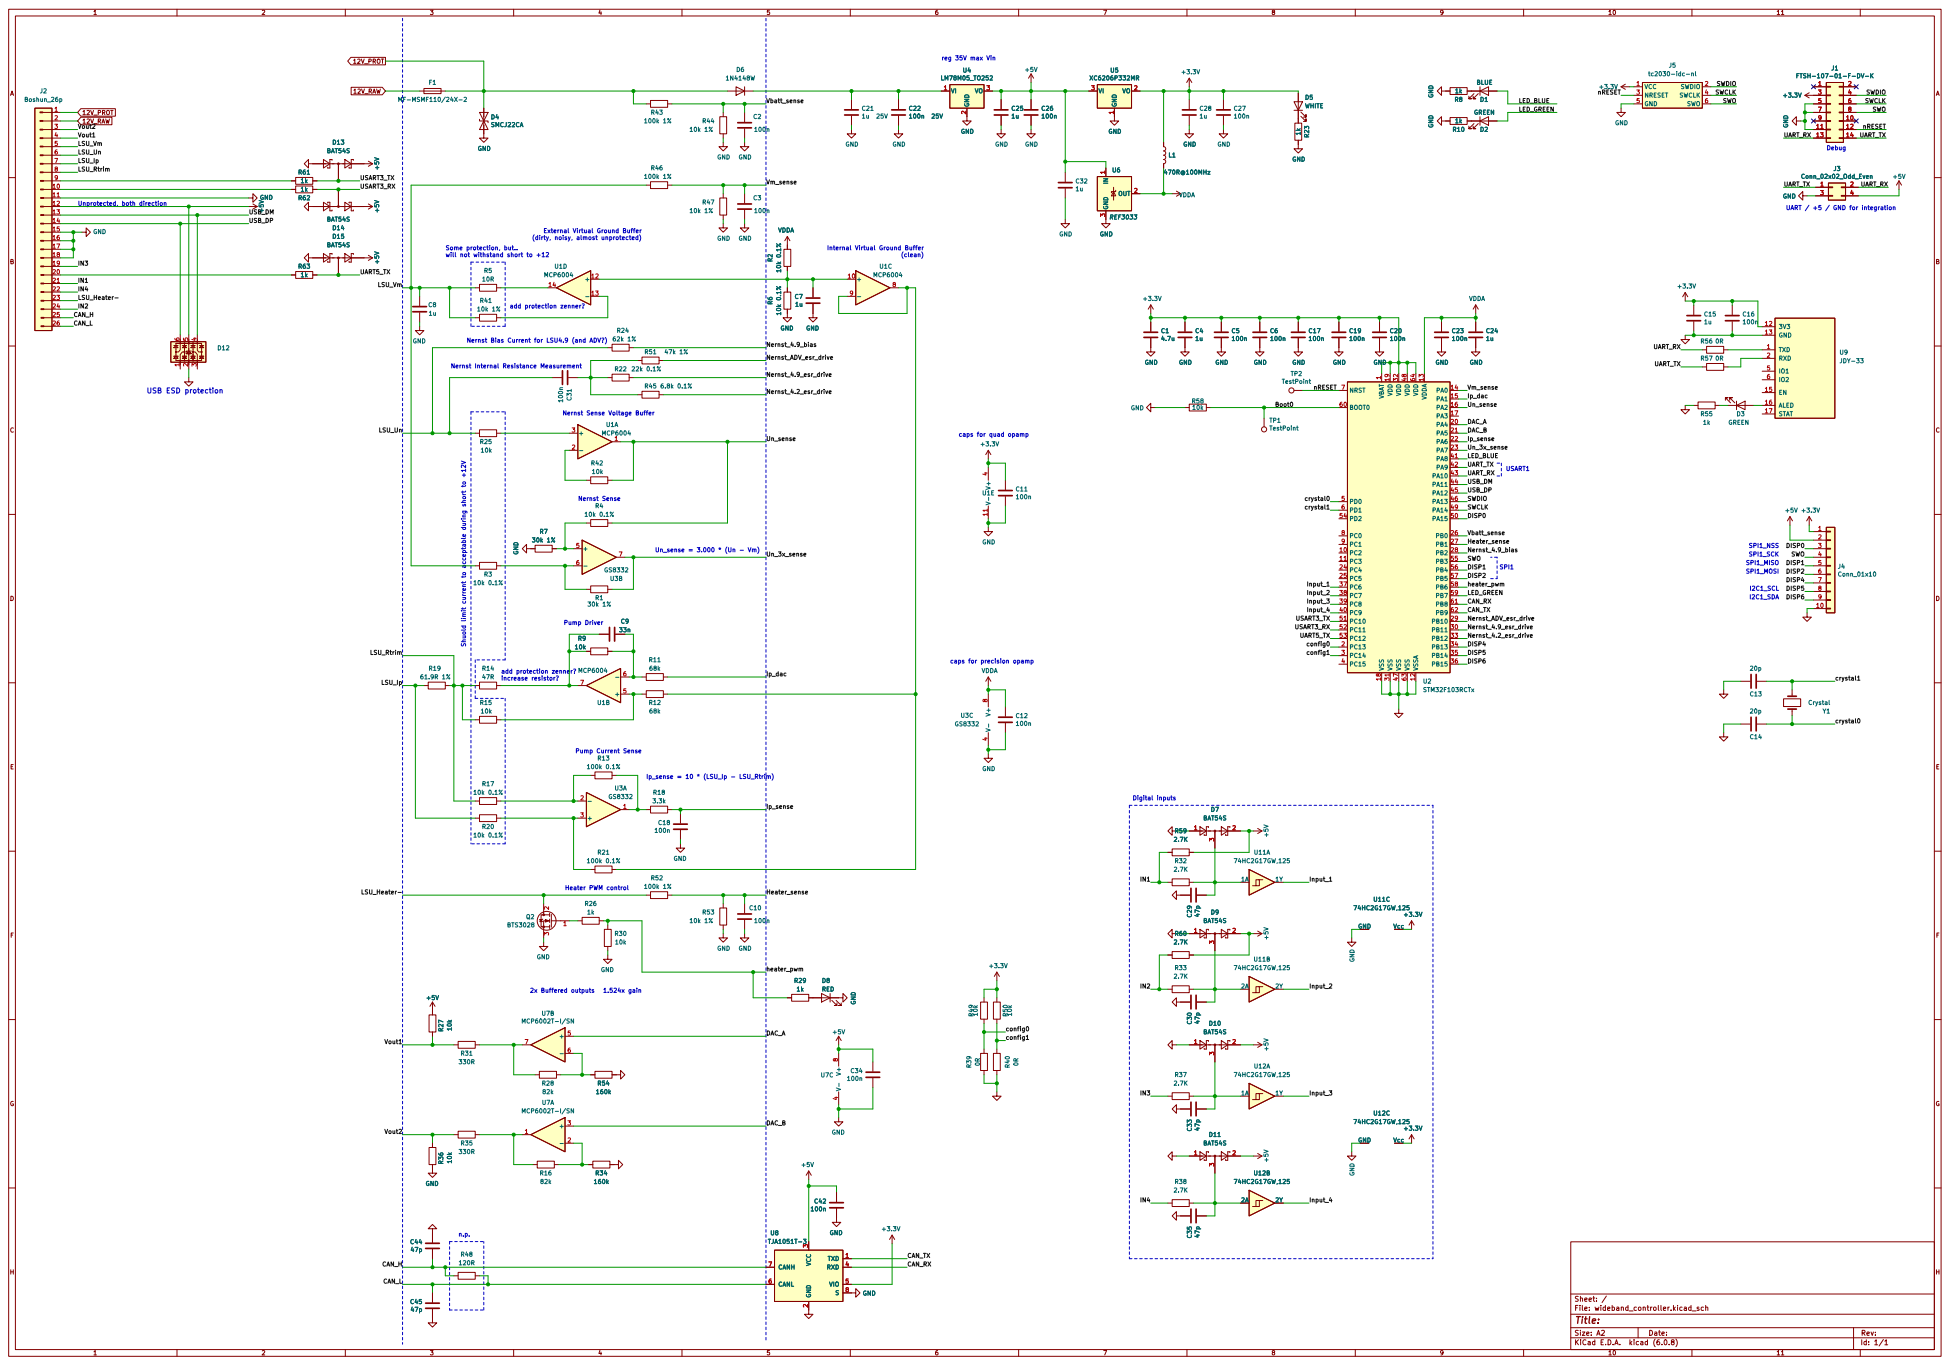
[picture p128: page 1]

reg 35V max Vin Nernst Internal Resistance Measurement Nernst Bias Current for LSU4.9 (and ADV?)

External Virtual Ground Buffer
(dirty, noisy, almost unprotected)

Some protection, but.. will not withstand short to +12

Internal Virtual Ground Buffer

caps for quad opamp

caps for precision opamp

3 RXD 4 VIO 5 CANL 6 CANH 7 S
