rusefi/rusefi-hardware/GDI-4ch/gerber/rev. c/GDI-4ch.pdf

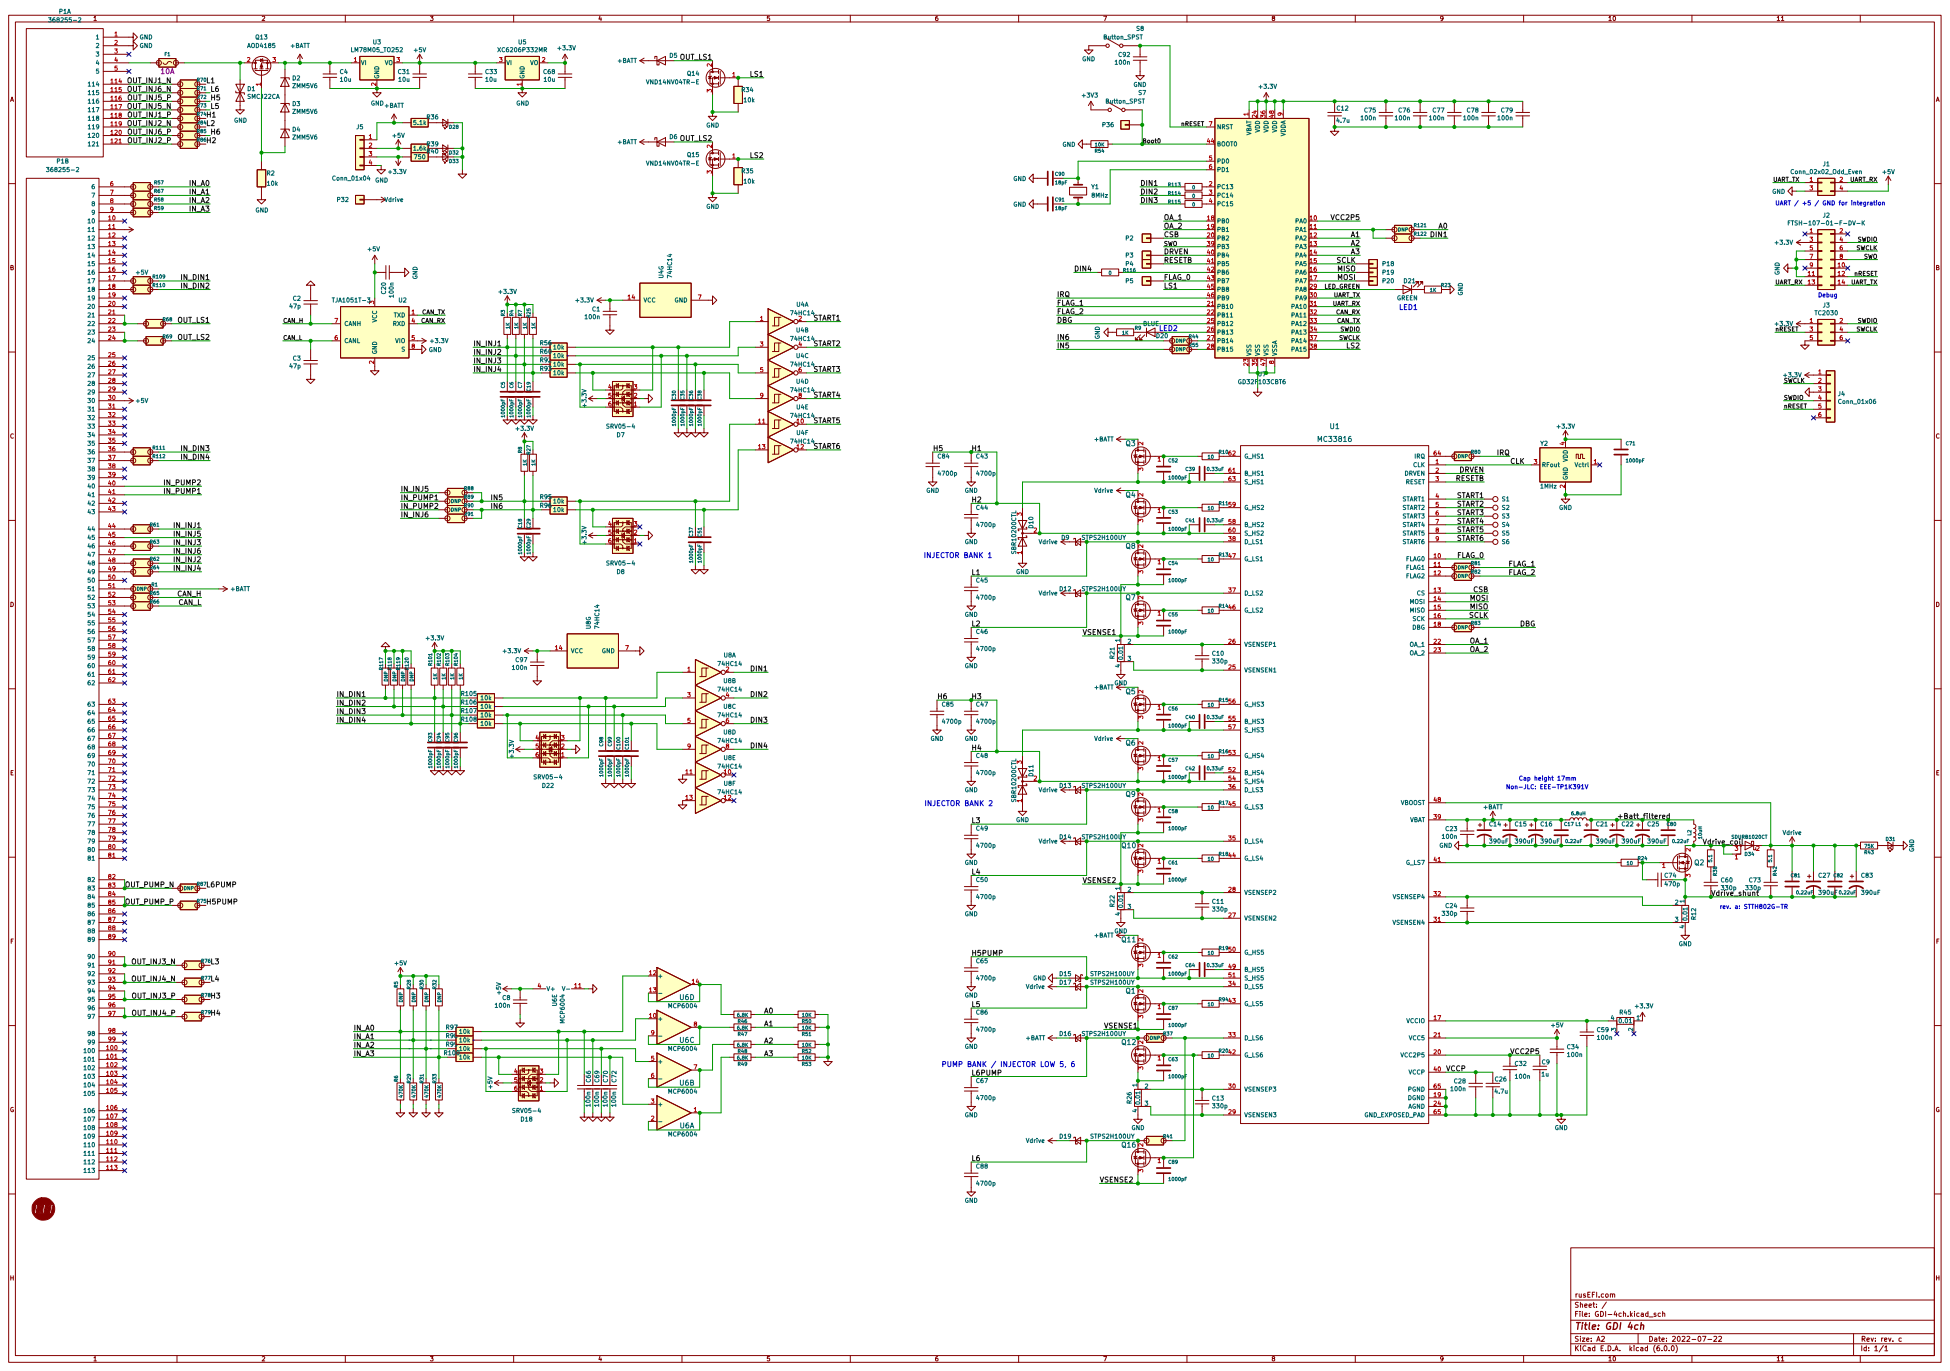
[picture p129: page 1]

UART / +5 / GND for integration LED1

3 RXD 4 VIO 5 CANL 6 CANH 7 S

File: GDI-4ch.kicad_sch Sheet: / rusEFI.com
