rusefi/rusefi-hardware/breakout-boards/adapter-board-me17-112-A-schematic.pdf

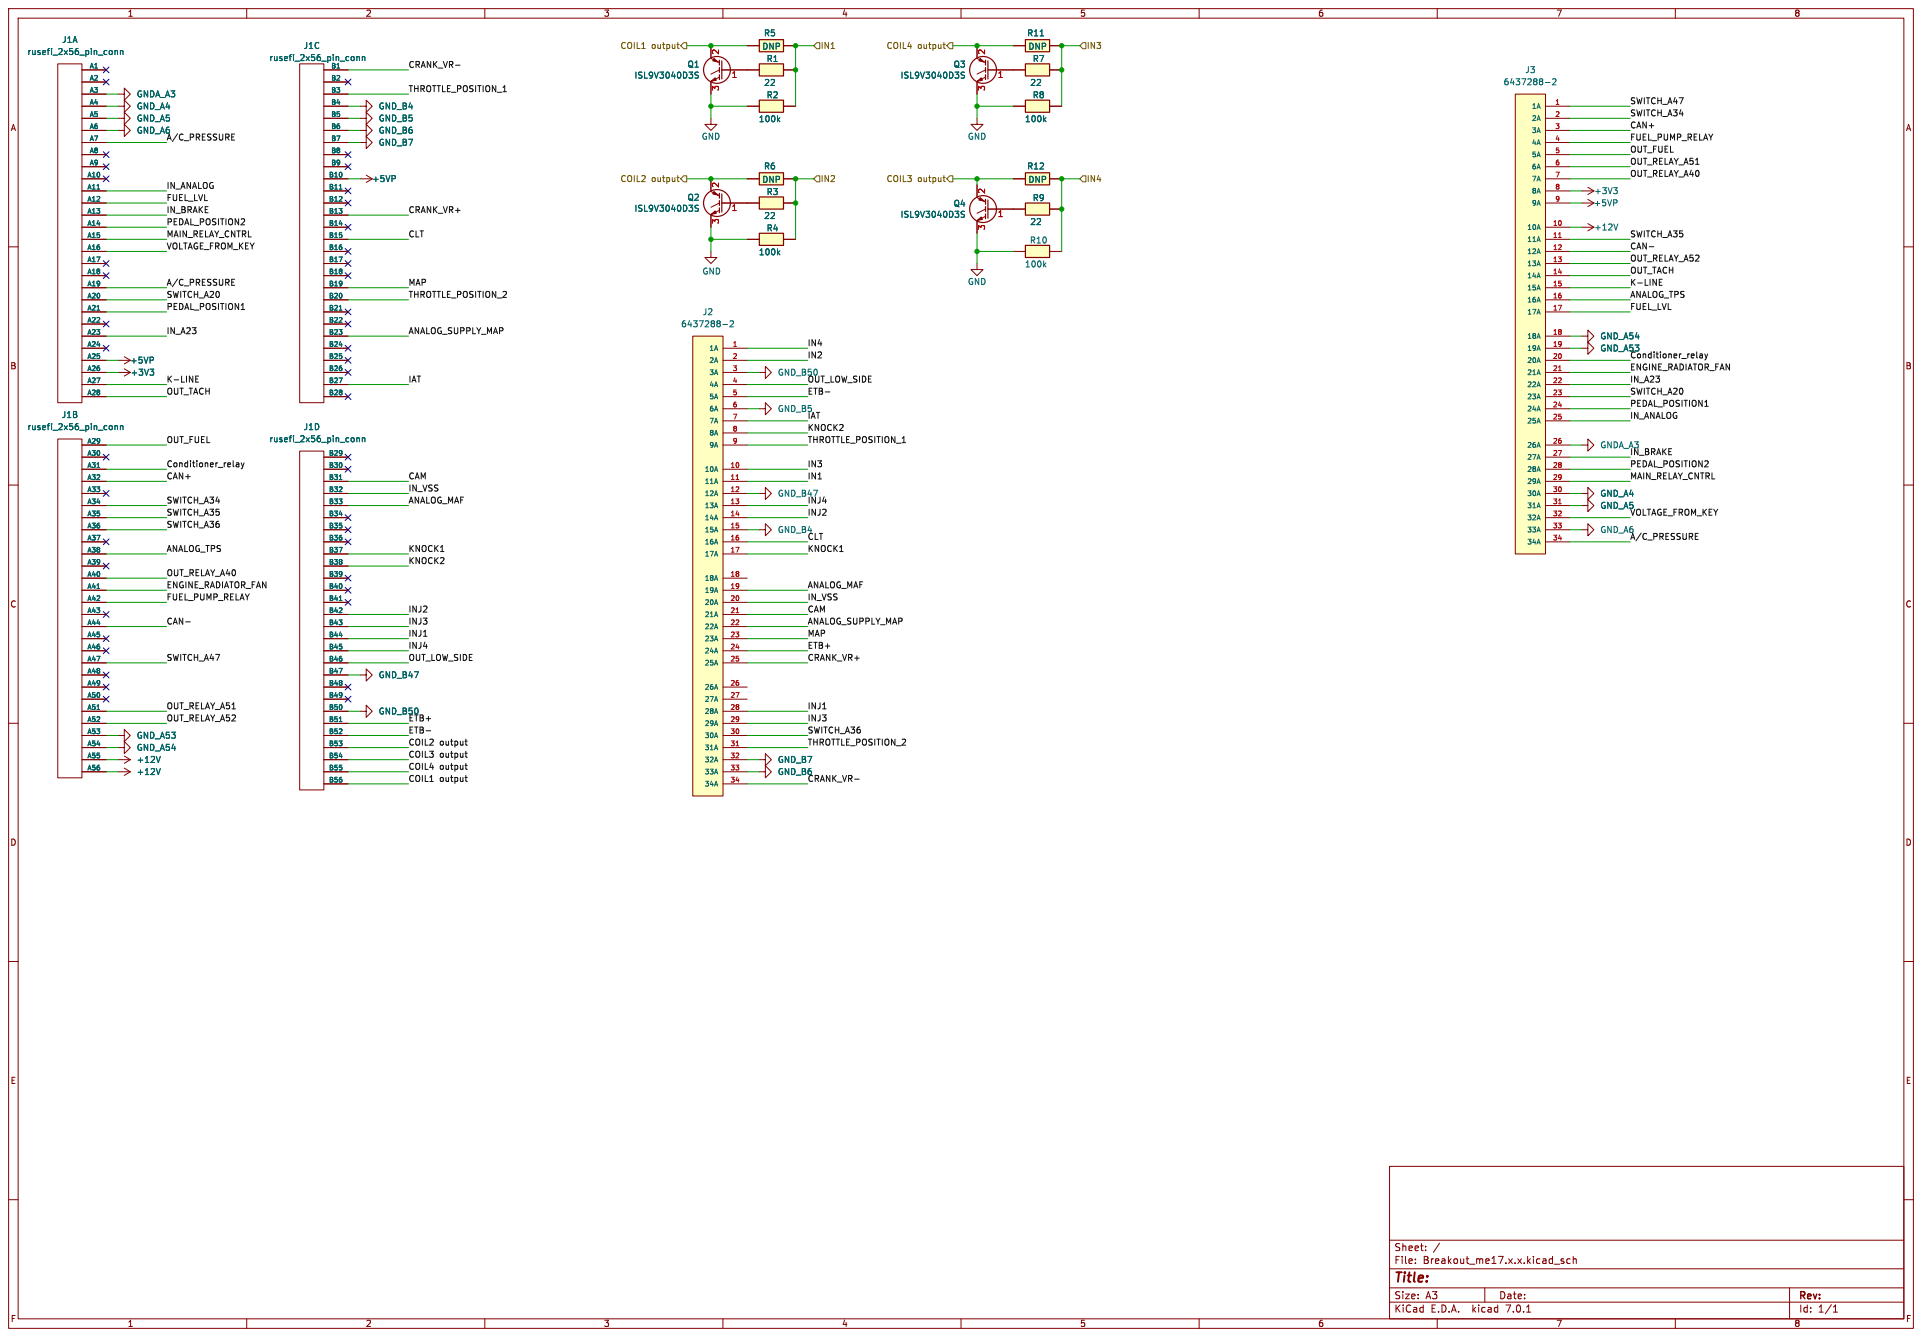
[picture p130: page 1]
