rusefi/rusefi-hardware/Low-Z_LM1949/export/0.1/Schematics.pdf

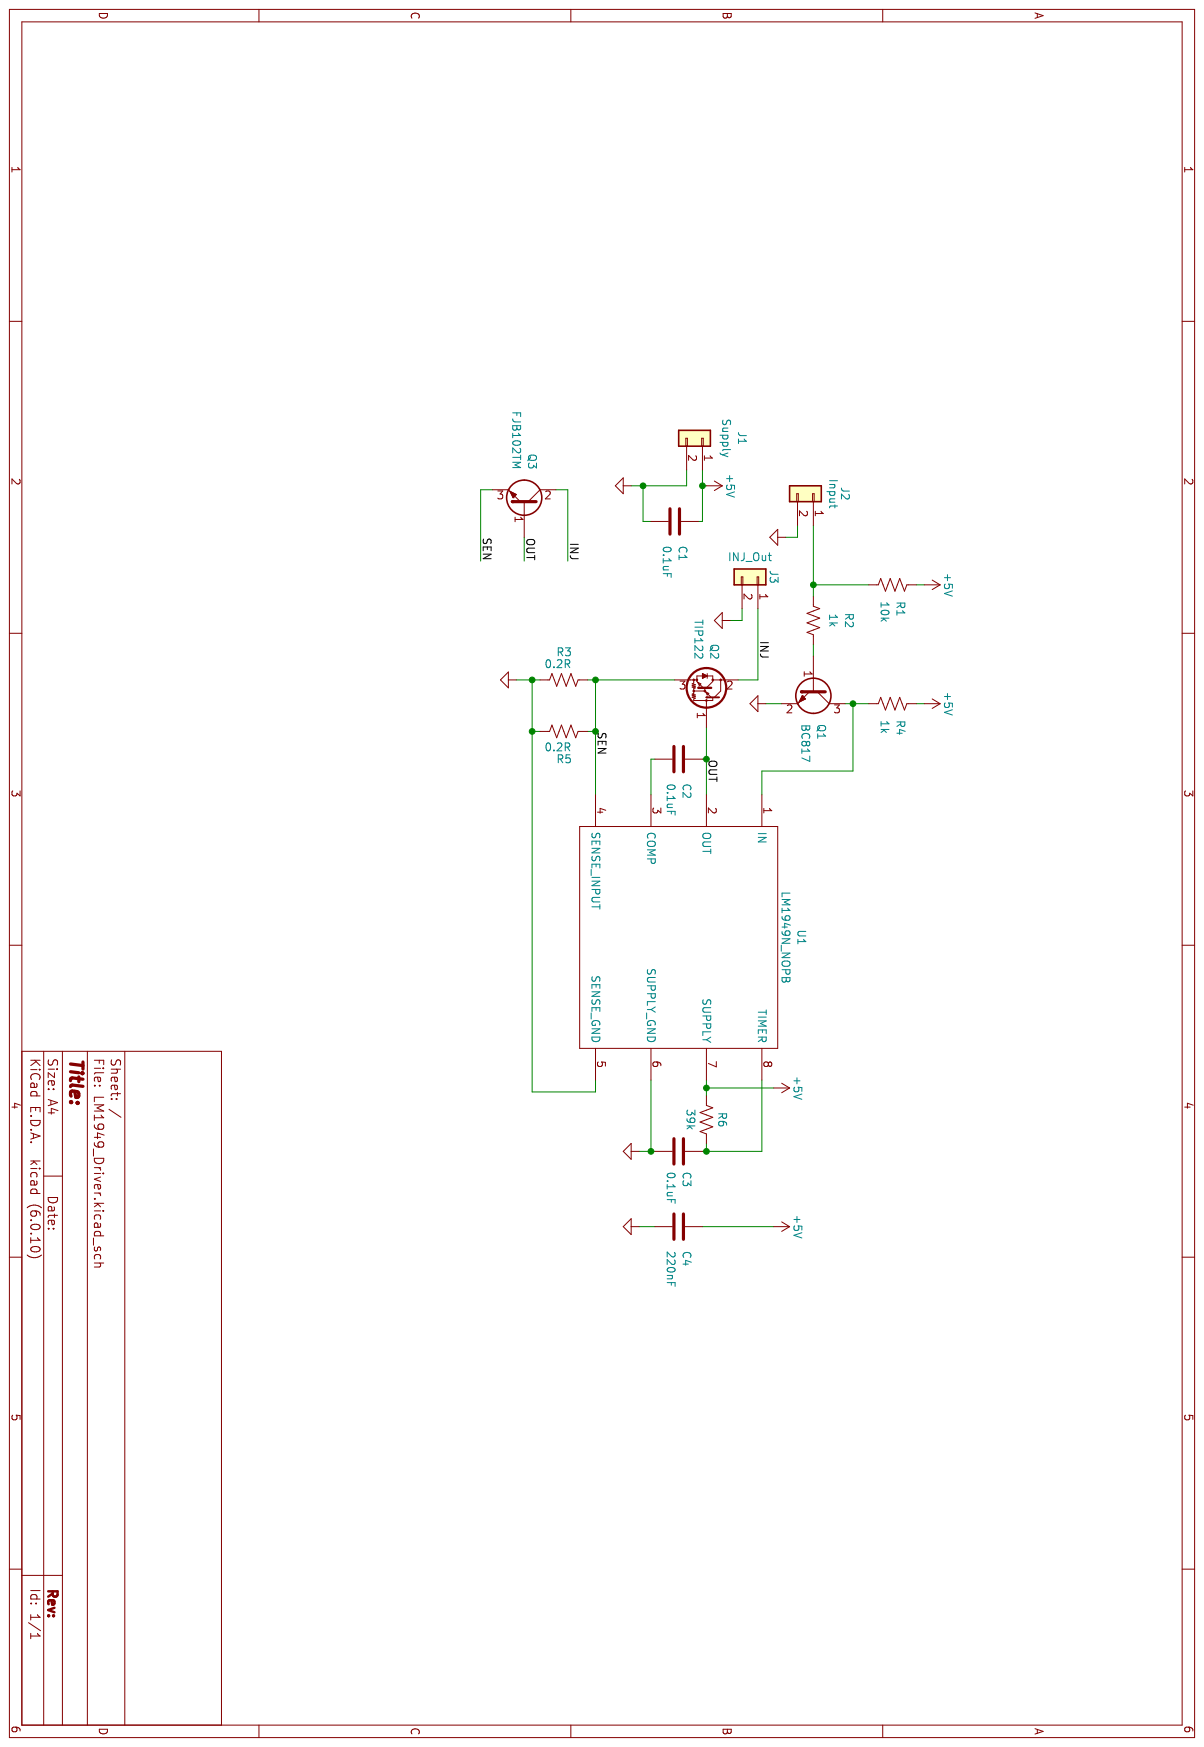
[picture p131: page 1]
