rusefi/rusefi-hardware/classic-designs/rusefi_hardware_history/can_board_rev00.20/can_board/Schematic.pdf

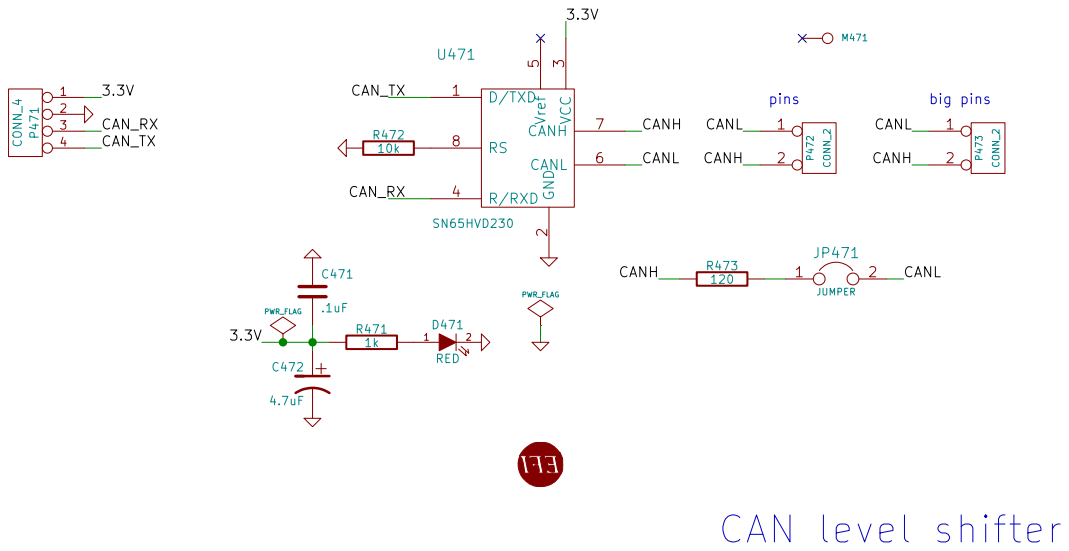
[picture p132: page 1]

3 R/RXD 4 Vref 5 CANL 6 CANH 7 RS 8 U471

Sheet: /home/rex/Art_Electro/For_ftp_rusefi/can_board/can_brd_1.sch File: Title:
