rusefi/rusefi-hardware/breakout-boards/hellen-hyundai-pb-154-adapter-rev-b.pdf

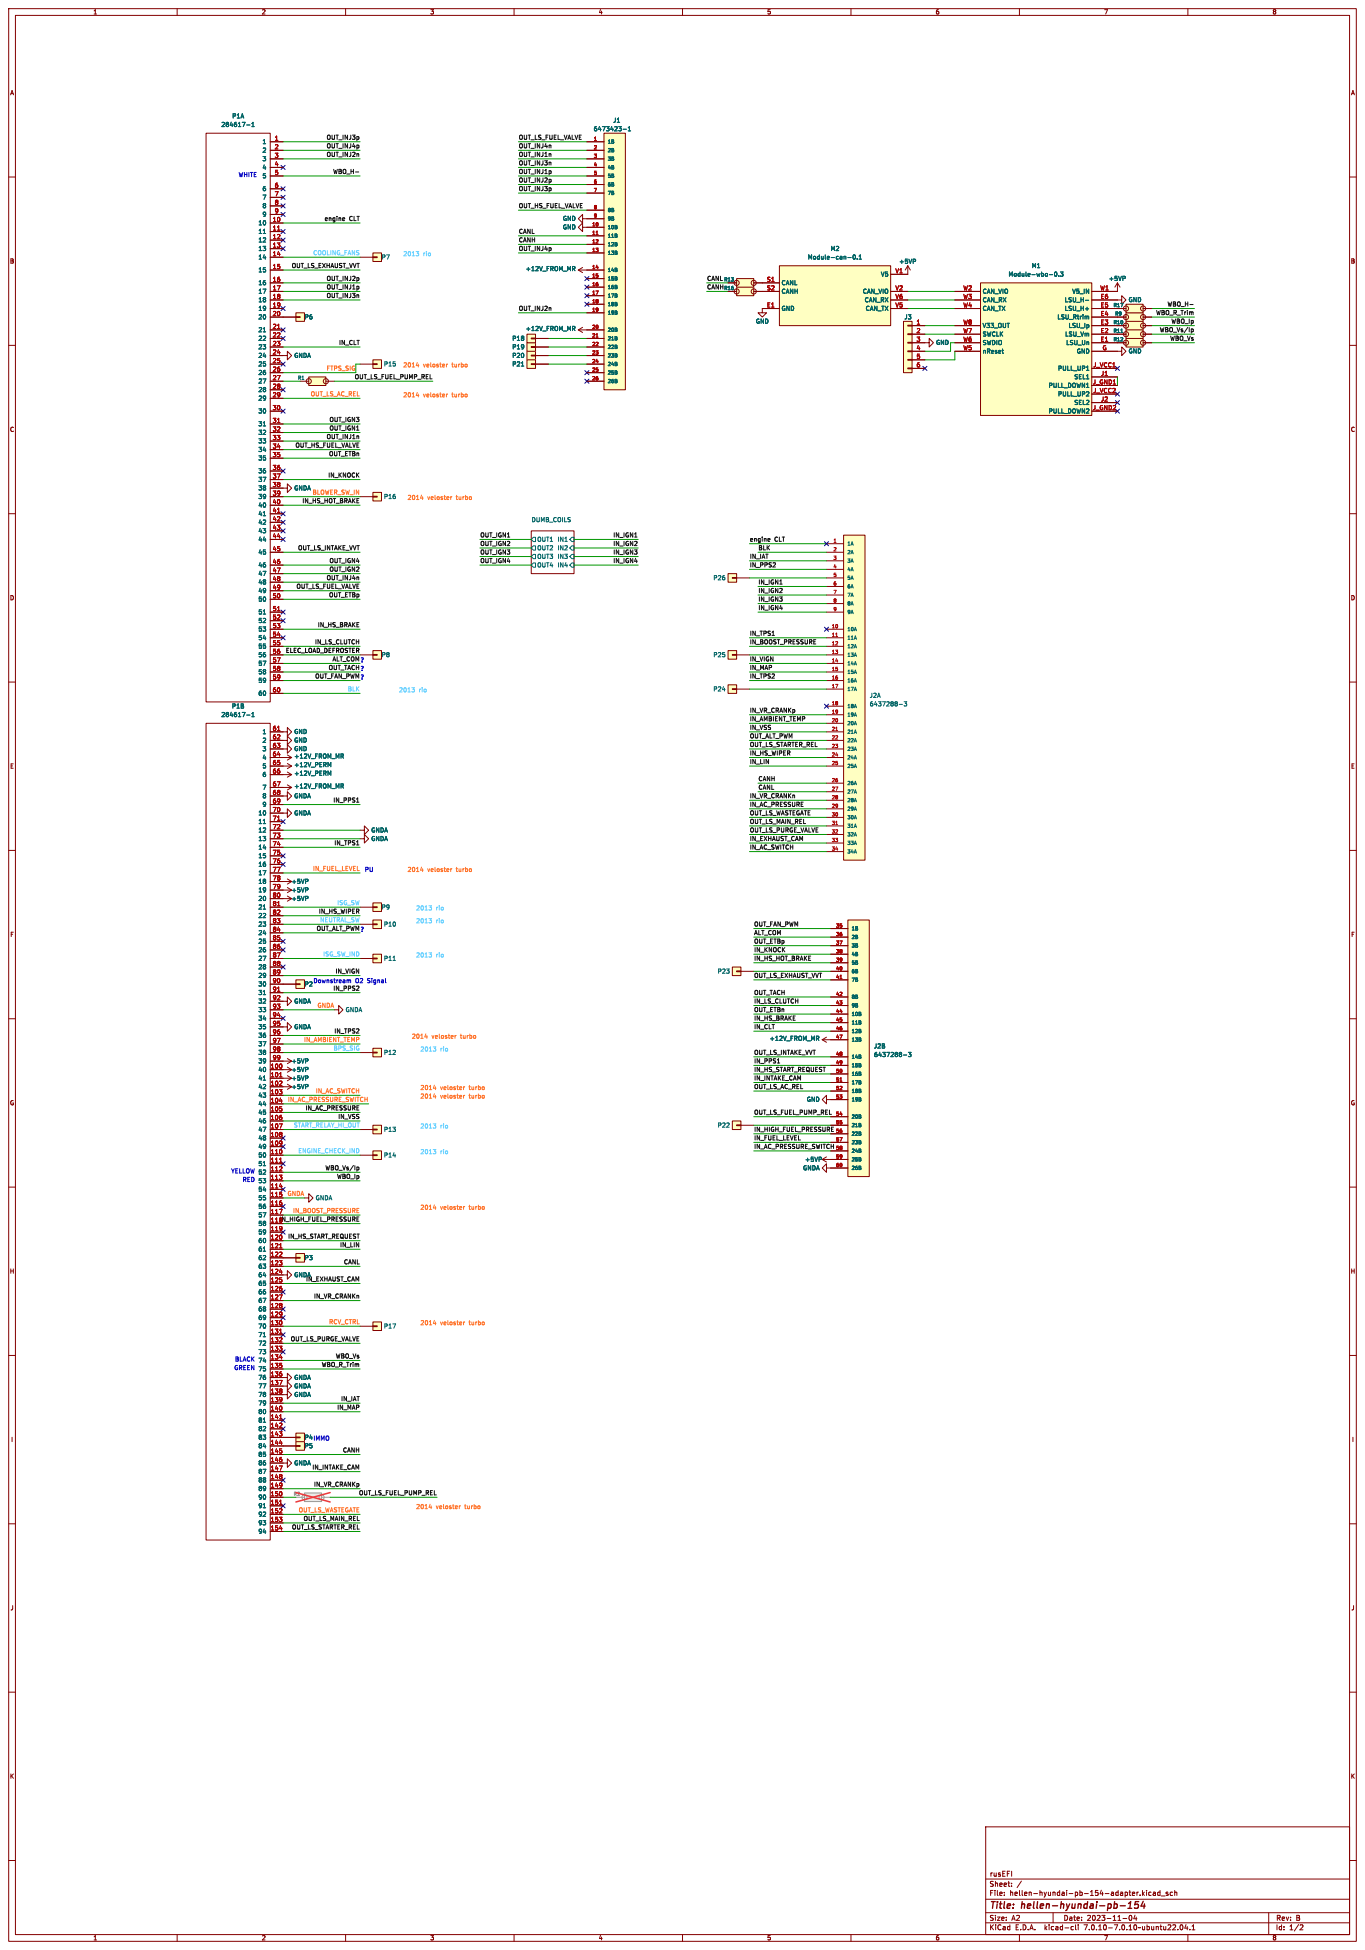
[picture p133: page 1]

Id: 1/2 Title: hellen-hyundai-pb-154
