rusefi/rusefi-hardware/breakout-boards/Passat-2.0-MED9.1-adapter.pdf

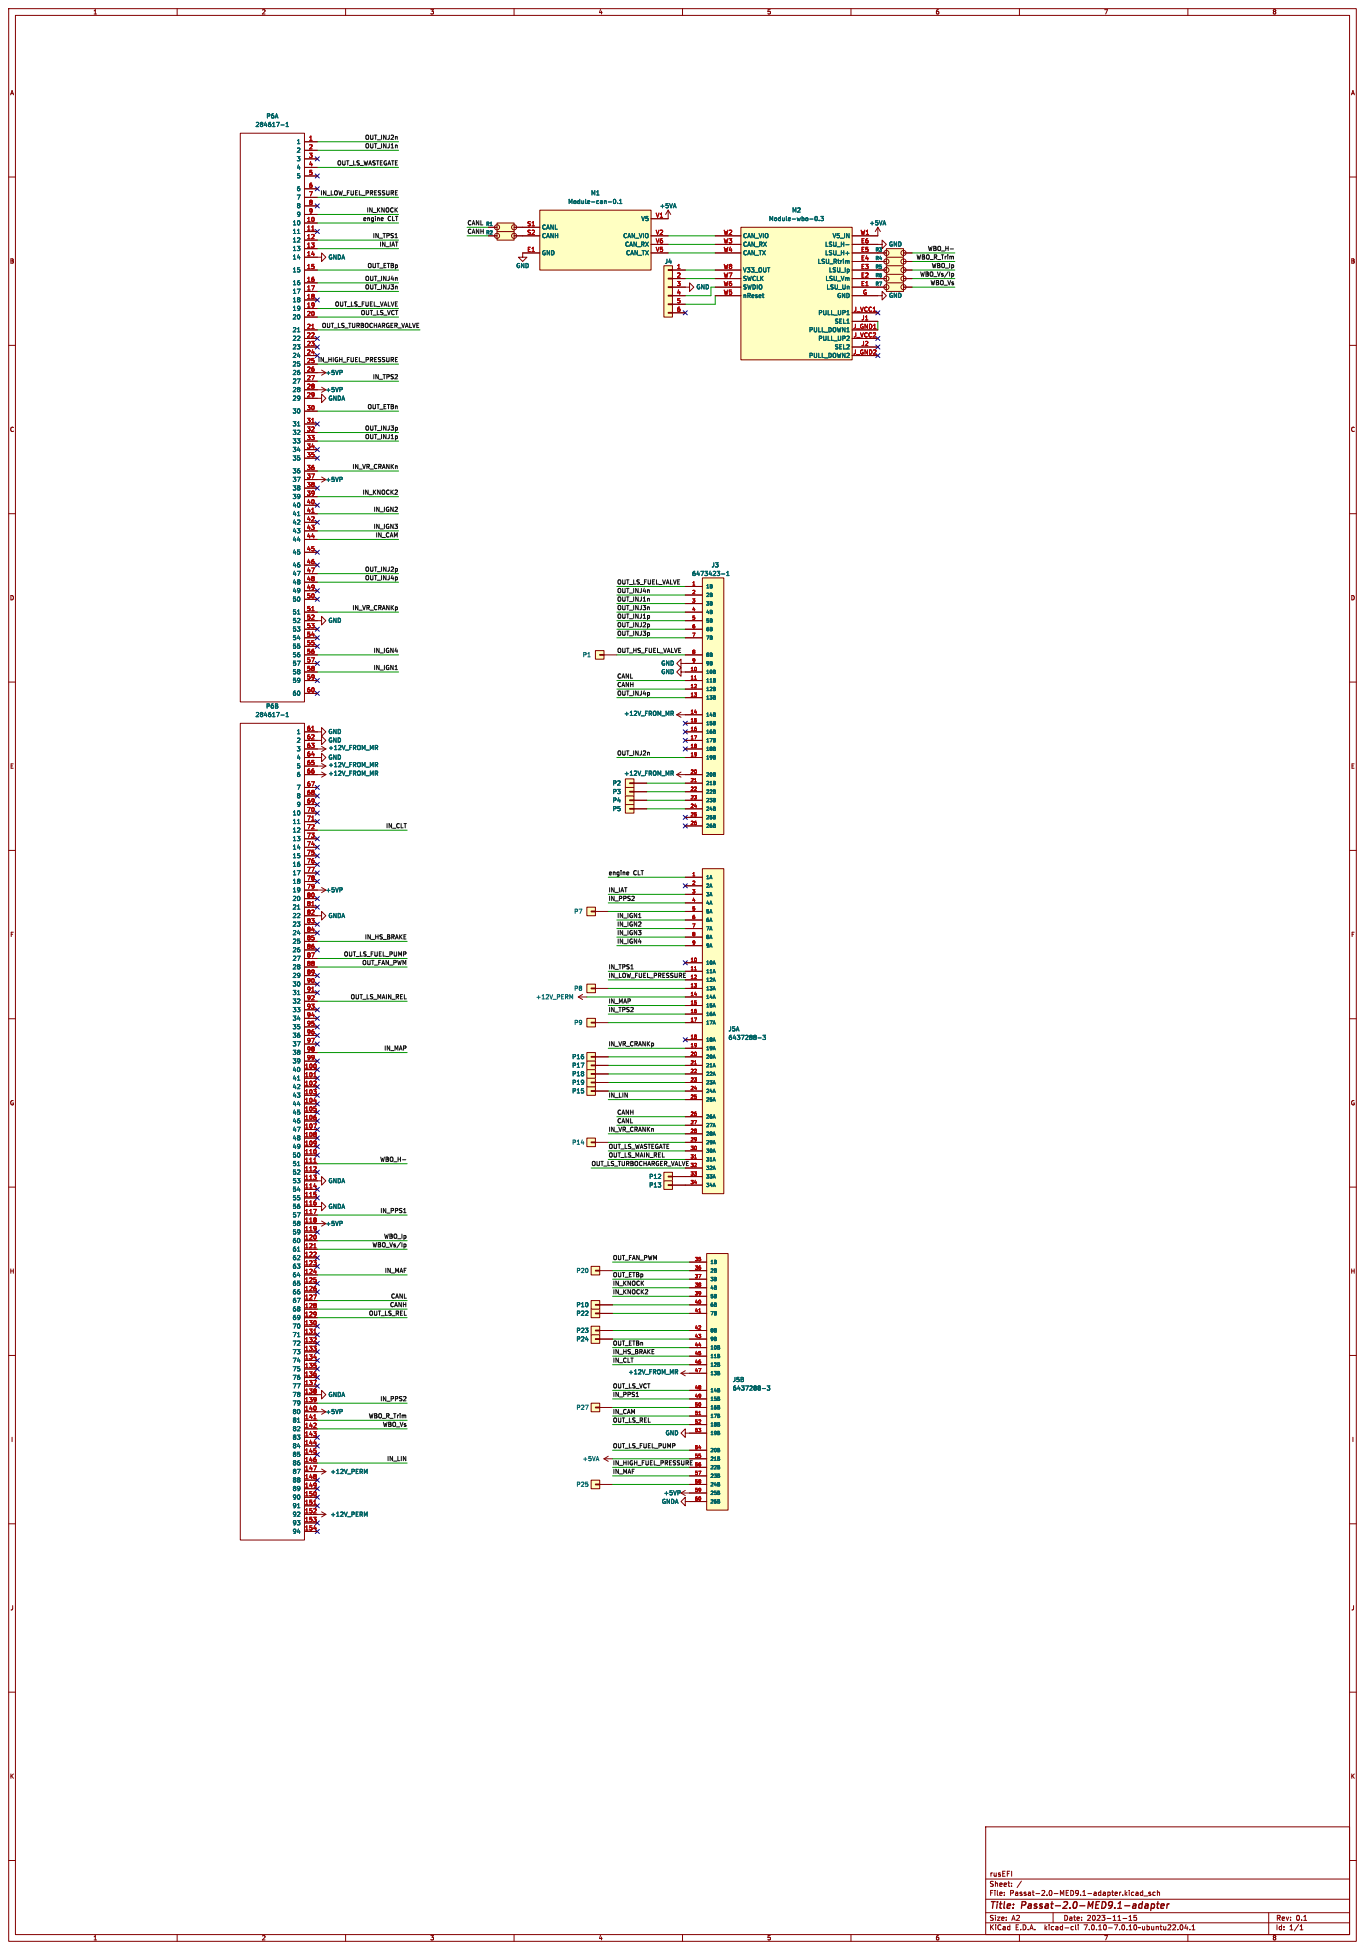
[picture p134: page 1]
