rusefi/rusefi-hardware/hellen-208/hellen1-mcu429.pdf

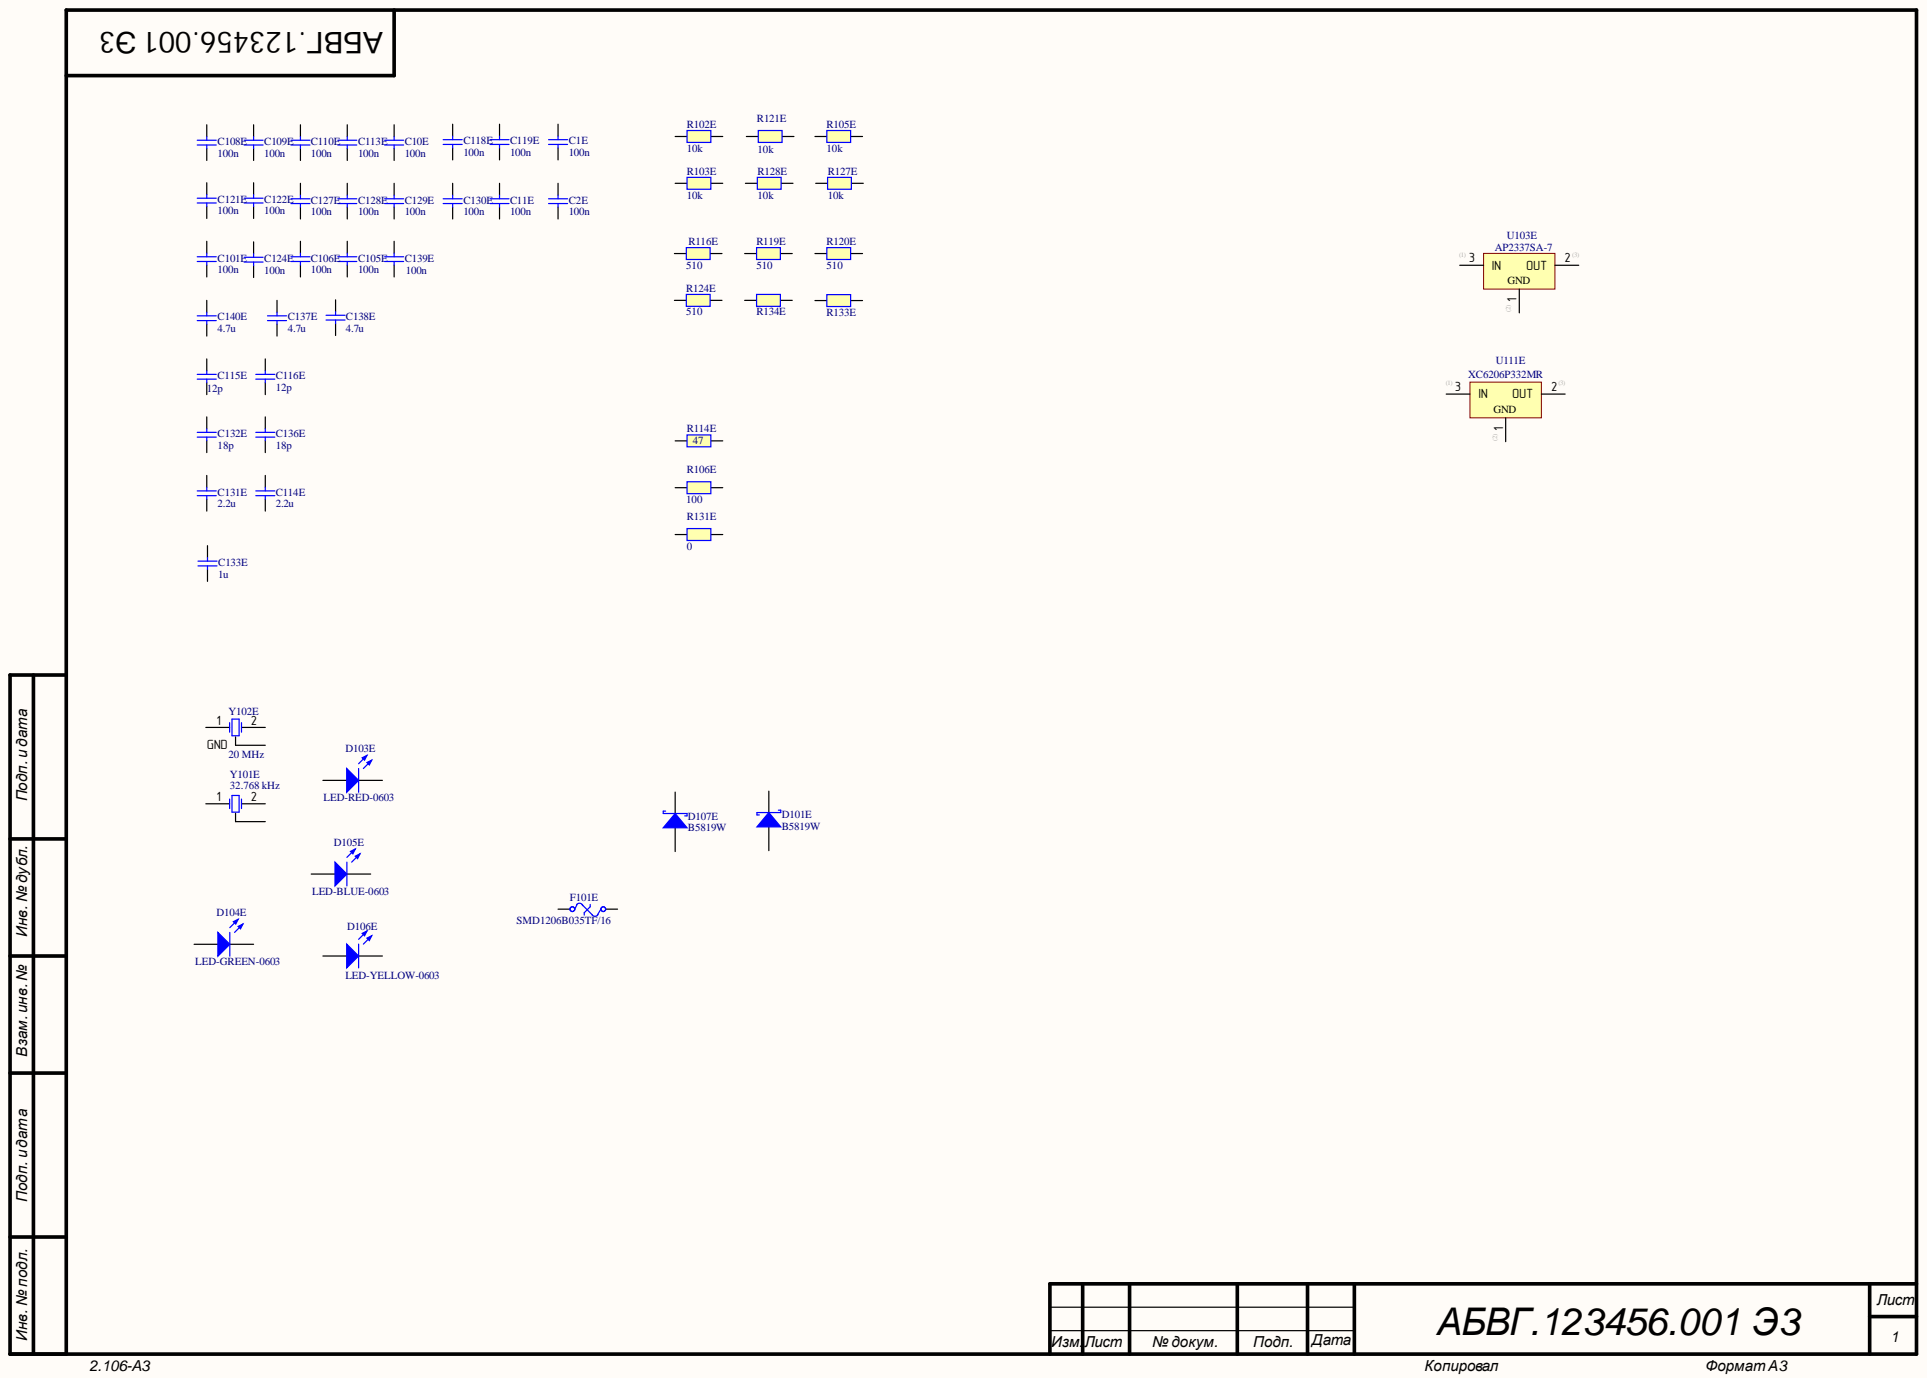
[picture p135: page 1]

Инв. № подл. Инв. № дубл. Подп. и дата Взам. инв. № Подп. и дата

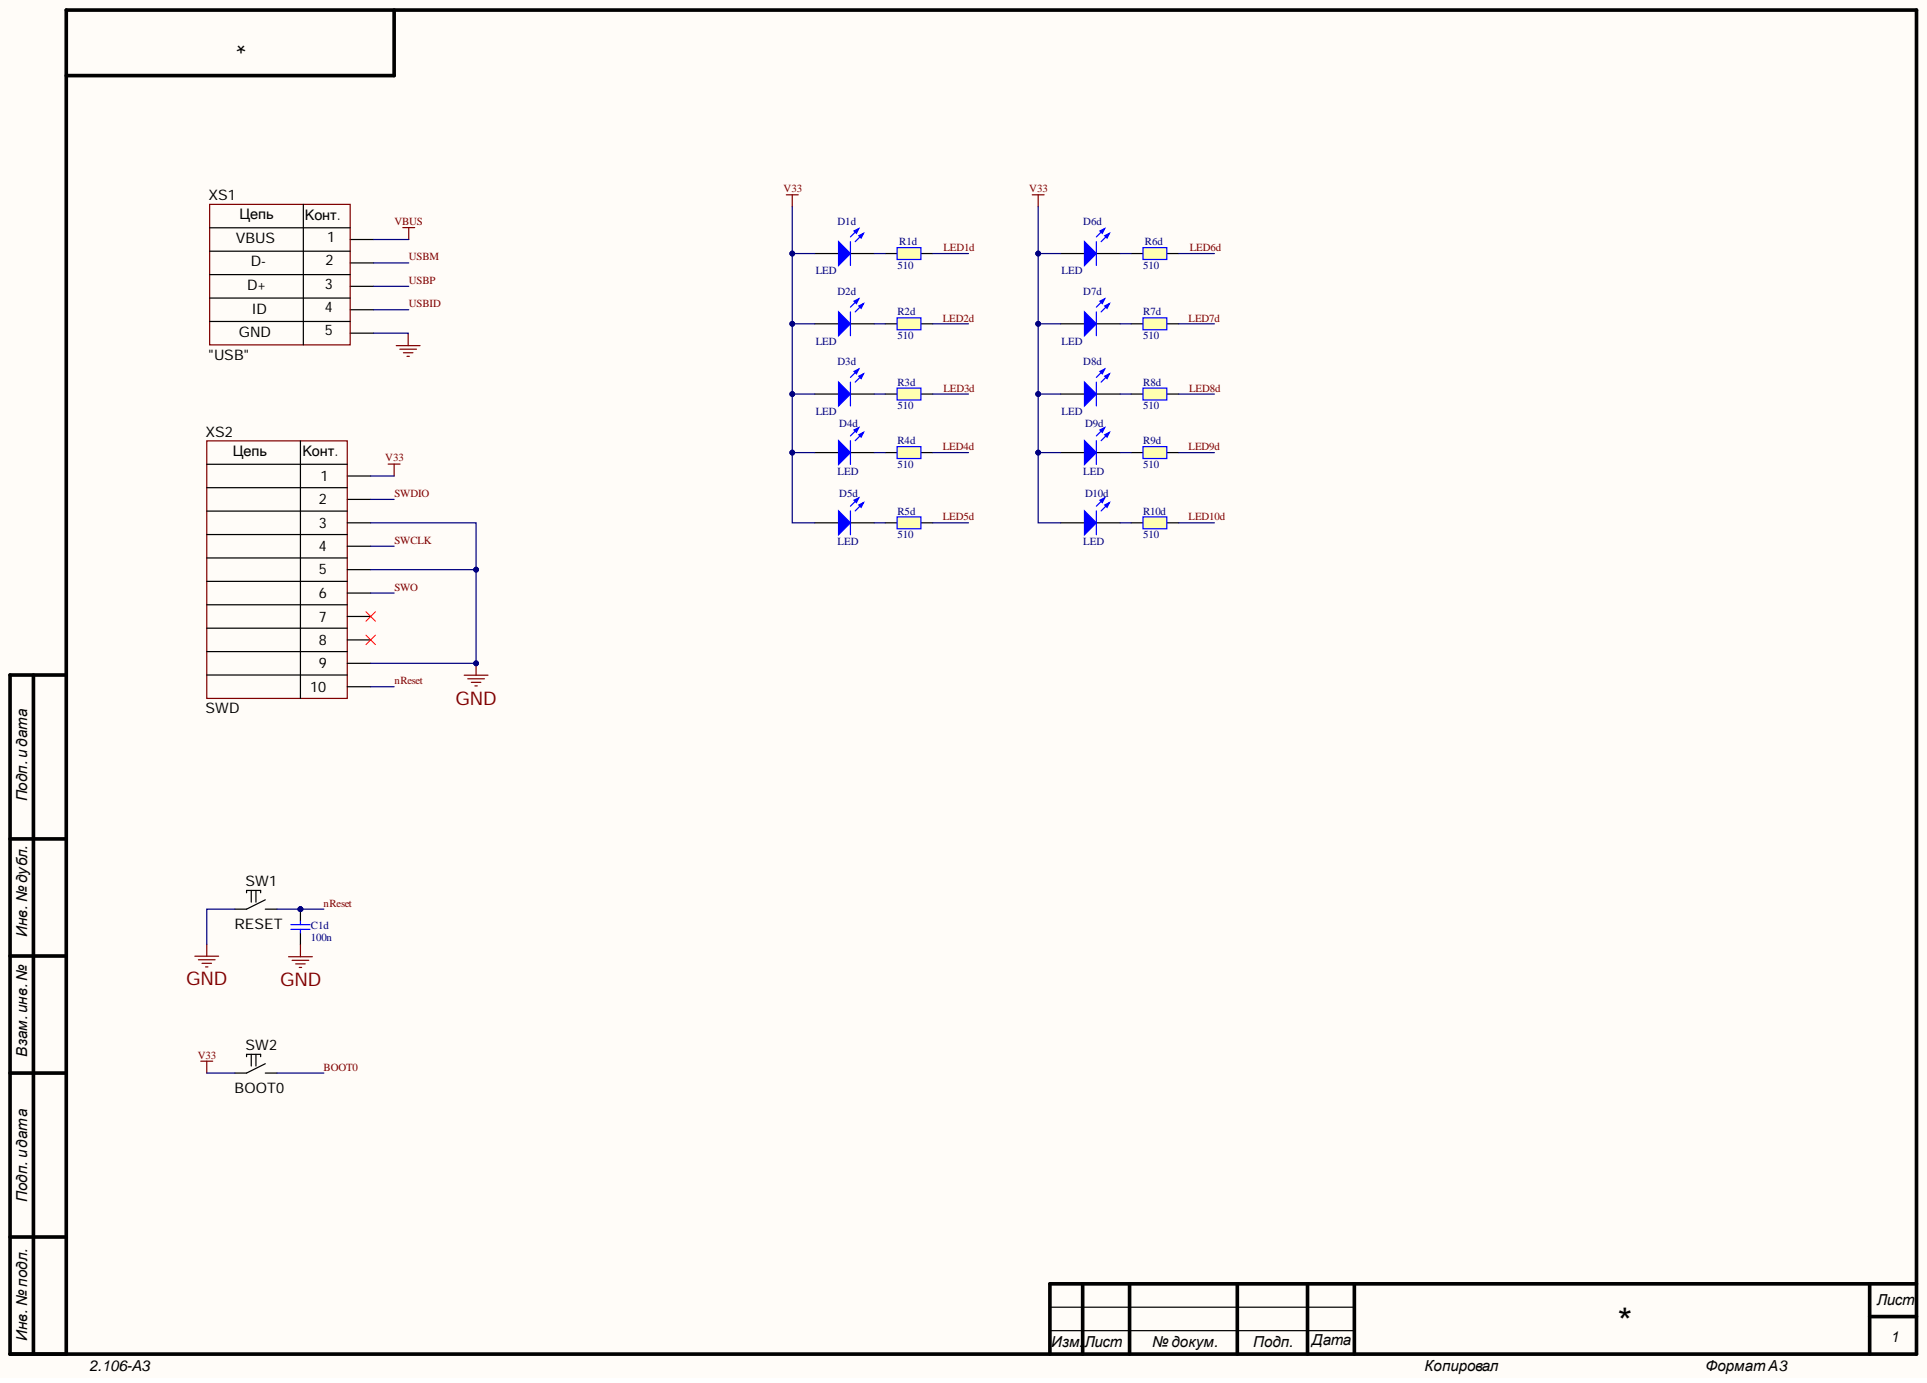
[picture p136: page 2]

Цепь | Конт.
VBUS | 1

D+ | 3
ID | 4

10

SWCLK

SWO

Инв. № подл. Инв. № дубл. Подп. и дата Взам. инв. № Подп. и дата

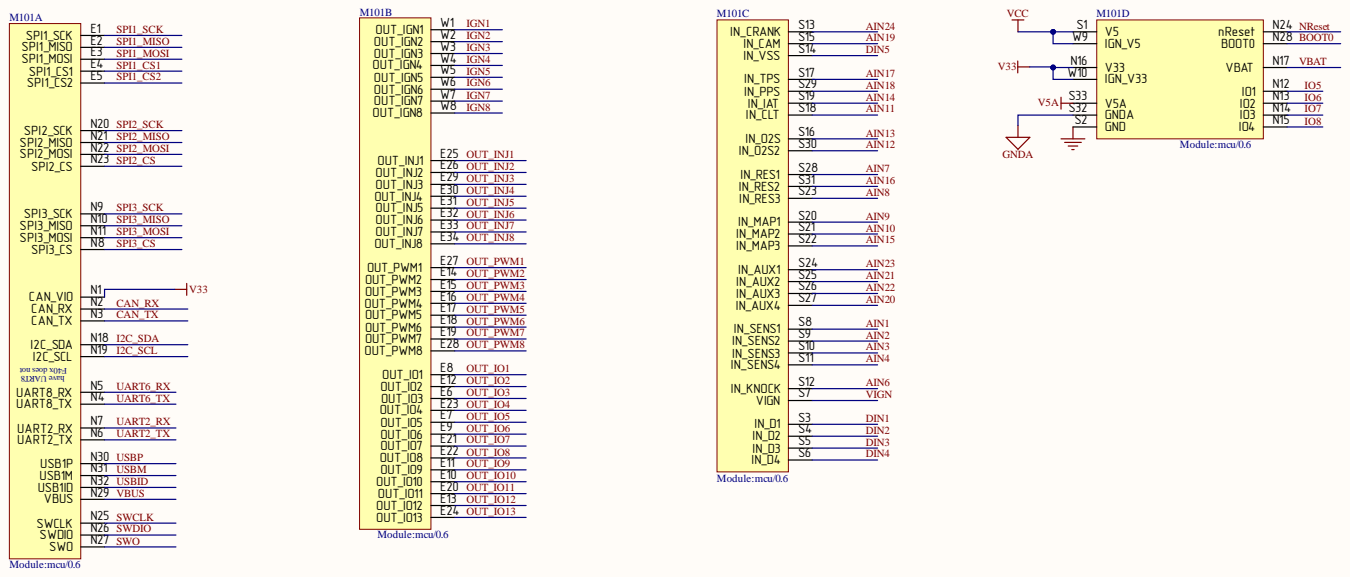
[picture p137: page 3]

Инв. № подл. Инв. № дубл. Подп. и дата Взам. инв. № Подп. и дата

* | Лист *

Изм | . Лист | П одп | ата

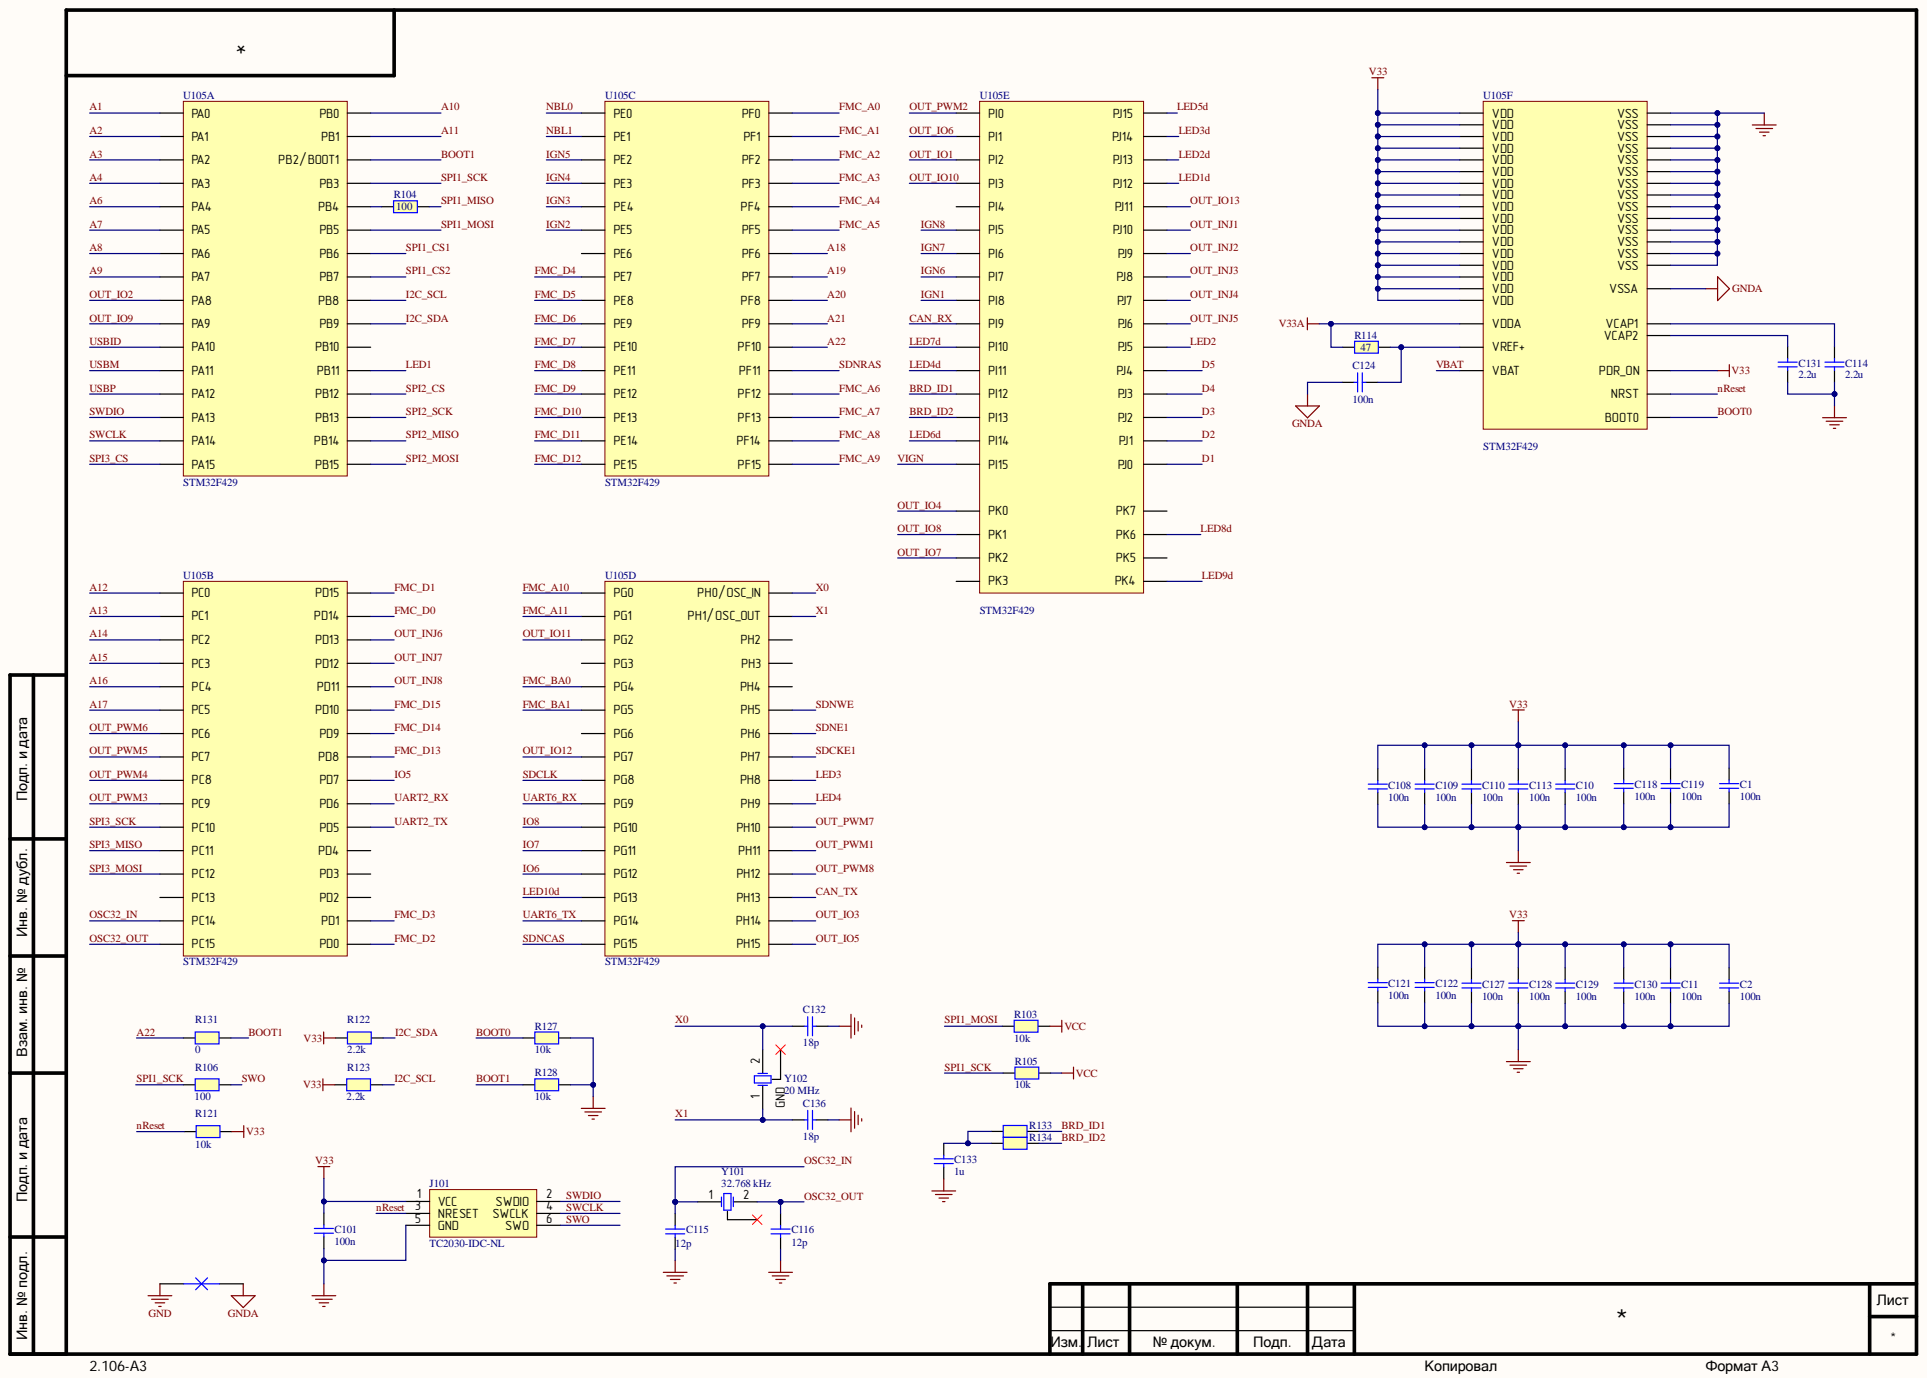
[picture p138: page 4]

Инв. № подл. Инв. № дубл. Подп. и дата Взам. инв. № Подп. и дата

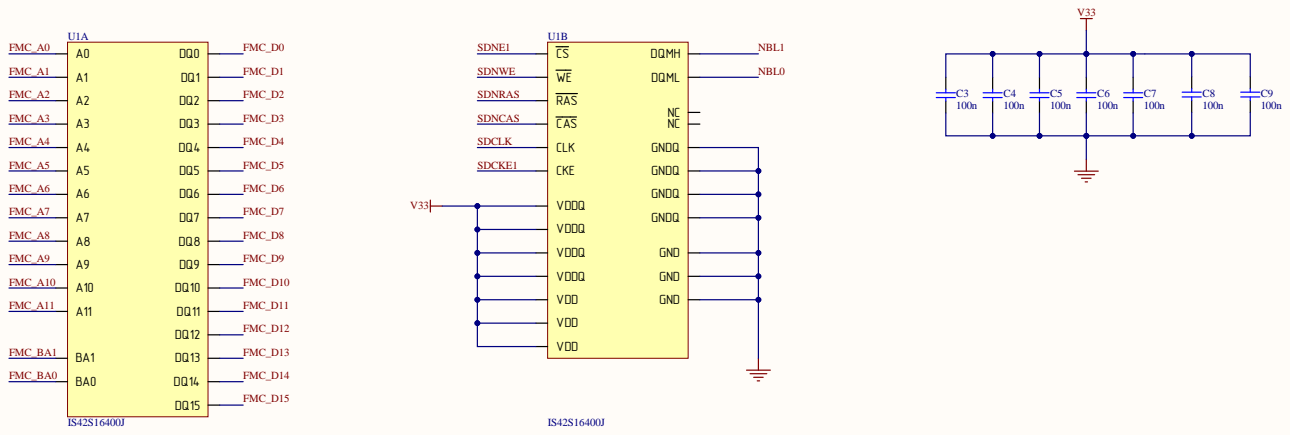
[picture p139: page 5]

Инв. № подл. Инв. № дубл. Подп. и дата Взам. инв. № Подп. и дата

* | Лист *

Изм | . Лист | П одп | ата

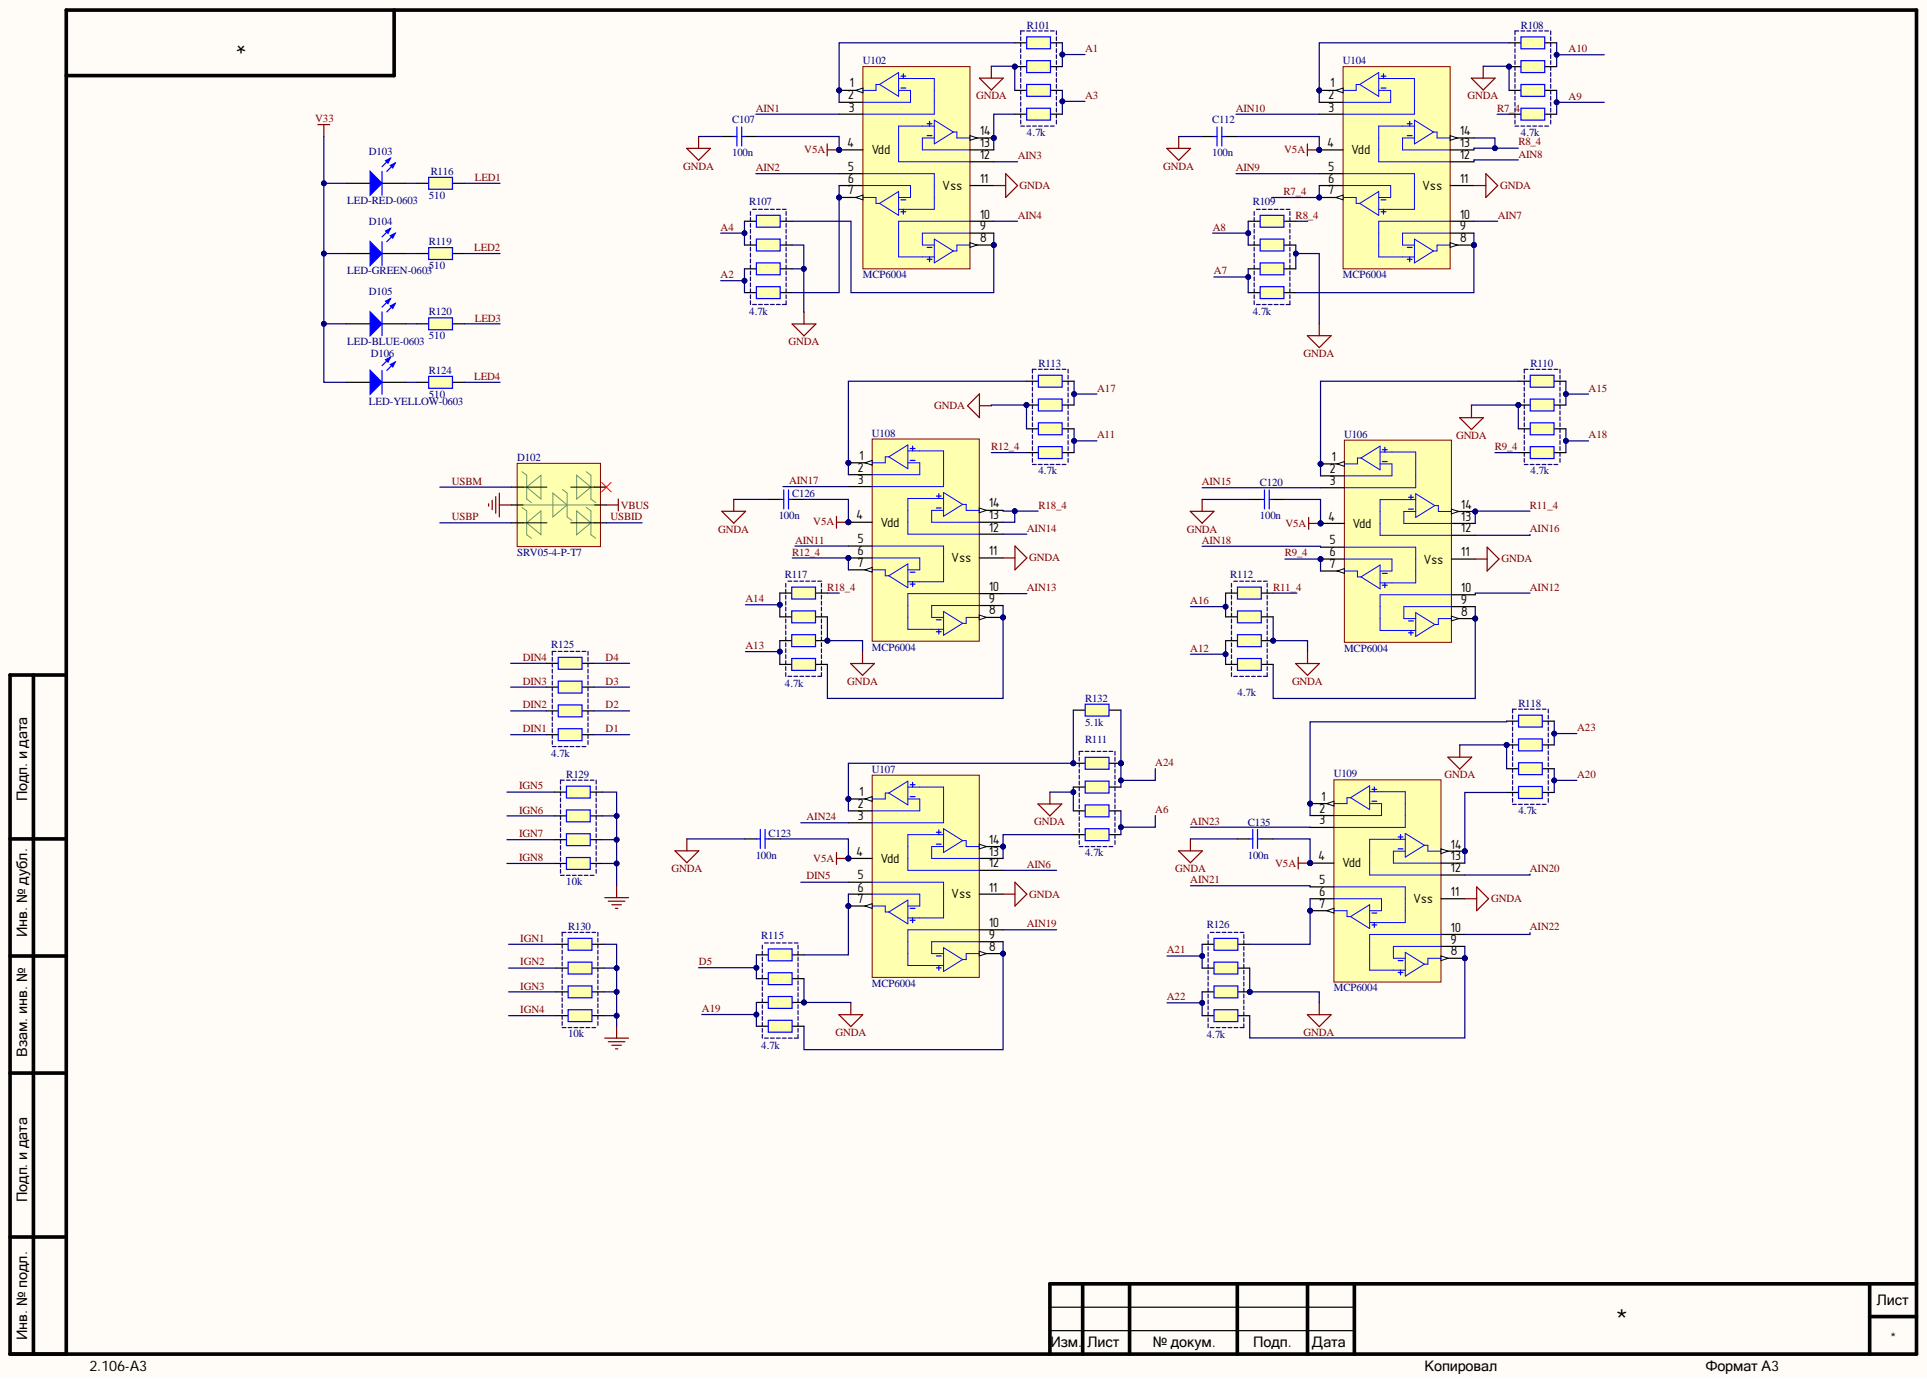
[picture p140: page 6]

Инв. № подл. Инв. № дубл. Подп. и дата Взам. инв. № Подп. и дата

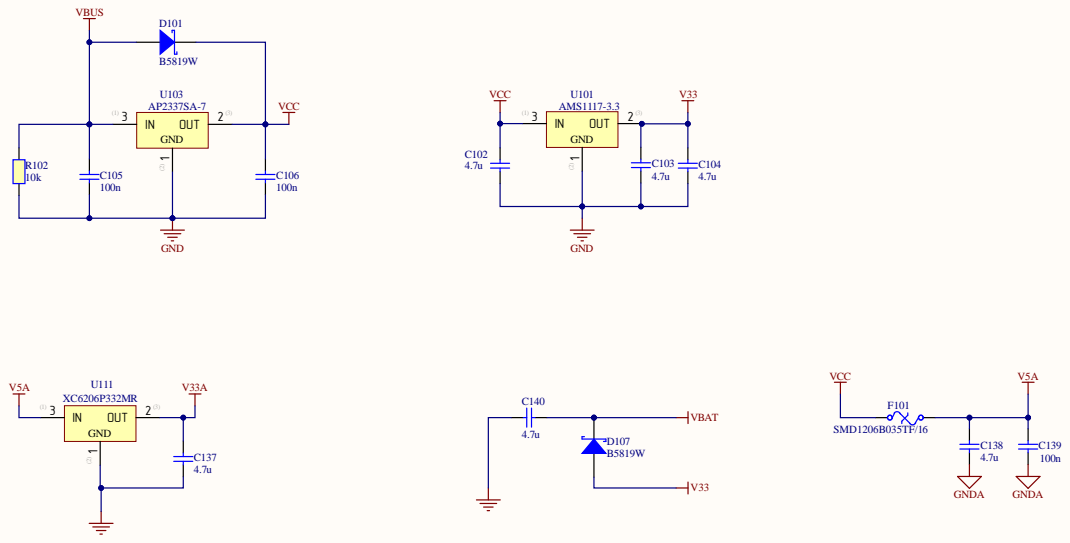
[picture p141: page 7]

Инв. № подл. Инв. № дубл. Подп. и дата Взам. инв. № Подп. и дата
