rusefi/rusefi-hardware/breakout-boards/Breakout-198-Mustang/ford-198-superseal-adapter-0.1.pdf

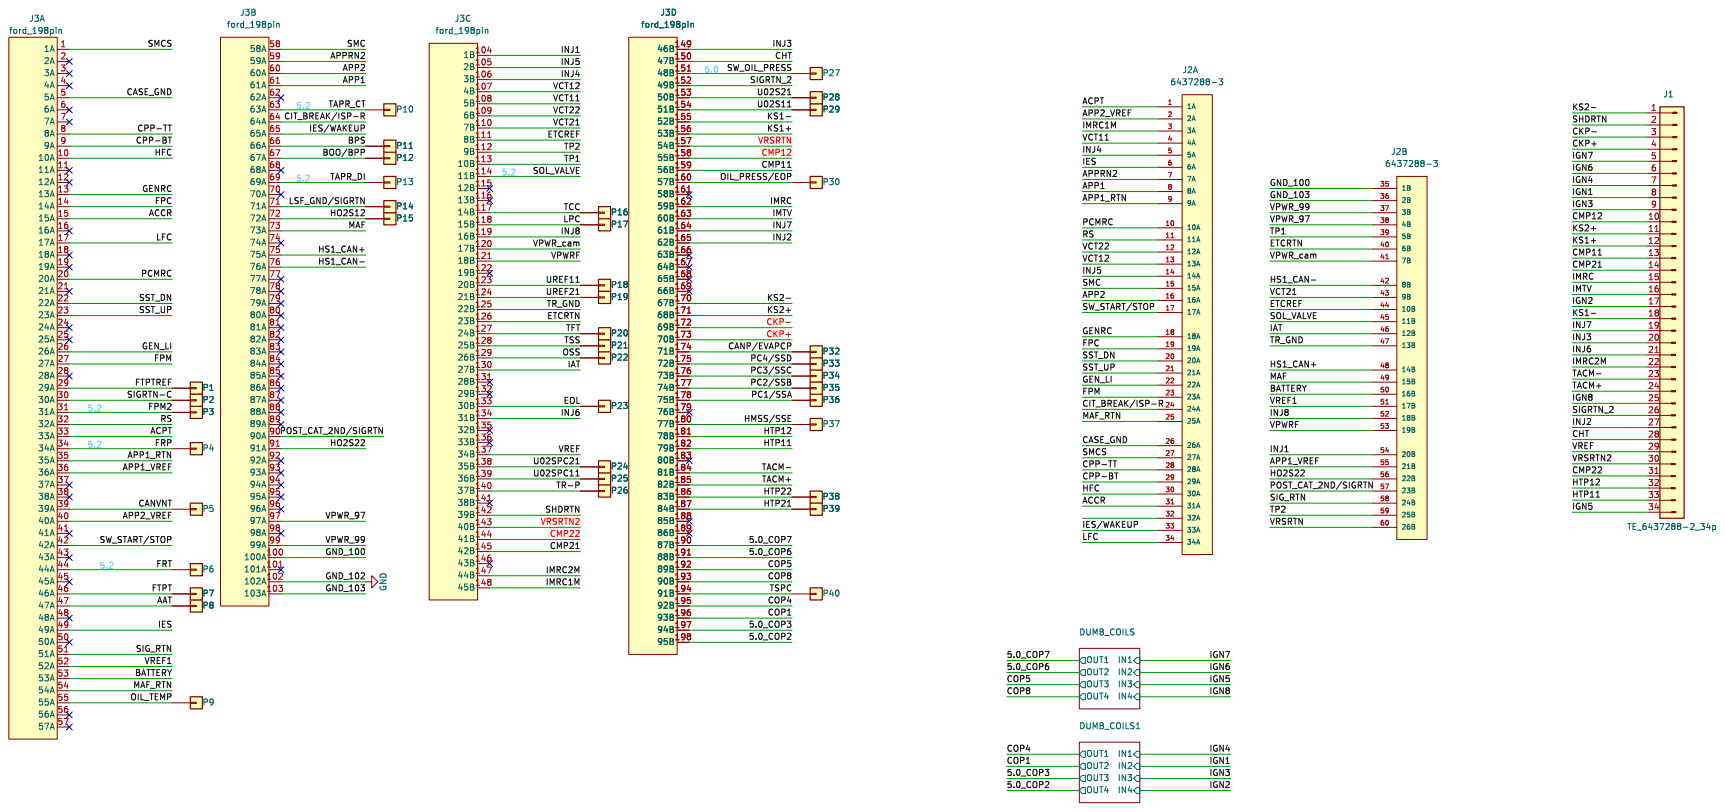
[picture p142: page 1]

IES/WAKEUP CPP-BT ETCREF VCT22 TP2 VCT21 TP1

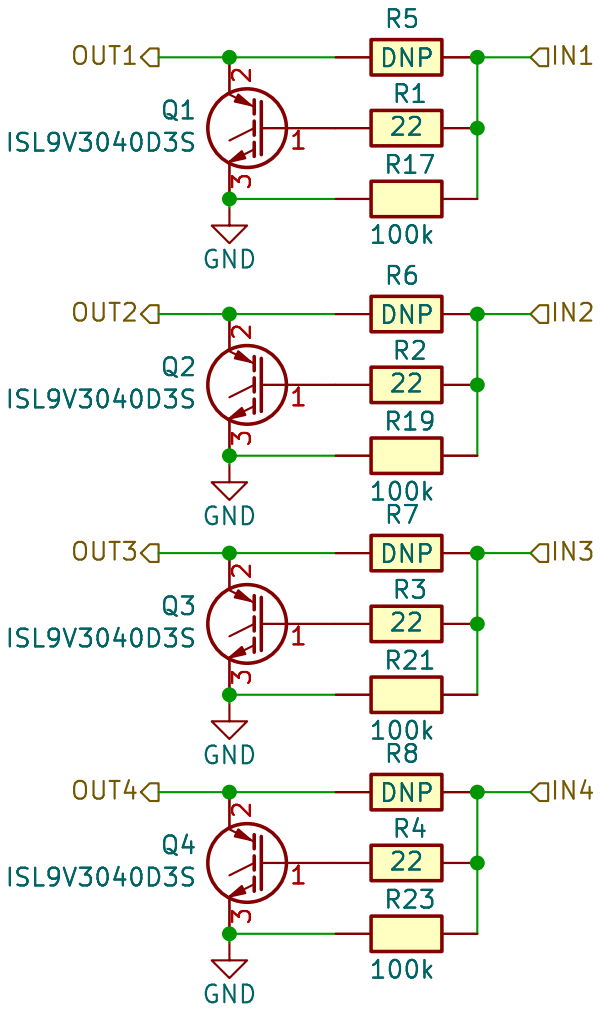
[picture p143: page 2]

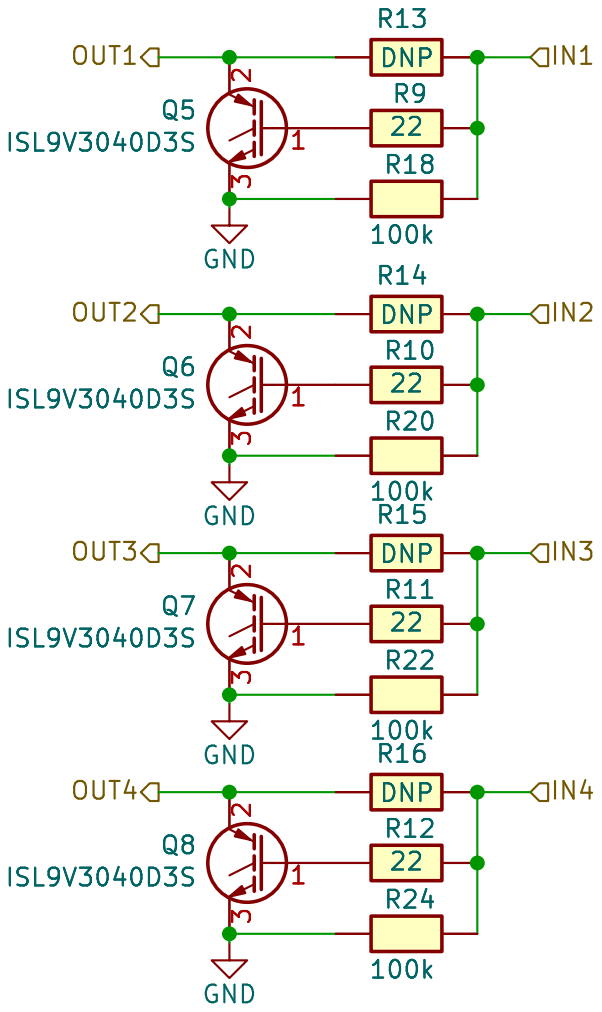
[picture p144: page 3]
