rusefi/rusefi-hardware/breakout-boards/Breakout_154_kia_pb/hellen-hyundai-pb-154-adapter-0.1.pdf

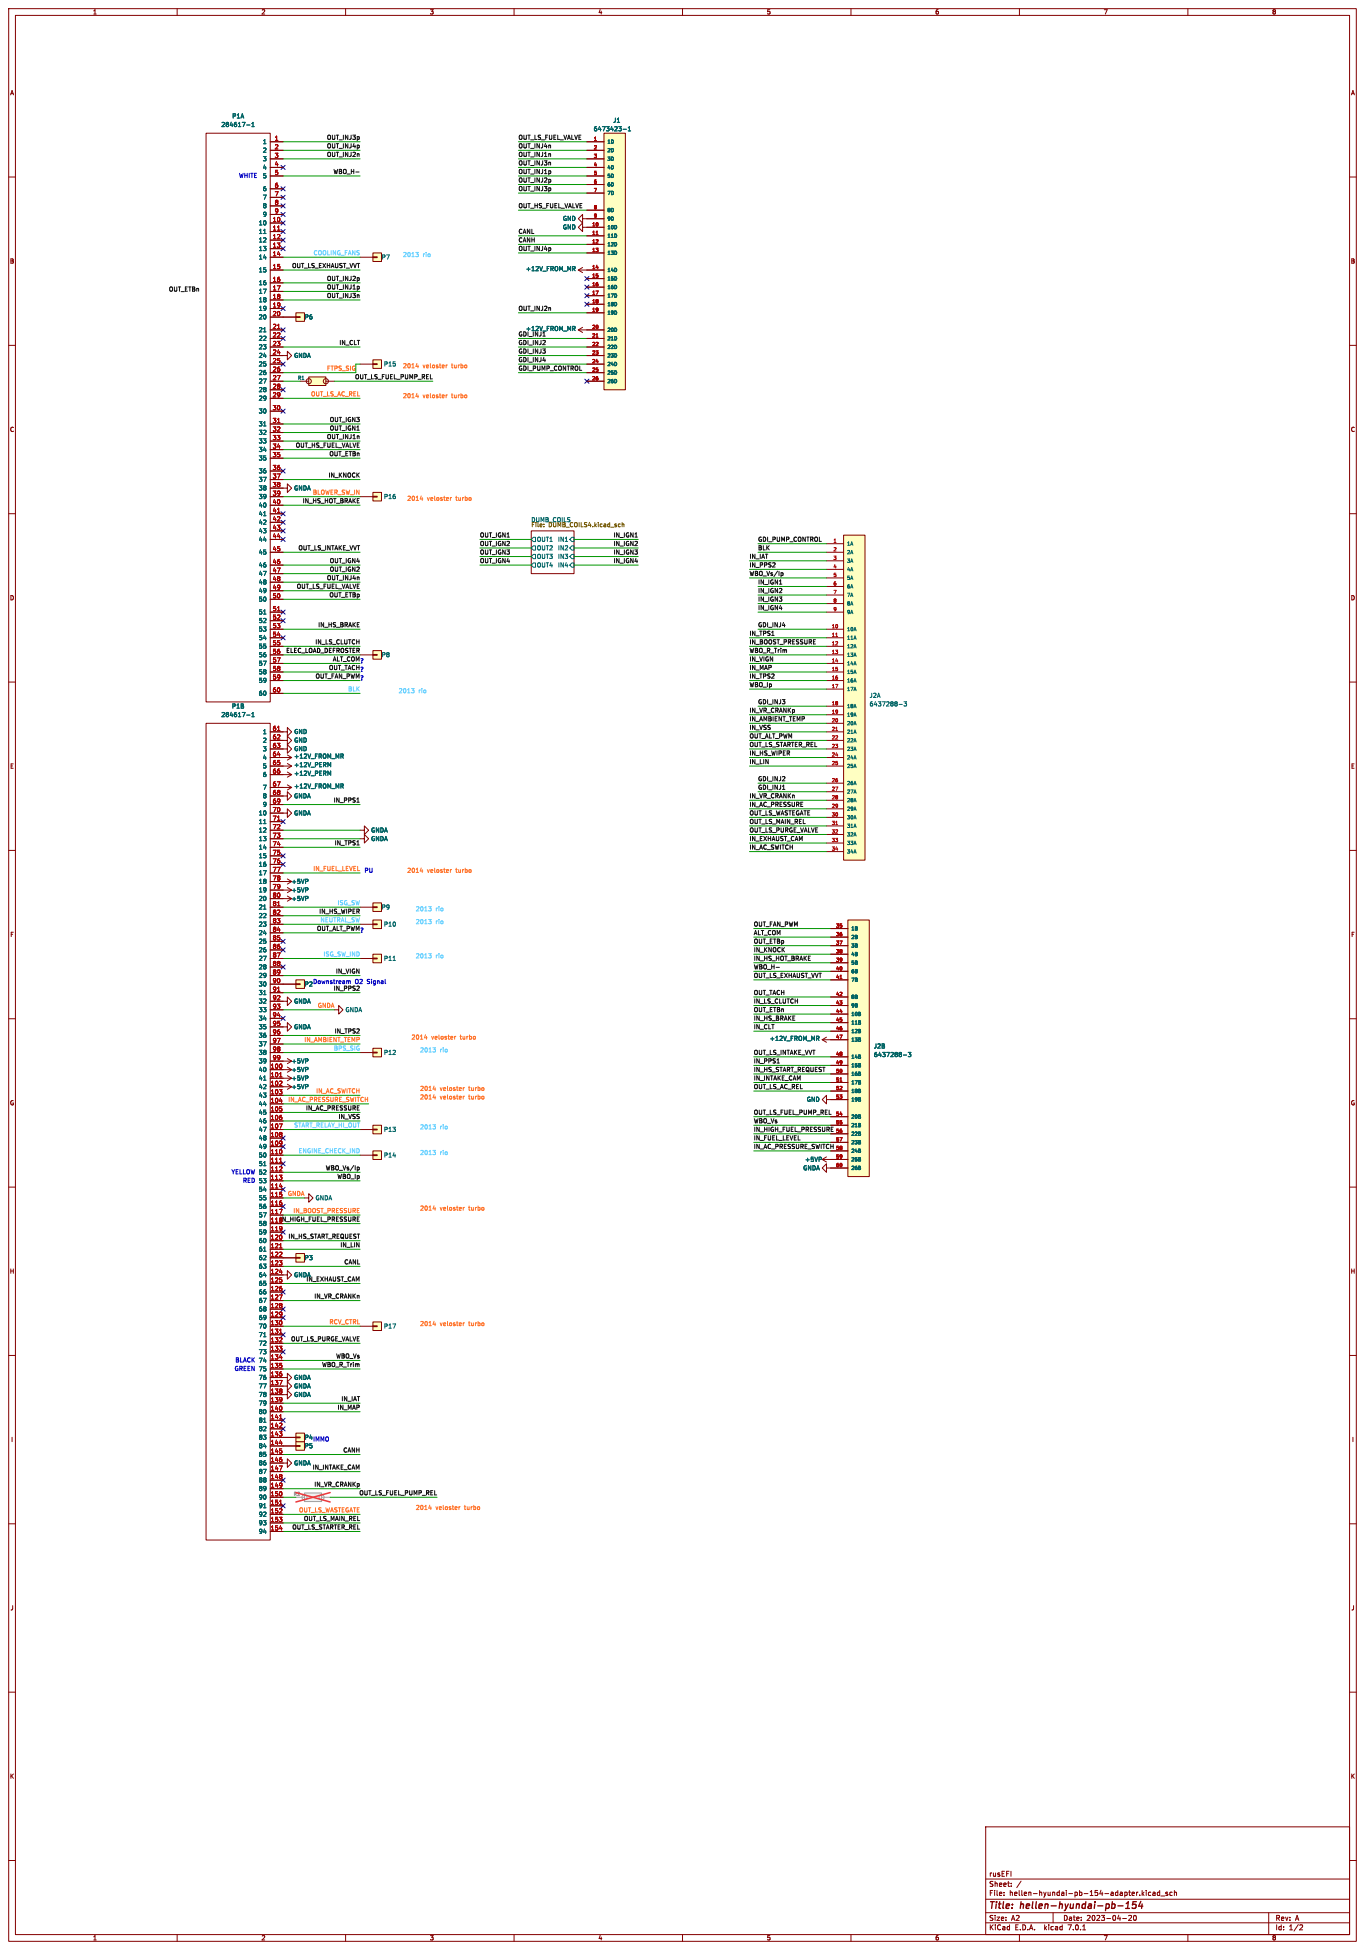
[picture p145: page 1]

Id: 1/2 Title: hellen-hyundai-pb-154

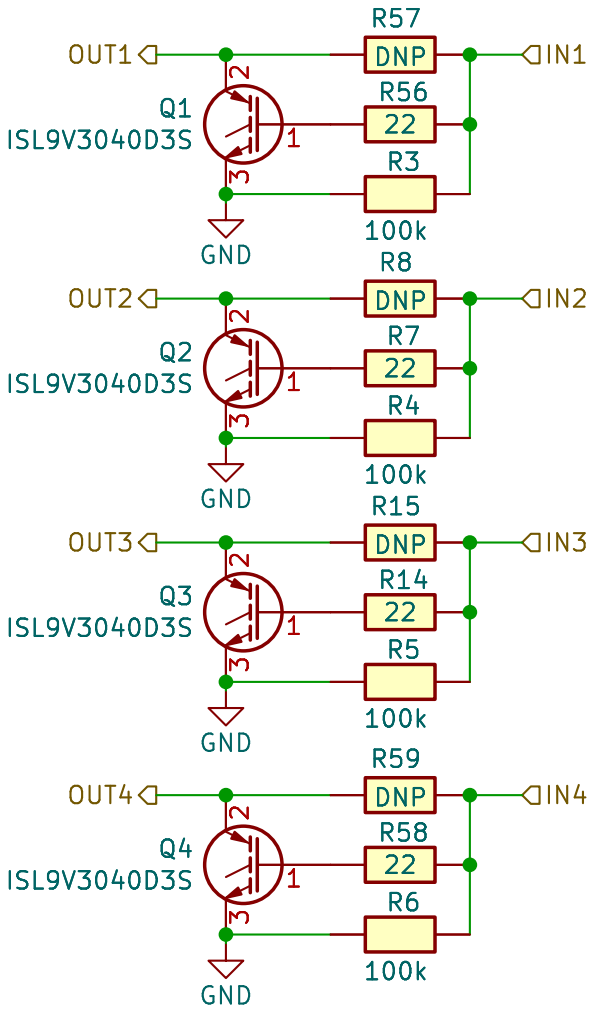
[picture p146: page 2]
