rusefi/rusefi-hardware/quad-igbt/export/quad-igbt.pdf

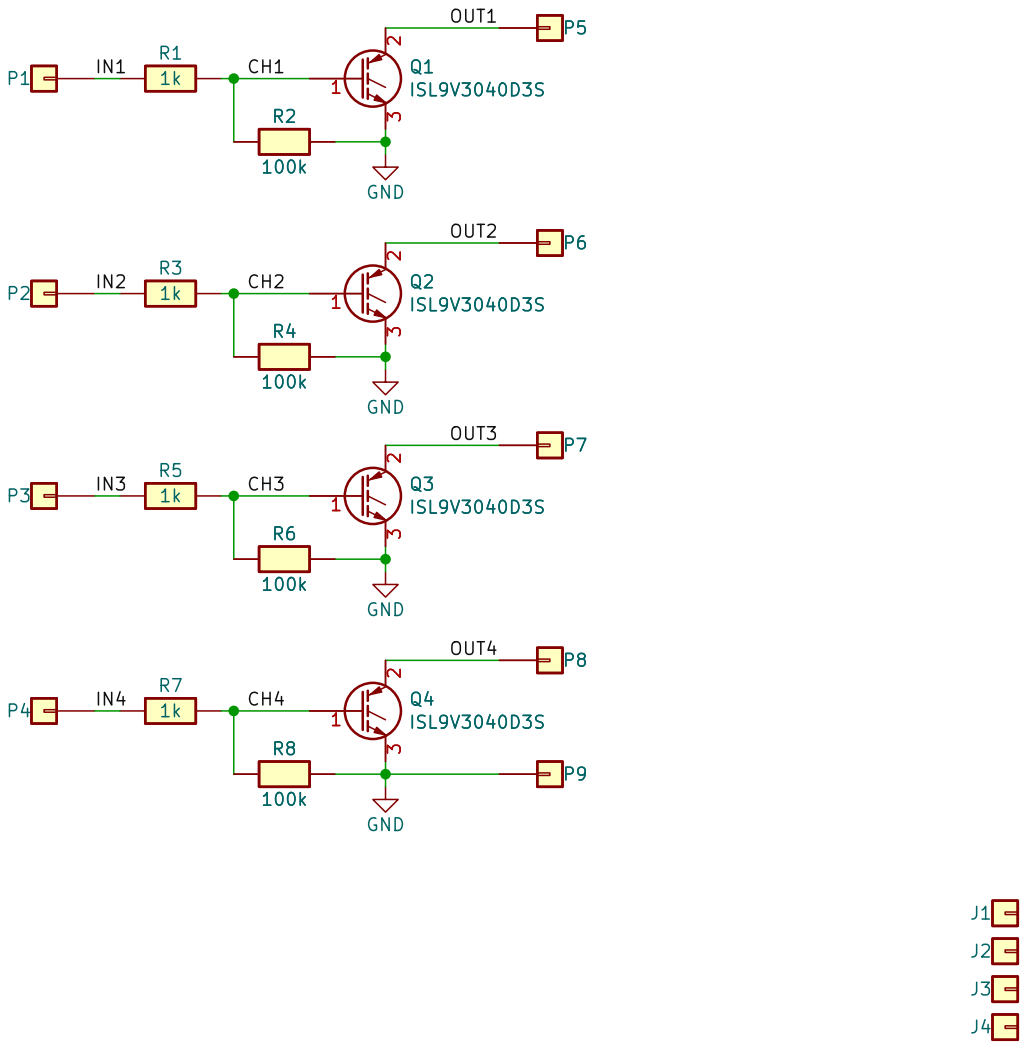
[picture p147: page 1]

Id: 1/1 Title: quad-igbt
