rusefi/rusefi-hardware/frequency-divider/gerber/frequency-divider.pdf

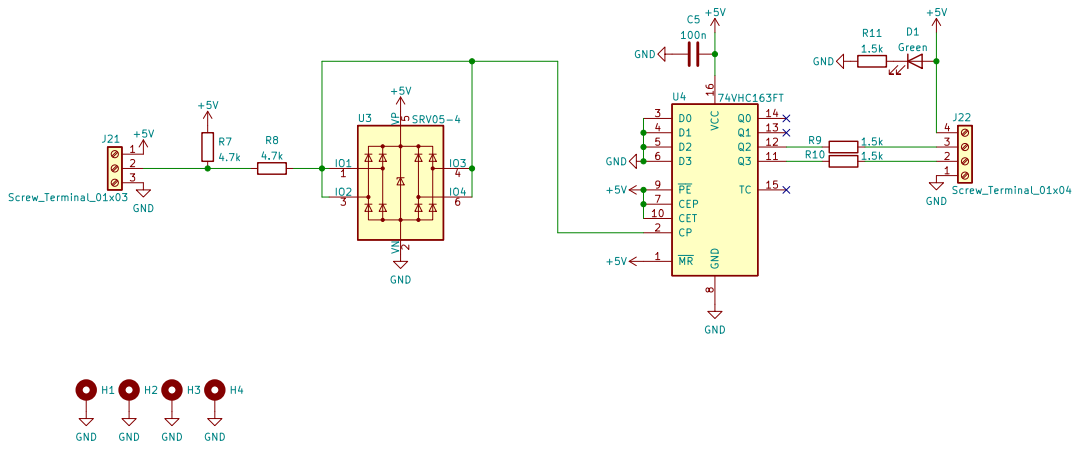
[picture p148: page 1]

Id: 1/1 Title: frequency-divider
