rusefi/rusefi-hardware/lambda-x2/export/rev1/lambda-x2-rev1.pdf

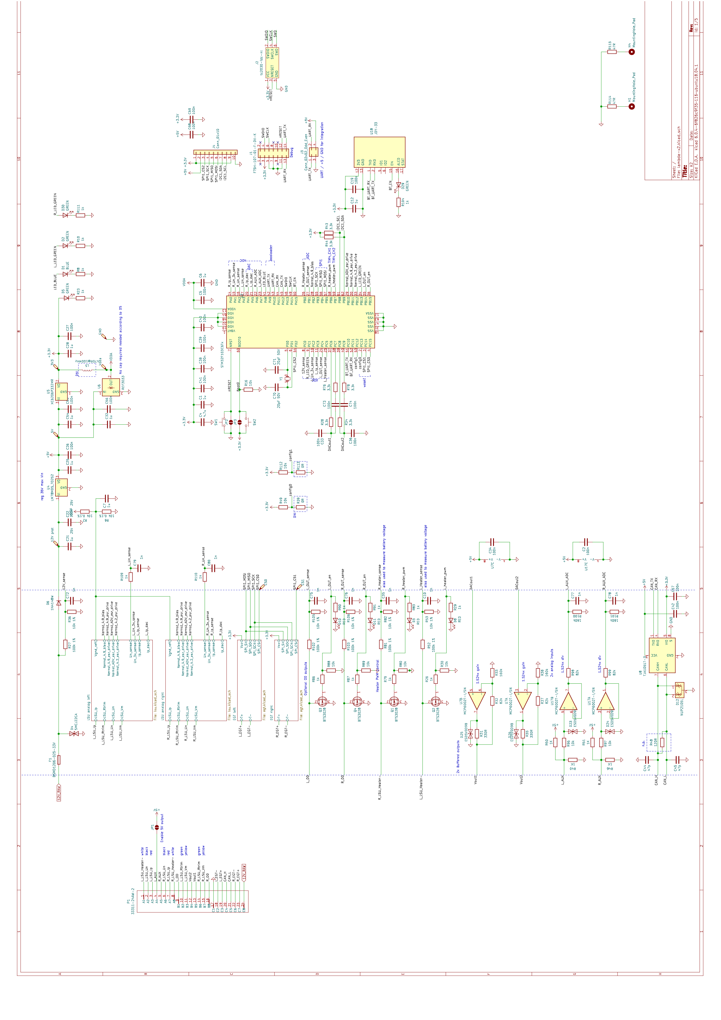
[picture p149: page 1]
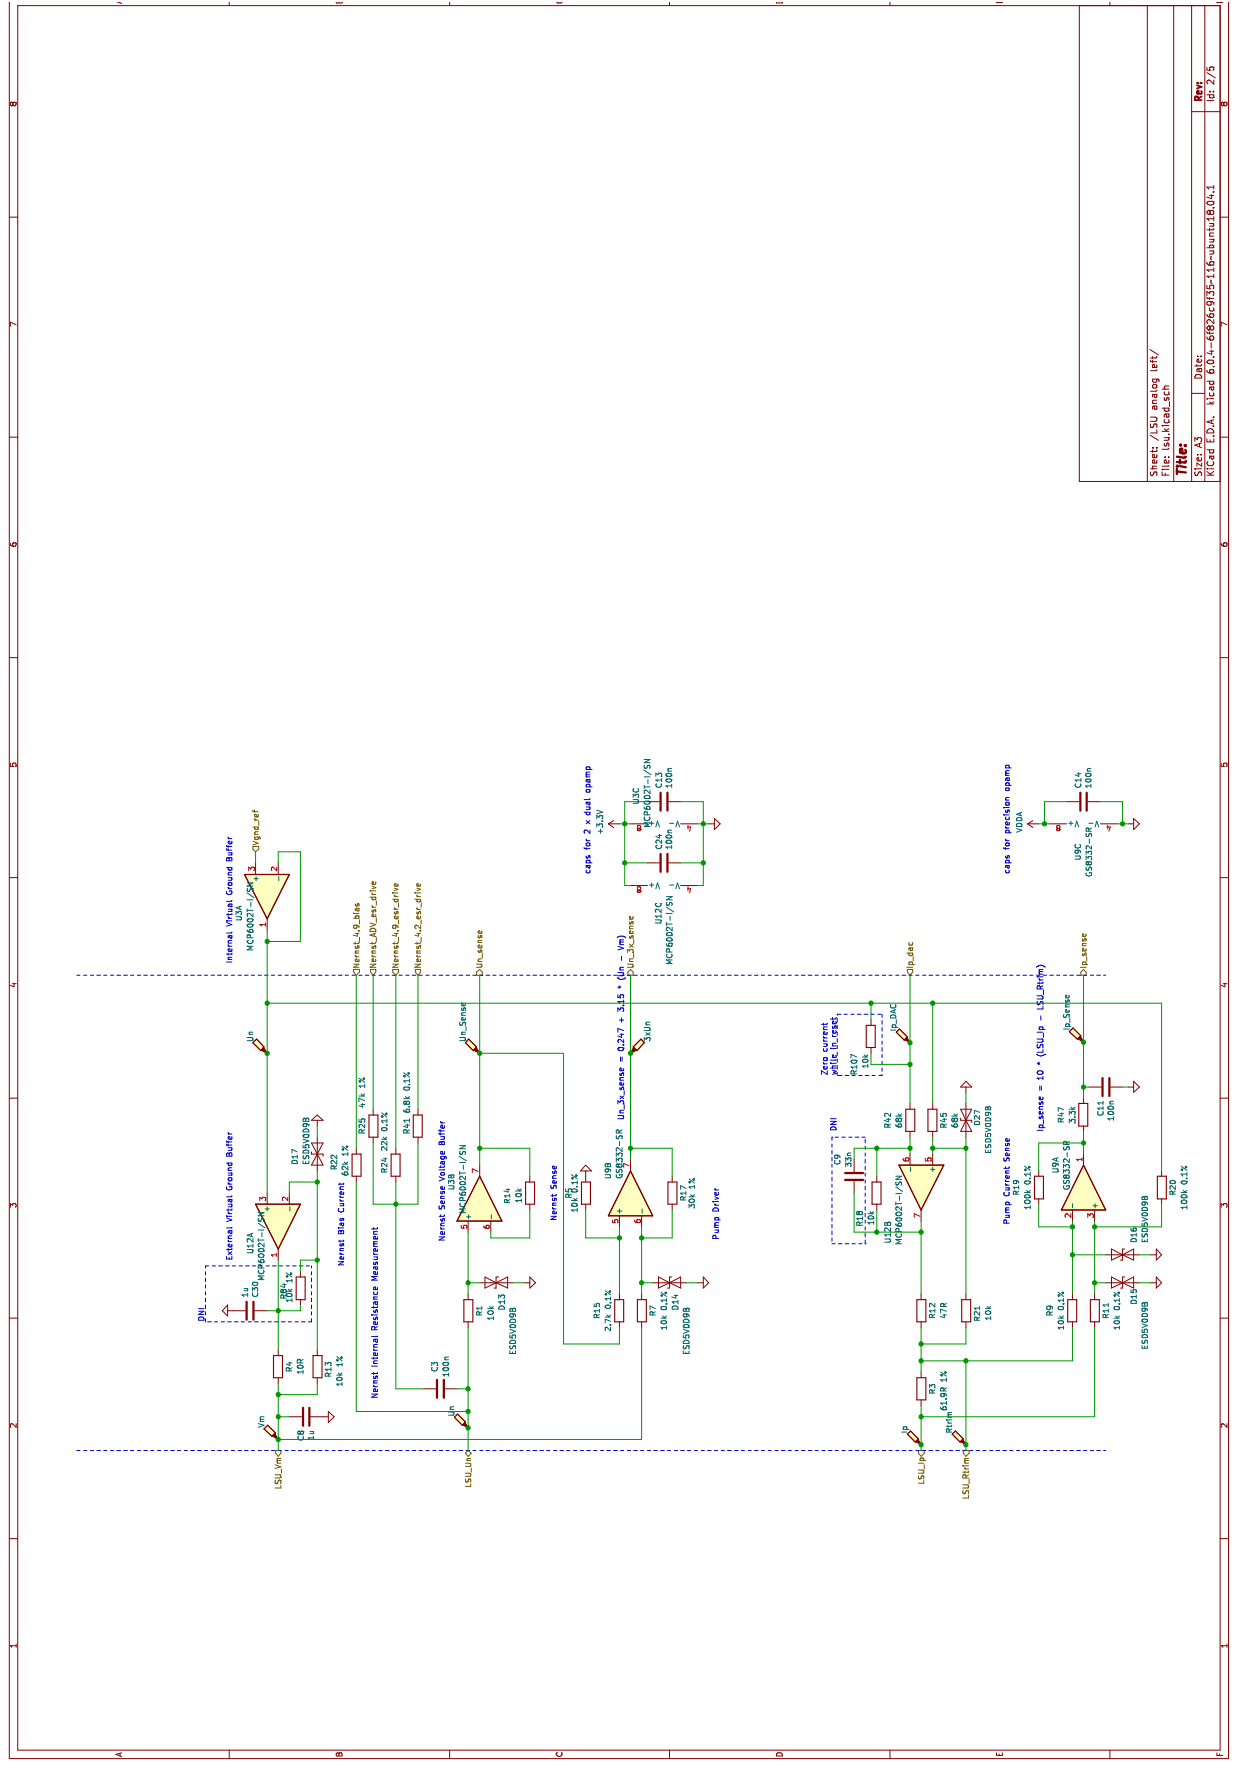
[picture p150: page 2]

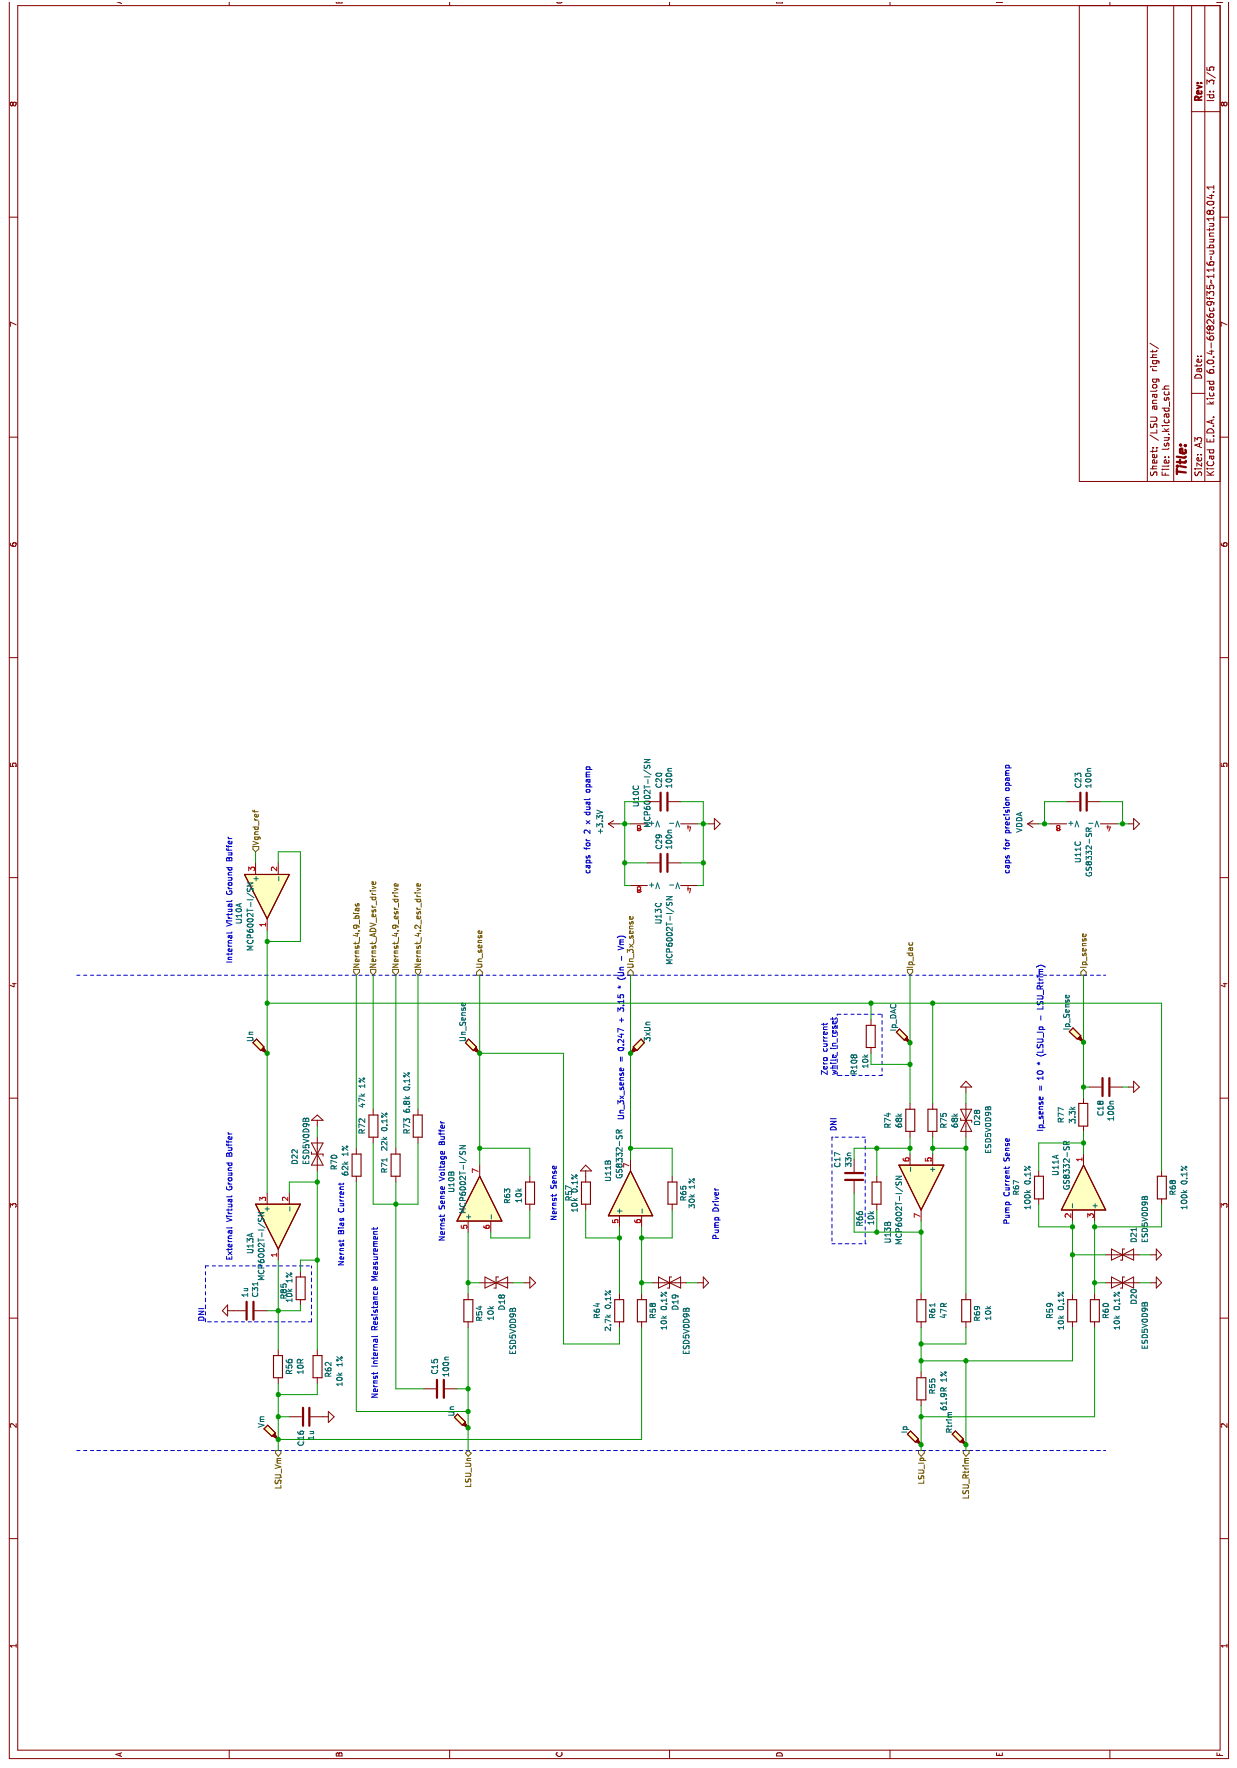
[picture p151: page 3]

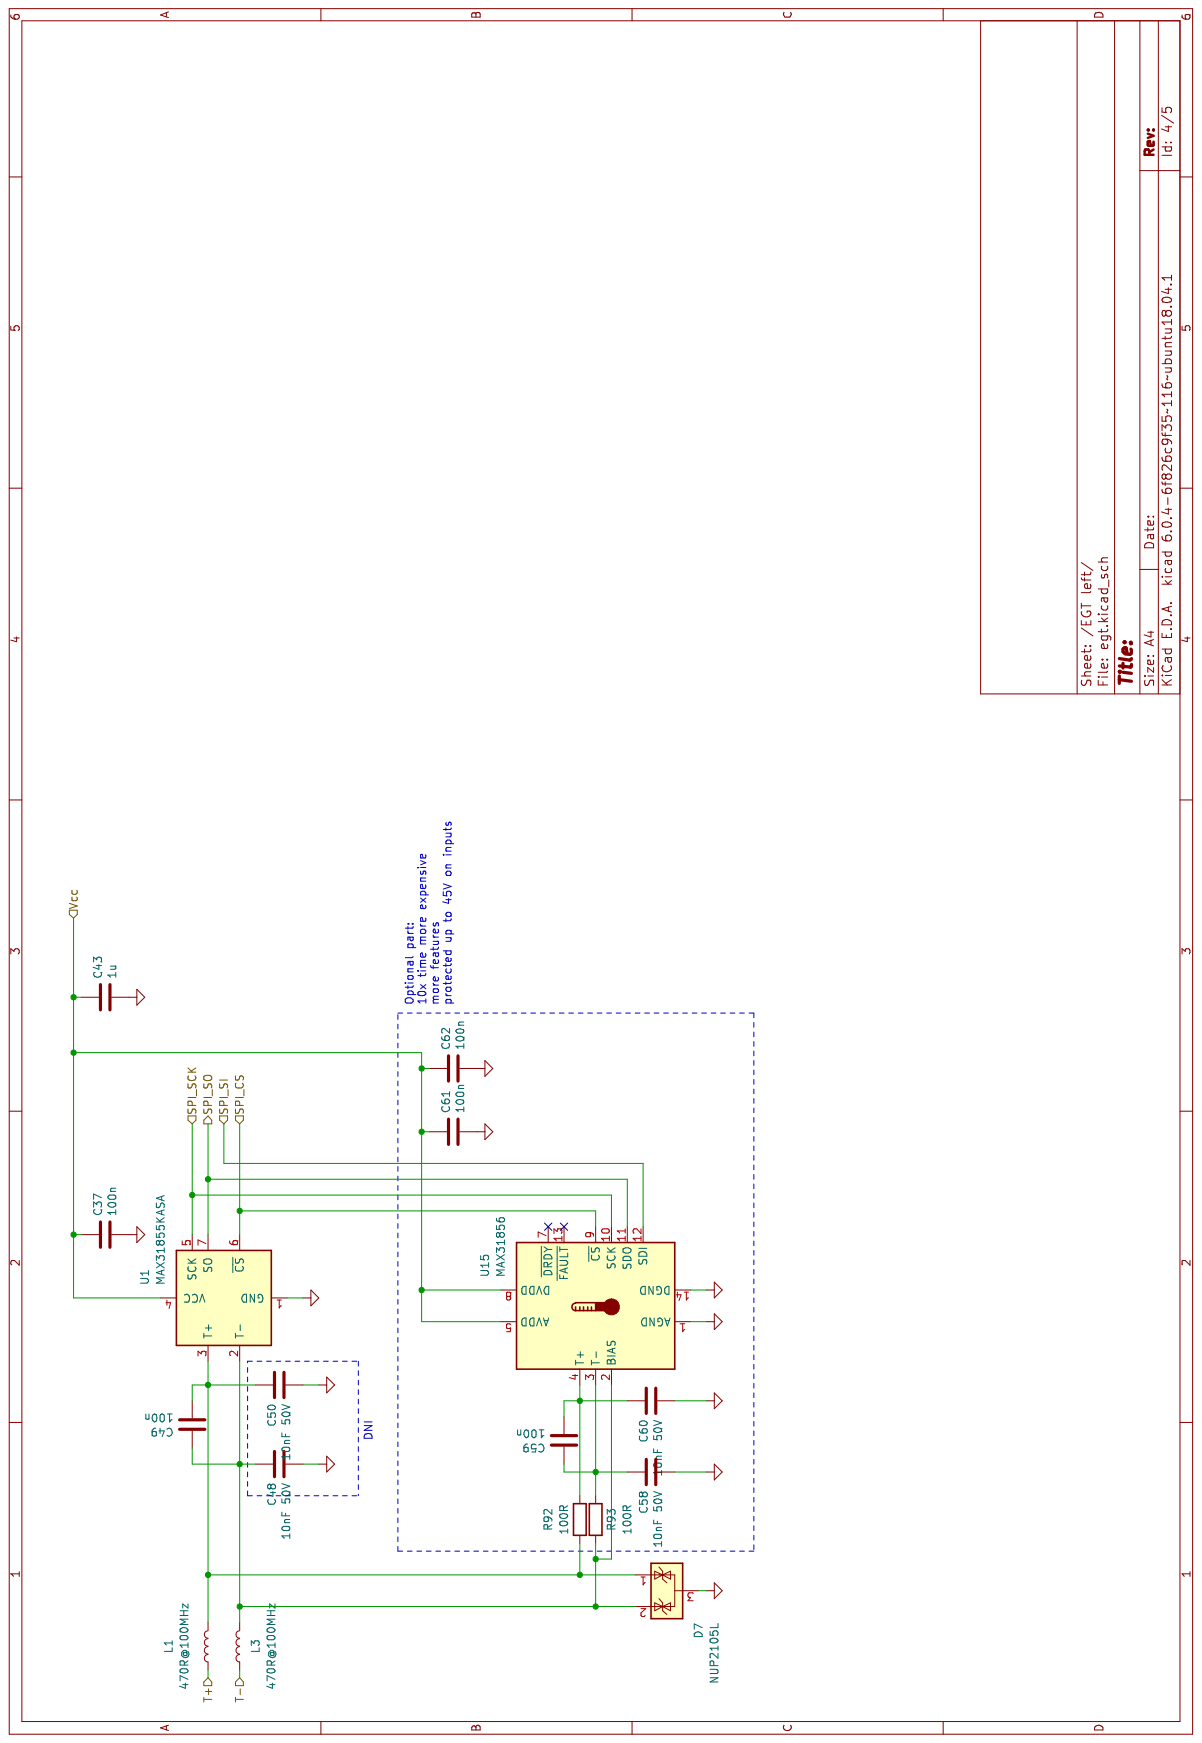
[picture p152: page 4]

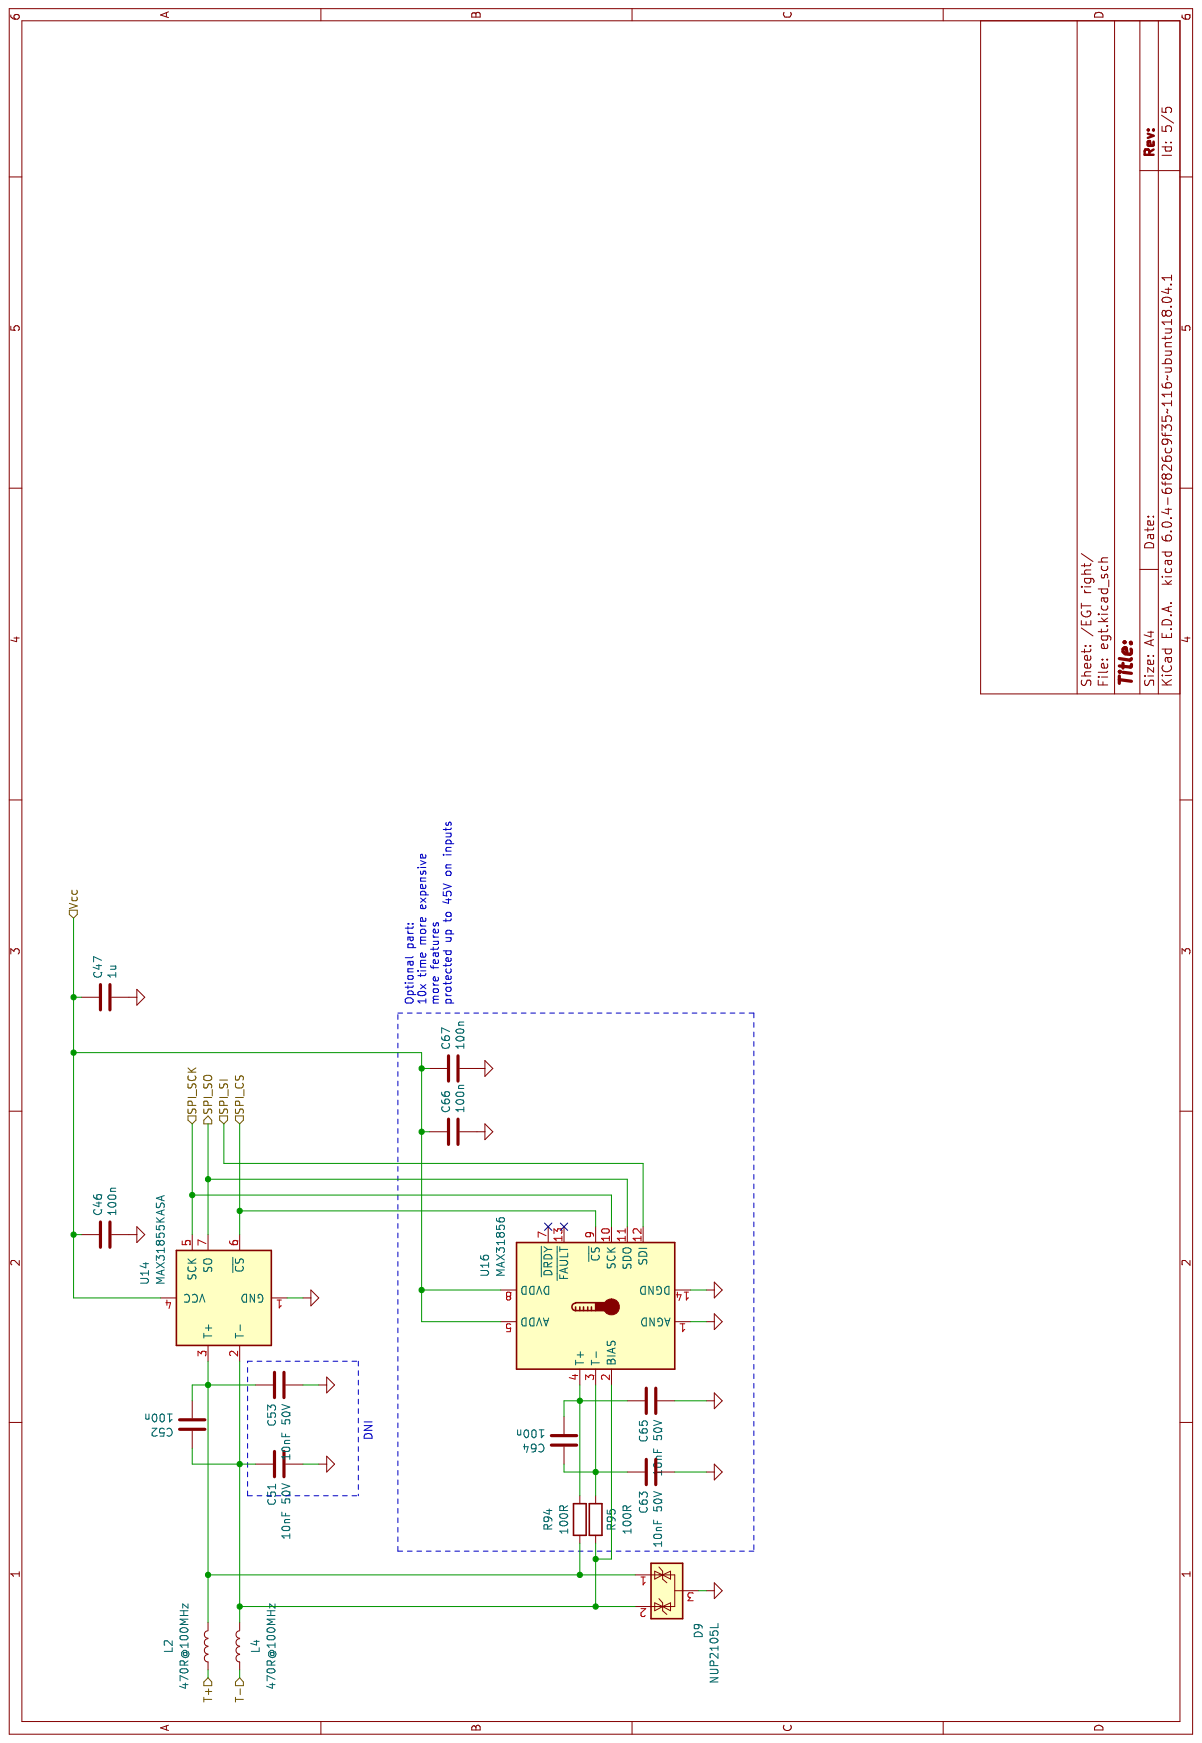
[picture p153: page 5]
