rusefi/rusefi-hardware/breakout-boards/Breakout-24pin/export/24pins_In_3conn.pdf

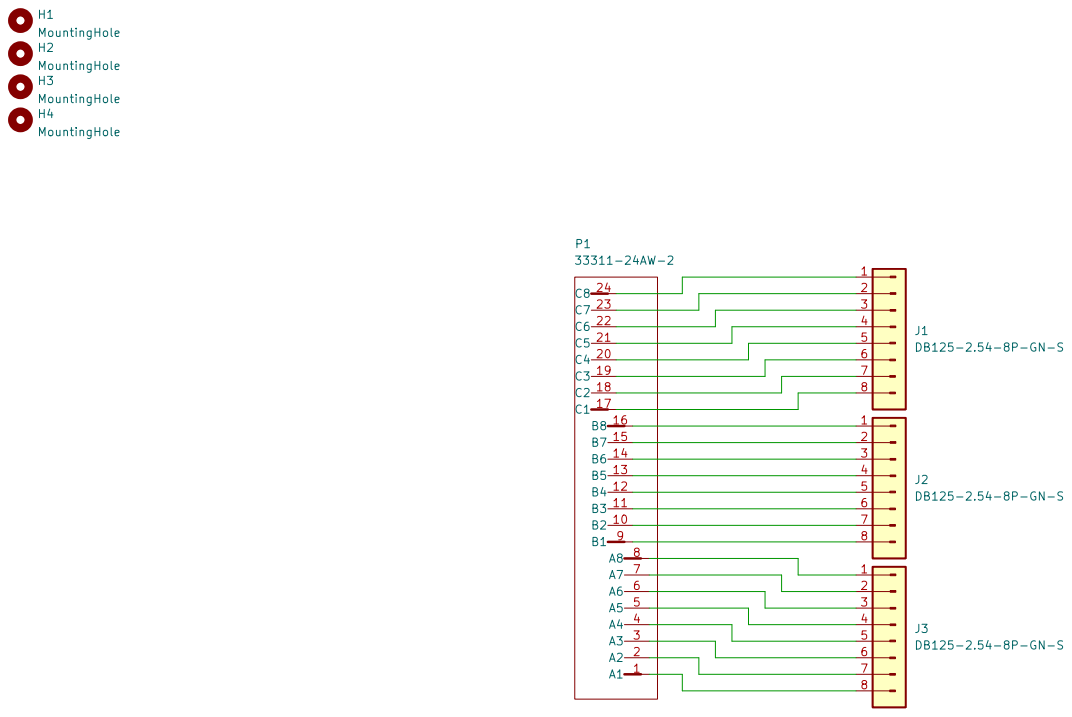
[picture p154: page 1]
