rusefi/rusefi-hardware/(list of files, drawings)

Other design files:
classic-designs/adc_amp_divider.vertical12/adc_amp_divider.dsn
