rusefi/rusefi-hardware/classic-designs/frankenstein/frankenstein_foundation.sch

## KiCad design classic-designs/rusefi_hardware_history/frankenstein_rev00.10/frankenstein_foundation.sch (2021-11-01, an earlier design)

Schematic: frankenstein_foundation.sch

Parts:
JP51, JP52, JP53: JUMPER
P51: CONN_4X2
P52: CONN_10X2
P53: CONN_2
P54: CONN_5X2
P55, P56, P57, P58: CONN_6
P610: CONN_1
P_VOID1, P_VOID2: CONN_6

Notes on the sheet:
The purpose of this VOID connector is to trick KiCad into assigning proper net name to the jumper pad which would not happen if the pad is unconnected
PC7
PC9
PD9
PB15
PB13
PB11
PE8
PE10
PE12
PE14
