rusefi/rusefi-hardware/classic-designs/rusefi_hardware_history/thermocouiple_module_rev00.10/thermocouiple_module/thermocouple_module.sch

## KiCad design classic-designs/rusefi_hardware_history/thermocouiple_module_rev00.10/thermocouiple_module/thermocouple_module.sch (2021-11-01)

Schematic: thermocouple_module.sch

Parts:
C8: 100nF; SM0805-SM0603
C21: 10nF; SM0805-SM0603
P1: CONN_2; tcpl_PCC-SMP
P2: CONN_1; SIL-1
P3: CONN_4; SIL-4
P4: CONN_2; SIL-2
U5: MAX31855KASA; SO8E; mfg# MAX31855KASA+
V801, V802: VIA; 1pin

Notes on the sheet:
We want a big mass of copper in the TCPL joints, to dampen the cold junction temperature and to make it more measurable with this IC
Via for cable tie
Care must be taken with the conector chosen for the TCPL to avoid inaccuracies. Also, the connector must be as close as possible to the cold-juntion compensation.
MAX31855 Cold-Junction Compensated Thermocouple-to-Digital Converter
Datasheet: http://datasheets.maxim-ic.com/en/ds/MAX31855.pdf
