rusefi/rusefi-hardware/GDI-STM/firmware/firmware.ioc

Mcu.UserName=STM32G474METx
PA0.Signal=ADC1_IN1
PA1.Signal=ADC1_IN2
PA11.Signal=FDCAN1_RX
PA12.Signal=FDCAN1_TX
PA13.Signal=SYS_JTMS-SWDIO
PA14.Signal=SYS_JTCK-SWCLK
PA2.Signal=OPAMP1_VOUT
PA3.Signal=ADC1_IN4
PA4.Signal=ADC2_IN17
PA5.Signal=OPAMP2_VINM
PA6.Signal=OPAMP2_VOUT
PA7.Signal=OPAMP1_VINP
PA8.Signal=OPAMP5_VOUT
PB0.Signal=OPAMP2_VINP
PB1.Signal=OPAMP3_VOUT
PB10.Signal=OPAMP4_VINM
PB11.Signal=OPAMP4_VINP
PB12.Signal=OPAMP4_VOUT
PB13.Signal=OPAMP3_VINP
PB14.Signal=ADC1_IN5
PB15.Signal=OPAMP5_VINM
PB2.Signal=OPAMP3_VINM
PC0.Signal=ADC1_IN6
PC1.Signal=ADC1_IN7
PC2.Signal=ADC1_IN8
PC3.Signal=OPAMP5_VINP
PC4.Signal=ADC2_IN5
PC5.Signal=OPAMP1_VINM
PE13.Signal=ADC3_IN3
PE7.Signal=ADC3_IN4
PE9.Signal=ADC3_IN2
PF0-OSC_IN.Signal=RCC_OSC_IN
PF1-OSC_OUT.Signal=RCC_OSC_OUT
