rusefi/rusefi-hardware/digital-inputs/firmware/main.cpp

/*
    ChibiOS - Copyright (C) 2006..2018 Giovanni Di Sirio

    Licensed under the Apache License, Version 2.0 (the "License");
    you may not use this file except in compliance with the License.
    You may obtain a copy of the License at

        http://www.apache.org/licenses/LICENSE-2.0

    Unless required by applicable law or agreed to in writing, software
    distributed under the License is distributed on an "AS IS" BASIS,
    WITHOUT WARRANTIES OR CONDITIONS OF ANY KIND, either express or implied.
    See the License for the specific language governing permissions and
    limitations under the License.
*/

/**
 * big picture:
 * For each test pad we can do pull-up, pull-down and floating state (by turning mux off)
 * each of those tests should be executed twice:
 * first time while external device informs us that logic level is ON
 * second time while external device informs us that logic level is OFF
 */

#include "global.h"
#include "usbconsole.h"
#include "usbcfg.h"
#include "test_digital_inputs.h"
#include "test_digital_outputs.h"
#include "adc.h"
#include "test_logic.h"
#include "efilib.h"
#include "can.h"
#include "terminal_util.h"

#define VERSION 20241018

BaseSequentialStream *chp = getNonBlockingConsole();

OutputMode outputMode;
bool isMuted = false;
static int totalGood = 0, totalBad = 0;

/*
 * This is a periodic thread that does absolutely nothing except flashing
 * a LED.
 */
static THD_WORKING_AREA(waThread1, THREAD_STACK);
static THD_FUNCTION(Thread1, arg) {

  (void)arg;
  chRegSetThreadName("blinker");
  while (true) {

//    palSetLine(LINE_LED1);
//    chThdSleepMilliseconds(50);

    palSetLine(LED_BLUE);
    chThdSleepMilliseconds(50);

//    palSetLine(LINE_LED3);
//    chThdSleepMilliseconds(200);

//    palClearLine(LINE_LED1);
//    chThdSleepMilliseconds(50);
    palClearLine(LED_BLUE);
    chThdSleepMilliseconds(50);
//    palClearLine(LINE_LED3);
//    chThdSleepMilliseconds(200);
  }
}

bool globalEverythingHappy;
int totalErrorsCounter;
extern int numSecondsSinceReset;

static void setErrorLed() {
	palClearLine(LED_GREEN);
	palSetLine(LED_RED);
}

void setErrorLedAndRedText() {
    setErrorLed();
    setRedText();
}

static THD_WORKING_AREA(consoleThread, THREAD_STACK);
static void ConsoleThread(void*) {
	static int executionCounter = 0;

    // useful for when we only want to power the board with +12v but not send out any test requests
    bool listenMode = palReadLine(LINE_BUTTON);

    chprintf(chp, "Let's give it time to receive meta data\r\n");
    chThdSleepMilliseconds(1000);

	while (true) {
        if (listenMode) {
            chThdSleepMilliseconds(500);
		    setGreenText();
            chprintf(chp, "Listen mode\r\n");
			setNormalText();
            continue;
        }

	    globalEverythingHappy = true;
	    startNewCanTest();

        int currentIndex = 0;
#if 1
		bool isGoodDigitalOutputs = testEcuDigitalOutputs(currentIndex);
		currentIndex += getDigitalOutputStepsCount();
#else
        bool isGoodDigitalOutputs = true;
#endif

#if 1
		stimulateEcuDigitalInputs(currentIndex);
		bool isHappyDigitalInputCounterStatus = checkDigitalInputCounterStatus();
#else
        bool isHappyDigitalInputCounterStatus = true;
#endif

#if 1
		bool isHappyDcOutputs = testEcuDcOutputs(currentIndex);
#else
        bool isHappyDcOutputs = true;
#endif

		currentIndex += getDigitalDcOutputStepsCount();

		bool isHappyUptime = numSecondsSinceReset > 10;
		if (!isHappyUptime) {
		    setErrorLedAndRedText();
		    chprintf(chp, "uptime is too low uptime=%d\r\n", numSecondsSinceReset);
			setNormalText();
		}
		bool isAllGood = isGoodDigitalOutputs
		    && isHappyCanTest()
		    && isHappyUptime
		    && isHappyDcOutputs
		    && isHappyDigitalInputCounterStatus;

		executionCounter++;

		chprintf(chp, " *********************************************** version=%d\r\n", VERSION);
		if (isAllGood) {
		    setGreenText();
		    totalGood++;
			chprintf(chp, " *********************************************** count=%d\r\n", executionCounter);
			chprintf(chp, " ************* ALL GOOD ************************ uptime=%d\r\n", numSecondsSinceReset);
			chprintf(chp, " *********************************************** error rate: %d of %d \r\n", totalBad, totalGood);
			setNormalText();
			palSetLine(LED_GREEN);
			palClearLine(LED_RED);
			isMuted = true;
		    chThdSleepMilliseconds(5000);
			isMuted = false;
		} else {
		    setErrorLedAndRedText();
		    totalBad++;
			chprintf(chp, " ************* SOMETHING BAD SEE ABOVE ERRORS=%d ************************ count=%d\r\n", totalErrorsCounter, executionCounter);
			chprintf(chp, " ************************************************************** uptime=%d\r\n", numSecondsSinceReset);
			setNormalText();
			isMuted = true;
    		chThdSleepMilliseconds(5000);
			isMuted = false;
		}
	}
}

/*
 * Application entry point.
 */
int main(void) {

  /*
   * System initializations.
   * - HAL initialization, this also initializes the configured device drivers
   *   and performs the board-specific initializations.
   * - Kernel initialization, the main() function becomes a thread and the
   *   RTOS is active.
   */
  halInit();
  chSysInit();

  initAnalogInputs();
  initCan();
  initStimDigitalInputs();
  initStimDigitalOutputs();
  usb_serial_start();

  /*
   * Creates the example thread.
   */
  chThdCreateStatic(waThread1, sizeof(waThread1), NORMALPRIO + 1, Thread1, NULL);

  chThdCreateStatic(consoleThread, sizeof(consoleThread), NORMALPRIO, ConsoleThread, nullptr);

  while (true) {
    chThdSleepMilliseconds(500);
    // we need to wake some boards up!
	setOutputCountRequest();
  }
}
