rusefi/rusefi-hardware/GDI-4ch/firmware/efifeatures.h

/**
 * @file efifeatures.h
 *
 * @brief In this header we can configure which firmware modules are used.
 */

#pragma once

#ifndef EFI_PT2001_CHIPS
	#define EFI_PT2001_CHIPS	1
#endif

#ifndef EFI_BOARD_E92
	#define EFI_BOARD_E92		1
#endif
