rusefi/rusefi-hardware/GDI-4ch/firmware/fault.cpp

#include "fault.h"

static Fault currentFault = Fault::None;

bool HasFault()
{
    return currentFault != Fault::None;
}

Fault GetCurrentFault()
{
    return currentFault;
}

void SetCurrentFault(Fault fault) {
    currentFault = fault;
}
