rusefi/rusefi-hardware/digital-inputs/firmware/test_logic.h

// test_logic.h

#pragma once

#include <cstdint>
#include "cstring"

#define MAX_ANALOG_CHANNELS 32
#define MAX_BOARD_REVS 32
#define MAX_OUTPUT_NAMES 64
#define index2human(x) ((x) + 1)
#define CAN_FRAME_SIZE 8
/**
 * we use 16 channel chips on the board
 */
#define DIGITAL_INPUT_BANK_SIZE 16

bool testEcuDigitalOutput(int testLineIndex, bool isLowSide);
bool testEcuDigitalOutput2(int testLineIndex, size_t ecuLineIndex, bool isLowSide);
bool testDcOutput(size_t dcIndex);

class Counter {
public:
	int canFrameIndex;
	const char *name;
	bool seenTwoDifferentNonZeroValue = false;
	int firstNonZeroValue = 0;
	bool isHappy() const;
	void applyNewValue(int value);
};

#define EVENT_ENUM_SIZE 7
#define BUTTON_ENUM_SIZE 3
#define AUX_DIGITAL_SIZE 8

class CounterStatus {
public:
	Counter eventCounters[EVENT_ENUM_SIZE] = {
		{ 0, "Primary Trigger" },
		{ 1, "Secondary Trigger" },
		{ 2, "VVT1 Sensor" },
		{ 3, "VVT2 Sensor" },
		{ 4, "VVT3 Sensor" },
		{ 5, "VVT4 Sensor" },
		{ 6, "VSS" },					
	};

	Counter buttonCounters[BUTTON_ENUM_SIZE] = {
		{ 0, "BrakePedal" },
		{ 1, "ClutchUp" },
		{ 2, "AcButton" },
	};

	Counter auxDigitalCounters[AUX_DIGITAL_SIZE] = {
		{ 0, "Aux 1" },
		{ 1, "Aux 2" },
		{ 2, "Aux 3" },
		{ 3, "Aux 4" },
		{ 4, "Aux 5" },
		{ 5, "Aux 6" },
		{ 6, "Aux 7" },
		{ 7, "Aux 8" },
	};

};

class AnalogChannelConfig {
public:
	const char *name;
	float mulCoef;	// equal to 'dividerCoef' from the firmware
	float acceptMin, acceptMax;
};

class BoardConfig {
public:
	const char *boardName;
	int desiredEngineConfig;
	uint16_t boardIds[MAX_BOARD_REVS];
	AnalogChannelConfig channels[MAX_ANALOG_CHANNELS];
	bool eventExpected[EVENT_ENUM_SIZE];
	bool buttonExpected[BUTTON_ENUM_SIZE];
	bool auxDigitalExpected[AUX_DIGITAL_SIZE];
	const char *outputNames[MAX_OUTPUT_NAMES];
	int wboUnitsCount;
    // do we have some defect in the logic or loose state? does DC validation depend on if we have just finished testing low-side or high-side pins?
	int dcHackValue;
	int highSideStartingIndex;
	int wboStartIndex;

	const char *getOutputName(size_t index) {
	    // output count comes from the ECU over CAN and can exceed our name table
	    if (index >= MAX_OUTPUT_NAMES) {
	        return nullptr;
	    }
	    return outputNames[index];
//	    for (size_t i = 0;i<MAX_OUTPUT_NAMES;i++) {
//	        if (outputNames[i] == nullptr) {
//	            return nullptr;
//	        }
//	        if (i == index)
//	    }
//        return nullptr;

	}
};

BoardConfig *getBoardConfigs();
size_t getBoardsCount();

extern BoardConfig *currentBoard;
extern int16_t currentBoardRev;

size_t getDigitalInputStepsCount();
size_t totalStepsNumber();
