rusefi/rusefi-hardware/(commit log)

2021-10-26 Freq divider export
    [frequency-divider.csv, frequency-divider.kicad_pcb, frequency-divider.kicad_sch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]
2021-11-07 new home for mini
    [can_brd_1.sch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]
2021-11-08 lib path
    [mini48-stm32.kicad_pcb]
2021-11-17 WBO F103
    [wideband_controller-B_Cu.gbr, wideband_controller-B_Mask.gbr, wideband_controller-B_Paste.gbr, wideband_controller-B_SilkS.gbr, wideband_controller-Edge_Cuts.gbr, wideband_controller-F_Cu.gbr, wideband_controller-F_Mask.gbr, wideband_controller-F_Paste.gbr]
2022-01-04 GDI project
    [GDI-4ch.kicad_pcb, GDI-4ch.kicad_sch]
2022-01-06 Upd SCH
    [GDI-4ch.kicad_sch]
2022-01-11 Addressed issue #19
    Added bottom silk for all connector pins.
    [wideband_controller.kicad_pcb, wideband_controller.sch]
2022-01-12 pin modes progress?
2022-01-13 more GD32 options
    [wideband_controller_JLCBOM - alt GD2.csv, wideband_controller_JLCBOM - alt GD3.csv]
2022-01-14 try2 of uploading PCB with silkscreen
    trying again for silk
    [wideband_controller.kicad_pcb]
2022-01-14 Added even more silkscreen, moved a via or two
    [wideband_controller.kicad_pcb]
2022-01-14 0402 we go!
    Changed as many parts as make sense to 0402. Eliminated several BOM lines. Added two 0402 solder jumpers for config. Need to review when less tired.
    [wideband_controller.kicad_pcb, wideband_controller.sch]
2022-01-28 Add files via upload
    U1A/U1D + and - reversal fixed. Kept same unobtanium precision op-amp for now. Incorporates config jumper additions
    [wideband_controller.kicad_pcb, wideband_controller.sch]
2022-01-28 Switched precision opamp
    Switched to SOT23-5 precision op-amp. Specifying GS8331 chopper (good stock as of commit) but should work with AD8628 as originally specified.
    [wideband_controller.kicad_pcb, wideband_controller.sch]
2022-02-01 ADC first steps
2022-02-19 ADC integrated into console
2022-02-26 We have ADC!
2022-03-07 Upd PCB
    [GDI-4ch.kicad_pcb, GDI-4ch.kicad_sch]
2022-03-18 chibios printf: support float
2022-03-18 adc: designated initializers, channels order according comment
2022-03-18 adc: helper to get voltage
2022-03-18 adc: enable temp sensor and vref (optional)
2022-03-18 main: simplify prints
2022-03-18 TODO: rename project
    [FlashMemory.kicad_sch, FlashMemory.sch, TLE8888-1QK.kicad_sch, TLE8888-1QK.sch, TLE9201SG.kicad_sch, TLE9201SG.sch, adc.kicad_sch, adc.sch]
2022-03-19 PCB preview
    [GDI-4ch.kicad_sch]
2022-03-20 Fab preview
    [GDI-4ch.csv, GDI-4ch.kicad_sch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]
2022-03-21 Fab preview 2
    [GDI-4ch non-JLC.csv, GDI-4ch.csv, GDI-4ch.kicad_sch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]
2022-04-10 reducing rev1 confusion
    [wideband_controller-B_Cu.gbr, wideband_controller-B_Mask.gbr, wideband_controller-B_Paste.gbr, wideband_controller-B_SilkS.gbr, wideband_controller-Edge_Cuts.gbr, wideband_controller-F_Cu.gbr, wideband_controller-F_Mask.gbr, wideband_controller-F_Paste.gbr]
2022-04-10 Wideband Rev 2 (#60)
    * Wideband Rev 2
    * Remove old version (now KiCAD 6 is used)
    Files extension now have kicad_ prefix
    * Adjust RefDefs on schematic
    * Silkscreen instruction about CANID
    * No thermal reliefs under LDO
    * Mooooore vias to God of vias
    * F103: Rev 2: updates
    Added testpoints to unused MCU pins (where possible)
    Added LSU_ADV AC injection R
    Bias current resistor (LSU4.9) is now controlled by gpio
    Added Heater- sense. To check is sensor present/heater problems.
    Minor fixes
    * Final cleanups
    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
    [wideband_controller.kicad_pcb, wideband_controller.kicad_sch, wideband_controller.sch, wideband_controller_JLCBOM.csv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]
2022-04-10 gdi firmware progress (#62)
    * led port
    * mc data
    * debuggable
    * makefile, correct spi device
    [io_pins.h, mcuconf.h]
2022-04-11 Fix LCSC refs for few components (#63)
    * Fix LCSC for few components
    * Update path to 3D models (due to KiCAD6)
    * Exclude debug connectors, testpoints from BOM and position file
    Also do not show them on 3D view
    [wideband_controller.kicad_pcb, wideband_controller.kicad_sch, wideband_controller_JLCBOM.csv]
2022-04-17 wideband-f103: add some comments on schematic (#66)
    [wideband_controller.kicad_sch]
2022-04-24 Lambda x2 (#67)
    * lambda-x2: two channel version of wideband-F103
    * lambda-x2: move analog frontend to separate sheet
    * 33311-24AW-2 connector from alpax-2chan
    * Progress
    * Fix 3D wiev
    * progress
    * Update components
    * lambda-x2: some upadte
    * more progress
    * progress
    * more progress
    * Steal JDY-33 symbol, footprint and model from Alphax-2chan
    * Progress
    * Progress
    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
    [33311-24AW-2.STEP, JDY-33.STEP, egt.kicad_sch, lambda-x2.kicad_pcb, lambda-x2.kicad_sch, lambda-x2_JLCBOM.csv, lsu.kicad_sch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]
2022-06-02 GDI4 rev. b
    [GDI-4ch non-JLC.csv, GDI-4ch-bom.csv, GDI-4ch.kicad_sch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]
2022-06-11 #81, #86, #88, #95
    [GDI-4ch.kicad_sch]
2022-06-11 Init GDI6 project
    [GDI-6ch.kicad_sch]
2022-06-15 Fixed #101
    [GDI-4ch.kicad_sch, GDI-6ch.kicad_sch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]
2022-06-15 Second fix #101
    [GDI-4ch.kicad_sch]
2022-06-17 GDI-6ch upd pcb
    [GDI-6ch.kicad_sch]
2022-06-30 Upd sch & pcb GDI4 -> 6
    [GDI-4ch.kicad_sch, GDI-6ch.kicad_sch]
2022-06-30 Export PDF
    [GDI-4ch.kicad_sch]
2022-06-30 Fab export
    [GDI-4ch non-JLC.csv, GDI-4ch.csv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]
2022-07-06 PCB update 6ch
    [GDI-4ch.kicad_sch]
2022-07-08 Cleanup GDI6
    [GDI-6ch.kicad_pcb]
2022-07-10 CAN bus init
2022-07-13 Added STM32 8MHz crystal
    [GDI-4ch.csv, GDI-4ch.kicad_sch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]
2022-07-18 BOOT and RST buttons
    [GDI-4ch.csv, GDI-4ch.kicad_sch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]
2022-07-22 #125 part 2
    [GDI-4ch.csv, GDI-4ch.kicad_sch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]
2022-07-27 progress by Denis
    [wideband_controller.kicad_pcb, wideband_controller.kicad_sch]
2022-07-31 Support GM_ETB throttle position sensor added
2022-07-31 Support GM_ETB throttle position sensor added (PAL HAL)
2022-08-01 now I am really confused if that's the proper version?
    [wideband_controller.kicad_pcb, wideband_controller.kicad_sch, wideband_controller_bom.xlsx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]
2022-08-05 upd wideband-F103
    [wideband_controller.kicad_pcb, wideband_controller_bom.csv, wideband_controller_bom.xlsx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]
2022-08-06 uart to header
2022-08-06 error rate into console
    [sent.cpp, sent.h, uart.cpp]
2022-08-07 print raw Nibbl
2022-08-07 add silkscreen
    [wideband_controller.kicad_pcb]
2022-08-07 F103 WBO BOM #133
    [wideband_controller_bom.csv]
2022-08-08 upd BOM
    [wideband_controller.kicad_pcb, wideband_controller.kicad_sch, wideband_controller_bom.csv]
2022-08-08 corrected the gerbers
2022-08-11 pt2001 uses module (#139)
    * pt2001 uses module
    * correct pin for flag0
    * gdi4 ci build name
    * tweaks
    * pb4 magic
    * flag0 pin mode
    * lib
    [main.cpp]
2022-08-11 Switch uart to 115200
2022-08-13 logic data
    [SENT-ETB.csv, SENT-fuel-pressure.csv]
2022-08-15 Dron sent (#145)
    * Update PAL SENT so it works with Si7215
    * I have external pull-ups on my board
    * PAL: cleanup
    * PAL: cleanup WTF?
    * SENT: cleanup
    * SENT: cleanup
    * Revert "I have external pull-ups on my board"
    This reverts commit 84baa5a2bb0a37e54fbd17906221047a58fa536d.
    * SENT: calculate tick on sync pulse
    * CRC4: another way to calc CRC4 (compatible with GM)
    * SENT: count received messages
    * GS pressure sensor support
    * SENT: switch to ICU
    * UART: show decoded data for GM pressue sensor
    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
    [sent.cpp, sent.h, uart.cpp]
2022-08-15 GM pressure decode (#148)
2022-08-30 wideband-f103: HW support for SENT on IN1..IN4 (#153)
    -add C for input RC filter
    -add 2.7 pull-up to 5V on IN1, IN2 (optional for SENT)
    -move Input_1..Input_4 to PC6..PC9 that are capable for input
    capture with TIM3/TIM8
    -LED_GREEN moved from PC9 to PC10
    !!!!!PCB and Gerber was not updated!!!!!
    [wideband_controller.kicad_sch]
2022-08-31 add outputs
    [wideband_controller-B_Cu.gbl, wideband_controller-B_Mask.gbs, wideband_controller-B_Silkscreen.gbo, wideband_controller-Edge_Cuts.gm1, wideband_controller-F_Cu.gtl, wideband_controller-F_Mask.gts, wideband_controller-F_Silkscreen.gto, wideband_controller-all-pos.csv]
2022-08-31 add gerber.zip
    [wideband_controller-B_Cu.gbl, wideband_controller-B_Mask.gbs, wideband_controller-B_Silkscreen.gbo, wideband_controller-Edge_Cuts.gm1, wideband_controller-F_Cu.gtl, wideband_controller-F_Mask.gts, wideband_controller-F_Silkscreen.gto, wideband_controller-all-pos.csv]
2022-09-01 add drill
2022-09-26 Export USART3, UART5(TX only) and USB to connector (#155)
    CAN moved from PA11, PA12 to PB8, PB9
    PA11, PA12 used as USB
    DISP4,5,6 moved to PB13,14,15
    LED_GREEN is moved to PB7
    5V and GND signals are added to connector (around UART and USB)
    can be used in both directions:
    - power device on table
    - power some ext devices
    !!!!!PCB and Gerber were not updated!!!!!
    [wideband_controller.kicad_sch]
2022-10-05 add rev5 #156
    [wideband_controller.csv, wideband_controller.kicad_pcb, wideband_controller.kicad_sch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]
2022-12-02 new board quad IGBT v0.1
    [quad-igbt.kicad_pcb, quad-igbt.kicad_sch]
2022-12-04 move from https://github.com/rusefi/rusefi/tree/master/hardware/Breakout_154pin_284617-1-Connector
    [284617-1.kicad_pcb, 284617-1.sch]
2022-12-08 added Breakout_154pin_284617-1 v0.4 #160
    [284617-1.kicad_pcb]
2023-01-28 breakout 24
    [24pins_In_3conn.csv, 24pins_In_3conn.kicad_pcb, 24pins_In_3conn.kicad_sch]
2023-02-10 wbo dual: C10 & C35 #172
    progress not full fix
    [lambda-x2_JLCBOM.csv]
2023-02-25 Lambda x2 rev1 (#180)
    * lambda-x2: revork aux outputs, remove useless protection in LSU
    * lambda-x2: switch to 64-pin MCU
    * lambda-x2: add HSE, move pump to DAC outputs
    * lambda-x2: move BT to UART4/USART3
    * lambda-x2: ocsillator fix
    * lambda-x2: fix RC filter values on heater voltage ADC inputs
    * lambda-x2: fuse, Vbat sense, resistor in sense
    * lambda-x2: diagnostic for AUX out, PWM noise cancelation, etc
    * lambda-x2: jtag, adc channels, one more led, BT en, etc
    * lambda-x2: update PCB dimentions, connector footprint, etx
    * lambda-x2: update
    * lambda-x2: final update, rev1
    * lambda-x2: rev1: fabrication files
    [egt.kicad_sch, lambda-x2.kicad_pcb, lambda-x2.kicad_sch, lambda-x2_JLCBOM.csv, lsu.kicad_sch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]
2023-02-25 lambda-x2: rev1: fix component position file header (#181)
    [lambda-x2-top-pos.csv]
2023-02-25 Lambda x2 rev1 (#182)
    * lambda-x2: changelog
    * lambda-x2: update BOM per JLC availability
    [egt.kicad_sch, lambda-x2.kicad_pcb, lambda-x2.kicad_sch, lambda-x2_JLCBOM.csv, lsu.kicad_sch]
2023-02-26 lambda-x2: rev1: update silkscreen (#183)
    * lambda-x2: rev1: update silkscreen
    * lambda-x2: rev1: changelog
    * lambda-x2: typo fix
    [lambda-x2.kicad_pcb, lsu.kicad_sch]
2023-02-28 revive or recreate LM1949 driver #173
    [BOM.xlsx, LM1949_Driver.kicad_pcb, LM1949_Driver.kicad_sch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]
2023-03-26 Revive A4988 #187
    [stepper_motor_driver.kicad_pcb, stepper_motor_driver.sch]
2023-03-26 TLE9104SH breakout board fix #186
2023-04-19 just a copy
    [lambda-x2_JLCBOM-cheaper.csv]
2023-04-19 no aux, more available part, no EGT
    [lambda-x2_JLCBOM-cheaper.csv]
2023-05-09 do not fab 4.2
    [lambda-x2_JLCBOM-cheaper.csv]
2023-05-14 Upd SCH, PCB
    [GDI-4ch.kicad_sch]
2023-05-14 GDI-4ch-d export
    [GDI-4ch.kicad_sch, bom.csv, positions.csv]
2023-05-14 #200 note
    [GDI-4ch.kicad_sch]
2023-05-15 uart debug and compile time via CAN
2023-05-15 #201, #202
    [GDI-4ch.kicad_sch, bom.csv]
2023-05-15 6-pin power connector
    [GDI-4ch.kicad_sch, bom.csv, positions.csv]
2023-05-15 fresh to raise voltage limit
2023-05-15 let's have voltage as int
2023-05-16 GDI4: master does not click 4 injectors #203
    here I revert to microcode version prior to https://github.com/rusefi/rusefi-hardware/pull/139 change
    manual testing results: HV changes according to CAN calibration change settings and four injectors click
2023-05-16 https://github.com/rusefi/rusefi-hardware/issues/203
    getting much closer to https://github.com/rusefi/rusefi/pull/4340 version
    [PT2001_LoadData.c]
2023-05-16 GDI4: battery voltage #204
2023-05-16 GDI4 BOM improvements #205
    [bom.csv]
2023-05-17 Revert "https://github.com/rusefi/rusefi-hardware/issues/203"
    This reverts commit 7d05b907e6d2b68ddcf33ff619f0346d32e8f776.
    [PT2001_LoadData.c]
2023-06-02 Update kicad6-libraries
2023-06-02 Upd VR-Hall
    Updated not saved in previous commit files
    [VR-Hall.kicad_pcb]
2023-06-12 sending out pump currents
2023-06-12 consuming pump currents
2023-06-27 UART fix
2023-06-29 GDI4: configuration persistence is flaky fix #212
    [persistence.cpp, persistence.h]
2023-07-09 Missed call to eflStart (#217)
    [persistence.cpp]
2023-07-13 135 single
    [rusefi_1-1376430-0_135pin.step]
2023-07-14 no need to keep old gerbers, better name for current gerbers
2023-07-15 gerber export without board generation
2023-07-15 [skip actions] Auto-generated board
2023-07-15 failing to export gerbers, failing to fail after failing to export gerbers #219
    [284617-1.kicad_sch, 284617-1.sch]
2023-07-17 Add gerbers #218
    [284617-1-B_Cu.gbl, 284617-1-B_Mask.gbs, 284617-1-B_Silkscreen.gbo, 284617-1-Edge_Cuts.gm1, 284617-1-F_Cu.gtl, 284617-1-F_Mask.gts, 284617-1-F_Silkscreen.gto, 284617-1.drl]
2023-07-24 gerbers for the order rev0..5
2023-07-28 GDI4 to use stm32F103CBT6 #224
    [bom.csv]
2023-07-28 https://github.com/rusefi/rusefi-hardware/issues/225 reducing confusion
    [bom.csv]
2023-07-28 #224, #225 re-fab
    [GDI-4ch.kicad_sch, bom.csv]
2023-08-06 ignoting KiCAD cache files
2023-08-06 A4988 Stepper Motor Driver Carrier #187 removing old
    [stepper_motor_driver.kicad_pcb, stepper_motor_driver.sch]
2023-08-06 A4988 Stepper Motor Driver Carrier #187 adding new
    [Motor_driver_A4988.kicad_pcb, Motor_driver_A4988.kicad_sch, Motor_driver_A4988_BOM.xlsx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]
2023-08-06 A4988 Stepper Motor Driver Carrier #187 fresh kicad6 lib
2023-08-06 upd driver
    [Motor_driver_A4988.kicad_sch]
2023-08-15 лишнее
2023-08-15 removing old manual files
    [284617-1-B_Cu.gbl, 284617-1-B_Mask.gbs, 284617-1-B_Silkscreen.gbo, 284617-1-Edge_Cuts.gm1, 284617-1-F_Cu.gtl, 284617-1-F_Mask.gts, 284617-1-F_Silkscreen.gto, 284617-1.drl]
2023-08-15 добавила архив для заказа
2023-08-15 папка в нужное место
2023-08-21 stim: CAN affects USB fix #229
    [io_pins.h]
2023-08-21 digital-inputs: board configs
2023-08-21 reusing boards_id.h
2023-08-22 extracting THREAD_STACK also increasing it just in case
2023-08-22 THREAD_STACK and print incoming packets
2023-08-22 board profile to support multiple revisions #233
2023-08-22 proteus f7 stim profile https://github.com/rusefi/rusefi-hardware/issues/234
    [test_logic.cpp, test_logic.h]
2023-08-29 specify Proteus IAT/CLT pullups https://github.com/rusefi/rusefi-hardware/issues/234
    [test_logic.cpp]
2023-08-30 fix 2chan IAT/CLT test fails #240
    [test_logic.cpp]
2023-08-30 2chan default MAP setting is internal MAP i.e. baro pressure #239
2023-09-01 problem: current code expects all 9 counters to increase
    that should be configurable since for instance Proteus only has 6 digital inputs not 9
    [test_logic.cpp, test_logic.h]
2023-09-01 use eventExpected/buttonExpected for CounterStatus check https://github.com/rusefi/rusefi-hardware/issues/222
    [can.cpp, test_logic.cpp, test_logic.h]
2023-09-01 proteus fails MAP test just a bit fix #244
    [test_logic.cpp]
2023-09-02 bugfix: finishing move to 'setRedText'
    [test_digital_outputs.cpp]
2023-09-02 validate ECU uptime (numSecondsSinceReset) fix #236
    [can.cpp, main.cpp]
2023-09-27 bugfix: we need latest uptime not first one guarded by 'hasReceivedBoardId'
    [can.cpp]
2023-09-27 digital inputs: explicit error message for lack of boardID, better method names and API
    [can.cpp, can.h, main.cpp, test_digital_inputs.cpp]
2023-09-27 bugfix: each test run should be fully isolated
    without 'currentBoard' reset we were not sending out engineType to second board under test thus digital inputs were not configured properly?
    [can.cpp]
2023-09-27 faster RED led response
2023-10-01 Analog voltage calculation example
2023-10-01 progress/bugfix: waiting for board ID
    [can.cpp, test_digital_outputs.cpp]
2023-10-23 re-order GDI4 rev D fix #250
    [bom.csv]
2023-10-23 my parts
    [bom.csv]
2023-10-29 testEcuDigitalOutput seems broken around high, low and banks fix #251
    [test_logic.cpp]
2023-10-29 VR input soldering test #254
2023-10-30 ETB HW QC fix #253
    [main.cpp, test_digital_outputs.cpp]
2023-11-16 mcz33810 test board #255
2023-11-17 Fix LDO
    [MC33810-breakout.kicad_pcb, MC33810-breakout.kicad_sch, bom.csv, positions.csv]
2023-11-30 steps towards timer
2023-12-21 154HYUNDAI: pps1 tolerance just a bit weird?
    [test_logic.cpp]
2023-12-25 WBO CAN explicit error message
    [can.cpp]
2023-12-30 blue & p1
    [lambda-x2_JLCBOM-cheaper.csv, lambda-x2_JLCBOM.csv]
2024-02-08 test apparatus: toggle all ports in parallel fix #258
    [test_digital_inputs.cpp]
2024-02-26 pin coordinates
2024-02-28 #260
    v 0.2
    [24pins_In_3conn.kicad_pcb]
2024-03-05 VR not crank
    [ncv1124-all-pos_JLCPCB.csv, ncv1124.kicad_pcb, ncv1124.sch, ncv1124_JLCPCB.csv]
2024-03-05 revive tle9104 #261
    [tle9104-breakout.kicad_pcb, tle9104-breakout.sch]
2024-03-05 #260
    v0.2 gerber
    [24pins_In_3conn.kicad_pcb, 24pins_In_3conn.kicad_sch]
2024-03-05 add pin
2024-03-11 #261
    kicad7
    [tle9104-breakout.kicad_pcb, tle9104-breakout.kicad_sch, tle9104-breakout.sch]
2024-03-14 Попробовала подписать
2024-03-29 edit for JLS
    [tle9104-breakout-bom.csv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]
2024-06-02 we need to wake some boards up!
2024-06-25 SILVER & BOARD_ID_154HYUNDAI_E
2024-08-27 https://github.com/rusefi/rusefi/issues/6781 revive MC33816 driver, also support bus sharing #6781
    [pt2001impl.h]
2024-08-28 BOARD_ID_UAEFI_B weird
2024-08-29 Upd GDI6
    [GDI-6ch.kicad_pcb, GDI-6ch.kicad_sch]
2024-09-08 GDI6 export
    [GDI-6ch.kicad_sch, bom.csv, positions.csv]
2024-09-28 CDI test
    [CDI-test.kicad_pcb, CDI-test.kicad_sch, bom.csv, positions.csv]
2024-09-30 #273 X2 and #272 kiCad 7.0
    [can_brd_1.kicad_sch, can_brd_1.sch, mini48-stm32.kicad_sch, mini48-stm32.sch]
2024-10-09 GDI 6 rev b
    [GDI-6ch.kicad_sch, bom.csv, positions.csv]
2024-10-19 switching to rev C
2024-10-23 https://github.com/rusefi/rusefi/issues/6997
    array of classes not array inside class
    [sent.cpp, uart.cpp]
2024-10-23 https://github.com/rusefi/rusefi/issues/6997
    extracting read method
    [sent.cpp, sent.h]
2024-12-14 Serial is simplier that UART
2024-12-14 removing SENT
    [SENT-ETB.csv, SENT-fuel-pressure.csv, ford-sent-closed.csv, ford-sent-idle.csv]
2024-12-14 SENT: decoder for GM pressure sensor
    Still TBD temperature encoding
2024-12-14 GDI4: transmit GM fuel pressure sensor data over can
2024-12-17 GDI4: use different CAN IDs depending on ID pin
2024-12-17 GDI4: SENT to CAN: correct comment
    [can.cpp]
2025-01-27 добавила недостающие пины в supra yaml #157
2025-01-29 GDI4: support multiple PT2001 chips
    PB3 is used as CS for second chip.
    BP4, PB5 control DRVEN and RESETB of both chips.
    [can.cpp, can.h, efifeatures.h, main.cpp, pt2001impl.h, sent.cpp, uart.cpp]
2025-01-29 GDI4: release RESETB signal and activate DRVEN in common code
    If more than one PT2001 is used
    [main.cpp, pt2001impl.h]
2025-02-04 lambda-x2: update BOM
    [lambda-x2_JLCBOM-cheaper.csv, lambda-x2_JLCBOM.csv]
2025-02-06 lambda-x2: default BOM is for LSU4.9
    [lambda-x2_JLCBOM-cheaper.csv, lambda-x2_JLCBOM.csv]
2025-02-12 so many new boards
2025-03-04 E92: happy led
2025-04-09 Add initial ZF 8HP installation board design files (schematic, PCB, and Gerbers)
    - KiCad project for a drop-in replacement TCU board
    - Supports ZF 8HP variants: 8HP45/50/51/70/75/90/95
    - Includes schematic, layout, and production-ready Gerber files
    - Designed for solder-in installation inside the transmission case
    [8HPTCUAdapter.kicad_pcb, 8HPTCUAdapter.kicad_sch, BOM-8HPTCUAdapter.csv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]
2025-05-03 GDI-4ch: blink error code, try to reinit chip on failure
    [main.cpp]
2025-07-17 Init GDI-STM
    [GDI-STM.kicad_sch, bank.kicad_sch]
2025-07-22 superseal igbt #206
    [superseal-igbt-BOM.csv, superseal-igbt.kicad_pcb, superseal-igbt.kicad_sch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]
2025-08-12 Upd GDI-STM
    [GDI-STM.kicad_sch, bank.kicad_sch, boost.kicad_sch]
2025-08-30 Breakout-24pin to superseal #313
    [Breakout-24pin-superseal.kicad_pcb, Breakout-24pin-superseal.kicad_sch]
2026-01-28 BMW 146 в superseal #251
    заготовка
    [BMW-146-superseal.kicad_pcb, BMW-146-superseal.kicad_sch]
2026-01-29 BMW 146 в superseal отмена
    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
    [BMW-146-superseal.kicad_pcb, BMW-146-superseal.kicad_sch]
2026-01-30 добавила координаты
2026-01-30 добавила выводы на картинку
2026-01-30 исправила
2026-02-09 Update firmware release link in readme
    Updated the current stable firmware release information.
2026-03-18 Update right.yaml
    correct comments
    [right.yaml]
2026-04-21 Update readme with stm32flash installation instructions
    Added instructions for using stm32flash utility on Linux and Windows.
2026-04-21 Update instructions for flashing STM32 board
    Added step to apply power while holding BOOT0 button.
2026-08-25 stim board: USB problem #241
    [main.cpp, usbconsole.cpp, usbconsole.h]
2026-08-30 Add warning about untested firmware for GDI6 board
    Added a warning about the untested firmware folder for the GDI6 board.
2026-09-05 GHA says update ext/kicad6-libraries submodule
2026-10-09 uaBrain-e38 rev a
    [BOM.csv, HS5.kicad_sch, i2c-adc.kicad_sch, ls6.kicad_sch, positions.csv, uaBrain-gm-e38.kicad_pcb, uaBrain-gm-e38.kicad_sch]
